vvip-68/LedPanelWiFi/wiki/schemes.md

## Схемы устройств для Wemos d1 mini и NodeMCU

### С сенсорной кнопкой
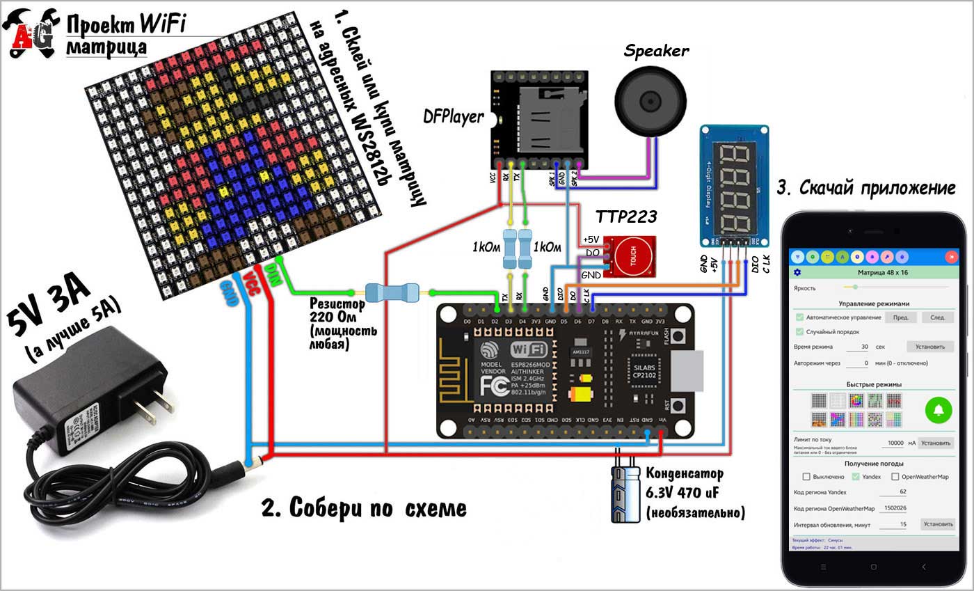
[picture p7: schemes/scheme.jpg]
SCHEME


### С обычной кнопкой
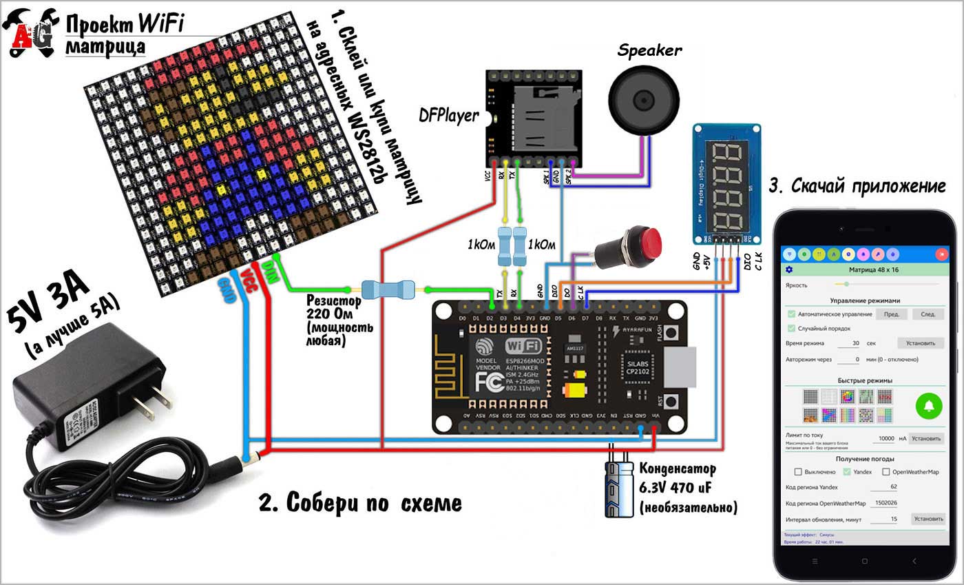
[picture p8: schemes/scheme_b.jpg]
SCHEME


### С SD картой
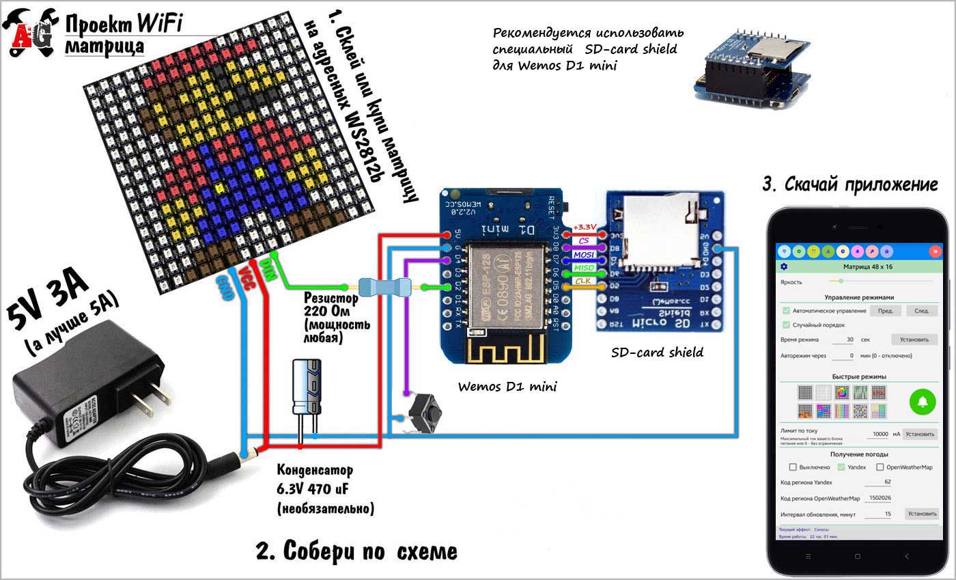
[picture p9: schemes/scheme_c.jpg]
SCHEME


### С корректировкой питания и отключением матрицы
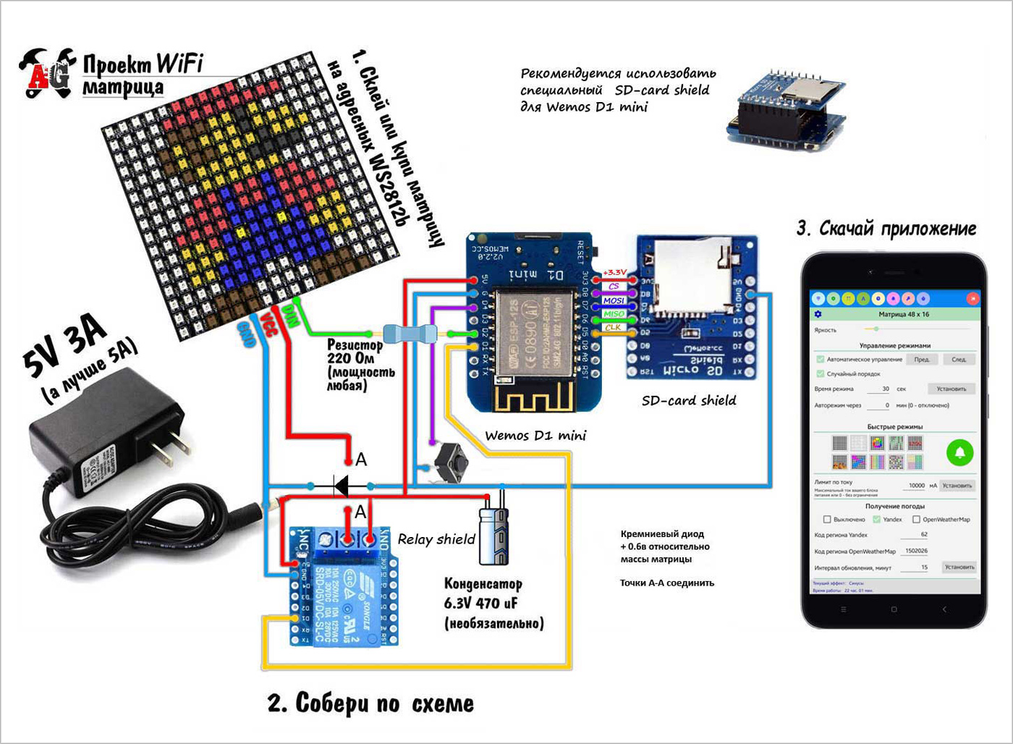
[picture p10: schemes/scheme_e.jpg]
SCHEME


### С корректировкой питания
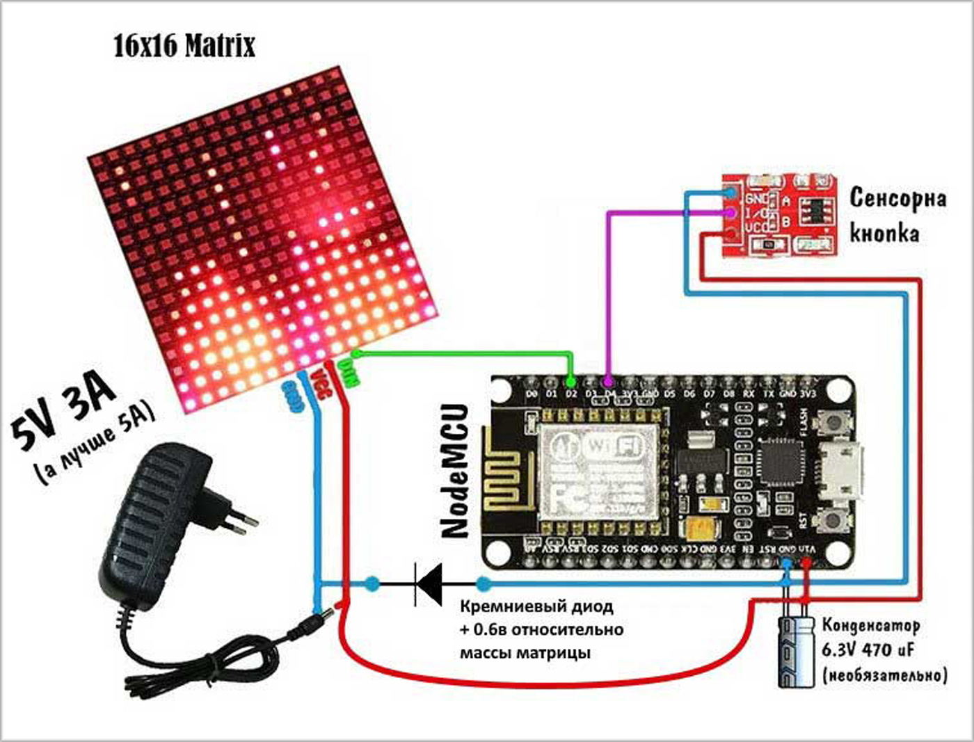
[picture p11: schemes/scheme_d.jpg]
SCHEME


### С полным набором компонент (отключение матрицы - MOSFET)
SCHEME

Для данного варианта схемы ползователь ***RailWar*** (Evgeny) разработал печатную плату.  
PCB Layout смотри в папке **"pcb"** проекта - архив **"lamp8266.zip"**.

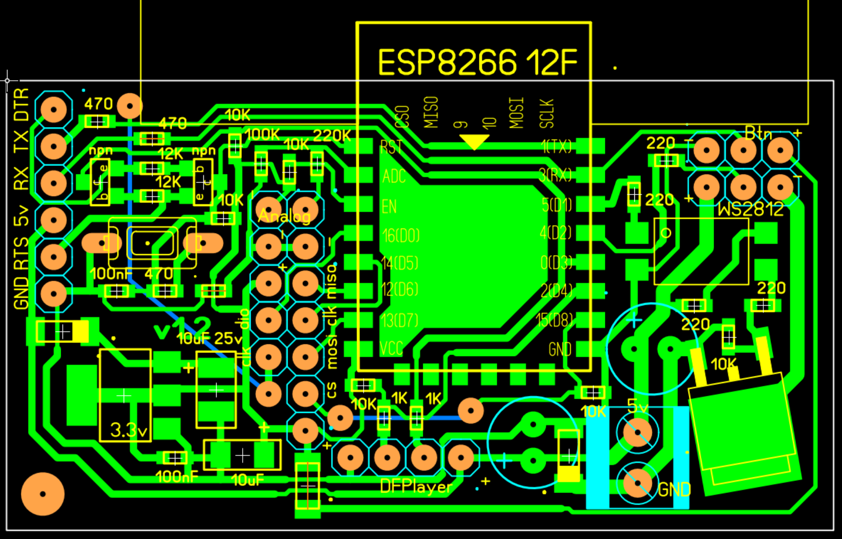
[picture p12: pcb/lamp8266.png]
PCB


### С полным набором компонент (отключение матрицы - реле)
SCHEME

<br><br>

## Схемы устройств для ESP32

### С полным набором компонент
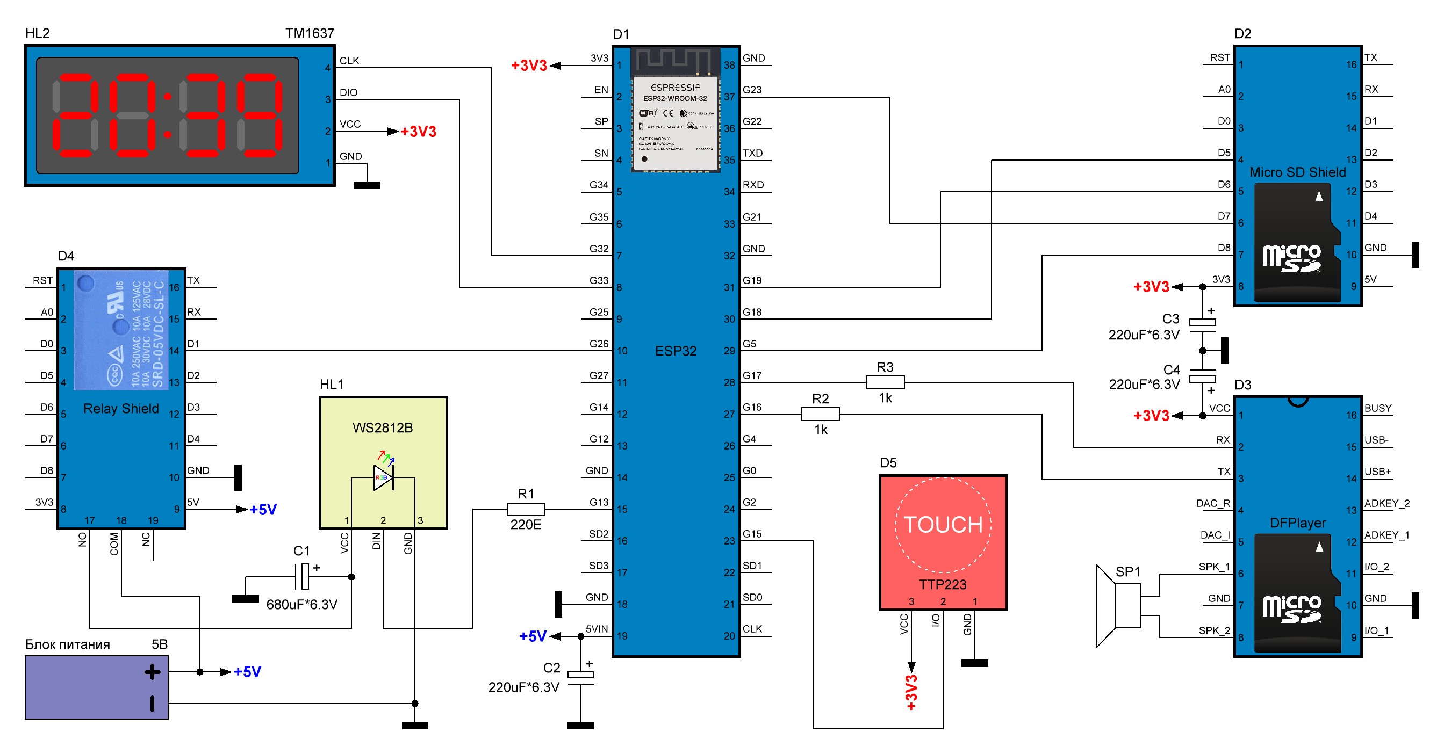
[picture p13: schemes/ESP32_ALL.JPG]
SCHEME


### С сенсорной кнопкой и отключением матрицы
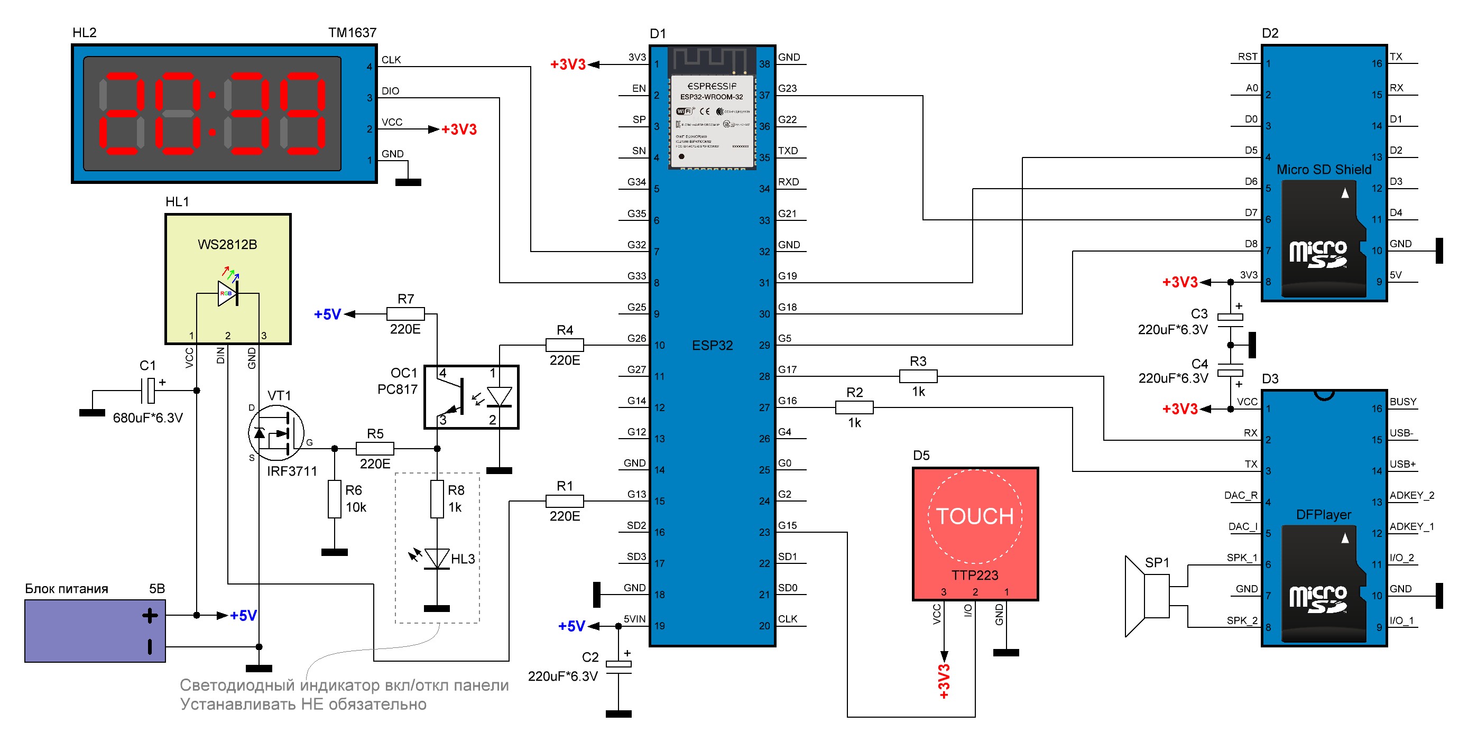
[picture p14: schemes/ESP32_MOSFET.JPG]
SCHEME


### С обычной кнопкой
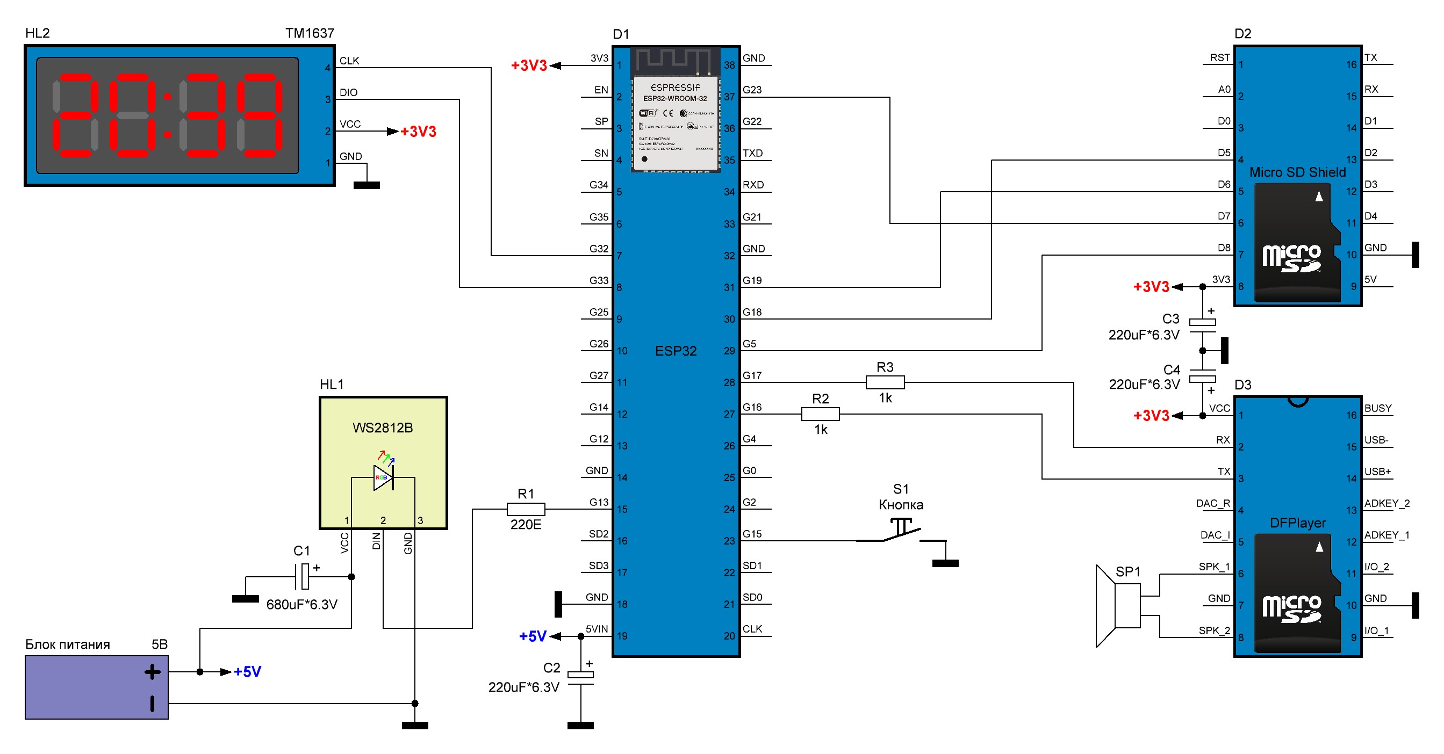
[picture p15: schemes/ESP32_button_noRELAY.jpg]
SCHEME


<br><br>

При повторении устройств следует учитывать особенности подачи питающего напряжения на собранную схему.
От соблюдения правильных параметров питания элементов зависит насколько надежно и бесперебойно будет работать собранное вами устройство.  

```
# Рекомендация по питанию

Наиболее стабильная работа устройства обеспечивается при питании схемы напряжением 4.6-4.9 вольт (не выше!).
При этом корректирующий диод в зазрыв GND питания микроконтроллера ставить не нужно.
Для схем, использующих DFPlayer, питание на него (VCC) в этом случае подавать с общего плюса питания, 
а не с пина 3.3 вольта микроконтроллера, поскольку пин 3.3 вольта не обеспечивает достаточного 
для потребления DFPlayer'ом тока, что приведет к недостаточной громкости воспроизведения, а в худшем 
случае - выходу из строя микросхемы стабилизатора напряжения 3.3 вольта микроконтроллера.

```
Заметки о том, как обеспечивается правильное питание устройства - в [этой](https://github.com/vvip-68/LedPanelWiFi/wiki/Заметки-о-питании) статье.

<br><br>

Благодарность [Дмитрию (7918514)](https://github.com/7918514) за предоставленные варианты схем и проверку их работоспособности.
Его вариант реализации (схемы, фотографии сборки и готового изделия, печатные платы) - все материалы доступны по [ссылке](https://disk.yandex.ru/d/fIo2UEuKpR54hg) в папке "Монстр".
