vvip-68/LedPanelWiFi/wiki/Arduino/wiki.md

# Пошаговая инструкция подготовки среды и сборка проекта

## Шаг 1

Перейдите на сайт разработчиков [Arduino](https://www.arduino.cc/en/Main/Software) и скачайте среду разработки.

Текущая версия среды разработки - Arduino IDE 2.3.3, может содержать некоторые ошибки, поскольку новая и развивается. Допустима к использованию.  
  
Но для Old-school пользователей все же рекомендуется старая проверенная IDE версии 1.8.19.  
Ниже описан как раз процесс установки и настройки для версии Arduino IDE 1.8.19.  

Установка и настройка Arduino IDE 2.3.3 имеет схожие шаги, так что инструкция с некоторыми нюансами сгодится и для нее.  
Для скачивания установщика Arduino IDE 2.3.3 для Windows - выберите **WINDOWS** Win 10 and newer, 64 bit.  
Если у вас другая ОС - выберите установщик для нее.

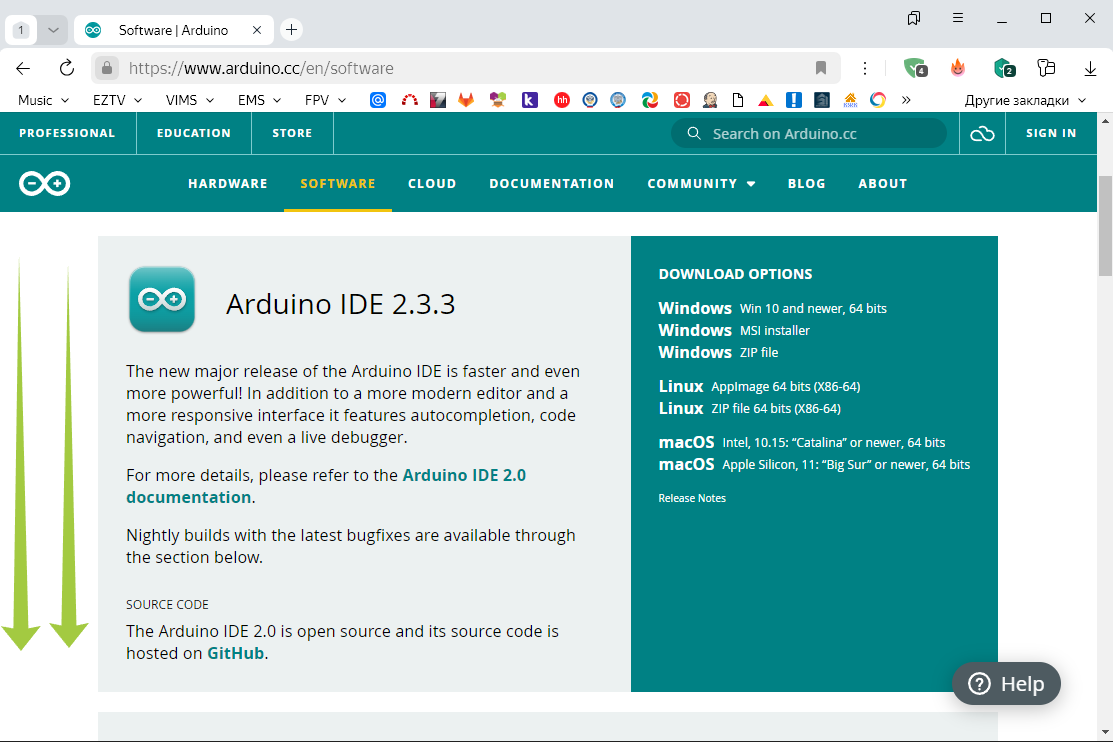
[picture p16: wiki/Arduino/Step_01.png]
Среда разработки Arduino IDE


Прокрутите страницу вниз, до появления плашки Legacy IDE (1.8.X) и выберите для загрузки версию **1.8.19**  
Нажмите на ссылку **Windows Win 7 and newer**. Вы же работаете под Windows?  
Если нет - загружайте версию IDE для вашей ОС.

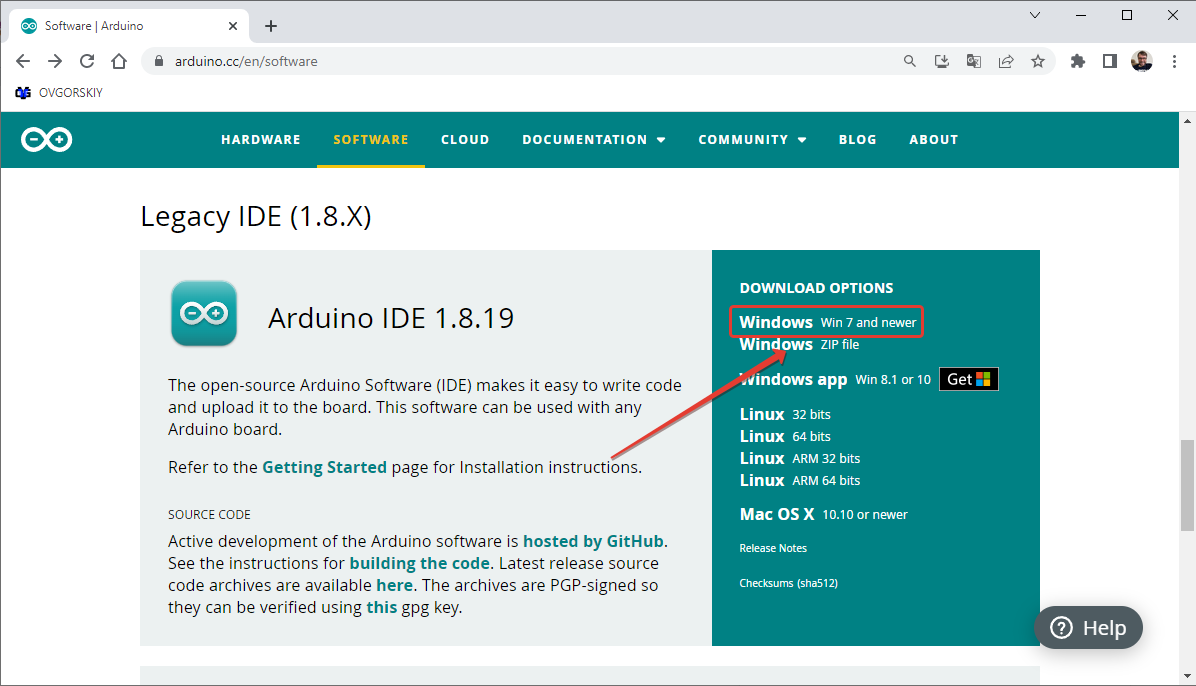
[picture p17: wiki/Arduino/Step_01_0.png]
Среда разработки Arduino IDE


Можете заплатить донат разработчикам Arduino IDE. Но если не хотите - просто нажмите кнопку **JUST DOWNLOAD**
для загрузки установочного файла. После завершения скачивания запустите его.

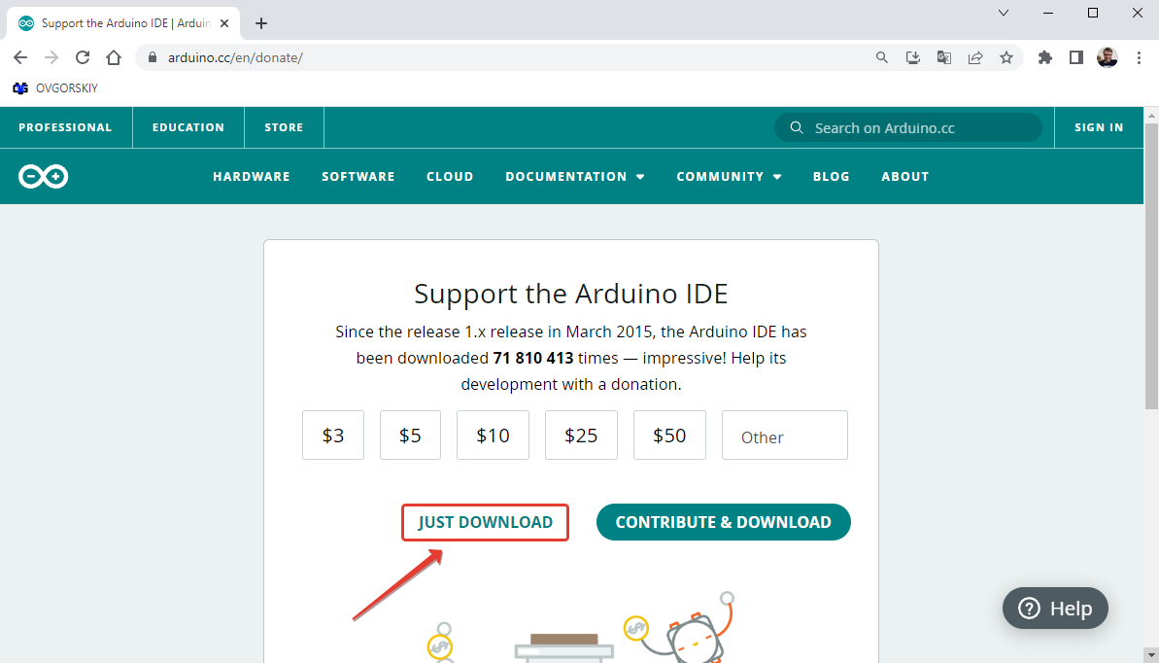
[picture p18: wiki/Arduino/Step_01_1.png]
Среда разработки Arduino IDE


Установите среду разработки на ваш компьютер. После завершения установки, запустите Arduino IDE.

## Шаг 2

В Arduino IDE в меню "Файл" выберите пункт "Настройки".

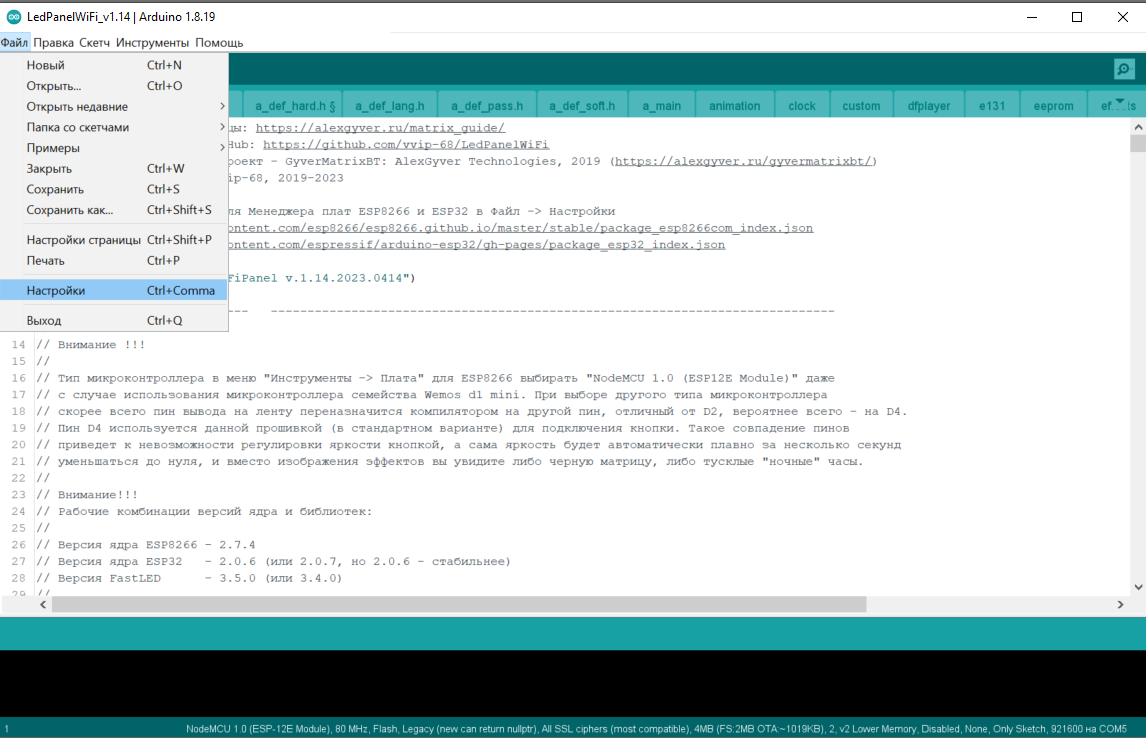
[picture p19: wiki/Arduino/Step_02_1.png]
Настройки среды разработки ArduinoIDE


В открывшемся окне нажмите на кнопку справа от поля "Дополнительные ссылки для менеджера плат"

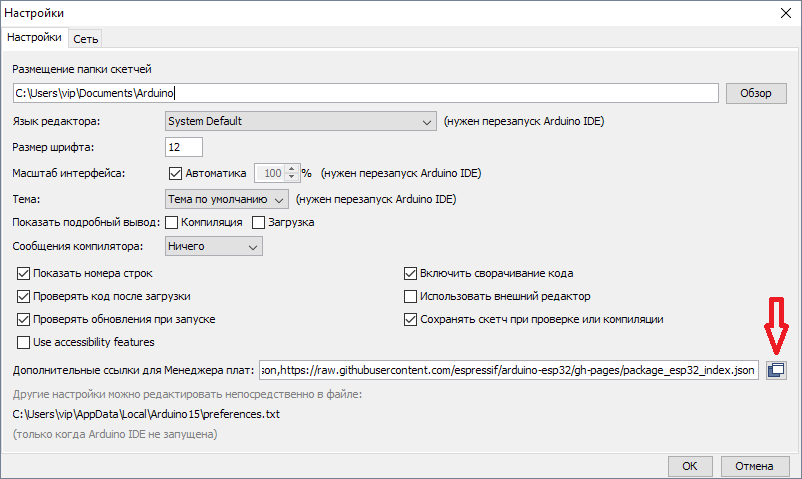
[picture p20: wiki/Arduino/Step_02_2.png]
Дополнительные ссылки для менеджера плат


В открывшемся окне добавьте в поле ввода следующие строки:
`https://raw.githubusercontent.com/esp8266/esp8266.github.io/master/stable/package_esp8266com_index.json` - для поддержки микроконтроллеров ESP8266 (NodeMCU, Wemos d1 mini)
`https://raw.githubusercontent.com/espressif/arduino-esp32/gh-pages/package_esp32_index.json` - для поддержки микроконтроллера ESP32.

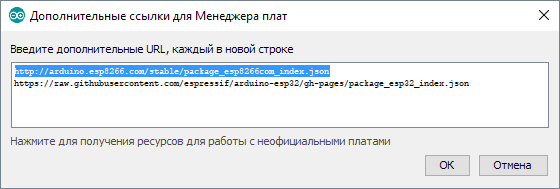
[picture p21: wiki/Arduino/Step_02_3.png]
Ссылка на плату ESP8266


Примените изменения

## Шаг 3

В Arduino IDE в меню "Инструменты" выберите пункт "Менеджер плат".

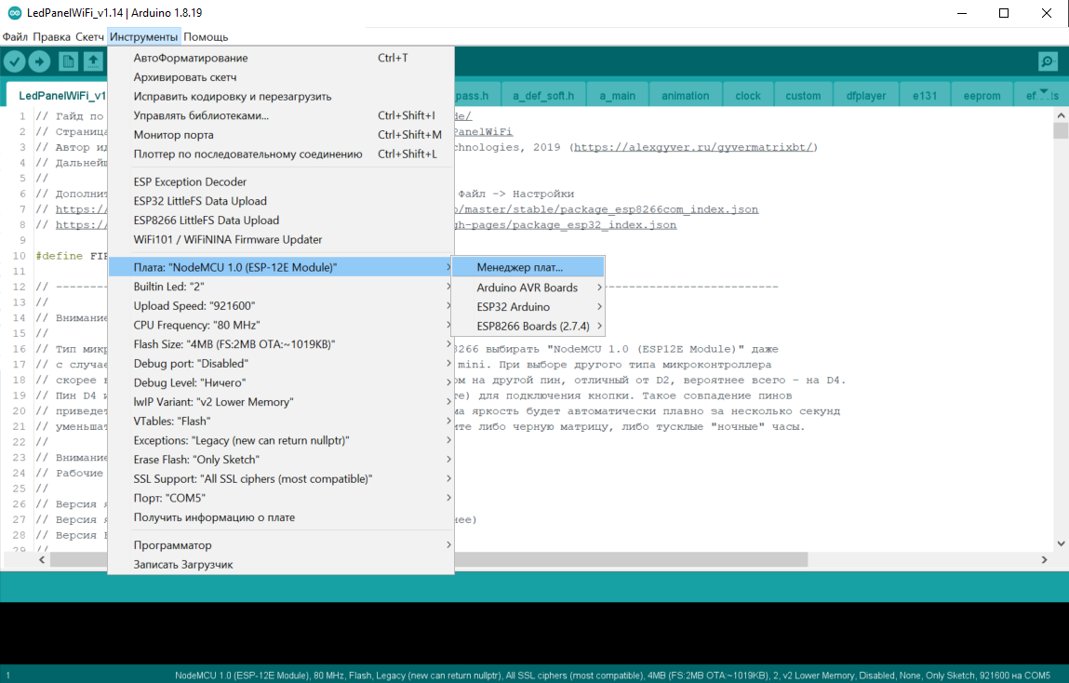
[picture p22: wiki/Arduino/Step_03_1.png]
Менеджер плат


В строке фильтра введите "ESP8266", найдите блок esp8266 by ESP8266 Commumity  
1. Выберите версию ядра **3.1.2** - ***это важно!!!***
2. Нажмите кнопку "Установка", дождитесь завершения установки.
3. Должна появиться надпись, подтверждающая что вы установили правильную версию ядра системы

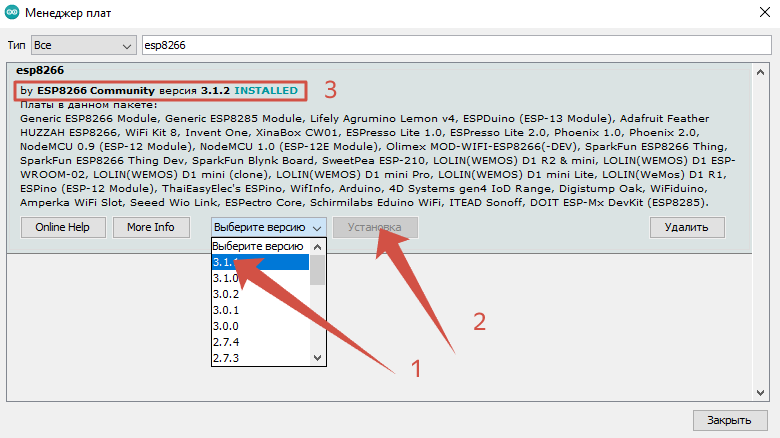
[picture p23: wiki/Arduino/Step_03_2.png]


В строке фильтра введите "ESP32", найдите блок ESP32 by Espressif System
1. Выберите версию ядра **2.0.14** - ***это важно!!!***
2. Нажмите кнопку "Установка", дождитесь завершения установки.
3. Должна появиться надпись, подтверждающая что вы установили правильную версию ядра системы

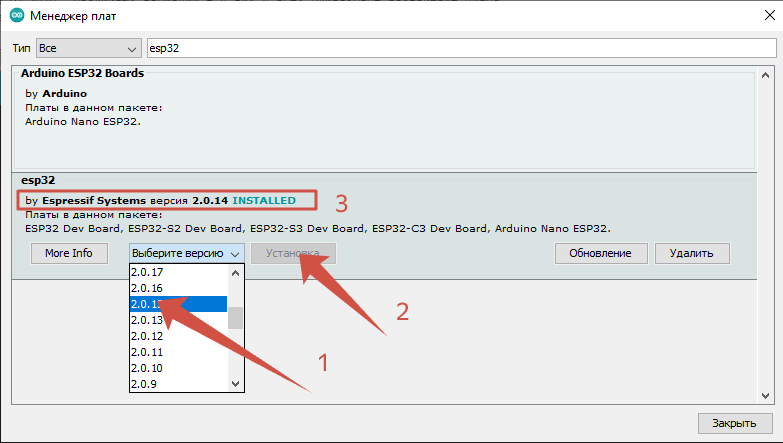
[picture p24: wiki/Arduino/Step_03_3.png]


Закройте Arduino IDE

## Шаг 4

Перейдите в [репозиторий](https://github.com/vvip-68/LedPanelWiFi) проекта
Нажмите зеленую кнопку "Code" выберите "Download ZIP"

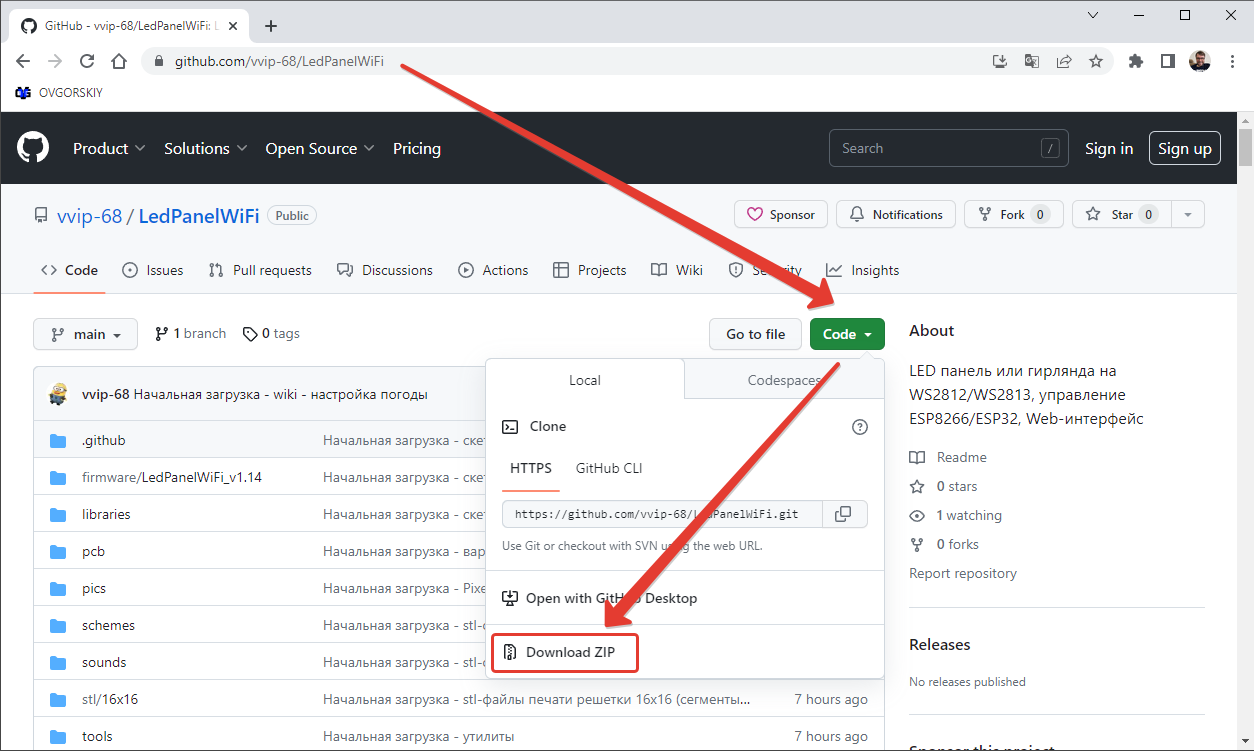
[picture p25: wiki/Arduino/Step_04_1.png]
Загрузка проекта из репозитория


Сохраните архив на диск, распакуйте его в отдельную папку.

Для тех, кто пользуется утилитами работы с хранилищем GitHub (например, [SmartGit](https://www.syntevo.com/smartgit/download/)) - зарегистрируйте в нем ссылку на репозиторий
https://github.com/vvip-68/LedPanelWiFi

## Шаг 5
Скопируйте содержимое папки "libraries" из папки проекта, в папку "libraries" установленной среды разработки Arduino
C:\Program Files (x86)\Arduino\libraries

Также допускается установка библиотек в папку "Мои документы"\Arduino\libraries.  
Обычно физический путь к этой папке - C:\\Users\<user>\Documents\Arduino\libraries

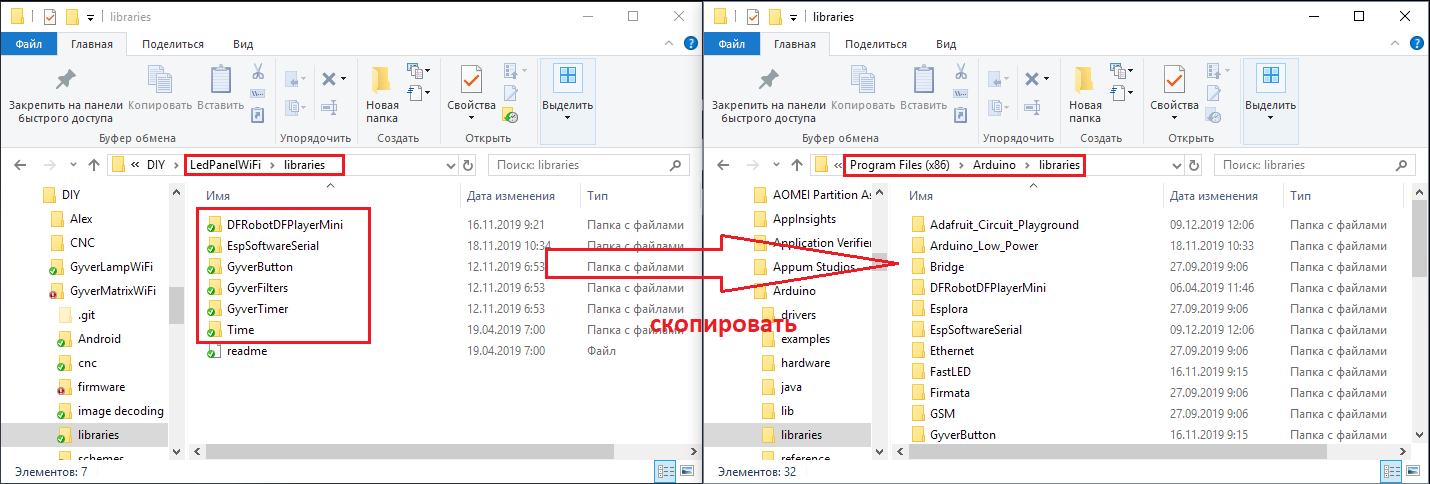
[picture p26: wiki/Arduino/Step_05_1.png]
Копирование библиотек


**Внимание!!!**  
Выполнение этого шага **ОЧЕНЬ** важно, поскольку часть библиотек исправлена и дополнена для соответствия требованиям проекта.
Библиотеки установленные из менеджера библиотек не будут иметь этих изменений или просто будут несовместимой версии,
что приведет к тому, что проект не будет компилироваться или соберется, но может работать неправильно.  

## Шаг 6

Запустите Arduino IDE
В меню "Инструменты" выберите пункт "Управлять библиотеками"

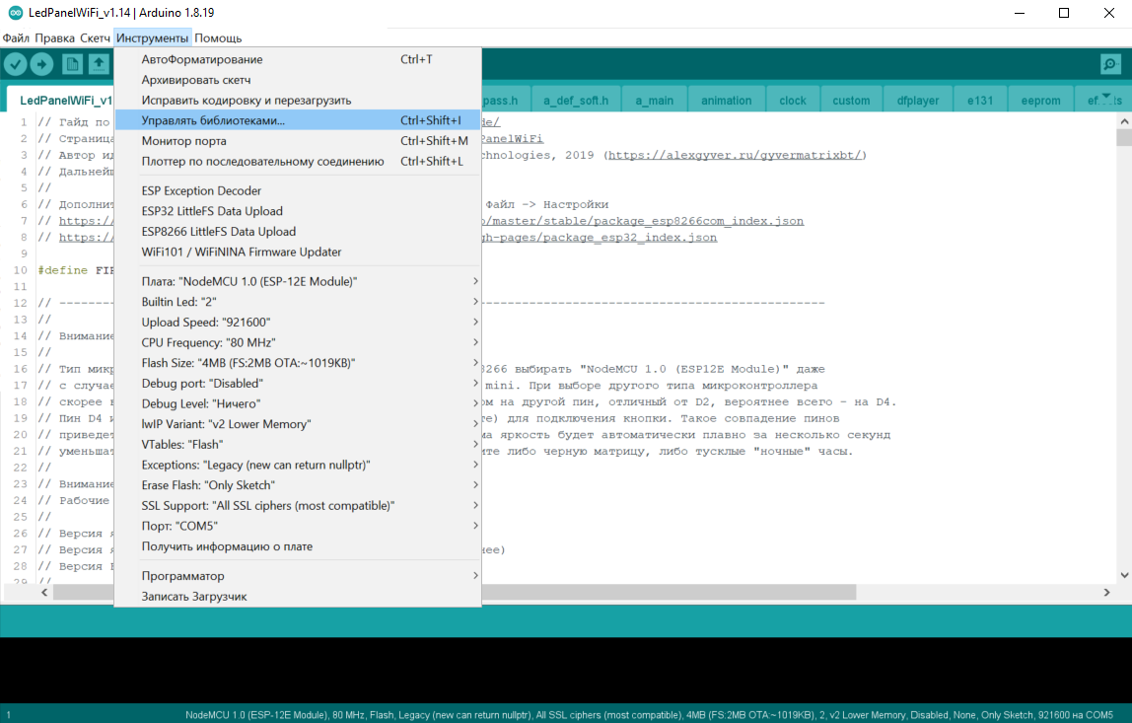
[picture p27: wiki/Arduino/Step_06_1.png]


A строке поиска наберите "FastLED"
Выберите блок "FastLED by Daniel Garcia"
1. Выберите версию библиотеки 3.6.0
2. Нажмите кнопку "Установка", дождитесь завершения установки.
3. Должна появиться надпись, подтверждающая что вы установили правильную (3.6.0!!!) версию библиотеки

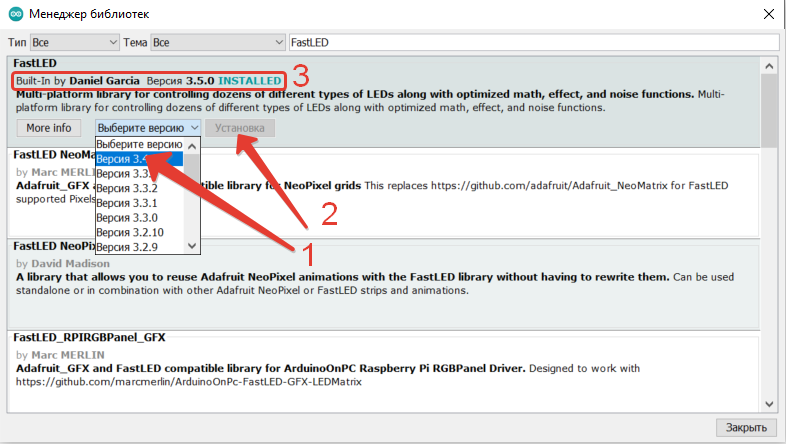
[picture p28: wiki/Arduino/Step_06_2.png]


Дождитесь завершения установки. Закройте Arduino IDE

## Шаг 7

В проводнике откройте папку с проектом, перейдите в папку "firmware" и далее в папку "LedPanelWiFi_v1.14"

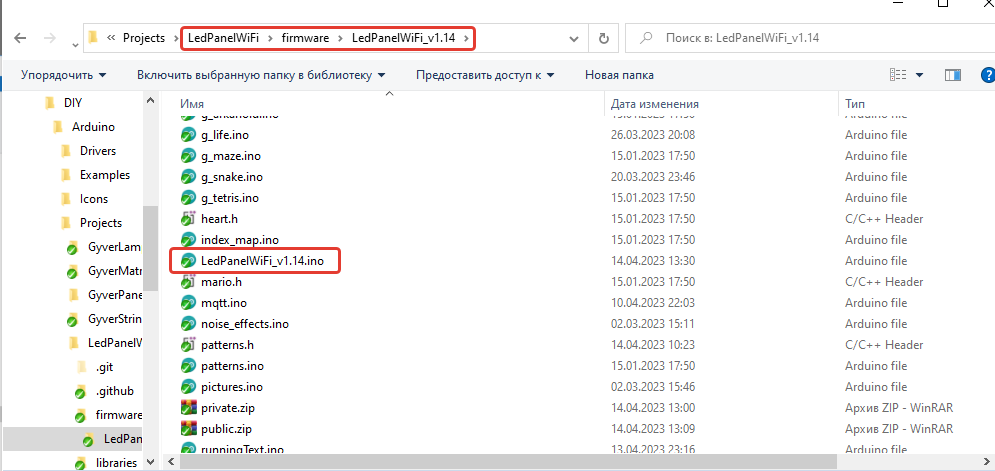
[picture p29: wiki/Arduino/Step_07_1.png]
Проводник - папка проекта


Дважды щелкните на файле "LedPanelWiFi_v1.14.ino"
Откроется Arduino IDE с загруженным проектом. Файлы проекта располагаются в разных вкладках. Их несколько.

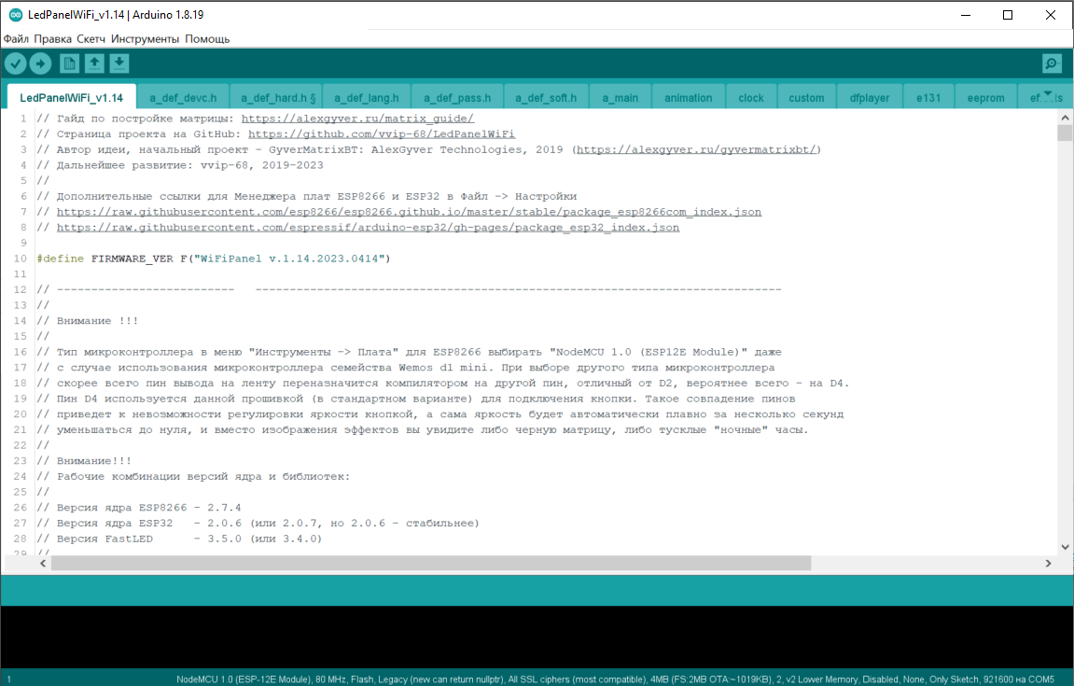
[picture p30: wiki/Arduino/Step_07_2.png]
Редактор кода


В меню "Инструменты" в пункте "Плата" в выпадающем списке выберите плату, соответствующую вашему микроконтроллеру.
В данном проекте используется плата микроконтроллера NodeMCU v1.0 или Wemos D1 pro mini.
В обоих случаях рекомендуется установить настройки как показано на рисунке.

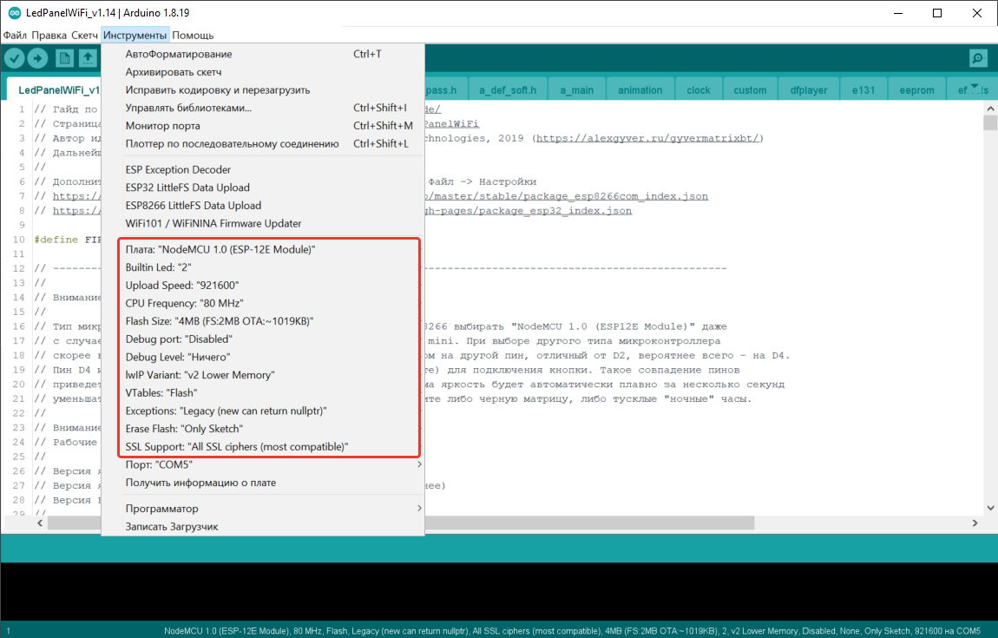
[picture p31: wiki/Arduino/Step_07_3.png]
Параметры сборки


Подключите плату микроконтроллера кабелем micro-USB к компьютеру.
Установите драйверы, соответствующие вашей плате (CH340G или CP2101) если они не установились автоматически при подключении контроллера.

Откройте менеджер устройств, найдите в группе "Диспетчер устройств" ветку дерева "Порты COM и LPT"

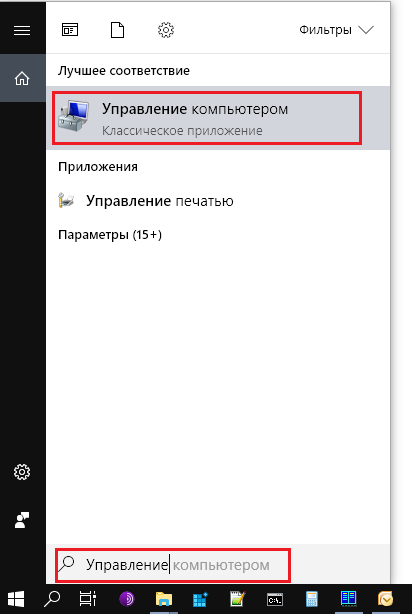
[picture p32: wiki/Arduino/Step_07_4.png]
Управление компьютером


Найдите COM-порт, соответствующей вашей подключенной плате.

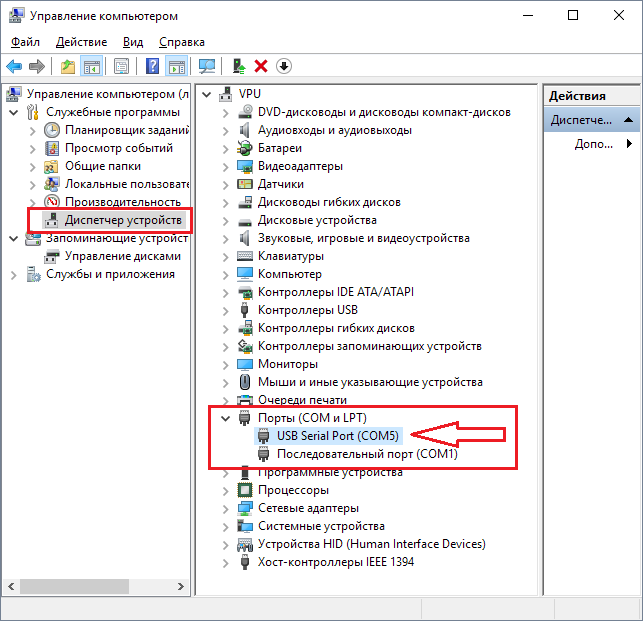
[picture p33: wiki/Arduino/Step_07_5.png]
Менеджер устройств


Укажите данный порт в настройках - в меню "Инструменты", пункт "Порт"

## Шаг 8

Измените в скетче [параметры](https://github.com/vvip-68/LedPanelWiFi/wiki/Настройка-скетча-для-вашего-устройства),
соответствующие вашему проекту - высоту, ширину матрицы, угол подключения, направление ленты и другие, которые требуется изменить для вашего проекта.
Проверьте, что проект компилируется без ошибок. Для этого нажмите на кнопку "Проверить" в панели инструментов Arduino IDE.

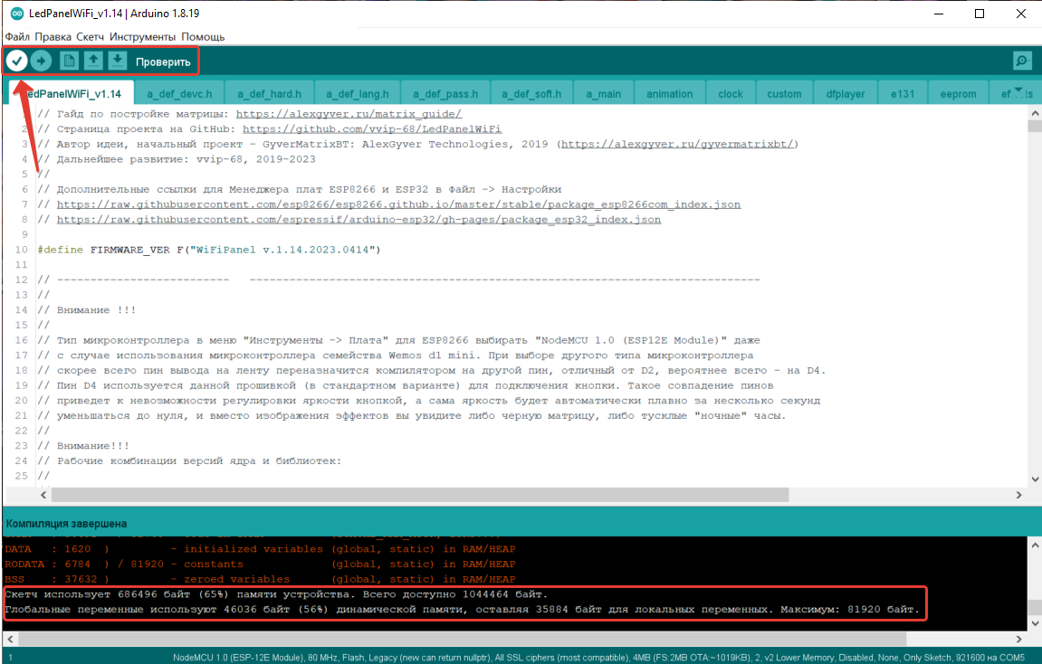
[picture p34: wiki/Arduino/Step_08_1.png]
Проверка скетча


Дождитесь окончания сборки проекта компилятором. Об успешном окончании сборки свидетельствует сообщение внизу окна редактора.
В зависимости от выбранной платы и версии IDE - это могут быть и белые буквы на черном фоне, и оранжевые. 

Если белые буквы появились, обращать внимание на расположенные выше них оранжевые не нужно. Это диагностические сообщения библиотек. 

Если белых букв не появилось, вместо этого напечаталось сообщение об ошибке - читайте его внимательно, включая весь текст выше и устраняйте причину ошибки.

## Шаг 9

Если сборка проекта завершилась без ошибок - можно скетч загружать в микроконтроллер.
Подключите контроллер к USB кабелем micro-USB, выберите порт к которому подключена плата микроконтроллера, откройте монитор порта, нажав на кнопку в правом верхнем углу окна Arduino IDE.

Если к плате микроконтроллера подключена матрица - перед присоединением кабеля USB к контроллеру, подключите дополнительное питание к компонентам вашего собранного проекта. Несоблюдение этого требования приведет к избыточному току через защитный диод, расположенный рядом с разъемом USB на плате, он испустит синий дымок и сгорит. После этого получить доступ к плате через USB по COM-порту у вас не получится. Тогда только или менять диод, или покупать новую плату целиком.  

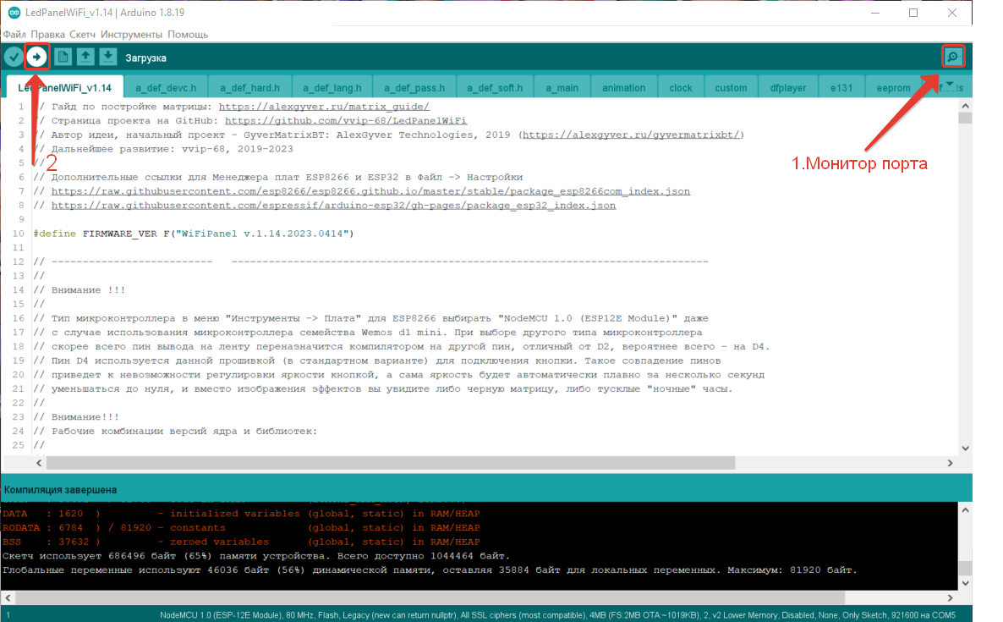
[picture p35: wiki/Arduino/Step_09_1.png]


Нажмите на кнопку "Загрузка" для загрузки скетча в микроконтроллер. Дождитесь завершения операции загрузки. 

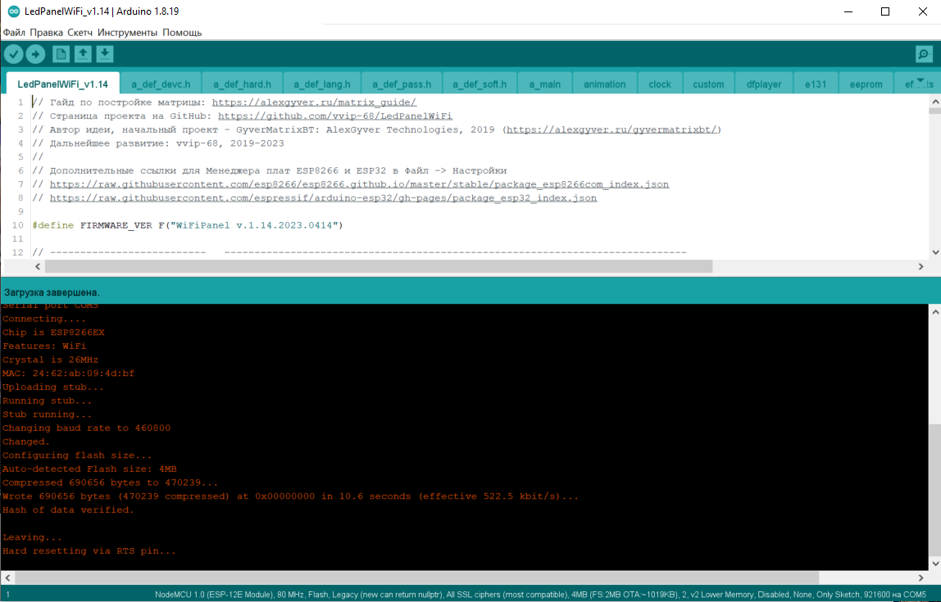
[picture p36: wiki/Arduino/Step_09_2.png]


В черном поле редактора будут отображаться служебные сообщения, а так же прогресс загрузки в процентах.
После завершения операции появится надпись "Leaving... Hard resetting via RTS pin..."

Микроконтроллер автоматически перезагрузится и начнет выполнение скетча.
В мониторе порта отобразится журнал работы приложения, подтверждающий успешное завершение операции и выполнение скетча

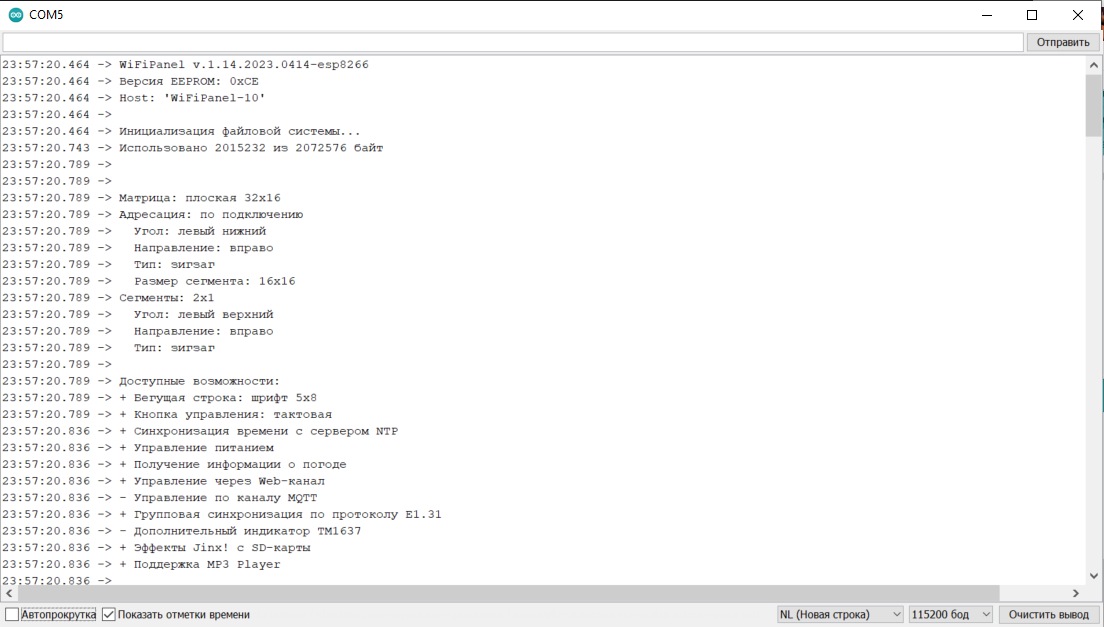
[picture p37: wiki/Arduino/Step_09_3.png]


## Шаг 10

Папка **data** проекта содержит образ файловой системы, которая требуется для корректной работы прошивки. В частности - в папке **data/web** находятся файлы Web-интерфейса, которые нужно загрузить в микроконтроллер, чтобы иметь возможность управлять устройством через Web-интерфейс.
Подробная инструкция как загрузить данные в файловую систему микроконтроллера находится [здесь](https://github.com/vvip-68/LedPanelWiFi/wiki/Загрузка-данных-в-файловую-систему-МК).  

После того, как файловая система будет загружена в микроконтроллер, для завершения процесса сборки устройства подключитесь к созданной устройством точке доступа PanelAP и откройте в браузере страничку настроек по адресу 192.168.4.1 и [выполните настройку](https://github.com/vvip-68/LedPanelWiFi/wiki/Настройка-параметров-в-приложении)
