vvip-68/LedPanelWiFi/wiki/Home/home.md

[**ЧаВо / FAQ**](https://github.com/vvip-68/LedPanelWiFi/wiki/FAQ)  

[Варианты устройств. Схемы.](https://github.com/vvip-68/LedPanelWiFi/wiki/Варианты-устройств.-Схемы.)     
[Типы матриц, способы подключения](https://github.com/vvip-68/LedPanelWiFi/wiki/Сборная-матрица#тип-матрицы)   
[Сборная матрица](https://github.com/vvip-68/LedPanelWiFi/wiki/Сборная-матрица)   
[Сборная матрица, состоящая из матриц разного типа и размера](https://github.com/vvip-68/LedPanelWiFi/wiki/Сборная-матрица,-состоящая-из-матриц-разного-типа-и-размера)   
[Всё собрал, ничего не работает.](https://github.com/vvip-68/LedPanelWiFi/wiki/Всё-собрал,-ничего-не-работает.)  
[Три шага к успеху. Некоторые особенности настроек...](https://github.com/vvip-68/LedPanelWiFi/wiki/Три-шага-к-успеху.-Некоторые-особенности-настроек...)  

[Пошаговая инструкция подготовки среды и сборка проекта](https://github.com/vvip-68/LedPanelWiFi/wiki/Пошаговая-инструкция-подготовки-среды-и-сборка-проекта)  
[Настройка скетча для вашего устройства](https://github.com/vvip-68/LedPanelWiFi/wiki/Настройка-скетча-для-вашего-устройства)  
[Настройка параметров в приложении](https://github.com/vvip-68/LedPanelWiFi/wiki/Настройка-параметров-в-приложении)  
[Настройка языка интерфейса](https://github.com/vvip-68/LedPanelWiFi/wiki/Язык-интерфейса)  
[Настройка получения информации о погоде](https://github.com/vvip-68/LedPanelWiFi/wiki/Настройка-получения-информации-о-погоде)  
[Настройка бегущей строки](https://github.com/vvip-68/LedPanelWiFi/wiki/Настройка-бегущей-строки)  
[Подготовка звуковых файлов](https://github.com/vvip-68/LedPanelWiFi/wiki/Звуки-будильника)  

[Управление приложением](https://github.com/vvip-68/LedPanelWiFi/wiki/Управление-приложением)  
[Игры](https://github.com/vvip-68/LedPanelWiFi/wiki/Игры)  
[Рисование](https://github.com/vvip-68/LedPanelWiFi/wiki/Рисование)  

[JinxFramer - редактор анимации, роликов, картинок пользователя](https://github.com/vvip-68/LedPanelWiFi/wiki/JinxFramer---редактор-анимации,-роликов,-картинок)  
[Загрузка данных в файловую систему МК](https://github.com/vvip-68/LedPanelWiFi/wiki/Загрузка-данных-в-файловую-систему-МК)  
[Экспорт эффектов анимации из ПО «Jinx!»](https://github.com/vvip-68/LedPanelWiFi/wiki/Экспорт-эффектов-анимации-из-ПО-«Jinx!»)  
[Захват видео программой «Jinx!»](https://github.com/vvip-68/LedPanelWiFi/wiki/Захват-видео-программой-«Jinx!»)  
[Как добавить свою анимацию](https://github.com/vvip-68/LedPanelWiFi/wiki/Добавление-своей-анимации--к-эффекту-«Анимация»)  
[Большие буквы в бегущей строке](https://github.com/vvip-68/LedPanelWiFi/wiki/Большие-буквы-в-бегущей-строке)  
[Добавление своих букв](https://github.com/vvip-68/LedPanelWiFi/wiki/Добавление-своих-символов-в-шрифт)  

[API управления устройством](https://github.com/vvip-68/LedPanelWiFi/wiki/API-управления-устройством)  
[OTA - обновление по воздуху](https://github.com/vvip-68/LedPanelWiFi/wiki/OTA---обновление-по-воздуху)

#### [Синхронизация устройств](https://github.com/vvip-68/LedPanelWiFi/wiki/Синхронизация-устройств)  
- [Общие понятия](https://github.com/vvip-68/LedPanelWiFi/wiki/Синхронизация-устройств#Общие-понятия)  
- [Настройка синхронизации](https://github.com/vvip-68/LedPanelWiFi/wiki/Синхронизация-устройств#Настройка-синхронизации)  
- [Технические аспекты](https://github.com/vvip-68/LedPanelWiFi/wiki/Синхронизация-устройств#Технические-аспекты)  
- [Внешние эффекты Jinx!](https://github.com/vvip-68/LedPanelWiFi/wiki/Настройка-ПО-управления-эффектами-Jinx!-как-источника-синхронизации-устройств-в-группе).  
- [Распределенная матрица](https://github.com/vvip-68/LedPanelWiFi/wiki/Распределенная-матрица)   

[Продвинутый уровень. Использование портов МК](https://github.com/vvip-68/LedPanelWiFi/wiki/Продвинутый-уровень.-Использование-портов-микроконтроллера.)
