vvip-68/LedPanelWiFi/tools/Patterns/readme.txt

Excel-утилита для создания массивов-паттернов для эффекта "Узоры"
Созданные с использованием утилиты узоры размещаются в файле скетча patterns.h
