vvip-68/LedPanelWiFi/sounds/03/readme.txt

Звуки нотификации (привлечения внимания) для макроса {A} в бегущей строке
