vvip-68/LedPanelWiFi/wiki/Jinx/video.md

# Захват видео программой «Jinx!»

### По материалам пользователей **247760** и **7918514** в [issue #166](https://github.com/vvip-68/GyverPanelWiFi/issues/166#issuecomment-986279874), a так же **saippuakauppias** и **HuskySmile** [discussion #50](https://github.com/vvip-68/LedPanelWiFi/discussions/50#discussioncomment-7939697)

## [247760](https://github.com/vvip-68/GyverPanelWiFi/issues/166#issuecomment-986279874):

В двух словах, начало такое, а дальше как и с другими вариантами в JINX:  
Предварительная базовая настройка под Вашу гирлянду. И погнали.
1. Выбрать режим **Capture Screen**
2. Сразу ниже: **Edit** 
3. Появится окошко в котором нужно нажать : **Select screen region**
4. Появится новое окошко: **Capture Screen** с кнопкой **Close**
5. Это окошко тянется за углы, это и есть площадь видеозахвата, т.е. как только вы растянете его на размер окна ролика с Ютуба или видеоплеера, жмёте **Close**, окошко пропадёт. 

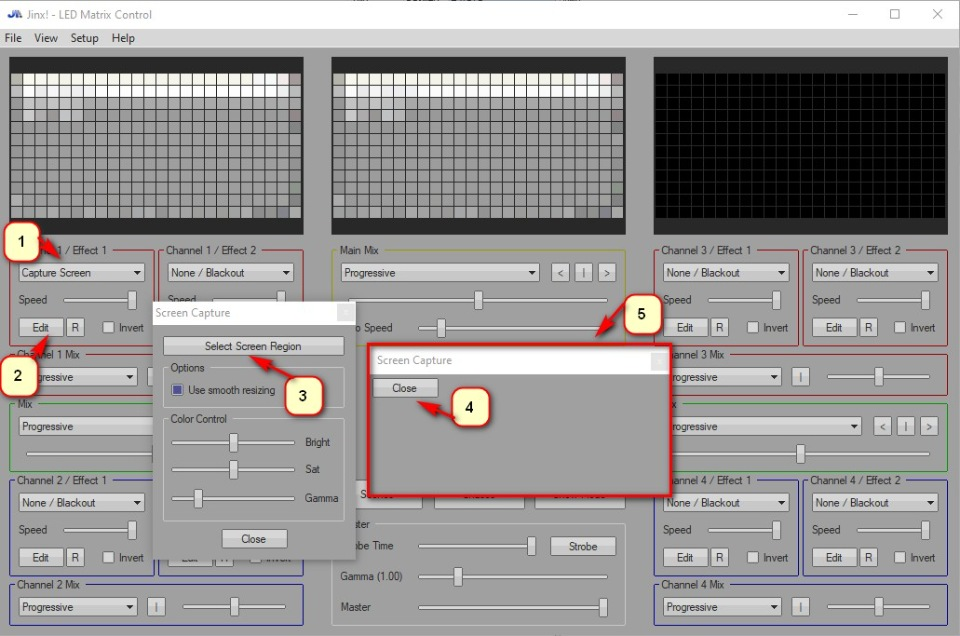
[picture p129: wiki/Jinx/video-01.png]


6. Вы увидите в программе (окно с размерами Вашей гирлянды) то что она захватывает.  
Саму JINX утяните вниз экрана, чтобы она не попадала в видеозахват.

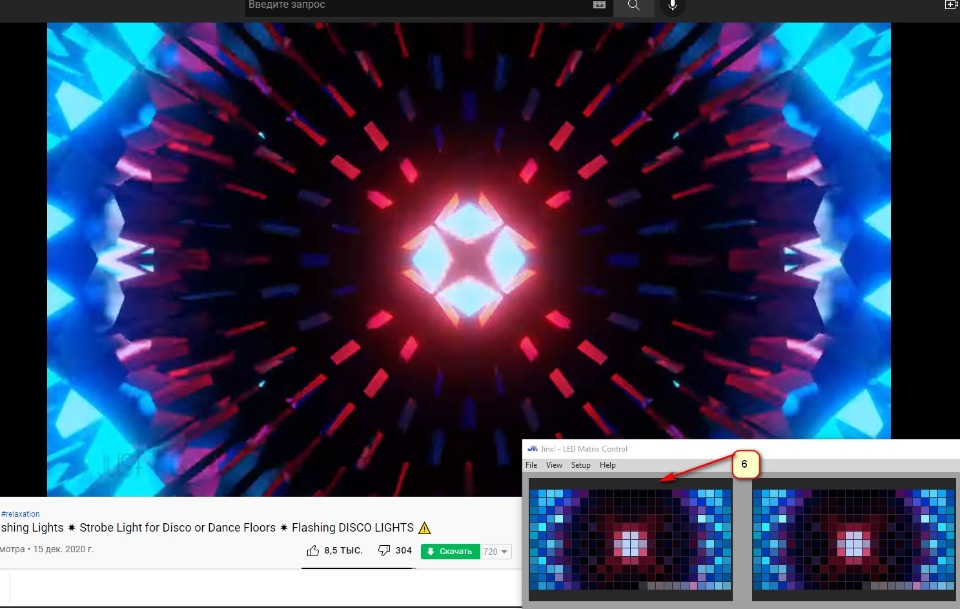
[picture p130: wiki/Jinx/video-02.png]


Вот ещё видео, с отображением видеозахвата на панели в режиме реального времени

Watch the video (https://youtu.be/wy_lokJMGOI)

## [7918514](https://github.com/vvip-68/GyverPanelWiFi/issues/166#issuecomment-986269325):

Я Джинксом граблю видео с ютюба. Нахожу какую-нибудь анимацию компьютерную и в Джинксе включаю захват экрана.  
Некоторые получаются  даже ничего...  

https://youtu.be/zngPoLK_IGE  
https://youtu.be/iatlzfjluHQ  
https://youtu.be/pwcmANSvtu4  
https://youtu.be/dX6sz2QCxWc  
https://youtu.be/bx-0YlFprqc  
https://youtu.be/lbgPHWONVQg  
https://youtu.be/msnYBMdaB08  
https://youtu.be/Opymy0DXPcI  
https://youtu.be/MW2OVIdGT0o  

ну и так далее, справа в подборке ещё много вылазит.

Точно таким же способом можно выполнять захват кадров из мультиков или захват различных анимированных GIF-картинок, коих находится великое множество поисковиками Яндекс или Google

## [saippuakauppias](https://github.com/vvip-68/LedPanelWiFi/discussions/50#discussion-5996177):

Я нашел кучку гифок + наконвертил из видео с ютуба (скачивал через какой-то сайт, конвертил mp4 через https://ezgif.com/video-to-gif , там же кропал и менял FPS/длинну гифки ).

Хочется ещё каких-нибудь эффектов, но уже устал искать (особенно хочется "мемов"). Авось кто-то ещё поделится :) 

Мой пак гифок будет лежать здесь: https://disk.yandex.ru/d/1DYvkYP_kj3RTQ

## [HuskySmile](https://github.com/vvip-68/LedPanelWiFi/discussions/50#discussioncomment-7939697):

Я все эффекты с ютуба писал, делюсь своим плейлистом может кому что и понравится
https://www.youtube.com/playlist?list=PLCMt0wzDgj_io5gko_5_plL1CKM0zFl6m
