vvip-68/LedPanelWiFi/wiki/Games/games.md

# Игры

В настоящее время прошивка поддерживает четыре интерактивные игры - ***Лабиринт***, ***Тетрис***, ***Змейка*** и ***Арканоид***. 

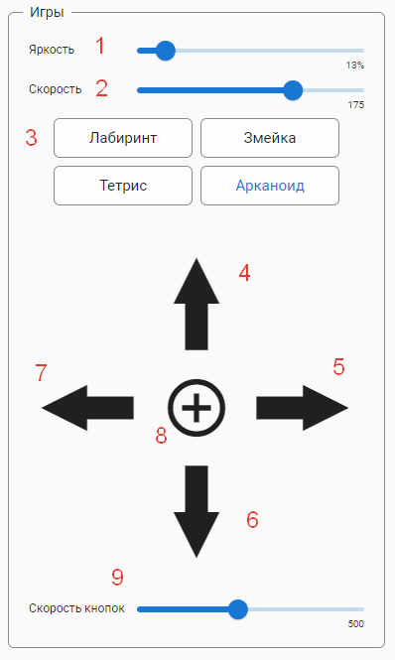
[picture p162: wiki/Games/p01.png]
Matrix
   

## Как играть

Для начала игры выберите одну из игр, нажав на соответствующую "плашку" ***(3)*** c названием игры на страничке управления играми.
Игровое поле отобразится на матрице. Игра находится в состоянии паузы, ожидая готовности игрока начать игру.

Отрегулируйте яркость игрового поля, если это необходимо ползунком **"Яркость"** ***(1)***.  
Установите желаемую скорость игры ползунком **Скорость"** ***(2)***. Изменить скорость можно в любой момент непосредственно в ходе игры.  

Большие кнопки управления игрой - (*игровой джойстик*) позволяют изменять направление движения объекта игры.  
- **Стрелка вверх** ***(4)*** - инициирует движение вверх  
- **Стрелка вправо** ***(5)*** - инициирует движение вправо  
- **Стрелка вниз** ***(6)*** - инициирует движение вниз  
- **Стрелка влево** ***(7)*** - инициирует движение влево  
- **Центральная кнопка** ***(8)*** - начало игры или подтверждение операции, если требуется.  

Если Web-интерфейс открыт в браузере на компьютере, экранные стрелки управления игрой дублируются клавишами стрелок на клавиатуре.  

Центральная кнопка ***(8)*** дублируется клавишей ***Enter***.  

В браузере на телефоне просто нажимайте на стрелки пальцем.  

Продолжительное нажатие на стрелку запускает периодический повтор ее нажатия, что может быть полезным в некоторых играх, например - в ***"Лабиринте"***.  

Скорость повтора регулируется ползунком **"Скорость кнопок"** ***(9)***.

Приятного времяпрепровождения и хороших результатов в играх!
