vvip-68/LedPanelWiFi/esp32-S2-mini.png

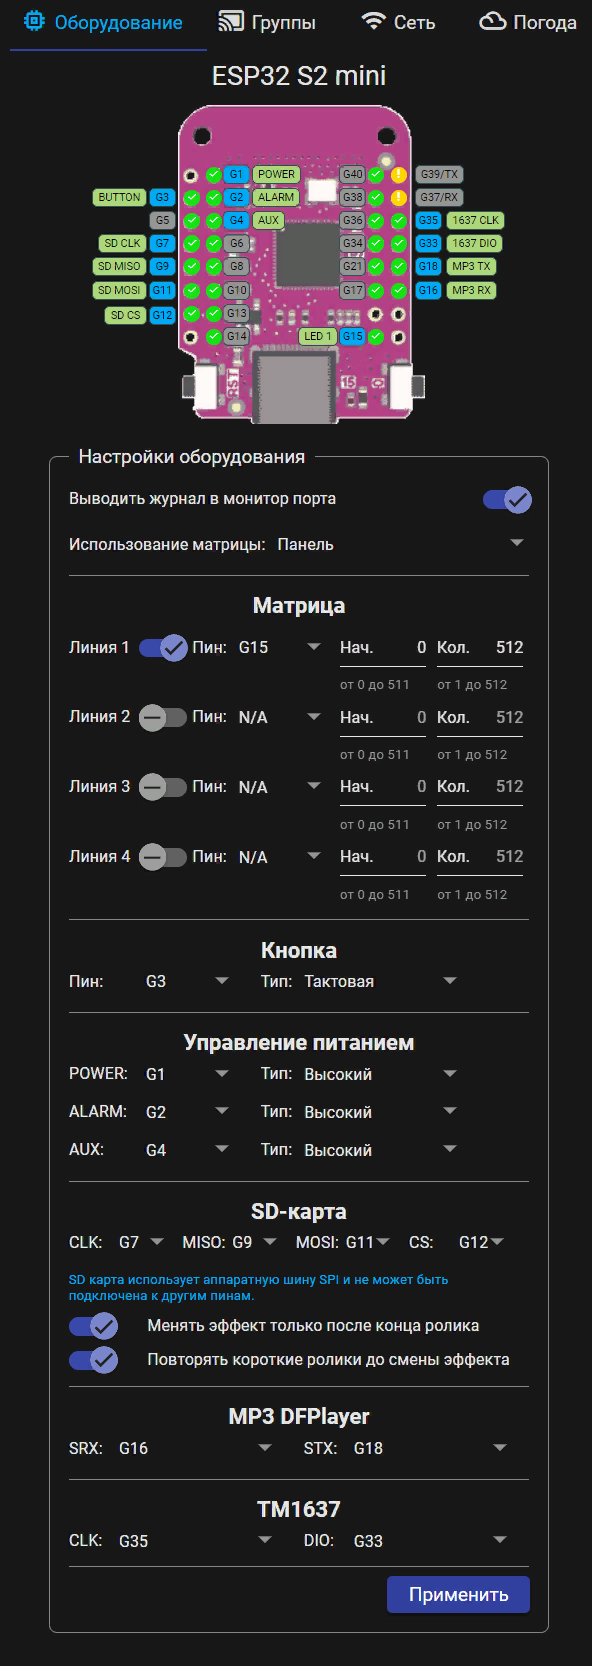
esp32-S2-mini.png
