vvip-68/LedPanelWiFi/esp32-S3.png

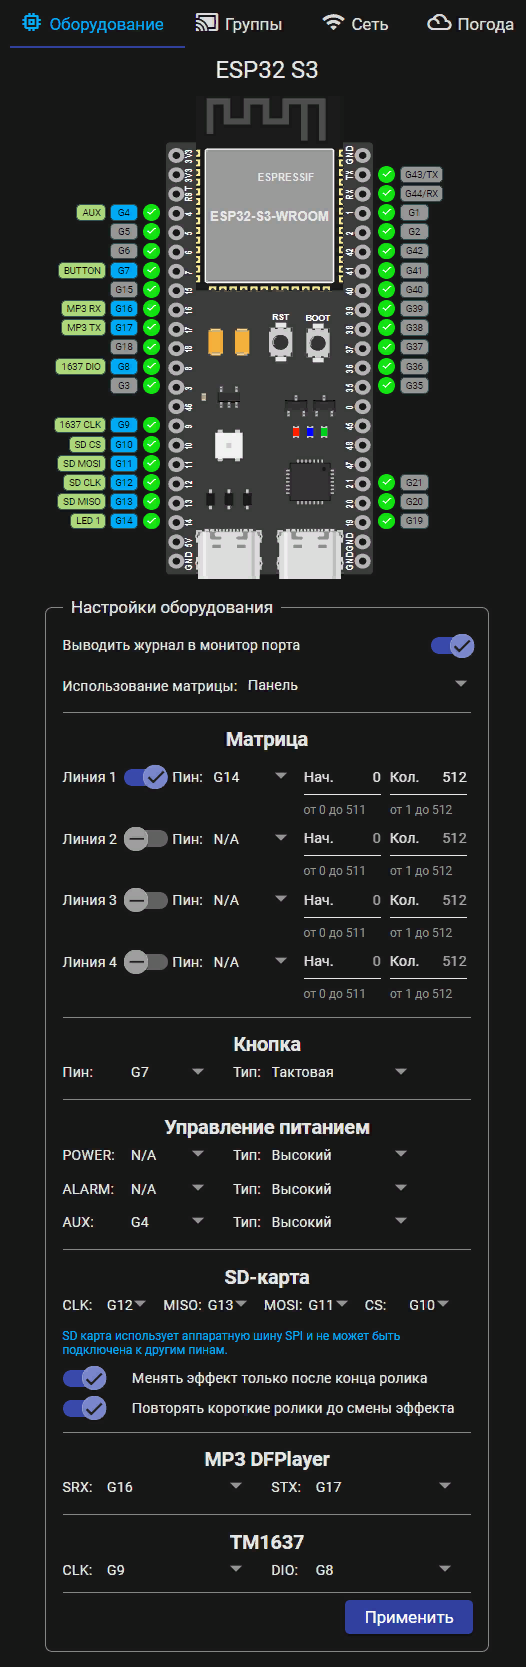
esp32-S3.png
