vvip-68/LedPanelWiFi/esp32-wroom-32-full-sens-btn.png

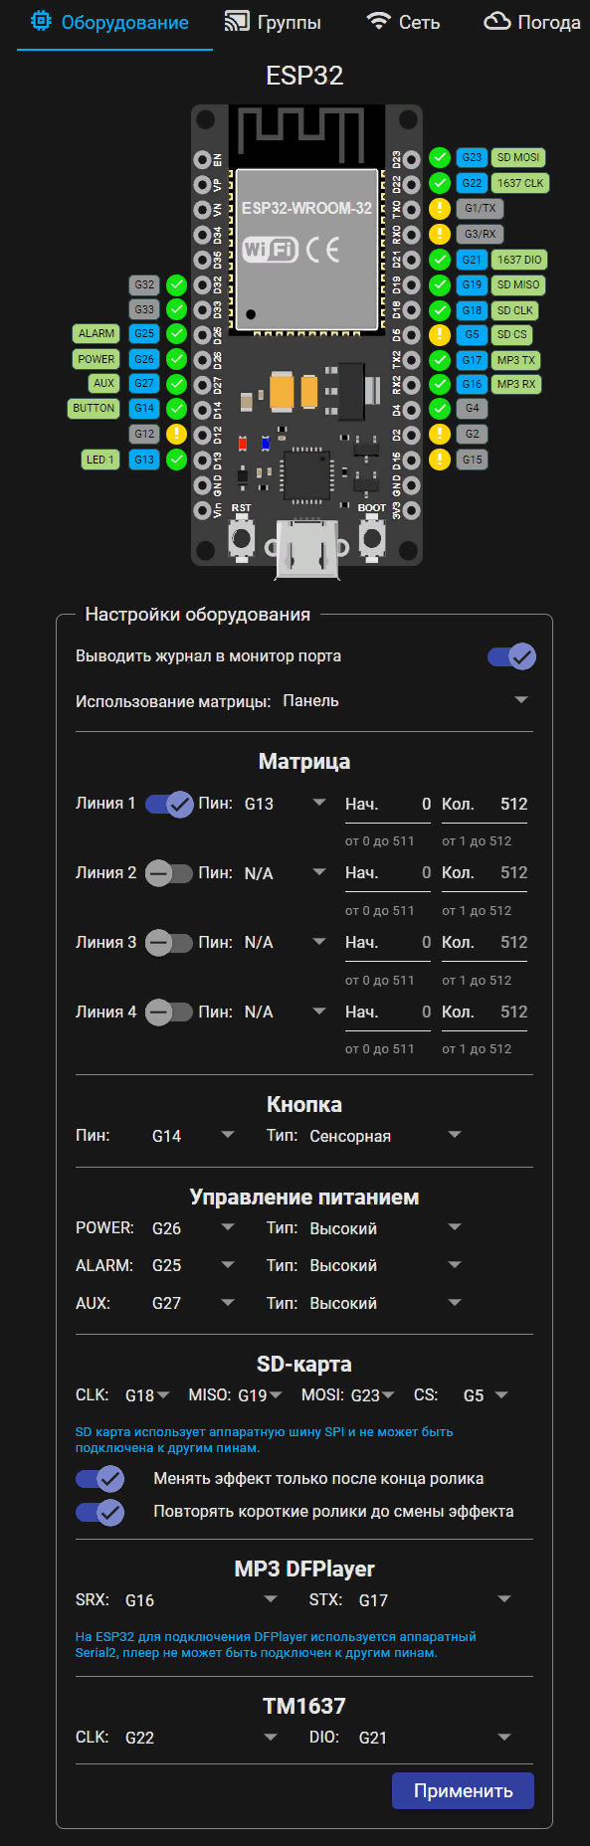
esp32-wroom-32-full-sens-btn.png
