vvip-68/LedPanelWiFi/firmware/LedPanelWiFi_v1.14/data/web/a/i/32s3m.png

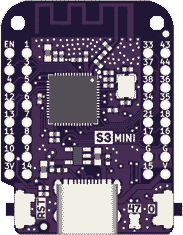
firmware/LedPanelWiFi_v1.14/data/web/a/i/32s3m.png
