vvip-68/LedPanelWiFi/schemes/power-supply.png

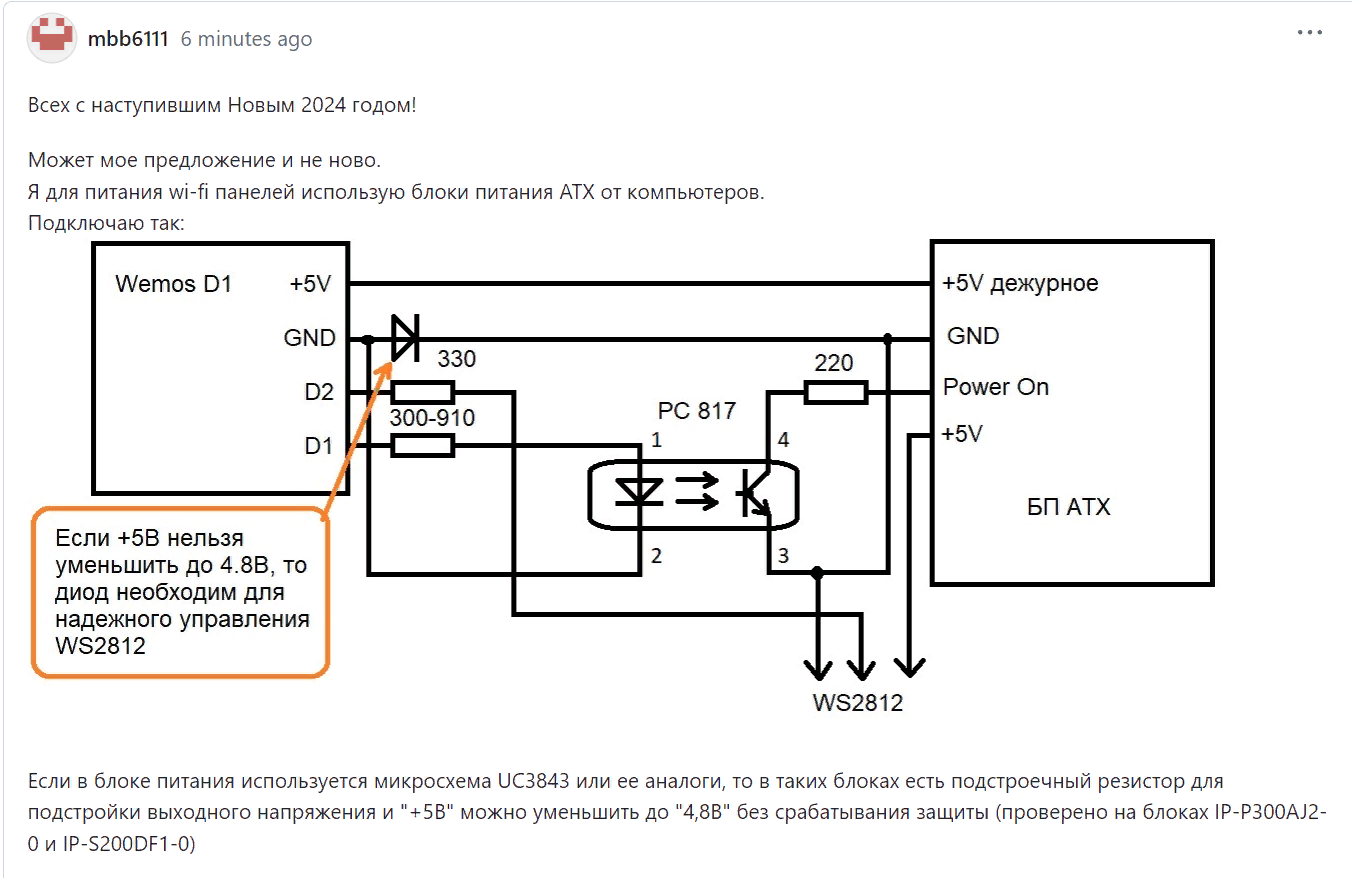
schemes/power-supply.png
