vvip-68/LedPanelWiFi/setitngs-esp32-S3.png

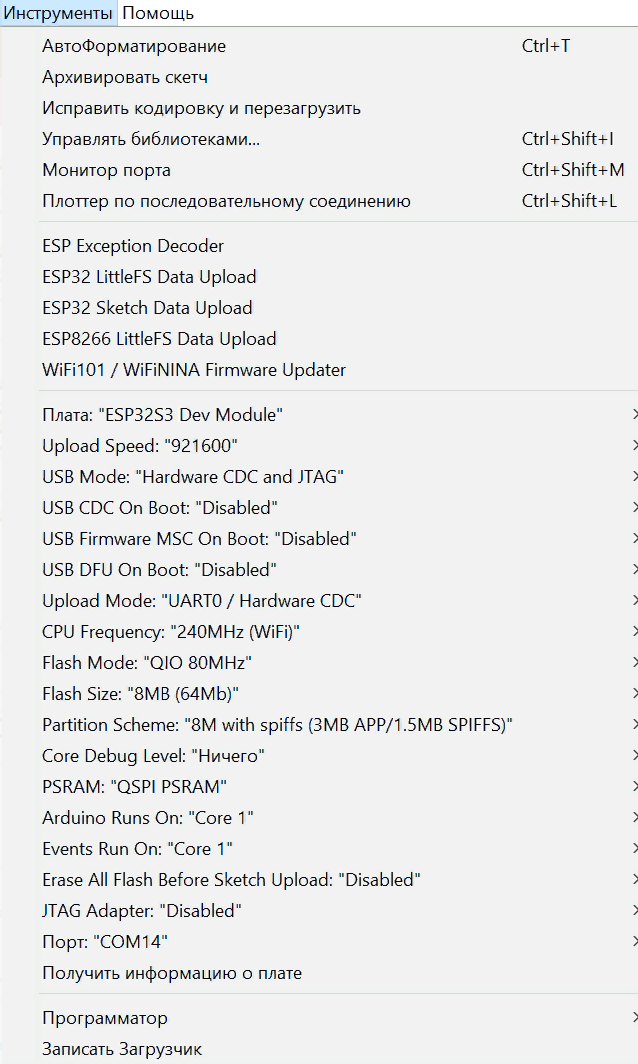
setitngs-esp32-S3.png
