vvip-68/LedPanelWiFi/setitngs-esp32.png

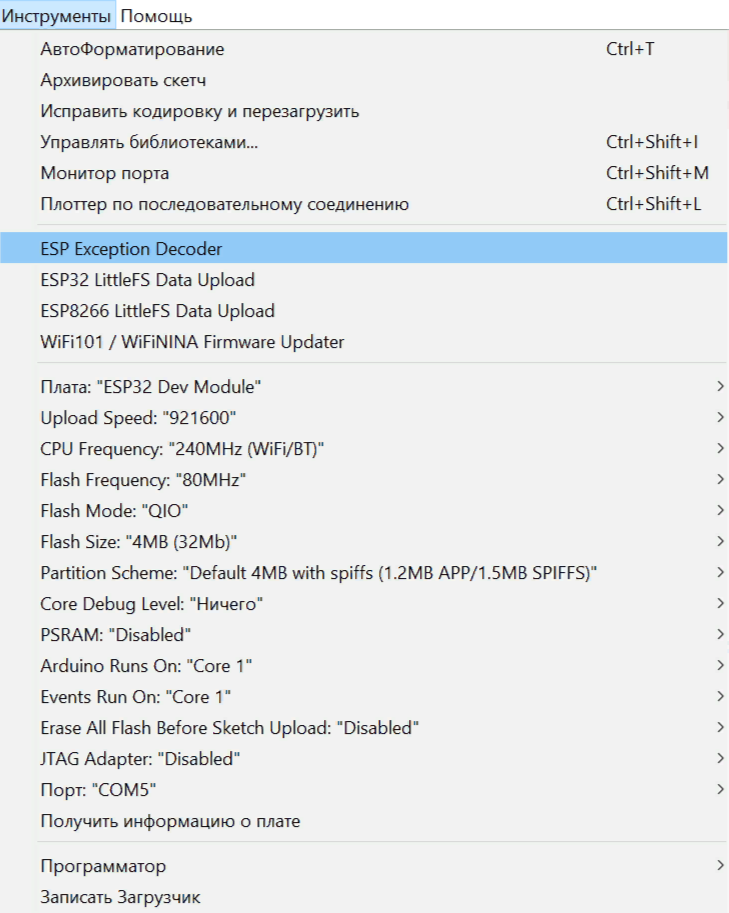
setitngs-esp32.png
