vvip-68/LedPanelWiFi/setitngs-nodemcu.png

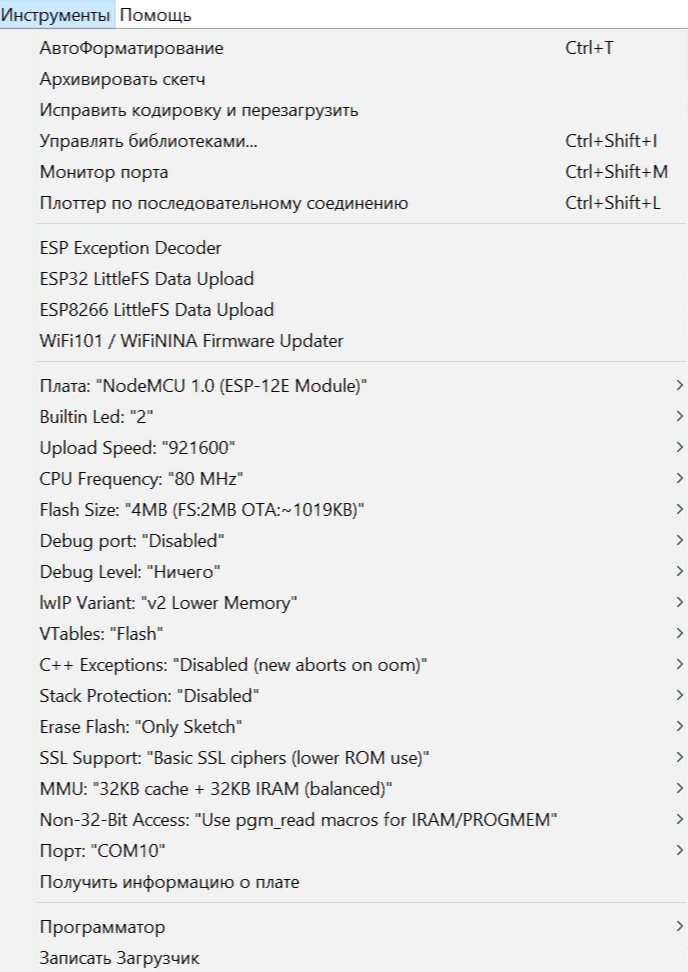
setitngs-nodemcu.png
