vvip-68/LedPanelWiFi/setitngs-wemos.png

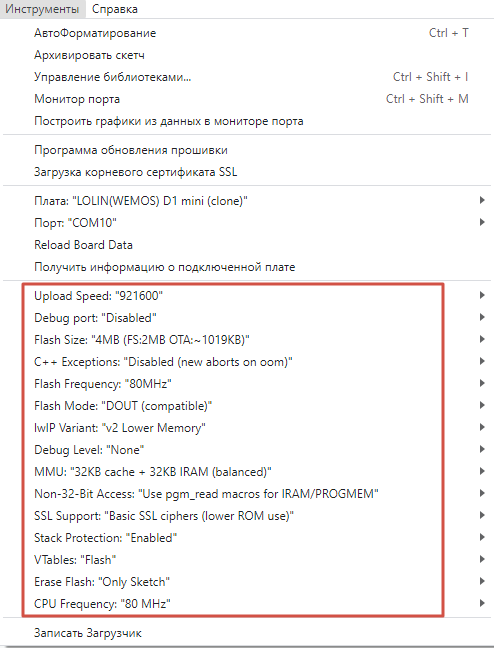
setitngs-wemos.png
