vvip-68/LedPanelWiFi/wiki/About/donate.png

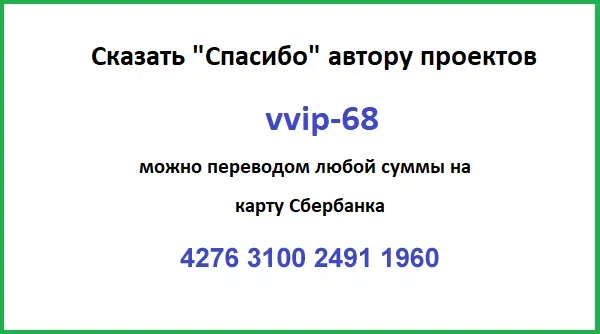
wiki/About/donate.png
