vvip-68/LedPanelWiFi/wiki/Weather/003.png

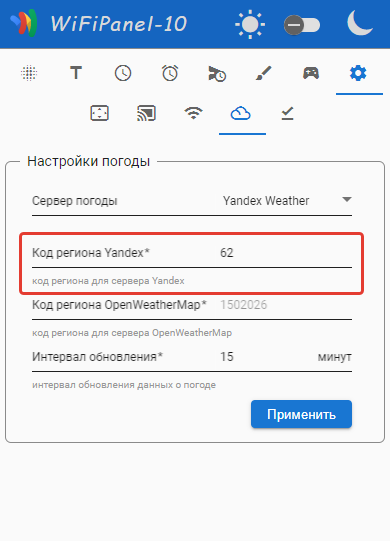
wiki/Weather/003.png
