vvip-68/LedPanelWiFi/stl/16x16/matrix-full.stl

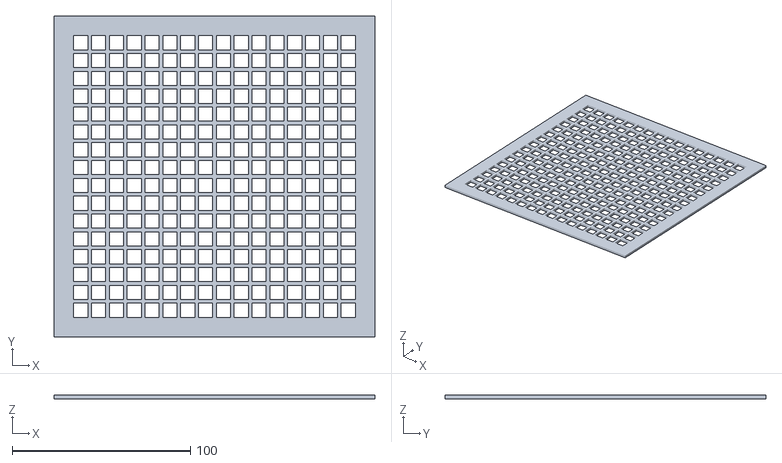
[picture p232: CAD file, 2023-04-14]
stl/16x16/matrix-full.stl
180.0 x 180.0 x 2.00
