vvip-68/LedPanelWiFi/stl/16x16/matrix-2-sides.stl

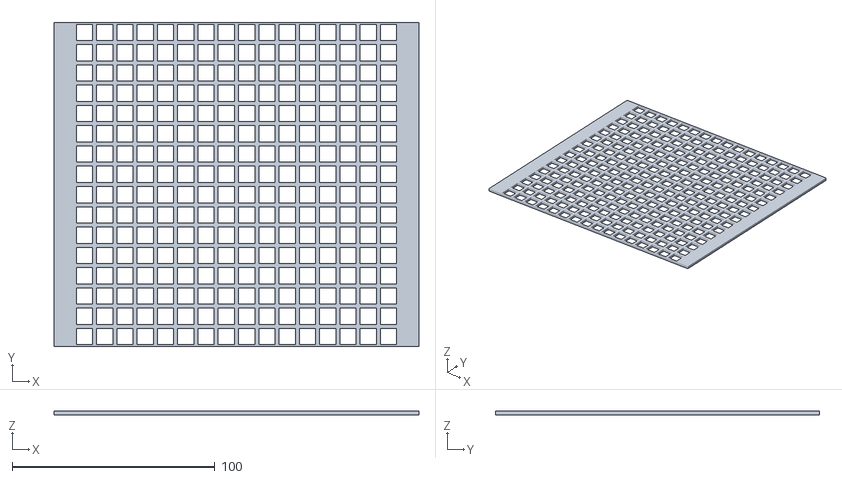
[picture p233: CAD file, 2023-04-14]
stl/16x16/matrix-2-sides.stl
180.0 x 160.0 x 2.00
