vvip-68/LedPanelWiFi/stl/16x16/matrix-1-side.stl

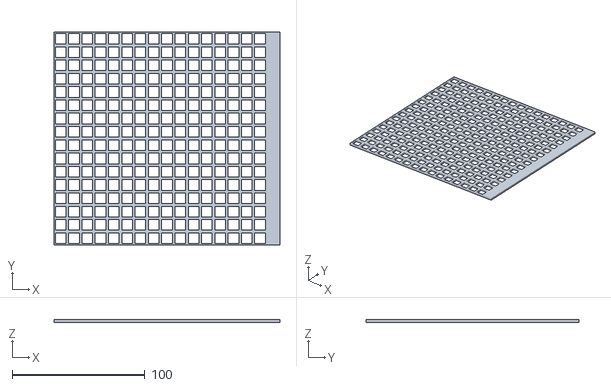
[picture p234: CAD file, 2023-04-14]
stl/16x16/matrix-1-side.stl
170.0 x 160.0 x 2.00
