vvip-68/LedPanelWiFi/stl/16x16/matrix-angle.stl

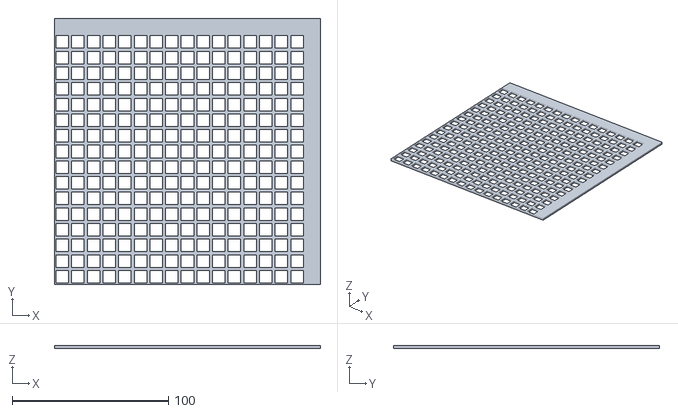
[picture p235: CAD file, 2023-04-14]
stl/16x16/matrix-angle.stl
170.0 x 170.0 x 2.00
