vvip-68/LedPanelWiFi/stl/16x16/matrix-3-sides.stl

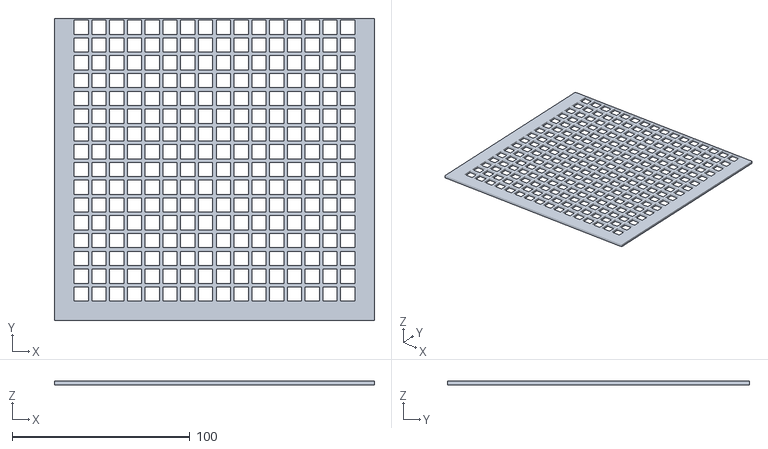
[picture p236: CAD file, 2023-04-14]
stl/16x16/matrix-3-sides.stl
180.0 x 170.0 x 2.00
