vvip-68/LedPanelWiFi/(threads)

Thread 1 (2023-04-22):

[solved] Wemos D1 mini крэшится при подключении к роутеру

oxyii, 2023-04-22:
Спасибо за поддержку и развитие проекта! Переезд на веб-морду, без сомнения, - лучшее, что могло произойти с проектом!

Собственно, сабж. Долго не мог вычислить причину крэшей... помог дополнительный `DEBUG`, который не нёс в себе никакой смысловой нагрузки, но микроскопическую задержку создал.

вот этот `delay` потерял смысл, потому что после проверки кнопки есть еще один:
https://github.com/vvip-68/LedPanelWiFi/blob/531360bccf0535940fdf7867057395b6820fa0a4/firmware/LedPanelWiFi_v1.14/LedPanelWiFi_v1.14.ino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

а вот этот, который "еще один", ставим `delay(1)` и крэши прекращаются:
https://github.com/vvip-68/LedPanelWiFi/blob/531360bccf0535940fdf7867057395b6820fa0a4/firmware/LedPanelWiFi_v1.14/LedPanelWiFi_v1.14.ino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

PR сейчас создать не очень удобно, поэтому оставляю в виде issue. За что отдельно прошу прощения.

vvip-68, 2023-04-22:
Спасибо, мне так удобнее. Внесу исправления...

vvip-68, 2023-04-22:
А в каких случаях крашилось то?
Это процедура подключения к сети WiFi.
Никогда с этим никаких проблем не было...

vvip-68, 2023-04-22:
По документации на ESP8266 модуль, вроде как врот эти пустые delay позволяют ядру выполнять какую-то обработку стека WiFi...

oxyii, 2023-04-22:
По порядку:
При первом запуске контроллер ничего не знает о роутере, создает свою точку доступа, всё прекрасно работает. Через браузер ставлю параметры подключения к роутеру и связь просто теряется. Контроллер уходит в вечный цикл перезагрузок. То есть, он НАЧИНАЕТ попытки подключиться, даже несколько "точек", свидетельствующих об этом, появляется. А потом crash, reboot и по новой. Содержимое порта со стеком ошибки прилагаю.
<details>
  <summary>Порт</summary>

  ```
  WiFiPanel v.1.14.2023.0416-esp8266
  Версия EEPROM: 0xCE
  Host: 'WiFiPanel-0'

  Инициализация файловой системы...
  Использовано 1998848 из 2072576 байт

  Матрица: плоская 16x16
  Адресация: по подключению
    Угол: левый нижний
    Направление: вправо
    Тип: зигзаг

  Доступные возможности:
  + Бегущая строка: шрифт 5x8
  + Кнопка управления: тактовая
  + Синхронизация времени с сервером NTP
  - Управление питанием
  + Получение информации о погоде
  + Управление через Web-канал
  - Управление по каналу MQTT
  - Групповая синхронизация по протоколу E1.31
  - Дополнительный индикатор TM1637
  - Эффекты Jinx! с SD-карты
  - Поддержка MP3 Player

  Выделение памяти для LEDS   : 32440 -> 31664 -- 776
  Выделение памяти для OVERLAY: 31664 -> 30888 -- 776

  Выбранные эффекты и их порядок:
     01. Часы
     02. Лампа
     03. Снегопад
     04. Кубик
     05. Радуга
     06. Пейнтбол
     07. Огонь
     08. The Matrix
     09. Шарики
     10. Звездопад
     11. Конфетти
     12. Цветной шум
     13. Облака
     14. Лава
     15. Плазма
     16. Радужные переливы
     17. Павлин
     18. Зебра
     19. Шумящий лес
     20. Морской прибой
     21. Смена цвета
     22. Светлячки
     23. Водоворот
     24. Циклон
     25. Мерцание
     26. Северное сияние
     27. Тени
     28. Лабиринт
     29. Змейка
     30. Тетрис
     31. Арканоид
     32. Палитра
     33. Спектрум
     34. Синусы
     35. Вышиванка
     36. Дождь
     37. Камин
     38. Стрелки
     39. Анимация
     40. Погода
     41. Жизнь
     42. Узоры
     43. Рубик
     44. Звёзды
     45. Штора
     46. Трафик
     47. Слайды
     48. Рассвет

  Отключенные эффекты:

  Поиск файлов карт индексов...
     16x16.map
     32x16.map
     48x16.map

  Загрузка файла индексов: 16x16.map...
  Загрузка файла карты индексов завершена

  Найденные анимации:
     Сердце	8x8
     Марио	16x16
     Погода	16x16

  Поиск слайдов на FS в папке '16p16'...
  Найдено 48 слайд(oв) размером 16x16:
     airplan.p
     arrow-dn.p
     arrow-lt.p
     arrow-rt.p
     arrow-up.p
     ball.p
     bird.p
     butterfly.p
     clock.p
     comet.p
     cookman1.p
     elka.p
     fish.p
     fox.p
     fox1.p
     frog.p
     frog2.p
     frog3.p
     gift.p
     hand.p
     heart.p
     jinn.p
     kaktus.p
     karate.p
     lebedev.p
     man2.p
     mario.p
     minion.p
     moon.p
     moroz1.p
     mouse.p
     parrot.p
     pigeon.p
     rocket.p
     smile1.p
     smile2.p
     smile3.p
     smile4.p
     smile5.p
     snowman.p
     spiderman.p
     squares.p
     star1.p
     termo.p
     test.p
     weather.p
     winter.p
     zayka.p

  Папка '/web' обнаружена.
  Cпискок файлов web-интерфейса:
     [web]
        MI.122e921fbc0a837a.woff2            59000
        [assets]
           [langs]
              eng.json.gz                     7687
              rus.json.gz                     5823
        favicon.ico.gz                         386
        index.html.gz                         1364
        main.js.gz                          325731
        polyfills.js.gz                      11979
        runtime.js.gz                          638
        styles.css.gz                        12981
        wallet.f3b77cb2a7aa9496.png.gz        1169
  Свободно памяти: 29864

  Подключение к Router -> 192.168.3.105
  ....
  --------------- CUT HERE FOR EXCEPTION DECODER ---------------

  Soft WDT reset

  Exception (4):
  epc1=0x401062e8 epc2=0x00000000 epc3=0x00000000 excvaddr=0x00000000 depc=0x00000000

  >>>stack>>>

  ctx: cont
  sp: 3ffffd20 end: 3fffffd0 offset: 0160
  3ffffe80:  3fff20e0 00001950 00000000 3fff17f4
  3ffffe90:  3fff20e0 00000004 00000000 4020c377
  3ffffea0:  4024ff6c 08080808 4024ff6c 0103a8c0
  3ffffeb0:  4024ff6c 00ffffff 4024ff6c 0103a8c0
  3ffffec0:  4024ff6c 6903a8c0 00000000 40248178
  3ffffed0:  0000181f 00001240 00002710 00000000
  3ffffee0:  4024327c 3ffe9613 3fff2258 3fff0415
  3ffffef0:  3fff0414 3fff17f4 3fff2258 4020c4ad
  3fffff00:  3fff0414 3fff17f4 3fff2258 40230d62
  3fffff10:  00000000 00360036 00000000 00000100
  3fffff20:  00000005 00000020 00000000 0036003f
  3fffff30:  00000000 00000000 00360036 00000000
  3fffff40:  00000000 0036003f 00000000 00000000
  3fffff50:  00363735 00000000 00000000 002d002f
  3fffff60:  00000000 00000000 fe0020b7 00000000
  3fffff70:  00000000 0026002f 00000000 00000000
  3fffff80:  00383438 00000000 00000000 0020002f
  3fffff90:  00000000 feefeffe feefeffe feefeffe
  3fffffa0:  feefeffe feefeffe feefeffe 3fff2428
  3fffffb0:  3fffdad0 00000000 3fff23fc 40246f70
  3fffffc0:  feefeffe feefeffe 3fffdab0 40100fb9
  <<<stack<<<

  --------------- CUT HERE FOR EXCEPTION DECODER ---------------

   ets Jan  8 2013,rst cause:2, boot mode:(3,7)

  load 0x4010f000, len 3424, room 16
  tail 0
  chksum 0x2e
  load 0x3fff20b8, len 40, room 8
  tail 0
  chksum 0x2b
  csum 0x2b
  v0009c1d0
  ~ld
  ⸮⸮ ⸮ ⸮o⸮{⸮⸮g|⸮ l
⸮ $`
c⸮   ⸮| r⸮ $⸮g⸮ ⸮o⸮
d` ⸮⸮s⸮$⸮l ⸮

⸮
  ```
</details>

vvip-68, 2023-04-22:
Понятно. Но странно. Ни на одном из десятков собранных устройств такой картины не наблюдалось ни разу...
Ну ок - помогло -- и замечательно...

oxyii, 2023-04-22:
@vvip-68 я и писал тут больше для "истории". Чтобы в поисковиках кто-то мог найти, если с таким столкнется. Еще раз спасибо за поддержку проекта!

Closed 2023-04-22.

Thread 9 (2023-10-28):

нет доступа к настройкам

bdu1977, 2023-10-28:
переехал на новую версию, на 1,14 и тут начались непонятные проблемы. сборка на nodemcu v3, тм1637, dfplayer. поскольку на контроллер уже была запись старой версии, то я поменял #define EEPROM_OK     0xA6 , в Arduino IDE в меню "Инструменты" -> "Erase Flash" выбрать значение "All Flash Contents", загрузил скетч, потом загрузил файловую систему. логин и пароль к роутеру так же были внесены в скетч. далее в телефоне выбираю сеть точки доступа, ввожу 192,168,4,1 и..... нет ничего, страница с настройками не открывается. пробовал отключать передачу мобильных данных, результата нет. подключения к роутеру нет. в мониторе порта пишет что точка доступа активна, но подключиться не получается. при этом все выводится на матрицу и работает сенсорная кнопка. после очередной прошивки смог подключиться к роутеру, в мониторе порта указан адрес панели, но при введении этого адреса в браузер мне пишется, что сервер не активен. при этом на панель ничего не выводится - только первый светодиод моргает красным-желтым-зеленым, хотя в мониторе порта показывается, что идет смена режимов.
Подскажите что у меня не так.
Напишите правильную последовательность загрузки скетча и файловой системы, с указание что тут  нужно менять в Arduino IDE в меню "Инструменты" -> "Erase Flash" выбрать значение "All Flash Contents и что тут. с учетом того что на контроллере уже прошивка была и работала.

vvip-68, 2023-10-29:
Да, вроде, всё правильно сделано.
Если после очередной перепрошивки (да еще и с опцией Erase All Flash Content) пишет, что сервер не найден - значит после заливки скетча вы не залили файловую систему. Она тоже хранится в Flash Content и загрузка прошивки с этим флагом ее, естественно, тоже уничтожает. Горит только первый светодиод - проверьте к тому ли пину подключена лента. Когда зальете файловую систему и удастся открыть Web-интерфейс - назначение пинов можно менять оттуда.

bdu1977, 2023-10-31:
все получилось с....... не знаю какого раза, не понятно почему (смотрел через монитор порта) не все файлы грузились в файловую систему. в конце концов я смог подключиться к матрице, перевести ее на роутер и уже настраивать через web интерфейс. но тут выявилось еще 2 проблемы.
1. телефон , если хоть раз был подключен к адресу 192.168.4.1 больше не хочет подключаться, там что-то блокируется, буду разбираться.
2. это поведение сенсорной кнопки. управление через web интерфейс идет на ура, но стоит выключить кнопкой и потом включить, то ничего не происходит, мигает только первый светодиод и больше ничего не работает. хотя в мониторе порта все команды переключаются (если управление идет через браузер). если выключить матрицу через браузер, а включить кнопкой, управление через web браузер идет с тормозами, но на панель ничего не выводится. ее можно оживить только выключив питание.
тут в чем дело?
P.S.
по прошивке 1.13 по бегущей строке можно задать тут вопрос или в отдельную ветку выложить?

vvip-68, 2023-11-01:
По подключению к 192.168.4.1 - а в это время контроллер точку доступа поднял (работает как точка доступа)? Если он подключился к сети WiFi - точку доступа он уже не создает.
По кнопке - странно, но ничего сказать не могу. Даже причин такого поведения представить себе не могу.
По вопросу к 1.13 - лучше там. Вдруг у кого такая же проблема есть или была - или ответит, или кто искать ответ будет - увидит решение там.

vvip-68, 2023-11-02:
Про Web-интерфейс. Версия 1.14 больше рассчитана на ESP32 у которой много оперативной памяти. На ESP8266 работает на небольших матрицах - я проверял до 700 диодов примерно. При бОльшем количестве ей элементарно не хватает памяти. Надо смотреть что пишет в мониторе порта. Для Web-соединения там используется сторонняя библиотека, которая,  возможно, написана не оптимально - она дробит память и со временем доступная большим куском память уже не может быть выделена и сервер, крутящийся на микроконтроллере отказывает клиенту.  На фрагментацию обычно нужно какое-то время, поэтому сразу после перезапуска контроллера оно работает, а через несколько дней может уже и не отвечать. Увы. Версия экспериментальная - она и есть экспериментальная, увы.

В общем - нужно смотреть / погонять что в логе пишет, сколько свободной памяти остается. Обычно, когда не может выделить память на запрос  - контроллер просто перегружался... А так - все подключения и всё отправленное фиксируются с сервера клиенту отображается в мониторе порта...

По сенсорной кнопке Версия 1.13 (на которой кнопка работает) от версии 1.14 отличается только прикрученным веб-интерфейсом и убранным MQTT. Все остальные алгоритмы - обработка кнопки, эффекты и всё прочее - не трогалось вообще.  Поэтому вопрос - там работает стабильно / тут не работает - вызывает недоумение и ответить на него я ничего не могу.

bdu1977, 2023-11-02:
у меня матрица 16*16, так что наверное памяти хватает. сейчас включу на ночь, пусть погоняется, потом весь лог посмотрю. что касается кнопки, то тут полный полтергейст, возможно отключать буду.

vvip-68, 2023-11-02:
Сенсорная кнопка - вещь капризная. Провод до нее должен быть лучше экранированным и коротким. Кнопка питаться от 3.3 вольта, не от +5. Если продолжает ловить непонятно что - напаивается конденсатор 10-30пф на специальную площадку

bdu1977, 2023-11-02:
провод у меня примерно сантимов 20, все три провода свиты в косичку. питание подается 3,3в с отдельного стабилизатора.
как посмотреть сколько памяти потребляется матрицей, сколько осталось? в мониторе у меня только смена режимов идет, только про память в самом начале было, вот часть лога

WiFiPanel v.1.14.2023.0602
Контроллер: 'NodeMCU'
Версия ядра: ESP8266 v3.1.2
Версия EEPROM: 0xA6
Host: 'WiFiPanel'

Инициализация файловой системы...
Использовано 1679360 из 2072576 байт

Матрица: плоская 16x16
Адресация: по подключению
  Угол: левый нижний
  Направление:   Тип: зигзаг
Вывод на ленту:
  Линия 1 PIN=D2, START=0, COUNT=256

Доступные возможности:
+ Язык интерфейса: RUS
+ Бегущая строка: шрифт 5x8
+ Кнопка управления: сенсорная PIN=D6
+ Синхронизация времени с сервером NTP
- Управление питанием
+ Получение информации о погоде
+ Управление через Web-канал
- Групповая синхронизация по протоколу E1.31
+ Дополнительный индикатор TM1637 DIO=D5 CLK=D7
- Эффекты Jinx! с SD-карты
+ Поддержка MP3 Player STX=D3 SRX=D4

Выделение памяти для LEDS   : 31232 -> 30456 -- 776
Выделение памяти для OVERLAY: 30456 -> 29680 -- 776

Выбранные эффекты и их порядок:
   01. Часы
   02. Лампа
   03. Снегопад
   04. Кубик
   05. Радуга
   06. Пейнтбол
   07. Огонь
   08. The Matrix
   09. Шарики
   10. Звездопад
   11. Конфетти
   12. Цветной шум
   13. Облака
   14. Лава
   15. Плазма
   16. Радужные переливы
   17. Павлин
   18. Зебра
   19. Шумящий лес
   20. Морской прибой
   21. Смена цвета
   22. Светлячки
   23. Водоворот
   24. Циклон
   25. Мерцание
   26. Северное сияние
   27. Тени
   28. Лабиринт
   29. Змейка
   30. Тетрис
   31. Арканоид
   32. Палитра
   33. Спектрум
   34. Синусы
   35. Вышиванка
   36. Дождь
   37. Камин
   38. Стрелки
   39. Анимация
   40. Погода
   41. Узоры
   42. Рубик
   43. Звёзды
   44. Штора
   45. Трафик
   46. Слайды
   47. Рассвет

Отключенные эффекты:

Поиск файлов карт индексов...
   16x16.map
   32x16.map
   48x16.map
Загрузка файла индексов: 16x16.map...
Загрузка файла карты индексов завершена

Найденные анимации:
   Сердце	8x8
   Марио	16x16
   Погода	16x16

Поиск слайдов на FS в папке '16p16'...
Найдено 48 слайд(oв) размером 16x16:
   airplan.p
   arrow-dn.p
   arrow-lt.p
   arrow-rt.p
   arrow-up.p
   ball.p
   bird.p
   butterfly.p
   clock.p
   comet.p
   cookman1.p
   elka.p
   fish.p
   fox.p
   fox1.p
   frog.p
   frog2.p
   frog3.p
   gift.p
   hand.p
   heart.p
   jinn.p
   kaktus.p
   karate.p
   lebedev.p
   man2.p
   mario.p
   minion.p
   moon.p
   moroz1.p
   mouse.p
   parrot.p
   pigeon.p
   rocket.p
   smile1.p
   smile2.p
   smile3.p
   smile4.p
   smile5.p
   snowman.p
   spiderman.p
   squares.p
   star1.p
   termo.p
   test.p
   weather.p
   winter.p
   zayka.p

Папка '/web' обнаружена.
Cпискок файлов web-интерфейса:
   [web]
      MI.122e921fbc0a837a.woff2            59000
      [assets]
         [images]
            esp32.png                       7978
            nodemcu.png                    10874
            wemos.png                      12207
         [langs]
            eng.json.gz                     8596
            esp.json.gz                     8844
            rus.json.gz                     6712
      favicon.ico.gz                         386
      index.html.gz                         1413
      main.e44c7c6a45b2d807.js.gz         337831
      pf.dcddd532a07c6b2d.js.gz            11979
      runtime.7882e08c7503fb34.js.gz         638
      styles.7e4222ebe23cabfb.css.gz       13020
      wallet.f3b77cb2a7aa9496.png.gz        1169

Инициализация MP3-плеера...
SD-карта, готова
Поиск файлов на карте плеера...

Звуков будильника найдено: 20
Звуков рассвета найдено: 7
Звуков сообщений найдено: 21
DFPlayerError: Таймаут!
SD-карта, готова
Поиск файлов на карте плеера...

Звуков будильника найдено: 20
Звуков рассвета найдено: 7
Звуков сообщений найдено: 21
Поиск файлов на карте плеера...

Звуков будильника найдено: 20
Звуков рассвета найдено: 7
Звуков сообщений найдено: 21
Свободно памяти: 26000

Подключение к zveri -> 192.168.1.55
Двойное нажатие на кнопку для прерывания подключения
и переход в режим точки доступа
..............
WiFi подключен. IP адрес: 192.168.1.55

UDP-сервер на порту 2390
HTTP server started
Свободно памяти: 23864
Переход в авторежим отключен
Режим: The Matrix
NTP-сервер ru.pool.ntp.org -> 162.159.200.1
Отправка NTP пакета на сервер ru.pool.ntp.org

Запрос текущей погоды
Погода получена: Yandex
Город: Удельная
Сейчас: пасмурно, +4ºC
Код иконки: 'ovc'
Цвет неба: '#2c4a81'
Сейчас:
Рассвет: 07:34
Закат: 16:48

UDP пакeт размером 48
UDP << ip='162.159.200.1:123 ntp sync
Разбор пакета NTP
Секунд с 1970: 1698955989
Получено время: 02.11.2023 20:13:09
--------------------
web -> '/web/main.e44c7c6a45b2d807.js.gz' -> send (text/javascript)
FM: 19648 - 18504
web -> '/web/MI.122e921fbc0a837a.woff2' -> send (font/woff2)
FM: 17608 - 15744
web -> '/web/assets/langs/rus.json.gz' -> send (application/json)
FM: 13696 - 12552
web -> '/web/wallet.f3b77cb2a7aa9496.png.gz' -> send (image/png)
FM: 10520 - 9376
WebSocket клиент #1 с адреса 192.168.1.33
WEB пакeт размером 8
<-- $13 2 0;
FM: 19232  Max: 12848  Frag: 32
WEB пакeт размером 62
<-- $6 7|W|H|PS|LG|VR|HN|QZ|FS|SX|CH|CV|WZ|AL|SM|LE|UP|FM|MC|MX|MZ
FM: 18488  Max: 12848  Frag: 30
WEB пакeт размером 31
<-- $6 7|PS|BR|DM|RM|FV|PD|IT|EF|EN
FM: 18272  Max: 12848  Frag: 28
WEB пакeт размером 8
<-- $13 2 1;
FM: 17688  Max: 12848  Frag: 26
WEB пакeт размером 7
<-- $6 7|FV
FM: 17632  Max: 12848  Frag: 27
WEB пакeт размером 8
<-- $13 2 2;
FM: 18008  Max: 12848  Frag: 28
WEB пакeт размером 8
<-- $13 2 3;

vvip-68, 2023-11-02:
>как посмотреть сколько памяти потребляется матрицей, сколько осталось? в мониторе у меня только смена режимов идет, только про память в самом начале было

Ну вот это в логе `FM: 18008` - и есть количество свободной памяти - Free Memory - 18008 байт
Максимальный цельный фрагмент  - Max 12848 байт. Процент фрагментации памяти - Frag: 28%
Все это по результатом того, что  отдает на запрос ядро.

vvip-68, 2023-11-02:
Обычно проблемы начинаются с Web-мордой когда свободной памяти остается 7-8 килобайт, нет одного большого куска такого размера и процент фрагментации - за 80...

bdu1977, 2023-11-03:
т.е. у меня со свободной памятью все нормально?, ну тогда пусть остается так как есть.
спасибо.

vvip-68, 2023-11-03:
Она может дробиться во время работы, так что цельного большого куска может и не оказаться. Но тут я ничего поделать не могу. Наблюдайте...

Closed 2023-11-08.

Thread 10 (2023-11-04):

ttp223 и TM1637

bdu1977, 2023-11-04:
версия прошивки 1.14, nodemcu 3v, кнопка ttp223 и индикатор ТМ1637. загрузка прошла хорошо, кнопка ведет себя неадекватно, при каждом обновлении прошивки, без файловой системы. у кнопки разное поведение, при ее нажатии матрица может повиснуть, может начать моргать, но чаще всего просто регулирует яркость, т.е. одно нажатие это уменьшение яркости от мах до min и наоборот, тройное нажатие включает ночные часы и убирает яркость. установка конденсатора не помогает, замена на другую такую же кнопку то же не помогает. Так же на индикаторе всегда горит значение яркости br99 числа разные в зависимости от яркости. значение часов не выводятся на индикатор. но стоит в рабочей матрице отключить кнопку (у меня она на разъеме) на индикатор выводится значения часов, подключаю кнопку-сразу выводится значение яркости. так же сам индикатор частенько помаргивает, такое ощущение, что на долю секунды на индикатор выводится другая информация.

vvip-68, 2023-11-04:
Ну то есть как факт - проблема в кнопке. Как только ее подключаете - начинаются "чудеса". То что постоянно горит br99 и значения часов не выводятся на индикатор - означает, что прошивка все время видит кнопку "нажатой" - на ее выводе всегда присутствует высокий уровень. Светодиод на кнопке постоянно горит?  В скетче то кнопка обозначена как сенсорная? Может у вас кнопка перемычками AB назначена как триггерная, а не отпустил/нажал. Типа один раз нажал - она включилась. Второй раз нажал - она выключилась...

bdu1977, 2023-11-04:
кнопка в скетче сенсорная установлена, перемычек на кнопке не стоит, светодиод не горит. светодиод горит только тогда когда к ней прикасаешься. работа похожа на триггер, но вот что по факту. на индикаторе br99 я прикасаюсь к кнопке, на кнопке загорается светодиод, отпускаю кнопку, светодиод гаснет, а индикация яркости продолжает идти к нулю, если во время понижения яркости, коснуться кнопки, светодиод загорается, отпускаю кнопку, светодиод гаснет, а яркость нарастает.
если просто тупо тыкать по кнопке, зажимать ее и просто касаться и отпускать, то можно вывести на индикатор часы, но при выключении матрицы и последующем включении, индикатор переключается на показание яркости.
вариант того что кнопка неисправна, немного под сомнением, поскольку именно данная матрица, без каких-либо модификациях на прошивке 1.13 работает идеально. и именно эта кнопка работает просто отлично. я пробовал библиотеки поменять, но компиляция не шла, пробовал код подменить в прошивке, но он не компилировался, немного по другому написан. может есть еще какие соображения?

vvip-68, 2023-11-04:
1.13 от 1.14 отличается выкинутым MQTT и добавленным Web-интерфейсом. Все прочие алгоритмы - обслуживание кнопок, эффекты, часы, TM1637, календари и прочий функционал "ядра" прошивки - без изменений.

bdu1977, 2023-11-04:
ну вот что есть, то есть. я не программист, но буду пробовать разные способы, может что-то получится.

vvip-68, 2023-11-05:
Разбирайтесь. Смотрите настройки - тот ли тип кнопки выбран на странице настроек в WebUI. К тому ли пину подключена кнопка. Только что собрал стенд с сенсорной кнопкой и индикатором - всё работает без каких-либо проблем.

https://drive.google.com/file/d/1Pm9Wf8KpeM3N1vbv5NpARkyZHrKYRZp6/view?usp=sharing

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

Closed 2023-11-06.

Thread 11 (2023-11-04):

stm32

bdu1977, 2023-11-04:
хочу переделать данный проект с заделом на будущее, что бы подключать несколько матриц в наборный экран или использовать матрицу большего размера. можно данный проект исполнить на stm32? есть на данный контроллер какие-то ограничения или другие нюансы по прошивке и обновлению прошивки?

vvip-68, 2023-11-04:
Ну, вроде как stm32 вообще имеет свое SDK и оно не совместимо с SDK Espressif. Для нее вроде даже своя IDE используется - что-то типа STM Cube. Ну то есть скетч переписывать полностью с нуля.

Так а эта прошивка вроде как умеет и матрицы большого размера, и сборные экраны различной конфигурации (даже разных размеров). И даже параллельный вывод на несколько линий - реализовано до 4, но можно дописать, чтобы до 8... Для бОльшего экрана нужна ESP32 у которой больше памяти.

Ну а так - освоить программирование под новый контроллер со своим SDK - хорошее дело, почему бы и нет.

bdu1977, 2023-11-04:
эх, купил одну такую красивую плату, вот валяется бестолку.  Я почему спросил, Алекс Гайвер в самом начале разработки данной гирлянды писал что его прошивку можно на разные платформы прошить. вот я и подумал, а почему бы не использовать данный контроллер, все равно валяется, да и проектов на них почти нет.

vvip-68, 2023-11-04:
И у него при этом в коде была куча ветвлений - вот это - для  вемоса, вот это - для stm
Чего проще - установить ядро STM в ардуино иде, выбрать плату и нажать "скомпилировать". Скомпилится без ошибок - попробовать залить и посмотреть что получится.  Но 99% что не скомпилится и для исправления ошибок потребуется переписать минимум 50% скетча. Есть желание - вперед!

vvip-68, 2023-11-04:
Даже по сути - написание в Arduino IDE и SDK для ESP8266 / ESP32 - по сути костыли (хотя и работают). Потому что родная среда - использование FreeRTOS и родного SDK от Espressif, а все вот это в ардуино иде - по сути костыли / обертка для вызова родного SDK с заведомым урезанием функционала, неоптимальными решениями - лишь бы хоть как-то шевелилось и не падало...

bdu1977, 2023-11-04:
понял. спасибо за пояснение. придется куда-то применить в более простом проекте, что бы не пропадало.

Closed 2023-11-04.

Thread 12 (2023-11-04):

говорящие часы

bdu1977, 2023-11-04:
в папке с проектом есть папка sounds там есть ссылка на скачивание звуков для будильника, и там же говориться о говорящих часах, а где найти данную настройку?

vvip-68, 2023-11-04:
Что-то у меня нет в этом проекте никаких папок и ссылок на говорящие часы...
В прошлых проектах было упоминание - но оно так и осталось нереализованным. Сначала из за нехватки времени, потом из за пришедшего понимания, что это нафиг никому не нужно, и в первую очередь - мне.
Поэтому в этой версии я вроде как все упоминания про говорящие часы удалил... Неужели где-то пропустил?
К тому же уже есть прошивки и с говорящими часами и с огромным количеством всяких эффектов. К чему повторяться?

Closed 2023-11-04.

Thread 13 (2023-11-06):

макроc {P}

bdu1977, 2023-11-06:
придумал как протестировать срабатывание бегущей строки с разными макросами. вот и появился еще вопрос. меня долго интересовал макрос {P} как он срабатывает и как отображается, поскольку я никогда не мог присутствовать в данный момент около матрицы. строка отображается как обычно и то при условии, что она включится в определенный промежуток. в итоге
{B#000000}{C#000002}До Нового года осталось{P01.01.****#Y#60#60}
на матрице отображается просто бегущая строка с отсчетом времени. а можно запрограмировать ее так,  не зависимо от того какой сейчас эффект работает или же на матрице в это время идет другая строка, что бы она принудительно запускалась, пробегала фраза "до нового года осталось" и далее что бы только цифры (не бегали, а стояли на месте как часы,  отсчитывали секунды, ну а далее как обычно, поздравление или что было запрограмировано.
мне кажется, что этот макрос лучше будет в таком виде смотреться.

vvip-68, 2023-11-06:
Ну, насколько я понимаю, данный макрос включится  31.12.**** года в 23:59, далее целую минуту будет непрерывно отображаться строка, содержащая макрос, затем 01.01.**** в 0:00 будет отображаться целую минуту строка Y.
Запускаться должна принудительно на любом эффекте (про замену текущую другую строку - не помню, но в любом случае эта строка должна тогда запуститься сразу после текущей, если она есть, а обычно строка бежит не более 10 секунд (в зависимости от ее длины и скорости прокрутки)).

Мне кажется подобное отображение не совсем корректным - что если не увидел, как пробегала строка фразы, а потом просто какой-то непонятный обратный отсчет...

В любом случае - исходный код проекта открытый - вы можете запрограммировать алгоритм, чтобы отображалось именно так, как вам нужно.

Closed 2023-11-06.

Thread 18 (2023-11-11):

Ссылка на ленту для гирлянд задублирована в About

saippuakauppias, 2023-11-11:
Судя по всему, ссылка на 12см ленту некорректная – там лента с лаковым покрытием проводов.

Случайно наткнулся тут: https://github.com/vvip-68/LedPanelWiFi/blob/main/wiki/About/about.md

```
Ленту с расстоянием между диодами 12 см можно купить [тут](https://aliexpress.ru/item/32707248386.html):

Ленту с расстоянием между диодами 10 см можно купить [тут](https://aliexpress.ru/item/32707248386.html):
```

И ленту с 12см никак не могу найти на алике сейчас, а все что по 10см – на части фото в отзывах с нормальным покрытием, а на других – с лаковым (такое что-то брать совсем уж не хочется, тем более она скорее всего не гибкая будет).

vvip-68, 2023-11-11:
Ну что делать - ссылки на али долго не живут, меняются продавцы, меняется ассортимент товалров. Но направление мысли то понятное. Теперь придется самому искать на Али. Ну, возможно 12-сантиметровые вообще сняли с производства. Не знаю...

7918514, 2023-11-11:
Всем привет. Наткнулся на интересные ленты длиной аж до 200метров и с разным расстоянием между диодами. Сам такие не покупал, про качество не скажу.
https://aliexpress.ru/item/1005004633923201.html
https://aliexpress.ru/item/1005005594095201.html

saippuakauppias, 2023-11-11:
Первые две на WS2811, такие кажется не подойдут :(

А другие WS2812, что вроде бы должно быть ок (но я парой часов раньше купил на основе WS2812B IC у другого продавца, где каждые 10см диоды), вот эти: https://aliexpress.ru/item/1005004846421075.html

Хотя в целом выглядит заманчиво купить бобину 100м, где будет расстояние по 5см, для моей идеи (1.2м х 4 м) будет вообще шикарно смотреться, правда БП туда не ясно какой брать)) В описании товара написано 1 диод = 0.075Вт, получается что:
100м / 5 штук каждый см = 2000 диодов
2000 диодов * 0,075 Вт = 150 Вт
150 Вт / 5 В = 30 А

если ничего не путаю в расчетах и если один диод реально 0.075Вт всего, потому что если он 1 Вт, то уже получится 400 А

7918514, 2023-11-11:
WS2811 это чип, а сами диоды WS2812. У китайцев постоянно путаница с этим.
По поводу мощности: у меня панель на 1050 диодов в пике потребляет 7А. Запитывать конечно нужно с обоих концов и ещё в середине и середине середины... 100 метров тонкого провода не шутки))

saippuakauppias, 2023-11-11:
Если там действительно такое малое потребление, то это очень круто) Я видимо перебдел и заказал на 60А БП, но ничего – если всё пойдет по плану, то у меня забор длинный – ещё лент закажу потом)))

А у вас панель на чипах WS2812 или *b? Потому что судя по гуглу – WS2812b должны быть по многим параметрам лучше, думаю что на большом количестве диодов это должно быть заметно

7918514, 2023-11-12:
У меня панель вот на таких диодах.
https://disk.yandex.ru/d/fIo2UEuKpR54hg
Смотрите в папке **Гирлянда v2**

saippuakauppias, 2023-12-14:
@7918514, заказал одну из этих лент в итоге (2шт, по 50м с расстоянием между диодами в 5см) – вроде как всё работает отлично, напряжения до конца ленты (50м) само собой не хватает и белый свет диодов превращается под конец в тусклый красный)) Но эффекты кажется что работают нормально, цветовая схема такая же и всё кажется ок.
Надеюсь скоро соберу 4м на 1.2м гирлянду из почти 2к диодов))) Лишь бы esp32 пережевал это и не терял сигнал под конец, чтобы эффекты выглядели хорошо (или буду на несколько "линий" разводить, пока не пробовал вместе такую длину)

vvip-68, 2023-12-15:
Я на esp32 просто для тестов гонял 128x128 матрицу - то есть 16384 диодов. Физически, конечно, было подключено меньше, но данный размер позволял проверить хватает ли памяти и - сигнал все равно формирует пакет на все диоды. Ну да, работало медленнее. Распараллеливание даст результат, будет более шустро выводить. Но работало...

Тут кто-то писал, что делал 3 сегмента (кажется тоже на 2000 диодов). Наблюдал, что на трех сегментах были какие-то артефакты, а когда поделил на два сегмента - артефактов не было. Но тут уже вопросы к библиотеке FastLED. Это в ней реализовано распараллеливание вывода. Даже если там есть ошибки - я с этим ничего поделать не смогу.

По питанию матрицы и падению напряжения - производитель лент вообще рекомендует подавать дублирующее питание через каждые 100 диодов. Заводские матрицы 16x16=256 диодов нормально работают при подаче питания с одного конца... Тут наверное вопрос экспериментальный. Какова общая матрица, какова толщина проводов питания линейки / ленты / струны светодиодов...

saippuakauppias, 2023-12-15:
> Я на esp32 просто для тестов гонял 128x128 матрицу - то есть 16384 диодов
Вау) Ну тогда всё точно должно завестись, у меня были сомнения лишь в том, что esp32 вывезет такое количество диодов))

Подключать питание – да, буду смотреть по факту как будет, но планирую каждые 160 диодов пока что, возможно когда соберу каркас – чуть подкорректирую это (чуть реже сделаю), но скорее всего особого смысла реже делать нету и лучше чаще наоборот, все равно придется ленту резать и удлиннять на местах сгибов, чтобы она ровнее легла и не было перекосов.

За совет с 2 линиями за место 3 – спасибо! Интересная штука, как раз тоже думаю придется докручивать это уже по месту.

saippuakauppias, 2023-12-21:
Привет!
Думаю, стоит оставить для истории тут коммент)
Всё собрал в итоге, вышло 80х24 = 1920 диодов, лента длинной 100м. Подключал питание на каждые 2 ряда (через 160 диодов), использовал 60А БП (скорее всего его даже слишком много). Сделал на 1й линии всего (ESP32 если что), все работает отлично! Думал будут задержки на последних рядах, но нет - сигнал доходит быстро и скорее всего даже если они есть – ничего не заметно для глаза. В итоге решил на 2 линии не разделять :)

PS: @vvip-68, можете ссылку на спонсорство в репе добавить помимо paypal ещё, например, тинькоф/сбер или yoomoney? Очень хочу задонатить за то, что поддерживаете и дорабатываете этот прекрасный проект!

vvip-68, 2023-12-21:
paypal - остался рудимент, получить с него все равно ничего невозможно.
Ссылка на сберкарту там есть.
Тинькова или юмани у меня нет.

Closed 2023-11-11.

Thread 21 (2023-11-14):

Compilation error: ESPAsyncWebServer.h: No such file or directory

himvampir, 2023-11-14:
Очень прошу помогите. делаю детям гирлянду первый раз в жизни использую ардуино и тп.
не могу скомпилировать код. Вероятно где-то допустил ошибку но понять не могу.
```
In file included from C:\Users\bot_h\Desktop\LedPanelWiFi-main\LedPanelWiFi-main\firmware\LedPanelWiFi_v1.14\LedPanelWiFi_v1.14.ino:153:
C:\Users\bot_h\Desktop\LedPanelWiFi-main\LedPanelWiFi-main\firmware\LedPanelWiFi_v1.14\a_def_hard.h:461:10: fatal error: ESPAsyncWebServer.h: No such file or directory
  461 | #include <ESPAsyncWebServer.h>   // Библиотека асинхронного Web-сервера
      |          ^~~~~~~~~~~~~~~~~~~~~
compilation terminated.

exit status 1

Compilation error: ESPAsyncWebServer.h: No such file or directory
```

himvampir, 2023-11-15:
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

я прошу прощения я вроде все по инструкции делал, а подскажите есть ли возможность чтоб вы мне помогли удаленно, я Вам оплачу естественно.
Если да то напишите мне в телеграмм пожалуйста @himvampir

himvampir, 2023-11-15:
и еще вопрос  все завелось вроде подключаюсь к точке доступа а вместо вебморды пишет сервер не активен это что нужно сделать?

vvip-68, 2023-11-15:
Прочитать в wiki проекта раздел с FAQ именно с таким названием
--
Отправлено из Mail.ru для Android четверг, 16 ноября 2023г., 02:57 +07:00 от himvampir  ***@***.*** :

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

Closed 2023-11-19.

Thread 36 (2023-12-08):

Led Panel WiFi

romchik1982, 2023-12-08:
Уважаемый автор, спасибо за отличную программу! Много всяких настроек и возможностей, но неужели нет такой простой опции как сделать текст бегущей строки жирным?

vvip-68, 2023-12-08:
Простой опции? Ну-ну...
Буквы в шрифте - битовые карты (картинки по факту) букв. Определены в файле fonts.h
Рисуйте свои шрифты как вам нравится. Плюс немного переписать процедуру вывода буквы, т.к. сейчас размеры (ширина одной буквы) - для "тонких букв". Рисуйте, переписывайте.

Учтите также, что все эти массивы хранятся в памяти постоянной микроконтроллера, которой не слишком много. Так что хранить одновременно шрифты и узких и широких букв у вс скорее всего не хватит памяти...

saippuakauppias, 2023-12-15:
@romchik1982 , если бегущая строка нужна без макросов, то проще всего сделать нужный размер текста через ПО «Jinx!» (есть в репозитории). Там есть Input text или как-то так эффект. В сети на ютубе множество примеров использования этой программы. Даже есть туториалы как гифки конвертить через неё (без необходимости записи экрана).

@vvip-68, а как "выделять нужно цветом"? Я с бегущей строкой пока не разбирался, потому что собирал макет на коленке, но не помню такой настройки в веб-интерфейсе. Оно там или в самом коде где-то задается?

vvip-68, 2023-12-16:
@saippuakauppias  это в макросах бегущей строки. Макрос {C}
https://github.com/vvip-68/LedPanelWiFi/wiki/Настройка-бегущей-строки

romchik1982, 2023-12-17:
Мне как раз таки макросы устраивают, удобно писать всякий текст на окне для рекламы! Но хотелось бы как то, чтобы буквы были не по одному пикселю, а хотя бы в два, ну чтобы текст был более жирным! Я использую версию 1.13
Я смотрел макрос (С) но там только цвет и все, больше я ничего не нашел В описании макросов тоже что то про жирный текст ничего не сказано!
--
Отправлено из Mail.ru для Android пятница, 15 декабря 2023г., 23:29 +03:00 от Denis Veselov  ***@***.*** :

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

Closed 2023-12-10.

Thread 41 (2023-12-14):

[web] Выставлять максимальное число диодов из матрицы после сохранения размеров

saippuakauppias, 2023-12-14:
В случае если меняется размер матрицы в сегментах
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

При записи значения в память – не происходит изменение количества диодов на линии:
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
Хотелось бы, чтобы здесь записывалось автоматом максимальное значение (ширина х высота) диодов.

Я столкнулся с этим, когда тестировал разные размеры диодной ленты: менял ширину и высоту, но количество диодов на линии не увеличивалось само (я и не смотрел туда), поэтому думал что не хватает напряжения. Но только после того как разрезал ленту и воткнул доп питание на другой конец – осознал, что что-то тут не так и нашел этот кейс :)

Сходу, если честно, не очевидно. Тут как минимум бы пояснение комментарием нужно, а в идеале - записывать сразу туда максимальное значение диодов (если выбрана всего 1 линия) после сохранения.

PS: спасибо за поддержку проекта! Он крутой и вышел вообще офигенным с этим web-интерфейсом новым)

vvip-68, 2023-12-15:
Там же на странице установки размеров матрицы явно написано - что это нужно сделать... Что не очевидно?
Шрифт предупреждения нужно сделать покрупнее? Цвет с синего на оранжевый поменять?

Установка автоматом - сомнительна. Ну да, в большинстве случаев - одна линия и так оно и есть. Но есть масса частных случаев - когда линии, например, две.  И размер матицы распределяется между пинами. Когда несколько матриц в синхронизации и мне нужно выводить иметь полный массив в указанные размеры матрицы, но на подсоединенный к ЭТОМУ контроллеру "экран" выводить не всю матрицу, а только частично. И так далее.

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

saippuakauppias, 2023-12-15:
Вот блин, а его я вообще не заметил) Удивительно

saippuakauppias, 2023-12-16:
PS: лучше оранжевый сделать, да)

И по поводу линий: если установлена 1 линия, то кмк можно на всю эту линию максимум и давать. А если уже 2 или 3 - то там пусть остается как есть

vvip-68, 2023-12-16:
В последней версии я сделал оранжевым.
По пинам. Вот текущая ситуация. У меня 4 окна. На каждое окно - по гирлянде. Каждая со своим контроллером. Один мастер + 3 приемника. У каждого по одной линии. Контроллер имеет полную матрицу на изображение. Приемники - принимают "вырезки" с этой общей большой матрицы. И хотя полный размер у меня 45x10 - 450 диодов на контроллер нужно выводить только первые 100 диодов. Зачем я буду туда автоматом прописывать все 450?

saippuakauppias, 2023-12-16:
Хм, понял. Поинт весомый и понятный, согласен)

Closed 2023-12-16.

Thread 45 (2023-12-19):

Не открывается WEB интерфейс

altdaps, 2023-12-19:
Прошиваю ESP32_DEVKit, заливаю через SPIFS файлы, подключаюсь через точку доступа PanelAP, захожу по 192.168.4.1, настраиваю подключение к своей wifi сети, после этого достучаться до web интерфейса по ip адресу, выданному по dhcp не могу. Лог показывает, что подключение есть, показывает ip адрес, происходит синхронизация времени через ntp, web интерфейс роутера тоже показывает клиента esp32. Что я делаю не так?

vvip-68, 2023-12-19:
А что пишет лог браузер на вкладке сеть когда в нем F12 нажимаешь?

altdaps, 2023-12-19:
Не совсем понимаю как это работает, но по адресу 192.168.0.100 открывается интерфейс, хотя адрес выдается 0.107.
В коде есть такая строчка #define DEFAULT_IP {192, 168, 0, 100}, что она дает?

vvip-68, 2023-12-19:
Эта строчка прописывает IP адрес, которое получит устройство после прошивки скетча на ЧИСТУЮ память. Это  значение сохраняется в EEPROM и при последующих загрузках, если не прошивать с очисткой памяти - адрес берется уже оттуда. Его можно изменить через Web-интерфейс.

Можно ставить 0,0,0,0  - тогда адрес будет получаться через DHCP, но я тогда не представляю как вы будете искать устройство в сети, чтобы открыть его WebUI/ Каждый раз лезть в роутер и смотреть куда на этот раз село устройство? Так себе удовольствие...

Closed 2023-12-28.

Thread 46 (2023-12-21):

Нет высокого уровня

AHgPEu1, 2023-12-21:
Недавно решил подключить к данной гирлянде реле на MOSFET и обнаружил одну проблему- на пине D1 отсутствует высокий уровень (HIGH), хотя в скетче включен USE_POWER 1 и POWER_ON  HIGH. В web-настройках тоже пробовал и так и так, ничего не меняется, на пине D1 низкий уровень - GND. Пробовал задействовать пин D0, на нем тоже становится низкий уровень. Сама плата WEMOS исправна. Когда назначаешь пин D0, например, на D1 сразу высокий появляется. Т.е. пин исправный.  И когда в web-настройках задаешь время, допустим включить какой-то режим, на пине не появляется высокий уровень. Ощущение, что где-то в коде закралась ошибка.
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

AHgPEu1, 2023-12-21:
Недавно решил подключить к данной гирлянде реле на MOSFET и обнаружил одну проблему, на пине D1 отсутствует высокий уровень (HIGH), хотя в скетче включен USE_POWER 1 и POWER_ON  HIGH. В web-настройках тоже пробовал и так и так, ничего не меняется, на пине D1 низкий уровень - GND. Пробовал задействовать пин D0, на нем тоже становится низкий уровень. Сама плата WEMOS исправна. Когда назначаешь пин D0, например, на D1 сразу высокий появляется. Т.е. пин исправный.  И когда время в web-настройках задаешь время, допустим включить какой-то режим, на пине не появляется высокий уровень. Ощущение, что где-то в коде ошибка.

vvip-68, 2023-12-21:
В коде нет ошибки. У меня к этому пину светодиод припаян на тестовом стенде. И все загорается при включении и гасне при выключении.

AHgPEu1, 2023-12-21:
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

AHgPEu1, 2023-12-21:
> В коде нет ошибки. У меня к этому пину светодиод припаян на тестовом стенде. И все загорается при включении и гаснет при выключении.
В какую сторону копать? Т.е. высокий уровень на пине должен появляться просто при включении платы? Кстати, в таймере в web интерфейсе нет слова ВКЛЮЧИТЬ, только ВЫКЛЮЧИТЬ. Я так понимаю, что включить - это DEMO режим?

vvip-68, 2023-12-21:
Да, при включении платы (точнее когда в loop() входит) просто должен на пин подаваться высокий уровень
Это в файле a_main.ino примерно здесь:

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

А что за таймер в веб-интерфейсе? И ВКЛЮЧИТЬ или ВЫКЛЮЧИТЬ?
В режимах по времени - то что "Выключить матрицу" - это ВЫКЛЮЧИТЬ, всё остальное - ВКЛЮЧИТЬ

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

vvip-68, 2023-12-21:
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

https://drive.google.com/file/d/1YSsT8gimIm-9QuzqltwGActiW_72-TOg/view?usp=sharing

AHgPEu1, 2023-12-21:
Ничего не помогает, нет и всё высокого..

WiFiPanel v.1.14.2023.0602
Контроллер: 'Wemos d1 mini'
Версия ядра: ESP8266 v3.1.2
Версия EEPROM: 0xA5
Host: 'WiFiPanel'

Инициализация файловой системы...
Использовано 655360 из 2072576 байт

Матрица: плоская 15x12
Адресация: по подключению
  Угол: левый нижний
  Направление:   Тип: зигзаг
Вывод на ленту:
  Линия 1 PIN=D2, START=0, COUNT=180

Доступные возможности:
+ Язык интерфейса: RUS
+ Бегущая строка: шрифт 5x8
- Кнопка управления
+ Синхронизация времени с сервером NTP
+ Управление питанием PIN=D1
+ Получение информации о погоде
+ Управление через Web-канал
- Групповая синхронизация по протоколу E1.31
- Дополнительный индикатор TM1637
+ Эффекты Jinx! с SD-карты CS=D8, CLK=D5, MISO=D6, MOSI=D7
- Поддержка MP3 Player

Выделение памяти для LEDS   : 28696 -> 28152 -- 544
Выделение памяти для OVERLAY: 28152 -> 27608 -- 544
и т.д.

vvip-68, 2023-12-21:
Ну, не знаю тогда. У вас версия еще июньская. Возьмите свежую - может чего поменяется...

AHgPEu1, 2023-12-21:
> Ну, не знаю тогда. У вас версия еще июньская. Возьмите свежую - может чего поменяется...

Ёоо... На новой прошивке всё заработало как часы)))

p.s. Может заодно подскажите, как сделать, чтобы эффекты с SD-карты можно было вызывать в разных местах "выбора эффекта"? Пробовал создать в коде еще одно название "SD-карта"- это не помогло. Вторая оказалась пустышкой. Хотел сделать дубль SD-карты и вторую вызывать в другом месте эффектов)

vvip-68, 2023-12-21:
А в чем смысл?

AHgPEu1, 2023-12-21:
> А в чем смысл?

Допустим, на SD-карте находятся 5 эффектов, а всего в DEMO режиме 40 эффектов. И каждый эффект с SD-карты будет повторяться только через 40 эффектов, если включить на ней последовательный выбор, так ведь? Или программа все эффекты с SD-карты один за одним покажет?

vvip-68, 2023-12-22:
А если поставить рандомный выбор - то эффекты на карте выпадают примерно в 10 раз чаще чем прочие эффекты. Каждый раз со случайным роликом. Но есть режим в настройках - последовательно - когда с SD карты ролики показываются последовательно один за одним, пока не закончатся, после чего переходят к обычным эффектам и далее последовательно, пока не вернется к SD-карте, все ролики с нее и так далее...

AHgPEu1, 2023-12-22:
> А если поставить рандомный выбор - то эффекты на карте выпадают примерно в 10 раз чаще чем прочие эффекты. Каждый раз со случайным роликом. Но есть режим в настройках - последовательно - когда с SD карты ролики показываются последовательно один за одним, пока не закончатся, после чего переходят к обычным эффектам и далее последовательно, пока не вернется к SD-карте, все ролики с нее и так далее...

Спасибо.

Closed 2023-12-22.

Thread 47 (2023-12-22):

Возможно ли добавить в прошивку MQTT?

GeorgyBenelli, 2023-12-22:
Здравствуйте.Правильно ли я понимаю что в 1.14 убрали mqtt?В a_def_soft.h нет этих настроек.Возможно ли вернуть MQTT?Спасибо

vvip-68, 2023-12-22:
Да, убрали. Об этом даже на первой странице проекта написано.
Вернуть можно. Дело за малым - никто не может сформулировать что нужно и как это должно работать.

Нет постановки задачи, нет понимания как это правильно организовать, какие функции должны присутствовать, нет детальной проработки -> нет реализации.

GeorgyBenelli, 2023-12-22:
> Да, убрали. Об этом даже на первой странице проекта написано. Вернуть можно. Дело за малым - никто не может сформулировать что нужно и как это должно работать.
>
> Нет постановки задачи, нет понимания как это правильно организовать, какие функции должны присутствовать, нет детальной проработки -> нет реализации.

Да хотяб как в прошлой версии)В основном задача легкой интеграции в различные системы умного дома.А если по существу то хотелось бы управлять/получать статус по MQTT хотяб:
1.Вкл/выкл
2.Эффект
3.Пресет
4.Яркость
5.В идеале текст слать по Mqtt и чтоб он на панели был(Например с телеграм;)
Ну в общем хотелось бы хотя бы базовые функции видеть в MQTT.

Спасибо за отклик

vvip-68, 2023-12-22:
В прошлой версии задача MQTT выполняла на 90% обслуживание связи андроид-приложения для управления вне локальной сети. И все команды (формат команд) были заточены исключительно под это приложение. То как было реализовано там - это во многом противоречит нормальной, классической реализации связи по MQTT. Что вызывало многочисленные трудности и нарекания от тех, кто пытался построить на этом интеграцию с умным домом.

Приложения больше нет и в этом смысле MQTT перестал быть нужным - я убрал его.

То что вы говорите - это общие слова и пожелания без определения технической реализации. На этом сод не напишешь и связь не построишь. Я понятия не имею как работают умные дома и как технически все это должно быть реализовано. Поэтому и не берусь за это дело.

И похоже что те, кому нужно управление по MQTT и интеграция в умный дом хотят инструкции - вот вам умный дом, напишите такие-то команды и скрипты, нажмите на эти кнопочки. А такого нет.

А тот кто знает как построить связь MQTTЮ как это интегрировать в мный дом - им это (в этом проекте нафиг не нужно).

Поэтому - нет детального описания (технического задания) - нет и реализации. Так пока на этом и остаемся.

GeorgyBenelli, 2023-12-22:
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

Далеко ходить не буду. Например есть комьюнити Sprut по умным домам. Несколько тысяч активных юзеров из которых наверное минимум несколько сотен человек кто в состоянии собрать Ваш проект(паять есп или купить готовую Gledopto WLED и на нее накатить).Там официальные интеграции по апи выходят лишь на массовые продукты, а остальное делают обычные участники комьюнити и именно по мктт. Не знаю сколько из этих людей хотели бы повторить проект, но думаю когда узнают то будут такие же.

Вы правы, это лишь мое пожелание. Я пользователь NodeRED и мне было бы проще автоматизации строить там на MQTT чем на апи, как и многим другим пользователям системы NodeRED

vortigont, 2023-12-23:
> Я пользователь NodeRED и мне было бы проще автоматизации строить там на MQTT чем на апи

нет такого понятия "строить автоматизацию на MQTT". Это всё равно что сказать "строить автоматизацию на HTTP". MQTT описывает лишь формат передачи данных, сырых данных. Т.е. это даже не текст. Что в этих данных будет бегать и как именно их интерпретировать (как текст, как бинарные данные, как джейсон определенной структуры) определяется строго формализованными договоренностями - это и есть API. Построить автоматизацию на MQTT не договорившись об API для устройства которое вы хотите автоматизировать - невозможно.
API в этом проекте есть, сделать так что бы те же текстовые сообщения которые бегают между вебмордой и контроллером начали бегать и в MQTT не сложно. Вопрос в том, готовы ли вы на стороне NodeRed написать всю ту логику, которая нужна для разбора и отправки этих сообщений что бы построить интеграцию?

vvip-68, 2023-12-23:
@GeorgyBenelli - ну вот, вы собираетесь строить автоматизацию на NodeRED. То есть вы знаете / понимаете что и в каком формате, используя какие каналы вы собираетесь отправлять в устройство и получать от него ответы. Ну вот и сформулируйте. Опишите весь протокол. Оформите в виде ТЗ.

Мне вот например всю эту автоматизацию, буде она реализована - даже тестировать не на чем.

GeorgyBenelli, 2023-12-23:
> @GeorgyBenelli - ну вот, вы собираетесь строить автоматизацию на NodeRED. То есть вы знаете / понимаете что и в каком формате, используя какие каналы вы собираетесь отправлять в устройство и получать от него ответы. Ну вот и сформулируйте. Опишите весь протокол. Оформите в виде ТЗ.
>
> Мне вот например всю эту автоматизацию, буде она реализована - даже тестировать не на чем.

MQTT в умнодомых системах не стандартизирован вообще.Каждый делает как хочет.Кто то делает один топик со всем в JSON,а кто то по топикам раскладывает(так удобнее).Обычно это топик состояния(state) и топик управления (command или set).И в системах умного дома нет никаких сложностей это обрабатывать, особых скриптов не нужно тк разработчики обычно заботятся о том чтобы это делалось легко.Достаточно указывать топики и что в них слать или брать с них.Есть конечно и немного стандартизированные проекты с MQTT такие как Home Assistant Discovery или [ESP Home](https://esphome.io/components/mqtt.html).Но в целом особо без разницы как оно будет.Вполне подойдет то что было в прошлой версии в MQTT;)

GeorgyBenelli, 2023-12-23:
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
Вот к примеру мой обычный аналоговый домофон.Все просто сделано и легко добавляется в любые системы.

Closed 2023-12-24.

Thread 49 (2023-12-23):

Мерцания, артефакты, паразитные пиксели

AlekseyMakshakov, 2023-12-23:
Добрый день! Сделал матрицу из ленты, 16*12, wemos d1 mini. На старой версии 1.13 все работает отлично. Поставил 1.14 - начались проблемы с мерцанием диодов, паразитные засветы вокруг зажигаемых диодов, лишние пиксели горят. Ставлю обратно 1.13 - опять все четко. Через веб-интерфейс пытаюсь менять яркость - меняются цвета и количество паразитных пикселей, яркость не меняется. Конденсатор, резистор, диод поставил - результат тот же, да и очевидно не в питании дело, раз на 1.13 все хорошо. Куда еще можно копать, не подскажете?
Попробовал версию ядра 2.7.4 поставить (в 1.13 было написано, что  из-за этого подобное поведение может быть), но оно так даже не компилируется, ругается что какой-то pin неверно задан.
Версию ESP8266 пробовал как в документации написано - 3.1.2, FastLed 3.6.0

vvip-68, 2023-12-23:
Ну если версии ядра и библиотек соответствуют - думаю проблема все же в питании...
Ждите, может кто с таким сталкивался - ответит.
У меня такой эффект только при плохом (шумящем БП) или завышенном напряжении питания замечался.

AlekseyMakshakov, 2023-12-23:
Спасибо за ответ! А разве может на разных прошивках эффект от питания настолько различаться?

GeorgyBenelli, 2023-12-23:
У меня тоже самое.И тоже собрал на пробу матрицу 16*12 на гирлянде.На 1.13 все хорошо.Залил  WLED и тоже все гуд.

vvip-68, 2023-12-24:
@AlekseyMakshakov ну, все-таки ядро микроконтроллера тоже большую роль играет. Да и сама библиотека FastLED. Помнится с пере[одом с 2.7.4 на 3.0.0 лента вообще перестала работать нормально. Всякие случайные вспышки, постоянное горение первого светодиода. Только к версии 3.1.2 более-менее стабилизировали.

Синхронизирующего сигнала на этих лентах нет, все тайминги задаются программно. Возможно и лента немножечко "особенная" попалась и ядро накладывает свое влияние, сама библиотека.

@GeorgyBenelli и версия 1.13 и WLED - обе они используют ядро 2.7.4; Версия 1.14 использует ядро 3.1.2...

AlekseyMakshakov, 2023-12-24:
А 1.14 на 2.7.4 запустить не получится?)

vvip-68, 2023-12-24:
Нет. Там какие-то несовместимости в ядре уже, кажется. Впрочем - попробуйте, но думаю что нет.
Ну у 99% повторивших - проблем нет на ядре 3.1.2 и FastLED 3.6

ramballan, 2023-12-27:
у меня такая же проблема. Питание блока 5,5 в. Никаких конденсаторов и диодов не ставил, только резистор от ESP8266 к ленте. АртефЕсли отключить то вс ок работает

vvip-68, 2023-12-27:
Ну потому и мерцает, что без диода вместо допустимых 4.9В подано 5.5В

ramballan, 2023-12-27:
поставил диод, поведение не поменялось
попробовал другой блок питания (на нём 5.2)
попробовал подключить через понижающий dc dc и пробовал разные питания от 4-5 вольт
итог один и тоже, пока не подлючен wifi всё работает. как только подключил wifi начинаются артефакты

vvip-68, 2023-12-27:
Я не знаю как это у вас исправить. У меня нет идей.
Попробуйте взять прошивку WLED. Она, говорят, уже довольно функциональна и стабильно (как говорят) работает...

7918514, 2023-12-31:
> только резистор от ESP8266 к ленте.

Один раз у меня был случай, что именно из-за этого резистора были глюки. Как только резистор убрал, то сразу всё нормализовалось.

Thread 51 (2023-12-29):

Контроллер зависает/тормозит на морозе?

saippuakauppias, 2023-12-29:
Заметил странное – на улице похолодало (а гирлянда и МК на улице) и эффекты с SD карты теперь зависают и фактически воспроизводятся меняя кадр раз в 20-40 секунд.
После перезагрузки всё ок, но возможно только до следующего перехода на эффект с карты.
Пока что эффекты с SD отключил понаблюдать, но может быть кто-то сталкивался с чем-то похожим?
Дебаг с серийного порта не делал, подключившись к МК, да и вряд ли там будет что-то. Но веб-интерфейс в этот момент точно не грузит.

PS: модуль для карты от амперки (http://wiki.amperka.ru/%D0%BF%D1%80%D0%BE%D0%B4%D1%83%D0%BA%D1%82%D1%8B:troyka-sd), какой был. Карта на 4ГБ памяти, всего где-то 30-40 эффектов по 2-5МБ (в сумме меньше нескольких сотен МБ).

vvip-68, 2023-12-30:
В ветке ntp_lwip выложил последнюю версию скетча, которая работает вполне сносно у меня сейчас. Попробуйте ее, если есть запасной контроллер, чтобы в случае чего просто поменять местами с текущим. Может оно не из за температуры зависает а из за ошибок в прошивке... Может с этой лучше будет работать

saippuakauppias, 2023-12-30:
Спасибо! Постараюсь попробовать просто прошить текущий МК, который стоит, а то запасного нету, да и текущий спаян вместе с SD-слотом и конденсатором, просто так не сменишь :)

К слову, сегодня заметил что такой же эффект с тормозами наблюдается и на бегущей строке (эффекты с SD пока отключил).

PS: Если буду подключать МК к ноутбуку в момент зависания, то что может быть в логах серийного порта? Может быть на что-то особенно стоит обратить внимание?

saippuakauppias, 2023-12-30:
PPS: к слову, больше недели всё работало без единого бага, но вот почему-то без всякого моего вмешательства (за исключением воздействия внешней среды в виде понижения температуры) – теперь он подвисает так(

vvip-68, 2023-12-30:
Похоже это зависит от фаз луны :(. Тоже то работало без замечаний, то фризы какие-то. Но я по большей части смотрю "трансляцию с мастера", а тут много зависит от того насколько забита сеть, смотрит ли кто-то на соседних компах кино с инета, к примеру.

В логах монитора по этому поводу не будет ничего.
Не знаю, что у вас за контроллер, я сейчас на Wemos d1 mini гоняю...

Вот весь день сегодня перебирал версии FastLED и параметры компиляции. Пока лучшие результаты давал FastLED 3.4, c
#define FASTLED_ALLOW_INTERRUPTS 0
ПЕРЕД
#include <FastLED.h> и примерно следующими настройками

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

vvip-68, 2023-12-30:
Flash mode можно QOUT ставить, но некоторые контроллеры с таким значением даже не запускаются. Тогда DOUT

saippuakauppias, 2023-12-30:
> В логах монитора по этому поводу не будет ничего.
Может быть стоит добавить логирование на карту памяти? Я бы погонял и скинул логи для изучения.
Например, каждый эффект/каждые 10 секунд логировать время + объем RAM/занятую CPU/что-то ещё, что косвенно может сказать о наличии проблеме где-то. Только главное дескриптор к файлу не держать открытым, что при перезагрузке МК – все точно flush-нулось в файл :)) Ну и за объемом файла, наверное, тоже следить и ротировать это как-то (как logrotate в *nix, например).

> Не знаю, что у вас за контроллер, я сейчас на Wemos d1 mini гоняю...
У меня ESP32, я сразу купил пожирнее, чтоб вывезло большую ленту (читал в вики это где-то)

По остальному – спасибо, буду пробовать) Уже только скорее всего 1-2 января, чтоб завтра случайно не убить МК перед новогодней ночью)))

vvip-68, 2023-12-31:
Логи. В данном случае ничего не дадут. Я гоняю "на прогоне" со включенным монитором порта и включенным отладочным выводом - вижу и остатки памяти и фрагментацию. Ничего особо не дает для понимания.

Фро открытые файлы и пр. Насколько я помню LittleFS специально разработана таким образом, чтобы записанное сразу сохранялось и не портилось при внезапном пропадании питания / перезагрузке. Надежная файловая система.

Мудрое решение не трогать до НГ. Пусть так, но работает. А с новой версией - непонятно что. Пока выводы какие-то неутешительные...

С FastLED 3.4 заеданий текста практически нет - движется ровно, но...
С выключенными прерываниями - '#define FASTLED_ALLOW_INTERRUPTS 0' все выводится без задержек, но регулярно перезагружается с сообщением 'Exception 4: Level1Interrupt: Level-1 interrupt as indicated by set level-1 bits in the INTERRUPT register' где-то внутри ядра и периодически по WDT.

C '#define FASTLED_ALLOW_INTERRUPTS 1' - не падает, но постоянно горит первый диод.

На версиях 3.5/3.6 - текст дергается, диод первый то горит то не горит, падений меньше но есть, бывают замирания вывода на матрицу когда первый диод мерцает, остальные отображают предыдущую картинку.

Все это на ядре 3.1.2
Под стабильное ядро 2.7.4 - не собирается - говорит что программа не влазит в сегменты выделенной памяти.

Такая вот печальная история на данный момент.
Снова пытаюсь подобрать комбинации версий ядра и FastLED, опций компиляции...
Мне тут давно советовали бросить ESP8266 и уже писать только ориентируясь на ESP32

Там вроде более-менее все стабильно и без внезапных перезагрузок на ядре 2.0.14...

saippuakauppias, 2023-12-31:
> Мне тут давно советовали бросить ESP8266 и уже писать только ориентируясь на ESP32

Учитывая разницу в стоимости между ними в 150-200 рублей – как будто для конечного потребителя ничего не изменится в суммарной цене (лента всё равно сильно дороже МК).
Закинул донат на карту для покупки нескольких ESP32, авось и вправду можно на них отточить всё до идеала :)

vvip-68, 2023-12-31:
Спасибо за поддержку! :)

saippuakauppias, 2023-12-31:
Забыл дописать в предыдущем комментарии :)
Как временное решение – можно ещё добавить отдельную конфигурациионную настройку "через сколько эффектов подряд перезагружать МК", чтобы уменьшить количество сбоев

vvip-68, 2023-12-31:
Тут лучше по времени, скажем, в 4 утра.. Но бесполезно.
Вот вчера написал, что нашел лучший вариант - ядро 3.1.2 и FastLED 3.4 с запретом на прерывания.
Пока писал - вроде нормально все было. Потом перезагрузки начались каждые 10 минут Exception 4: Level1Interrupt: Level-1 interrupt as indicated by set level-1 bits in the INTERRUPT register'

По итогу сейчас снова - FastLED 3.6, запрет на прерывания отсутствует. С утра крутится без падений. Текст бежит ровно. Может что еще в настройках компиляции поменял - не помню. Разве что частоту процессора со 160 вернул на 80.
А вчера на такой же конфигурации за исключением частоты - постоянные фризы эффектов и мерцание первого диода. Еще вчера роуутер дурил. Может от сети что-то зависит...

saippuakauppias, 2023-12-31:
А если от сети зависит, то может тогда выключать wi-fi спустя 5 минут после запуска (если не было подключения через веб-интерфейс)? Ну и само собой включать-выключать его когда идет запрос за погодой/временем (но возможно это делается прямо перед запуском эффекта и тут много доработок потребуется).

Сделать, например, тактовую кнопку, которая будет включать wi-fi на следующие 5 минут, ожидать подключения и потом снова отключать его. У меня тоже были мысли что это из-за сети может быть, но ни подтвердить, ни опровергнуть никак не могу :(

vvip-68, 2023-12-31:
Ну это извращение какое-то. То есть, когда я захочу подключиться к гирлянде что-то изменить, я не смогу этого сделать совсем или мне придется идти на балкон давить на кнопку? Да ну, бред какой-то...

Тут только наблюдением и вычислением совпадений. Чтобы выявить причинно-следственную связь.
И все равно у меня нет рецепта - сделать то-то и то-то. Там в меню "Инструменты" только параметров штук 5, которые могут влиять. А уж сколько комбинаций, да еще для различных версий библиотек. Плюс внешние непредсказуемые условия Тут как повезет вычислить наиболее стабильную комбинацию.

saippuakauppias, 2023-12-31:
Это да, итоговым решением назвать такое сложно, скорее как быстрый хак чтоб ещё сузить предполагаемые проблемы, на постоянку такое не очень, согласен

saippuakauppias, 2024-01-01:
Добрый вечер и с наступившим новым годом!)

Пока что не перепрошивал контроллер, а ограничился наблюдением. Вчера весь вечер погода была до -10 градусов (скорее всего в корпусе чуть теплее), а сегодня уже -20. Вчера ни разу за 9 часов ничего не зависло, а сегодня за уже 6 часов – 2 раза :)

Причем в этот раз зависает как-то интересно: эффекты меняются через какое-то странное время (установленно время смены эффекта 20 секунд), диоды все меняются одновременно и без задержек, а вот проход по кадрам внутри самого эффекта – тормозит. Само собой wi-fi отваливается в этот момент. Всё таки грешу на погодные условия и подумываю о том, чтоб поискать какой-нибудь обогревающиий элемент в корпус, который от 5В запитать можно.

Даже видео в этот раз записал: https://youtu.be/sxOXLpYAws0

vvip-68, 2024-01-02:
Так то по даташиту микроконтроллер должен работать от -40... Вот для ленты - нижняя заявленная граница -25....
У меня две зимы гирлянда на неотапливаемом балконе отвисела и в -30 работало...  Ну что ж - экспериментируйте....

Closed 2024-01-09.

Thread 54 (2024-01-05):

Эффекты с СД карты

Foxtrot80, 2024-01-05:
Заметил, что короткие эффекты с СД карты не повторяет до конца смены эффекта, проигрывает один раз и следующий. Все настройки выставлены в вебе. У всех так?

Closed 2024-01-05.

Thread 55 (2024-01-13):

Установка на esp32-s2

didos06, 2024-01-13:
Наверное самая подходящая плата для этого проекта - esp32-s2 mini. Размер как у D1 mini, при этом цена не на много больше, в отличие от других версий esp32. Прошивка установилась, правда плагин little fs из инструкции не подходит, эта плата не поддерживается. Использовал  [это](https://github.com/lorol/arduino-esp32fs-plugin).
Использовал Arduino ide1.8.14, ядро 2.0.14, поскольку Arduino ide2.x плагины вообще не поддерживает.
 Вроде всё работает. Правда у меня самая простая схема - матрица и обычная кнопка. Все эффекты работают, "дождь" тупит иногда.
Важное дополнение по схеме - большинство проблем с артефактами решает установка резистора 2-10 кОм. между пином ленты и Gnd, даже самые проблемные ленты(светодиоды) отлично работают, тогда как ухищрения с конденсатором, уменьшением питания до 4,8В , диодом и последовательным резистором не помогали.
По web интерфейсу - при выборе эффекта из списка вручную - после перезагрузки он не запоминается пока не подвигаешь переключатель автосмены или случайного выбора. Если выбирать кнопками назад, вперёд то выбранный эффект сохраняется.

vvip-68, 2024-01-13:
ESP32-S2 уж точно не самая лучшая плата. По крайней мере на этапе ввода в эксплуатацию
Во первых она одноядерная в отличии от нормальной ESP32-d1-mini, к примеру.
Во вторых в ней памяти в два раза меньше по сравнению с (по крайней мере то что отображается в логе в мониторе порта).
В прошивку ее нужно вводить только вручную, нажимая кнопки. Из прошивки тоже выводить вручную, опять же нажимая кнопку сброса.
При прошивке она садится на один COM-порт, к примеру COM11, в режиме наблюдения при нормальной работе скетча - на COM12

Зато если в обычную ESP32 на 4M скетч уже не помещается при "все включено", в S2 еще остается немного свободного места. Из за этого на текущий момент в ESP32 приходится отключать поддержку ОТА.
Видимо придется выкидывать какие-то эффекты типа Анимация и Погода для освобождения памяти или брать платки на 8/16 мегабайт...

В ветке main 1.14 в эффектах traffic ошибка, которая на неквадратных матрицах может крашить систему. В нем же и еще в паре - не освобождается память. Эффект Дождь, кстати, довольно прожорлив по памяти...

Все это и исправление про незапоминающийся эффект уже лежит в ветке ntp_lwip, которая все еще в разработке, но по крайней мере эти ошибки там исправлены, проделана некоторая оптимизация, которая, надеюсь, приведет к более стабильной работе. Но, вполне вероятно,  добавлены и какие-то новые ошибки тоже...

didos06, 2024-01-13:
Да я по цене её сравнивал с Wemos D1 mini,   она самую малость дороже. С нормальной esp32(которая уже ощутимо дороже )всё правильно, она уступает количеством ядер, правда у неё оно посвежее.Да и чипы разные могут китайские друзья подсунуть, с меньшей памятью(правильный ESP32-S2FN4R2). Да и по портам прыгает - неудобство конечно, походу из-за встроенного  USB.

vvip-68, 2024-01-14:
Когда я писал про память - имелось в виду оперативная память. 520K против 320K. Память никогда лишней не бывает. Вон на Wemos ее всего 160K и уже как-то ощущается нехватка...

По цене. Примерно 180р у ESP32S2 против 350р у ESP32. Ну для школьника может и существенная разница (в два раза!!!) или при больших партиях закупать. А для среднестатистического DIY-щика - да он на пиво/сигареты больше тратит в разы...

didos06, 2024-01-14:
Поставил последнюю из ntp_lwip. В web интерфейсе несколько нижних эффектов местами перепутаны. Пока тестирую.

vvip-68, 2024-01-14:
Да, я знаю. Потому она и не в релизе. Думаю как более просто поставить их на место, чтобы без глобальных переделок.
Там еще кучка глюков, которые я периодически вылавливаю и исправляю. Сегодня вот поправил - строки в backup не сохранялись / не восстанавливались...

Хужее всего, что нестабильно работает трансляция в режиме группового вещания.  Как-то все с дерганием.
Вне этого режима вроде гладко, а  групповая синхронизация - просто увы. :(

Еще не могу подобрать нормально работающие библиотеки WebServer`a. Пробовал 4 разные, но какие-то просто в процессе работы "зависают" и web-сервер перестаёт отвечать, а иногда и пинговаться даже. Некоторые постоянно рвут связь со страничкой. Некоторые столько места занимают, что прошивка уже в память не влазит.

В общем - пока не очень стабильно. Всё в разработке. Но если есть желание потестить и найдете какие-то баги - welcome, сообщайте. И следите за обновлениями.

Если обновляется WebUI - необходимо сбрасывать кэш браузера или хотя бы обновлять страничку через Ctrl-Shift-R мли Ctrl-5, иначе файлы будут браться из кэша с диска, а не загружаться с устройства. Тогда страничка будет неправильно отображаться или даже вовсе не загрузится...

vvip-68, 2024-01-14:
@didos06 - исправил порядок эффектов. Если интересно - обновите, в том числе и файловую систему.
Перед обновлением если есть SD-карта - лучше сохранить на нее текущие настройки, потом восстановите после обновления. С самими настройками вроде ничего случиться не должно, а вот текст бегущей строки будет стёрт. Он хранится в файловой системе - а она заменяется на новую при обновлении.  Сохраненные в файловой системе настройки тоже будут потеряны.  А вот с SD-картой ничего не делается - на ней сохраненные настройки остаются нетронутыми.

didos06, 2024-01-14:
Обновил. Порядок поправился. Ещё на предыдущей заметил - при выключении ночных часов автосмена включается. И не пойму каким цветом дождь задумывался? Уменьшаешь контраст - он синий, прибавляешь - какой-то разноцветный. Причём это ещё и от общей яркости зависит.

vvip-68, 2024-01-15:
Ночные часы. Дда, включается автосмена. Потому что команда "Включить ночные часы" в API есть - '$14 3' - то есть включить "специальный режим", а вто команды выключить ночные часы - нет. Они выключаются отправкой команды API "включить демо-режим". Как-то так сложилось исторически. Ну, если это реально сильно мешает - подумаю над добавлением новой команды...

Про температуру - е понял. Как это воспроизвести?
Включаю ночные часы (кнопка в интерфейсе). Текущий эффект сменяется на отображение ночных цветов (у меня красный). Еще раз тыкаю на кнопку. Включается какой-то из режимов. Погода из красной в часах становится синей (сейчас минусовые температуры). Опишите последовательность действий, приводящих к тому, что температура оставалось бы красной. оставалась

По Дождю. Эффект не мой, цельнотянутый давно откуда-то, уже не помню.
Насколько я понимаю задумку - в эффекте используются все оттенки голубого - от темных к синему / цвету морской волны, до светлых. Капли - больше к белому, но тоже из серии голубых оттенков.
Изменение контрастности - по сути то же изменение яркости  эффекта по отношению к яркости часов.
Вполне естественно, что уменьшение яркости делает светлые сине/зеленые оттенки более темными - то есть цвета уходят в область синих/зеленых. Неяркие компоненты цвета RGB - в частности К и относительно - G, в силу особенности строения светодиодов - вообще перестают светиться, оставляя на матрице синий рисунок.

Ну, это мое понимание как это работает. Но такое поведение цвета - оно общее для всех эффектов. Это принцип работы светодиода. С уменьшением яркости остаются только более яркие компоненты цвета. Красный вообще светится даже когда чисто-белый цвет с равным значением компонент R,G,B - G и B уже погасли, К продолжает светиться.
Диоды серии WS2812 вообще не лучшие в этом плане. У них ШИМ- регулировка яркости  достаточно низкочастотный.

vvip-68, 2024-01-15:
@didos06 - я добавил отдельную команду выключения ночных часов в API

Нужно обновить не только саму прошивку, но и файлы странички (загрузка файловой системы), т.к. при нажатии на кнопку "Выключить ночные часы" теперь будет отправляться другая команда.

Нужно очистить кэш браузера (или хотя бы обновить страничку Ctrl-Shift-R)? чтобы код странички загрузился из контроллера, а не из кэша браузера с диска компьютера / телефона

didos06, 2024-01-15:
С температурой такая хрень происходит только когда выключен случайный выбор. Сначала не понял, решил для чистоты эксперимента прошить всё тоже самое начисто. Запустил - нормально всё с температурой. И как только отключил случайный выбор всё повторилось.

7918514, 2024-01-15:
> Важное дополнение по схеме - большинство проблем с артефактами решает установка резистора 2-10 кОм. между пином ленты и Gnd, даже самые проблемные ленты(светодиоды) отлично работают, тогда как ухищрения с конденсатором, уменьшением питания до 4,8В , диодом и последовательным резистором не помогали.

То есть управляющий пин ленты подтянуть через резистор к земле? Интересненько. Спасибо за информацию, первый раз слышу о таком!

vvip-68, 2024-01-16:
@didos06
>С температурой такая хрень происходит только когда выключен случайный выбор. Сначала не понял, решил для чистоты эксперимента прошить всё тоже самое начисто. Запустил - нормально всё с температурой. И как только отключил случайный выбор всё повторилось.

Все равно не могу воспроизвести ошибку. Как только отключаешь ночные часы - всё восстанавливается, все цвета в норме.

didos06, 2024-01-16:
Так на последней ошибка ушла. Была на предыдущей, при отключённом случайном выборе. Теперь ночные часы корректно отключаются.

didos06, 2024-01-16:
Ещё вопрос, предложение, хотелка. Матрица 32х16. Эффект часы - вверху часы, внизу температура. А можно чтобы бегущая строка вместо температуры снизу пробегала, а сами часы на месте оставались? Строка пробежала - температура на место вернулась. И на матрицы 16х16 тоже бы подошло.

vvip-68, 2024-01-17:
Можно подумать как это организовать... На 16x16 будет некрасиво смотреться, когда часы прилеплены кверху, температура к низу матрицы, между ними пустота. Иначе бегучка не влезет или часы "прыгать" вверх-вниз будут

Closed 2024-01-24.

Thread 56 (2024-01-13):

пропажа бегущей строки

bdu1977, 2024-01-13:
бегущие строки у меня есть как простые, так и со скриптами. автосмена эффектов стоит через 60 сек, показ бегущей строки через 45 сек. до нового года бегущие строки показывались все и простые и со скриптами. а недавно заметил, что бегущая строка не отображается. при нажатии в приложении кнопки просмотр, строка выводится, но дальнейшего показа нету. как вернуть показ бегущей строчки?

vvip-68, 2024-01-14:
Ну пока такая проблема только у вас наблюдается. Больше никто не заявлял. У меня проблем с бегущей строкой не наблюдается. Значит это конкретно вашу систему смотреть нужно.

Не выключился ли общий флажок на страничке "Тексты" - "Текст поверх эффектов"?
Не выключился ли "Бегущая строка поверх эффекта" в настройках каждого конкретного эффекта?
Какая конкретно версия прошивки стоит?

Если версия из ветки разработчика, а не из "main" в репозитории - там поменялась карта распределения памяти хранения настроек - настройки эффектов (да и параметров в целом) нужно выполнить с нуля.

bdu1977, 2024-01-14:
прошивка 1,13 стоит из папки "main"
"текст поверх эффектов" - галка стоит
 "Бегущая строка поверх эффекта" в настройках каждого конкретного эффекта - оставлено только на тех эффектах где хотел бы видеть "бегущую строку". может есть где-то настройка, что бегущая строка в приоритете - и тогда все равно какой включен эффект, если подошло время показать строку, то она включается, не зависимо от эффекта.
но опять же до НГ все работало, а тут пропало.
попробую еще все настройки перенастроить с нуля, но это будет чуть позже.

vvip-68, 2024-01-14:
Ну, 1.13 уже давно никто не трогал. Не знаю что с ней могло случиться.

Thread 58 (2024-02-01):

Connection lost - WEB

Andriejus, 2024-02-01:
Hi. Sometimes im loosing connection on WEB and i get these messages in serial port. Could someone give me advice what could be wrong?
ESP32 WROOM.
P.S. I undestand Russian language.

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

vvip-68, 2024-10-25:
Как выяснилось в ходе экспериментов в последнее время, лично у меня, постоянные Connection Lost в  Web-интерфейсе случились из за неверной библиотеки ESPAsyncWebServer - она у меня стояла не из папки проекта, а какая-то экспериментально-случайная. Поменял на библиотеку из папки проекта - все проблемы с потерей соединения ушли.
Какая библиотека стоит у вас?

Все сообщения в логе "Too many messages" как правило (если не появляются постоянно) значения не имеют. При первой попытки соединиться с контроллером веб-страница шлет одноразово довольно много запросов и чать из них не успевает обрабатываться и переполняют очередь (с выводом в лог данного сообщения). Но Web-страница довольно умна, чтобы не получив ответ на запрос - отправить его повторно. То есть через короткий промежуток времени все данные, необходимые для работы WebUI все равно будут получены.

26.10.2024 я обновил версию в репозитории - в ней исправлено получение погоды с серверов Yandex.
Попробуйте ее - может быть и эта проблема тоже как-нибудь уйдет...

Closed 2024-10-25.

Thread 59 (2024-02-11):

DFplayer mp3

Andriejus, 2024-02-11:
Hi. In order to get sound from speaker i have to press "Show" two times. Why mp3 player does not react when Im pressing this button only one time? Any ideas?

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

vvip-68, 2024-02-11:
In fact you have an empty string. After processing sound macros and exclude them from text, you get quite empty string - nothing to display. In this sense you shouldn`t hear any sound at all. That fact that you hear something after second click on 'Show' button - definitely the bug. You must not hear anything in your case. Probably you hear sound by the transition process between one empty string stopping and next (second press) empty string that will not be shown.

What happening if you put into text something else except {A} macros?

vvip-68, 2024-02-11:
It is really bug with no plat sound on first click 'Show' / first time show text. :(
I found it. Thank you. Will be fixed in next version published in this project storage.

vvip-68, 2024-02-15:
I fixed this issue in version WiFiPanel v.1.14с.2024.0215. It is uploaded into GitHub storage. Should work now. Need to check.

Andriejus, 2024-02-18:
> I fixed this issue in version WiFiPanel v.1.14с.2024.0215. It is uploaded into GitHub storage. Should work now. Need to check.

Thanks. It works now!

Closed 2024-02-15.

Thread 60 (2024-02-15):

нехватки памяти ?

Andriejus, 2024-02-15:
Hi, is everything OK here with memory? What "FM" means? :)

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

vvip-68, 2024-02-15:
"FM: is "Free Memory' - getting value iia call of ESP.getFreeHeap(); "Max" is size of maximal available continuous block of memory in Heap - ESP.getMaxAllocHeap()

According to log you have enough memory for sketch needs

Closed 2024-02-18.

Thread 62 (2024-06-09):

Часовой пояс

ferakond, 2024-06-09:
Контроллер сбрасывает настройки времени. Примерно раз в час, и при перезагрузке. Настраивал часовой пояс в веб интерфейсе. С прошлой версией такой проблемы не было.

vvip-68, 2024-10-25:
Долгое время не заглядывал в проект... Извините за долгий ответ. Может уже и не нужно, но все же...
Да, видимо с выбором зоны какой-то косяк в прошивке - посмотрю / поправлю.
Пока же - найдите в настройках параметр типа этого:

#define TZONE PSTR("253_<+07>-7")

и укажите там зону для Иркутска - 243_<+08>-8

Зоны для других городов - в папке /data/web/assets/ есть файл tz-rus.json.gz - внутри него json файл со списком городов и временнЫх зон. Найти свой город, соответствующую ему временнУю зону и прописать в скетче.

vvip-68, 2024-10-25:
В версии от 26.10.2024 исправлено

Closed 2024-10-25.

Thread 65 (2024-07-29):

Compilation error: 'LINEARBLEND_NOWRAP' was not declared in this scope

hhrhhr, 2024-07-29:
Делаю всё по инструкции, при компиляции столкнулся с ошибкой, указанной в названии.
Поиск по исходникам выдаёт использование макроса LINEARBLEND_NOWRAP только в файле \firmware\LedPanelWiFi_v1.14\effects2.ino, но нигде нет определения этого макроса.

https://github.com/vvip-68/LedPanelWiFi/blob/3188ed6ae6a00728cfecc67b09c90ecbc58be045/firmware/LedPanelWiFi_v1.14/effects2.ino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

hhrhhr, 2024-07-29:
> не та версия FastLED используется

[Из вики](https://github.com/vvip-68/LedPanelWiFi/wiki/Пошаговая-инструкция-подготовки-среды-и-сборка-проекта):
_A строке поиска наберите "FastLED" Выберите блок "FastLED by Daniel Garcia"
Выберите версию библиотеки **3.5.0**_

Из README.MD
_Данный проект рассчитан на работу с версиями ядра плат ESP8266 версии 3.1.2, ESP32 версии 1.0.6 и библиотеки FastLED версии **3.5.0**;_

Из FAQ:
_**О**: Это стандартная библиотека для FastLED для управления адресными светодиодами. Идите в менеджер библиотек и установите ее. Версию библиотеки выбирайте **3.5** или 3.4;_

vvip-68, 2024-07-29:
Возможно в readme упустили, не актуализировали...
Думаю стоит ориентироваться на это:
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

hhrhhr, 2024-07-29:
Да, с FastLED 3.6 сборка прошла. Однако в версиях ниже 3.6 макроса LINEARBLEND_NOWRAP не существует, то есть комментарии про 3.4-3.5 уже не актуальны (без правки кода effects2.ino).

vvip-68, 2024-07-29:
Да, не актуальны... Надо будет как-нибудь поправить...

Closed 2024-07-29.

Thread 66 (2024-08-07):

Перестала работать погода от Яндекса.

didos06, 2024-08-07:
У Яндекса что-то поменялось что-ли? Погоду перестала панель показывать. Два устройства в виде часов с погодой использую, ни одно погоду не показывает от Яндекса. Open weather работает.

vvip-68, 2024-08-08:
Да, поменялось. Он перестал отдавать погоду по HTTP. Теперь хочет исключительно HTTPS.
Работать с HTTPS я не умею. Если у кого есть пример рабочего кода для получения данных по HTTPS именно от Яндекса (и инструкция как настроить) - пишите, поправим.

Closed 2024-08-08.

Thread 70 (2024-10-06):

Обновление

bulava92, 2024-10-06:
добрый день
попытался установить данную прошивку взамен старой - постоянно ругается на настройки в 49 строке. пересмотрел всё что можно, ничего не нашел, в чем дело может быть? вообще ругается на отсутствие файла

старая прошивка накатывается без проблем, но через несколько дней после использования начинает хаотично перезагружаться каждые 5-60 минут

vvip-68, 2024-10-06:
Вы полагаете, что без текста ошибки вам кто-нибудь ответит что-нибудь вразумительное? Не думаю...
Обычно либо прошивка сразу работает с глюками и так-сяк, либо работает. А тут без дополнительной информации - да кто ж его знает то?

Вообще, эта прошивка все еще в стадии экспериментальной и не рекомендуемой. Ее веб-интерфейс работает нестабильно и на разных платах (и в разных конфигурациях) зачастую по-разному. От более менее-стабильной работы, до постоянных отваливания связи. Так что опять не рекомендую. На свой страх и риск.

Перезагружаться хаотично может если включена погода, потому что по факу оно больше не работает. Яндекс перестал отдавать погоду по протоколу http еще 28 июля,  а OpenWeastherMap - стал отдавать ее один раз из трех. И когда прошивка не может получить погоду - оно периодически перезагружается. Попробуйте отключить погоду вообще.

Closed 2024-10-25.

Thread 76 (2024-10-31):

ошибка при компиляции

Den19081981, 2024-10-31:
вот такая ошибка в строках 433-434 в effekts2.ino,как поправить

if      (firework[i].the_figMode == 0) drawCircleBlend    (firework[i].the_figX, firework[i].the_figY, firework[i].the_figSize, ColorFromPalette( myRainbow_p, firework[i].the_figHue, (firework[i].the_figSize > firework[i].the_figSizeMax / 2) ? effectBrightness - effectBrightnessFaded : effectBrightness, LINEARBLEND_NOWRAP));
      else if (firework[i].the_figMode == 1) drawSnowflakesBlend(firework[i].the_figX, firework[i].the_figY, firework[i].the_figSize, ColorFromPalette( myRainbow_p, firework[i].the_figHue, (firework[i].the_figSize > firework[i].the_figSizeMax / 2) ? effectBrightness - effectBrightnessFaded : effectBrightness, LINEARBLEND_NOWRAP));

vvip-68, 2024-10-31:
Установить вместо случайной рекомендуемую версию FastLED/ Рекомендуемая - 3.6.0

Closed 2024-10-31.

Thread 77 (2024-10-31):

как с этим бороться

Den19081981, 2024-10-31:
In file included from C:\Users\deniscekanov09\AppData\Local\Arduino15\packages\esp8266\hardware\esp8266\3.1.2\libraries\ESP8266WebServer\src/ESP8266WebServer

vvip-68, 2024-10-31:
Это замечательно!

Den19081981, 2024-10-31:
как это победить ошибка выскакивает

vvip-68, 2024-10-31:
В этом сообщении нет никакой ошибки.

Den19081981, 2024-10-31:
215 | void ESP8266WebServerTemplate<ServerType>::requestAuthentication(HTTPAuthMethod mode, const char* realm, const String& authFailMsg) {
      |      ^~~~~~~~~~~~~~~~~~~~~~~~~~~~~~~~~~~~
In file included from C:\Users\deniscekanov09\AppData\Local\Arduino15\packages\esp8266\hardware\esp8266\3.1.2\libraries\ESP8266WebServer\src/ESP8266WebServer.h:349,
                 from C:\Users\deniscekanov09\AppData\Local\Arduino15\packages\esp8266\hardware\esp8266\3.1.2\libraries\ESP8266WebServer\src/ESP8266WebServer-impl.h:27,
                 from D:\Users\deniscekanov09\Desktop\гирлянда на окно\LedPanelWiFi-main\LedPanelWiFi-main\firmware\LedPanelWiFi_v1.14\a_def_hard.h:1,
                 from D:\Users\deniscekanov09\Desktop\гирлянда на окно\LedPanelWiFi-main\LedPanelWiFi-main\firmware\LedPanelWiFi_v1.14\LedPanelWiFi_v1.14.ino:290:
C:\Users\deniscekanov09\AppData\Local\Arduino15\packages\esp8266\hardware\esp8266\3.1.2\libraries\ESP8266WebServer\src/ESP8266WebServer-impl.h:215:6: note: 'void esp8266webserver::ESP8266WebServerTemplate<ServerType>::requestAuthentication(HTTPAuthMethod, const char*, const String&)' previously declared here
  215 | void ESP8266WebServerTemplate<ServerType>::requestAuthentication(HTTPAuthMethod mode, const char* realm, const String& authFailMsg) {
      |      ^~~~~~~~~~~~~~~~~~~~~~~~~~~~~~~~~~~~
In file included from D:\Users\deniscekanov09\Desktop\гирлянда на окно\LedPanelWiFi-main\LedPanelWiFi-main\firmware\LedPanelWiFi_v1.14\a_def_hard.h:1,
                 from D:\Users\deniscekanov09\Desktop\гирлянда на окно\LedPanelWiFi-main\LedPanelWiFi-main\firmware\LedPanelWiFi_v1.14\LedPanelWiFi_v1.14.ino:290:
C:\Users\deniscekanov09\AppData\Local\Arduino15\packages\esp8266\hardware\esp8266\3.1.2\libraries\ESP8266WebServer\src/ESP8266WebServer-impl.h:233:6: error: redefinition of 'void esp8266webserver::ESP8266WebServerTemplate<ServerType>::on(const Uri&, esp8266webserver::ESP8266WebServerTemplate<ServerType>::THandlerFunction)'
  233 | void ESP8266WebServerTemplate<ServerType>::on(const Uri &uri, ESP8266WebServerTemplate<ServerType>::THandlerFunction handler) {
      |      ^~~~~~~~~~~~~~~~~~~~~~~~~~~~~~~~~~~~
In file included from C:\Users\deniscekanov09\AppData\Local\Arduino15\packages\esp8266\hardware\esp8266\3.1.2\libraries\ESP8266WebServer\src/ESP8266WebServer.h:349,
                 from C:\Users\deniscekanov09\AppData\Local\Arduino15\packages\esp8266\hardware\esp8266\3.1.2\libraries\ESP8266WebServer\src/ESP8266WebServer-impl.h:27,
                 from D:\Users\deniscekanov09\Desktop\гирлянда на окно\LedPanelWiFi-main\LedPanelWiFi-main\firmware\LedPanelWiFi_v1.14\a_def_hard.h:1,
                 from D:\Users\deniscekanov09\Desktop\гирлянда на окно\LedPanelWiFi-main\LedPanelWiFi-main\firmware\LedPanelWiFi_v1.14\LedPanelWiFi_v1.14.ino:290:
C:\Users\deniscekanov09\AppData\Local\Arduino15\packages\esp8266\hardware\esp8266\3.1.2\libraries\ESP8266WebServer\src/ESP8266WebServer-impl.h:233:6: note: 'void esp8266webserver::ESP8266WebServerTemplate<ServerType>::on(const Uri&, esp8266webserver::ESP8266WebServerTemplate<ServerType>::THandlerFunction)' previously declared here
  233 | void ESP8266WebServerTemplate<ServerType>::on(const Uri &uri, ESP8266WebServerTemplate<ServerType>::THandlerFunction handler) {
      |      ^~~~~~~~~~~~~~~~~~~~~~~~~~~~~~~~~~~~
In file included from D:\Users\deniscekanov09\Desktop\гирлянда на окно\LedPanelWiFi-main\LedPanelWiFi-main\firmware\LedPanelWiFi_v1.14\a_def_hard.h:1,
                 from D:\Users\deniscekanov09\Desktop\гирлянда на окно\LedPanelWiFi-main\LedPanelWiFi-main\firmware\LedPanelWiFi_v1.14\LedPanelWiFi_v1.14.ino:290:
C:\Users\deniscekanov09\AppData\Local\Arduino15\packages\esp8266\hardware\esp8266\3.1.2\libraries\ESP8266WebServer\src/ESP8266WebServer-impl.h:238:6: error: redefinition of 'void esp8266webserver::ESP8266WebServerTemplate<ServerType>::on(const Uri&, HTTPMethod, esp8266webserver::ESP8266WebServerTemplate<ServerType>::THandlerFunction)'
  238 | void ESP8266WebServerTemplate<ServerType>::on(const Uri &uri, HTTPMethod method, ESP8266WebServerTemplate<ServerType>::THandlerFunction fn) {
      |      ^~~~~~~~~~~~~~~~~~~~~~~~~~~~~~~~~~~~
In file included from C:\Users\deniscekanov09\AppData\Local\Arduino15\packages\esp8266\hardware\esp8266\3.1.2\libraries\ESP8266WebServer\src/ESP8266WebServer.h:349,
                 from C:\Users\deniscekanov09\AppData\Local\Arduino15\packages\esp8266\hardware\esp8266\3.1.2\libraries\ESP8266WebServer\src/ESP8266WebServer-impl.h:27,
                 from D:\Users\deniscekanov09\Desktop\гирлянда на окно\LedPanelWiFi-main\LedPanelWiFi-main\firmware\LedPanelWiFi_v1.14\a_def_hard.h:1,
                 from D:\Users\deniscekanov09\Desktop\гирлянда на окно\LedPanelWiFi-main\LedPanelWiFi-main\firmware\LedPanelWiFi_v1.14\LedPanelWiFi_v1.14.ino:290:
C:\Users\deniscekanov09\AppData\Local\Arduino15\packages\esp8266\hardware\esp8266\3.1.2\libraries\ESP8266WebServer\src/ESP8266WebServer-impl.h:238:6: note: 'void esp8266webserver::ESP8266WebServerTemplate<ServerType>::on(const Uri&, HTTPMethod, esp8266webserver::ESP8266WebServerTemplate<ServerType>::THandlerFunction)' previously declared here
  238 | void ESP8266WebServerTemplate<ServerType>::on(const Uri &uri, HTTPMethod method, ESP8266WebServerTemplate<ServerType>::THandlerFunction fn) {
      |      ^~~~~~~~~~~~~~~~~~~~~~~~~~~~~~~~~~~~
In file included from D:\Users\deniscekanov09\Desktop\гирлянда на окно\LedPanelWiFi-main\LedPanelWiFi-main\firmware\LedPanelWiFi_v1.14\a_def_hard.h:1,
                 from D:\Users\deniscekanov09\Desktop\гирлянда на окно\LedPanelWiFi-main\LedPanelWiFi-main\firmware\LedPanelWiFi_v1.14\LedPanelWiFi_v1.14.ino:290:
C:\Users\deniscekanov09\AppData\Local\Arduino15\packages\esp8266\hardware\esp8266\3.1.2\libraries\ESP8266WebServer\src/ESP8266WebServer-impl.h:243:6: error: redefinition of 'void esp8266webserver::ESP8266WebServerTemplate<ServerType>::on(const Uri&, HTTPMethod, esp8266webserver::ESP8266WebServerTemplate<ServerType>::THandlerFunction, esp8266webserver::ESP8266WebServerTemplate<ServerType>::THandlerFunction)'
  243 | void ESP8266WebServerTemplate<ServerType>::on(const Uri &uri, HTTPMethod method, ESP8266WebServerTemplate<ServerType>::THandlerFunction fn, ESP8266WebServerTemplate<ServerType>::THandlerFunction ufn) {
      |      ^~~~~~~~~~~~~~~~~~~~~~~~~~~~~~~~~~~~
In file included from C:\Users\deniscekanov09\AppData\Local\Arduino15\packages\esp8266\hardware\esp8266\3.1.2\libraries\ESP8266WebServer\src/ESP8266WebServer.h:349,
                 from C:\Users\deniscekanov09\AppData\Local\Arduino15\packages\esp8266\hardware\esp8266\3.1.2\libraries\ESP8266WebServer\src/ESP8266WebServer-impl.h:27,
                 from D:\Users\deniscekanov09\Desktop\гирлянда на окно\LedPanelWiFi-main\LedPanelWiFi-main\firmware\LedPanelWiFi_v1.14\a_def_hard.h:1,
                 from D:\Users\deniscekanov09\Desktop\гирлянда на окно\LedPanelWiFi-main\LedPanelWiFi-main\firmware\LedPanelWiFi_v1.14\LedPanelWiFi_v1.14.ino:290:
C:\Users\deniscekanov09\AppData\Local\Arduino15\packages\esp8266\hardware\esp8266\3.1.2\libraries\ESP8266WebServer\src/ESP8266WebServer-impl.h:243:6: note: 'void esp8266webserver::ESP8266WebServerTemplate<ServerType>::on(const Uri&, HTTPMethod, esp8266webserver::ESP8266WebServerTemplate<ServerType>::THandlerFunction, esp8266webserver::ESP8266WebServerTemplate<ServerType>::THandlerFunction)' previously declared here
  243 | void ESP8266WebServerTemplate<ServerType>::on(const Uri &uri, HTTPMethod method, ESP8266WebServerTemplate<ServerType>::THandlerFunction fn, ESP8266WebServerTemplate<ServerType>::THandlerFunction ufn) {
      |      ^~~~~~~~~~~~~~~~~~~~~~~~~~~~~~~~~~~~
In file included from D:\Users\deniscekanov09\Desktop\гирлянда на окно\LedPanelWiFi-main\LedPanelWiFi-main\firmware\LedPanelWiFi_v1.14\a_def_hard.h:1,
                 from D:\Users\deniscekanov09\Desktop\гирлянда на окно\LedPanelWiFi-main\LedPanelWiFi-main\firmware\LedPanelWiFi_v1.14\LedPanelWiFi_v1.14.ino:290:
C:\Users\deniscekanov09\AppData\Local\Arduino15\packages\esp8266\hardware\esp8266\3.1.2\libraries\ESP8266WebServer\src/ESP8266WebServer-impl.h:248:6: error: redefinition of 'void esp8266webserver::ESP8266WebServerTemplate<ServerType>::addHandler(esp8266webserver::ESP8266WebServerTemplate<ServerType>::RequestHandlerType*)'
  248 | void ESP8266WebServerTemplate<ServerType>::addHandler(RequestHandlerType* handler) {
      |      ^~~~~~~~~~~~~~~~~~~~~~~~~~~~~~~~~~~~
In file included from C:\Users\deniscekanov09\AppData\Local\Arduino15\packages\esp8266\hardware\esp8266\3.1.2\libraries\ESP8266WebServer\src/ESP8266WebServer.h:349,
                 from C:\Users\deniscekanov09\AppData\Local\Arduino15\packages\esp8266\hardware\esp8266\3.1.2\libraries\ESP8266WebServer\src/ESP8266WebServer-impl.h:27,
                 from D:\Users\deniscekanov09\Desktop\гирлянда на окно\LedPanelWiFi-main\LedPanelWiFi-main\firmware\LedPanelWiFi_v1.14\a_def_hard.h:1,
                 from D:\Users\deniscekanov09\Desktop\гирлянда на окно\LedPanelWiFi-main\LedPanelWiFi-main\firmware\LedPanelWiFi_v1.14\LedPanelWiFi_v1.14.ino:290:
C:\Users\deniscekanov09\AppData\Local\Arduino15\packages\esp8266\hardware\esp8266\3.1.2\libraries\ESP8266WebServer\src/ESP8266WebServer-impl.h:248:6: note: 'void esp8266webserver::ESP8266WebServerTemplate<ServerType>::addHandler(esp8266webserver::ESP8266WebServerTemplate<ServerType>::RequestHandlerType*)' previously declared here
  248 | void ESP8266WebServerTemplate<ServerType>::addHandler(RequestHandlerType* handler) {
      |      ^~~~~~~~~~~~~~~~~~~~~~~~~~~~~~~~~~~~
In file included from D:\Users\deniscekanov09\Desktop\гирлянда на окно\LedPanelWiFi-main\LedPanelWiFi-main\firmware\LedPanelWiFi_v1.14\a_def_hard.h:1,
                 from D:\Users\deniscekanov09\Desktop\гирлянда на окно\LedPanelWiFi-main\LedPanelWiFi-main\firmware\LedPanelWiFi_v1.14\LedPanelWiFi_v1.14.ino:290:
C:\Users\deniscekanov09\AppData\Local\Arduino15\packages\esp8266\hardware\esp8266\3.1.2\libraries\ESP8266WebServer\src/ESP8266WebServer-impl.h:253:6: error: redefinition of 'void esp8266webserver::ESP8266WebServerTemplate<ServerType>::_addRequestHandler(esp8266webserver::ESP8266WebServerTemplate<ServerType>::RequestHandlerType*)'
  253 | void ESP8266WebServerTemplate<ServerType>::_addRequestHandler(RequestHandlerType* handler) {
      |      ^~~~~~~~~~~~~~~~~~~~~~~~~~~~~~~~~~~~
In file included from C:\Users\deniscekanov09\AppData\Local\Arduino15\packages\esp8266\hardware\esp8266\3.1.2\libraries\ESP8266WebServer\src/ESP8266WebServer.h:349,
                 from C:\Users\deniscekanov09\AppData\Local\Arduino15\packages\esp8266\hardware\esp8266\3.1.2\libraries\ESP8266WebServer\src/ESP8266WebServer-impl.h:27,
                 from D:\Users\deniscekanov09\Desktop\гирлянда на окно\LedPanelWiFi-main\LedPanelWiFi-main\firmware\LedPanelWiFi_v1.14\a_def_hard.h:1,
                 from D:\Users\deniscekanov09\Desktop\гирлянда на окно\LedPanelWiFi-main\LedPanelWiFi-main\firmware\LedPanelWiFi_v1.14\LedPanelWiFi_v1.14.ino:290:
C:\Users\deniscekanov09\AppData\Local\Arduino15\packages\esp8266\hardware\esp8266\3.1.2\libraries\ESP8266WebServer\src/ESP8266WebServer-impl.h:253:6: note: 'void esp8266webserver::ESP8266WebServerTemplate<ServerType>::_addRequestHandler(esp8266webserver::ESP8266WebServerTemplate<ServerType>::RequestHandlerType*)' previously declared here
  253 | void ESP8266WebServerTemplate<ServerType>::_addRequestHandler(RequestHandlerType* handler) {
      |      ^~~~~~~~~~~~~~~~~~~~~~~~~~~~~~~~~~~~
In file included from D:\Users\deniscekanov09\Desktop\гирлянда на окно\LedPanelWiFi-main\LedPanelWiFi-main\firmware\LedPanelWiFi_v1.14\a_def_hard.h:1,
                 from D:\Users\deniscekanov09\Desktop\гирлянда на окно\LedPanelWiFi-main\LedPanelWiFi-main\firmware\LedPanelWiFi_v1.14\LedPanelWiFi_v1.14.ino:290:
C:\Users\deniscekanov09\AppData\Local\Arduino15\packages\esp8266\hardware\esp8266\3.1.2\libraries\ESP8266WebServer\src/ESP8266WebServer-impl.h:265:6: error: redefinition of 'void esp8266webserver::ESP8266WebServerTemplate<ServerType>::serveStatic(const char*, fs::FS&, const char*, const char*)'
  265 | void ESP8266WebServerTemplate<ServerType>::serveStatic(const char* uri, FS& fs, const char* path, const char* cache_header) {
      |      ^~~~~~~~~~~~~~~~~~~~~~~~~~~~~~~~~~~~
In file included from C:\Users\deniscekanov09\AppData\Local\Arduino15\packages\esp8266\hardware\esp8266\3.1.2\libraries\ESP8266WebServer\src/ESP8266WebServer.h:349,
                 from C:\Users\deniscekanov09\AppData\Local\Arduino15\packages\esp8266\hardware\esp8266\3.1.2\libraries\ESP8266WebServer\src/ESP8266WebServer-impl.h:27,
                 from D:\Users\deniscekanov09\Desktop\гирлянда на окно\LedPanelWiFi-main\LedPanelWiFi-main\firmware\LedPanelWiFi_v1.14\a_def_hard.h:1,
                 from D:\Users\deniscekanov09\Desktop\гирлянда на окно\LedPanelWiFi-main\LedPanelWiFi-main\firmware\LedPanelWiFi_v1.14\LedPanelWiFi_v1.14.ino:290:
C:\Users\deniscekanov09\AppData\Local\Arduino15\packages\esp8266\hardware\esp8266\3.1.2\libraries\ESP8266WebServer\src/ESP8266WebServer-impl.h:265:6: note: 'void esp8266webserver::ESP8266WebServerTemplate<ServerType>::serveStatic(const char*, fs::FS&, const char*, const char*)' previously declared here
  265 | void ESP8266WebServerTemplate<ServerType>::serveStatic(const char* uri, FS& fs, const char* path, const char* cache_header) {
      |      ^~~~~~~~~~~~~~~~~~~~~~~~~~~~~~~~~~~~
In file included from D:\Users\deniscekanov09\Desktop\гирлянда на окно\LedPanelWiFi-main\LedPanelWiFi-main\firmware\LedPanelWiFi_v1.14\a_def_hard.h:1,
                 from D:\Users\deniscekanov09\Desktop\гирлянда на окно\LedPanelWiFi-main\LedPanelWiFi-main\firmware\LedPanelWiFi_v1.14\LedPanelWiFi_v1.14.ino:290:
C:\Users\deniscekanov09\AppData\Local\Arduino15\packages\esp8266\hardware\esp8266\3.1.2\libraries\ESP8266WebServer\src/ESP8266WebServer-impl.h:282:6: error: redefinition of 'void esp8266webserver::ESP8266WebServerTemplate<ServerType>::handleClient()'
  282 | void ESP8266WebServerTemplate<ServerType>::handleClient() {
      |      ^~~~~~~~~~~~~~~~~~~~~~~~~~~~~~~~~~~~
In file included from C:\Users\deniscekanov09\AppData\Local\Arduino15\packages\esp8266\hardware\esp8266\3.1.2\libraries\ESP8266WebServer\src/ESP8266WebServer.h:349,
                 from C:\Users\deniscekanov09\AppData\Local\Arduino15\packages\esp8266\hardware\esp8266\3.1.2\libraries\ESP8266WebServer\src/ESP8266WebServer-impl.h:27,
                 from D:\Users\deniscekanov09\Desktop\гирлянда на окно\LedPanelWiFi-main\LedPanelWiFi-main\firmware\LedPanelWiFi_v1.14\a_def_hard.h:1,
                 from D:\Users\deniscekanov09\Desktop\гирлянда на окно\LedPanelWiFi-main\LedPanelWiFi-main\firmware\LedPanelWiFi_v1.14\LedPanelWiFi_v1.14.ino:290:
C:\Users\deniscekanov09\AppData\Local\Arduino15\packages\esp8266\hardware\esp8266\3.1.2\libraries\ESP8266WebServer\src/ESP8266WebServer-impl.h:282:6: note: 'void esp8266webserver::ESP8266WebServerTemplate<ServerType>::handleClient()' previously declared here
  282 | void ESP8266WebServerTemplate<ServerType>::handleClient() {
      |      ^~~~~~~~~~~~~~~~~~~~~~~~~~~~~~~~~~~~
In file included from D:\Users\deniscekanov09\Desktop\гирлянда на окно\LedPanelWiFi-main\LedPanelWiFi-main\firmware\LedPanelWiFi_v1.14\a_def_hard.h:1,
                 from D:\Users\deniscekanov09\Desktop\гирлянда на окно\LedPanelWiFi-main\LedPanelWiFi-main\firmware\LedPanelWiFi_v1.14\LedPanelWiFi_v1.14.ino:290:
C:\Users\deniscekanov09\AppData\Local\Arduino15\packages\esp8266\hardware\esp8266\3.1.2\libraries\ESP8266WebServer\src/ESP8266WebServer-impl.h:410:6: error: redefinition of 'void esp8266webserver::ESP8266WebServerTemplate<ServerType>::close()'
  410 | void ESP8266WebServerTemplate<ServerType>::close() {
      |      ^~~~~~~~~~~~~~~~~~~~~~~~~~~~~~~~~~~~
In file included from C:\Users\deniscekanov09\AppData\Local\Arduino15\packages\esp8266\hardware\esp8266\3.1.2\libraries\ESP8266WebServer\src/ESP8266WebServer.h:349,
                 from C:\Users\deniscekanov09\AppData\Local\Arduino15\packages\esp8266\hardware\esp8266\3.1.2\libraries\ESP8266WebServer\src/ESP8266WebServer-impl.h:27,
                 from D:\Users\deniscekanov09\Desktop\гирлянда на окно\LedPanelWiFi-main\LedPanelWiFi-main\firmware\LedPanelWiFi_v1.14\a_def_hard.h:1,
                 from D:\Users\deniscekanov09\Desktop\гирлянда на окно\LedPanelWiFi-main\LedPanelWiFi-main\firmware\LedPanelWiFi_v1.14\LedPanelWiFi_v1.14.ino:290:
C:\Users\deniscekanov09\AppData\Local\Arduino15\packages\esp8266\hardware\esp8266\3.1.2\libraries\ESP8266WebServer\src/ESP8266WebServer-impl.h:410:6: note: 'void esp8266webserver::ESP8266WebServerTemplate<ServerType>::close()' previously declared here
  410 | void ESP8266WebServerTemplate<ServerType>::close() {
      |      ^~~~~~~~~~~~~~~~~~~~~~~~~~~~~~~~~~~~
In file included from D:\Users\deniscekanov09\Desktop\гирлянда на окно\LedPanelWiFi-main\LedPanelWiFi-main\firmware\LedPanelWiFi_v1.14\a_def_hard.h:1,
                 from D:\Users\deniscekanov09\Desktop\гирлянда на окно\LedPanelWiFi-main\LedPanelWiFi-main\firmware\LedPanelWiFi_v1.14\LedPanelWiFi_v1.14.ino:290:
C:\Users\deniscekanov09\AppData\Local\Arduino15\packages\esp8266\hardware\esp8266\3.1.2\libraries\ESP8266WebServer\src/ESP8266WebServer-impl.h:418:6: error: redefinition of 'void esp8266webserver::ESP8266WebServerTemplate<ServerType>::stop()'
  418 | void ESP8266WebServerTemplate<ServerType>::stop() {
      |      ^~~~~~~~~~~~~~~~~~~~~~~~~~~~~~~~~~~~
In file included from C:\Users\deniscekanov09\AppData\Local\Arduino15\packages\esp8266\hardware\esp8266\3.1.2\libraries\ESP8266WebServer\src/ESP8266WebServer.h:349,
                 from C:\Users\deniscekanov09\AppData\Local\Arduino15\packages\esp8266\hardware\esp8266\3.1.2\libraries\ESP8266WebServer\src/ESP8266WebServer-impl.h:27,
                 from D:\Users\deniscekanov09\Desktop\гирлянда на окно\LedPanelWiFi-main\LedPanelWiFi-main\firmware\LedPanelWiFi_v1.14\a_def_hard.h:1,
                 from D:\Users\deniscekanov09\Desktop\гирлянда на окно\LedPanelWiFi-main\LedPanelWiFi-main\firmware\LedPanelWiFi_v1.14\LedPanelWiFi_v1.14.ino:290:
C:\Users\deniscekanov09\AppData\Local\Arduino15\packages\esp8266\hardware\esp8266\3.1.2\libraries\ESP8266WebServer\src/ESP8266WebServer-impl.h:418:6: note: 'void esp8266webserver::ESP8266WebServerTemplate<ServerType>::stop()' previously declared here
  418 | void ESP8266WebServerTemplate<ServerType>::stop() {
      |      ^~~~~~~~~~~~~~~~~~~~~~~~~~~~~~~~~~~~
In file included from D:\Users\deniscekanov09\Desktop\гирлянда на окно\LedPanelWiFi-main\LedPanelWiFi-main\firmware\LedPanelWiFi_v1.14\a_def_hard.h:1,
                 from D:\Users\deniscekanov09\Desktop\гирлянда на окно\LedPanelWiFi-main\LedPanelWiFi-main\firmware\LedPanelWiFi_v1.14\LedPanelWiFi_v1.14.ino:290:
C:\Users\deniscekanov09\AppData\Local\Arduino15\packages\esp8266\hardware\esp8266\3.1.2\libraries\ESP8266WebServer\src/ESP8266WebServer-impl.h:423:6: error: redefinition of 'void esp8266webserver::ESP8266WebServerTemplate<ServerType>::sendHeader(const String&, const String&, bool)'
  423 | void ESP8266WebServerTemplate<ServerType>::sendHeader(const String& name, const String& value, bool first) {
      |      ^~~~~~~~~~~~~~~~~~~~~~~~~~~~~~~~~~~~
In file included from C:\Users\deniscekanov09\AppData\Local\Arduino15\packages\esp8266\hardware\esp8266\3.1.2\libraries\ESP8266WebServer\src/ESP8266WebServer.h:349,
                 from C:\Users\deniscekanov09\AppData\Local\Arduino15\packages\esp8266\hardware\esp8266\3.1.2\libraries\ESP8266WebServer\src/ESP8266WebServer-impl.h:27,
                 from D:\Users\deniscekanov09\Desktop\гирлянда на окно\LedPanelWiFi-main\LedPanelWiFi-main\firmware\LedPanelWiFi_v1.14\a_def_hard.h:1,
                 from D:\Users\deniscekanov09\Desktop\гирлянда на окно\LedPanelWiFi-main\LedPanelWiFi-main\firmware\LedPanelWiFi_v1.14\LedPanelWiFi_v1.14.ino:290:
C:\Users\deniscekanov09\AppData\Local\Arduino15\packages\esp8266\hardware\esp8266\3.1.2\libraries\ESP8266WebServer\src/ESP8266WebServer-impl.h:423:6: note: 'void esp8266webserver::ESP8266WebServerTemplate<ServerType>::sendHeader(const String&, const String&, bool)' previously declared here
  423 | void ESP8266WebServerTemplate<ServerType>::sendHeader(const String& name, const String& value, bool first) {
      |      ^~~~~~~~~~~~~~~~~~~~~~~~~~~~~~~~~~~~
In file included from D:\Users\deniscekanov09\Desktop\гирлянда на окно\LedPanelWiFi-main\LedPanelWiFi-main\firmware\LedPanelWiFi_v1.14\a_def_hard.h:1,
                 from D:\Users\deniscekanov09\Desktop\гирлянда на окно\LedPanelWiFi-main\LedPanelWiFi-main\firmware\LedPanelWiFi_v1.14\LedPanelWiFi_v1.14.ino:290:
C:\Users\deniscekanov09\AppData\Local\Arduino15\packages\esp8266\hardware\esp8266\3.1.2\libraries\ESP8266WebServer\src/ESP8266WebServer-impl.h:438:6: error: redefinition of 'void esp8266webserver::ESP8266WebServerTemplate<ServerType>::setContentLength(size_t)'
  438 | void ESP8266WebServerTemplate<ServerType>::setContentLength(const size_t contentLength) {
      |      ^~~~~~~~~~~~~~~~~~~~~~~~~~~~~~~~~~~~
In file included from C:\Users\deniscekanov09\AppData\Local\Arduino15\packages\esp8266\hardware\esp8266\3.1.2\libraries\ESP8266WebServer\src/ESP8266WebServer.h:349,
                 from C:\Users\deniscekanov09\AppData\Local\Arduino15\packages\esp8266\hardware\esp8266\3.1.2\libraries\ESP8266WebServer\src/ESP8266WebServer-impl.h:27,
                 from D:\Users\deniscekanov09\Desktop\гирлянда на окно\LedPanelWiFi-main\LedPanelWiFi-main\firmware\LedPanelWiFi_v1.14\a_def_hard.h:1,
                 from D:\Users\deniscekanov09\Desktop\гирлянда на окно\LedPanelWiFi-main\LedPanelWiFi-main\firmware\LedPanelWiFi_v1.14\LedPanelWiFi_v1.14.ino:290:
C:\Users\deniscekanov09\AppData\Local\Arduino15\packages\esp8266\hardware\esp8266\3.1.2\libraries\ESP8266WebServer\src/ESP8266WebServer-impl.h:438:6: note: 'void esp8266webserver::ESP8266WebServerTemplate<ServerType>::setContentLength(size_t)' previously declared here
  438 | void ESP8266WebServerTemplate<ServerType>::setContentLength(const size_t contentLength) {
      |      ^~~~~~~~~~~~~~~~~~~~~~~~~~~~~~~~~~~~
In file included from D:\Users\deniscekanov09\Desktop\гирлянда на окно\LedPanelWiFi-main\LedPanelWiFi-main\firmware\LedPanelWiFi_v1.14\a_def_hard.h:1,
                 from D:\Users\deniscekanov09\Desktop\гирлянда на окно\LedPanelWiFi-main\LedPanelWiFi-main\firmware\LedPanelWiFi_v1.14\LedPanelWiFi_v1.14.ino:290:
C:\Users\deniscekanov09\AppData\Local\Arduino15\packages\esp8266\hardware\esp8266\3.1.2\libraries\ESP8266WebServer\src/ESP8266WebServer-impl.h:443:6: error: redefinition of 'void esp8266webserver::ESP8266WebServerTemplate<ServerType>::_prepareHeader(String&, int, const char*, size_t)'
  443 | void ESP8266WebServerTemplate<ServerType>::_prepareHeader(String& response, int code, const char* content_type, size_t contentLength) {
      |      ^~~~~~~~~~~~~~~~~~~~~~~~~~~~~~~~~~~~
In file included from C:\Users\deniscekanov09\AppData\Local\Arduino15\packages\esp8266\hardware\esp8266\3.1.2\libraries\ESP8266WebServer\src/ESP8266WebServer.h:349,
                 from C:\Users\deniscekanov09\AppData\Local\Arduino15\packages\esp8266\hardware\esp8266\3.1.2\libraries\ESP8266WebServer\src/ESP8266WebServer-impl.h:27,
                 from D:\Users\deniscekanov09\Desktop\гирлянда на окно\LedPanelWiFi-main\LedPanelWiFi-main\firmware\LedPanelWiFi_v1.14\a_def_hard.h:1,
                 from D:\Users\deniscekanov09\Desktop\гирлянда на окно\LedPanelWiFi-main\LedPanelWiFi-main\firmware\LedPanelWiFi_v1.14\LedPanelWiFi_v1.14.ino:290:
C:\Users\deniscekanov09\AppData\Local\Arduino15\packages\esp8266\hardware\esp8266\3.1.2\libraries\ESP8266WebServer\src/ESP8266WebServer-impl.h:443:6: note: 'void esp8266webserver::ESP8266WebServerTemplate<ServerType>::_prepareHeader(String&, int, const char*, size_t)' previously declared here
  443 | void ESP8266WebServerTemplate<ServerType>::_prepareHeader(String& response, int code, const char* content_type, size_t contentLength) {
      |      ^~~~~~~~~~~~~~~~~~~~~~~~~~~~~~~~~~~~
In file included from D:\Users\deniscekanov09\Desktop\гирлянда на окно\LedPanelWiFi-main\LedPanelWiFi-main\firmware\LedPanelWiFi_v1.14\a_def_hard.h:1,
                 from D:\Users\deniscekanov09\Desktop\гирлянда на окно\LedPanelWiFi-main\LedPanelWiFi-main\firmware\LedPanelWiFi_v1.14\LedPanelWiFi_v1.14.ino:290:
C:\Users\deniscekanov09\AppData\Local\Arduino15\packages\esp8266\hardware\esp8266\3.1.2\libraries\ESP8266WebServer\src/ESP8266WebServer-impl.h:484:6: error: redefinition of 'void esp8266webserver::ESP8266WebServerTemplate<ServerType>::send(int, char*, const String&)'
  484 | void ESP8266WebServerTemplate<ServerType>::send(int code, char* content_type, const String& content) {
      |      ^~~~~~~~~~~~~~~~~~~~~~~~~~~~~~~~~~~~
In file included from C:\Users\deniscekanov09\AppData\Local\Arduino15\packages\esp8266\hardware\esp8266\3.1.2\libraries\ESP8266WebServer\src/ESP8266WebServer.h:349,
                 from C:\Users\deniscekanov09\AppData\Local\Arduino15\packages\esp8266\hardware\esp8266\3.1.2\libraries\ESP8266WebServer\src/ESP8266WebServer-impl.h:27,
                 from D:\Users\deniscekanov09\Desktop\гирлянда на окно\LedPanelWiFi-main\LedPanelWiFi-main\firmware\LedPanelWiFi_v1.14\a_def_hard.h:1,
                 from D:\Users\deniscekanov09\Desktop\гирлянда на окно\LedPanelWiFi-main\LedPanelWiFi-main\firmware\LedPanelWiFi_v1.14\LedPanelWiFi_v1.14.ino:290:
C:\Users\deniscekanov09\AppData\Local\Arduino15\packages\esp8266\hardware\esp8266\3.1.2\libraries\ESP8266WebServer\src/ESP8266WebServer-impl.h:484:6: note: 'void esp8266webserver::ESP8266WebServerTemplate<ServerType>::send(int, char*, const String&)' previously declared here
  484 | void ESP8266WebServerTemplate<ServerType>::send(int code, char* content_type, const String& content) {
      |      ^~~~~~~~~~~~~~~~~~~~~~~~~~~~~~~~~~~~
In file included from D:\Users\deniscekanov09\Desktop\гирлянда на окно\LedPanelWiFi-main\LedPanelWiFi-main\firmware\LedPanelWiFi_v1.14\a_def_hard.h:1,
                 from D:\Users\deniscekanov09\Desktop\гирлянда на окно\LedPanelWiFi-main\LedPanelWiFi-main\firmware\LedPanelWiFi_v1.14\LedPanelWiFi_v1.14.ino:290:
C:\Users\deniscekanov09\AppData\Local\Arduino15\packages\esp8266\hardware\esp8266\3.1.2\libraries\ESP8266WebServer\src/ESP8266WebServer-impl.h:489:6: error: redefinition of 'void esp8266webserver::ESP8266WebServerTemplate<ServerType>::send(int, const char*, const String&)'
  489 | void ESP8266WebServerTemplate<ServerType>::send(int code, const char* content_type, const String& content) {
      |      ^~~~~~~~~~~~~~~~~~~~~~~~~~~~~~~~~~~~
In file included from C:\Users\deniscekanov09\AppData\Local\Arduino15\packages\esp8266\hardware\esp8266\3.1.2\libraries\ESP8266WebServer\src/ESP8266WebServer.h:349,
                 from C:\Users\deniscekanov09\AppData\Local\Arduino15\packages\esp8266\hardware\esp8266\3.1.2\libraries\ESP8266WebServer\src/ESP8266WebServer-impl.h:27,
                 from D:\Users\deniscekanov09\Desktop\гирлянда на окно\LedPanelWiFi-main\LedPanelWiFi-main\firmware\LedPanelWiFi_v1.14\a_def_hard.h:1,
                 from D:\Users\deniscekanov09\Desktop\гирлянда на окно\LedPanelWiFi-main\LedPanelWiFi-main\firmware\LedPanelWiFi_v1.14\LedPanelWiFi_v1.14.ino:290:
C:\Users\deniscekanov09\AppData\Local\Arduino15\packages\esp8266\hardware\esp8266\3.1.2\libraries\ESP8266WebServer\src/ESP8266WebServer-impl.h:489:6: note: 'void esp8266webserver::ESP8266WebServerTemplate<ServerType>::send(int, const char*, const String&)' previously declared here
  489 | void ESP8266WebServerTemplate<ServerType>::send(int code, const char* content_type, const String& content) {
      |      ^~~~~~~~~~~~~~~~~~~~~~~~~~~~~~~~~~~~
In file included from D:\Users\deniscekanov09\Desktop\гирлянда на окно\LedPanelWiFi-main\LedPanelWiFi-main\firmware\LedPanelWiFi_v1.14\a_def_hard.h:1,
                 from D:\Users\deniscekanov09\Desktop\гирлянда на окно\LedPanelWiFi-main\LedPanelWiFi-main\firmware\LedPanelWiFi_v1.14\LedPanelWiFi_v1.14.ino:290:
C:\Users\deniscekanov09\AppData\Local\Arduino15\packages\esp8266\hardware\esp8266\3.1.2\libraries\ESP8266WebServer\src/ESP8266WebServer-impl.h:494:6: error: redefinition of 'void esp8266webserver::ESP8266WebServerTemplate<ServerType>::send(int, const String&, const String&)'
  494 | void ESP8266WebServerTemplate<ServerType>::send(int code, const String& content_type, const String& content) {
      |      ^~~~~~~~~~~~~~~~~~~~~~~~~~~~~~~~~~~~
In file included from C:\Users\deniscekanov09\AppData\Local\Arduino15\packages\esp8266\hardware\esp8266\3.1.2\libraries\ESP8266WebServer\src/ESP8266WebServer.h:349,
                 from C:\Users\deniscekanov09\AppData\Local\Arduino15\packages\esp8266\hardware\esp8266\3.1.2\libraries\ESP8266WebServer\src/ESP8266WebServer-impl.h:27,
                 from D:\Users\deniscekanov09\Desktop\гирлянда на окно\LedPanelWiFi-main\LedPanelWiFi-main\firmware\LedPanelWiFi_v1.14\a_def_hard.h:1,
                 from D:\Users\deniscekanov09\Desktop\гирлянда на окно\LedPanelWiFi-main\LedPanelWiFi-main\firmware\LedPanelWiFi_v1.14\LedPanelWiFi_v1.14.ino:290:
C:\Users\deniscekanov09\AppData\Local\Arduino15\packages\esp8266\hardware\esp8266\3.1.2\libraries\ESP8266WebServer\src/ESP8266WebServer-impl.h:494:6: note: 'void
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

Thread 78 (2024-11-02):

Разные типы лент

R0mjke, 2024-11-02:
В прошлом году купил китайскую адресную ленту, прошил ESP, всё супер, целый сезон гирлянда отработала шикарно. В этом году заказал ещё три ленты по этому же лоту на АлиЭкспресс, чтобы сделать размер побольше. И вот возник небольшой нюанс, визуально все 4 ленты идентичные, но вот светодиоды внутри подключены по разному. На одной ленте порядок светодиодов GRB, а на трёх других RGB, соответственно, когда собираю одну большую ленту из 4 сегментов, на одном сегменте всегда другой цвет. В скетче нашел место, где указывается один общий порядок цветов в ленте. Соответственно вопрос, может быть как-то можно сделать, например в режиме сборной матрицы, чтобы каждому сегменту задавался свой тип ленты и порядок цветов в ней ?

vvip-68, 2024-11-03:
Два варианта решений.
1. Распределить вывод на разные пины, каждому пину определить свой порядок цвета.  В интерфейсе это тут - "Настройки", "Оборудование":
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

2. Вариант второй. В custom.ino найти вот этот вот кусочек кода:
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

До и после вызова FastLED.show() вставить два цикла по диодам ленты с другим порядком цветов (который кусок меньше - для того и цикл, а общий порядок цветов настроить в интерфейсе где на картинке выше

К примеру (абстрактно) два куска по 50 диодов, общее количество - 100
Один (первый) кусок имеет настроенный в интерфейсе порядок цветов GRB, Другой, например - RGB
То есть - нужно поменять две компоненты цвета R и G местами.

До FastLED.show() вставляем цикл типа

```
    for (uint16_t idx = 50; idx < 99; idx++) {
      uint8_t t = leds[idx].r;
      leds[idx].r = leds[idx].g;
      leds[idx].g = t;
    }
```

после - меняем в обратную сторону, возвращая как было
```
    for (uint16_t idx = 50; idx < 99; idx++) {
      uint8_t t = leds[idx].r;
      leds[idx].r = leds[idx].g;
      leds[idx].g = t;
    }
```

Ну или для другого порядка - поиграться с компонентами r,g,b. Возможно не только к и п нужно менять, а по кругу типа
r->g, g->b, и b->к - зависит от конкретного порядка в ленте. После FastLED.show() - все вернуть на место.

Это общий принцип - нюансы смотрите на месте.

R0mjke, 2024-11-03:
Огромное спасибо! С помощью первого варианта удалось всё быстро исправить! Прошу прощения за невнимательность!

R0mjke, 2024-11-03:
Огромное спасибо! С помощью первого варианта удалось всё быстро исправить! Прошу прощения за невнимательность!

Closed 2024-11-03.

Thread 80 (2024-11-12):

Проблема с веб подключением

Del3456, 2024-11-12:
Загрузил в NodeMCU версию проекта 1.14, не могу в браузере открыть http://192.168.4.1, после того как  по WiFi подключаюсь к устройству. Оно не отвечает ни на пинг, не заходит в браузере на него. Браузер yandex. На скриншотах видно, что все вроде
должно работать, куда копать?

Вчера ставил версию 1.13 с приложения все подключалось к плате корректно

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

vvip-68, 2024-11-12:
Попробуйте отключить в телефоне передачу мобильных данных, оставив только WiFi

vvip-68, 2024-11-12:
Ну да. Не залил файловую систему в микроконтроллер. Там все скрипты страницы находятся.
Или не залилось - многие сообщfли, что под 2.3.3 все время все глючит и зальется или нет - лотерея.
Если с 10 раз не получается - поставьте все же нормальную Arduino IDE 1.8.19 и залейте ее-шными плагинами.

vvip-68, 2024-11-12:
Какой плагин для заливки стоит? Что выбрано в разделе Инструменты - Partition Scheme?
Что пишет  в логе при загрузке файловой системы - нет ли там ошибок?

Del3456, 2024-11-12:
Все получилось, лагодарю!

dshrpv, 2024-11-16:
Коллеги. Доброго дня, ночи, полуночи, утра. Тоже не получается поднять интерфейс ((
Я тот еще мамкин "программист", хз куда смотреть копать.
После компиляции скетча (версия 1.14) "белого" сообщения об успехе нет. Есть гора сообщений, но прошивка в итоге собирается и заливается, лампочки светятся, но либо не поднимается DHCP либо при настройке подключения и статического адреса (в скетче) не поднимается вэб-интерфейс (File not found  URL:/).

Подскажите пожалуйста.

In file included from C:\Temp\Panel WS2812B WiFi\LedPanelWiFi-main\LedPanelWiFi_v1.14\a_def_hard.h:630,
                 from C:\Temp\Panel WS2812B WiFi\LedPanelWiFi-main\LedPanelWiFi_v1.14\LedPanelWiFi_v1.14.ino:290:
C:\Temp\Panel WS2812B WiFi\LedPanelWiFi-main\LedPanelWiFi_v1.14\a_def_lang.h:39:6: warning: multi-character character constant [-Wmultichar]
   39 | #if (LANG == 'RUS')
      |      ^~~~
C:\Temp\Panel WS2812B WiFi\LedPanelWiFi-main\LedPanelWiFi_v1.14\a_def_lang.h:39:14: warning: multi-character character constant [-Wmultichar]
   39 | #if (LANG == 'RUS')
      |              ^~~~~
In file included from C:\Temp\Panel WS2812B WiFi\LedPanelWiFi-main\LedPanelWiFi_v1.14\a_def_hard.h:630,
                 from C:\Temp\Panel WS2812B WiFi\LedPanelWiFi-main\LedPanelWiFi_v1.14\LedPanelWiFi_v1.14.ino:290:
C:\Temp\Panel WS2812B WiFi\LedPanelWiFi-main\LedPanelWiFi_v1.14\a_def_lang.h:343:6: warning: multi-character character constant [-Wmultichar]
  343 | #if (LANG == 'ENG')
      |      ^~~~
C:\Temp\Panel WS2812B WiFi\LedPanelWiFi-main\LedPanelWiFi_v1.14\a_def_lang.h:343:14: warning: multi-character character constant [-Wmultichar]
  343 | #if (LANG == 'ENG')
      |              ^~~~~
C:\Temp\Panel WS2812B WiFi\LedPanelWiFi-main\LedPanelWiFi_v1.14\a_def_lang.h:638:6: warning: multi-character character constant [-Wmultichar]
  638 | #if (LANG == 'ESP')
      |      ^~~~
C:\Temp\Panel WS2812B WiFi\LedPanelWiFi-main\LedPanelWiFi_v1.14\a_def_lang.h:638:14: warning: multi-character character constant [-Wmultichar]
  638 | #if (LANG == 'ESP')
      |              ^~~~~
In file included from C:\Temp\Panel WS2812B WiFi\LedPanelWiFi-main\LedPanelWiFi_v1.14\a_def_hard.h:630,
                 from C:\Temp\Panel WS2812B WiFi\LedPanelWiFi-main\LedPanelWiFi_v1.14\timeProcessor.cpp:23:
C:\Temp\Panel WS2812B WiFi\LedPanelWiFi-main\LedPanelWiFi_v1.14\a_def_lang.h:39:6: warning: multi-character character constant [-Wmultichar]
   39 | #if (LANG == 'RUS')
      |      ^~~~
C:\Temp\Panel WS2812B WiFi\LedPanelWiFi-main\LedPanelWiFi_v1.14\a_def_lang.h:39:14: warning: multi-character character constant [-Wmultichar]
   39 | #if (LANG == 'RUS')
      |              ^~~~~
In file included from C:\Temp\Panel WS2812B WiFi\LedPanelWiFi-main\LedPanelWiFi_v1.14\a_def_hard.h:630,
                 from C:\Temp\Panel WS2812B WiFi\LedPanelWiFi-main\LedPanelWiFi_v1.14\timeProcessor.cpp:23:
C:\Temp\Panel WS2812B WiFi\LedPanelWiFi-main\LedPanelWiFi_v1.14\a_def_lang.h:343:6: warning: multi-character character constant [-Wmultichar]
  343 | #if (LANG == 'ENG')
      |      ^~~~
C:\Temp\Panel WS2812B WiFi\LedPanelWiFi-main\LedPanelWiFi_v1.14\a_def_lang.h:343:14: warning: multi-character character constant [-Wmultichar]
  343 | #if (LANG == 'ENG')
      |              ^~~~~
C:\Temp\Panel WS2812B WiFi\LedPanelWiFi-main\LedPanelWiFi_v1.14\a_def_lang.h:638:6: warning: multi-character character constant [-Wmultichar]
  638 | #if (LANG == 'ESP')
      |      ^~~~
C:\Temp\Panel WS2812B WiFi\LedPanelWiFi-main\LedPanelWiFi_v1.14\a_def_lang.h:638:14: warning: multi-character character constant [-Wmultichar]
  638 | #if (LANG == 'ESP')
      |              ^~~~~
In file included from C:\Users\Lenovo\Documents\Arduino\libraries\FastLED\src/FastLED.h:75,
                 from C:\Temp\Panel WS2812B WiFi\LedPanelWiFi-main\LedPanelWiFi_v1.14\a_def_hard.h:656,
                 from C:\Temp\Panel WS2812B WiFi\LedPanelWiFi-main\LedPanelWiFi_v1.14\timeProcessor.cpp:23:
C:\Users\Lenovo\Documents\Arduino\libraries\FastLED\src/fastspi.h:157:23: note: '#pragma message: No hardware SPI pins defined.  All SPI access will default to bitbanged output'
  157 | #      pragma message "No hardware SPI pins defined.  All SPI access will default to bitbanged output"
      |                       ^~~~~~~~~~~~~~~~~~~~~~~~~~~~~~~~~~~~~~~~~~~~~~~~~~~~~~~~~~~~~~~~~~~~~~~~~~~~~~~~
In file included from C:\Users\Lenovo\Documents\Arduino\libraries\FastLED\src/FastLED.h:75,
                 from C:\Temp\Panel WS2812B WiFi\LedPanelWiFi-main\LedPanelWiFi_v1.14\a_def_hard.h:656,
                 from C:\Temp\Panel WS2812B WiFi\LedPanelWiFi-main\LedPanelWiFi_v1.14\LedPanelWiFi_v1.14.ino:290:
C:\Users\Lenovo\Documents\Arduino\libraries\FastLED\src/fastspi.h:157:23: note: '#pragma message: No hardware SPI pins defined.  All SPI access will default to bitbanged output'
  157 | #      pragma message "No hardware SPI pins defined.  All SPI access will default to bitbanged output"
      |                       ^~~~~~~~~~~~~~~~~~~~~~~~~~~~~~~~~~~~~~~~~~~~~~~~~~~~~~~~~~~~~~~~~~~~~~~~~~~~~~~~
. Variables and constants in RAM (global, static), used 42748 / 80192 bytes (53%)
║   SEGMENT  BYTES    DESCRIPTION
╠══ DATA     1808     initialized variables
╠══ RODATA   8532     constants
╚══ BSS      32408    zeroed variables
. Instruction RAM (IRAM_ATTR, ICACHE_RAM_ATTR), used 60967 / 65536 bytes (93%)
║   SEGMENT  BYTES    DESCRIPTION
╠══ ICACHE   32768    reserved space for flash instruction cache
╚══ IRAM     28199    code in IRAM
. Code in flash (default, ICACHE_FLASH_ATTR), used 632088 / 1048576 bytes (60%)
║   SEGMENT  BYTES    DESCRIPTION
╚══ IROM     632088   code in flash

dshrpv, 2024-11-16:
> Все получилось, благодарю!

Отлично!
А что не так было? Как излечилось?

vvip-68, 2024-11-17:
В приведенном выше логе ошибок нет. Более того - приведенная в конце лога таблица разбивки сегментов скомпилированного кода говорит об успешной сборке скетча.

File not found URL: /
говорит о том, что вы не залили файловую систему с файлами веб-странички в микроконтроллер - там все скрипты страницы находятся. Или не залилось - многие сообщали, что под 2.3.3 все время все глючит и зальется или нет - лотерея.
Если с 10 раз не получается - поставьте все же нормальную Arduino IDE 1.8.19 и залейте ее-шными плагинами.

https://github.com/vvip-68/LedPanelWiFi/wiki/Загрузка-данных-в-файловую-систему-МК

dshrpv, 2024-11-17:
Большое спасибо за быстрый ответ!
Да действительно, я (в силу отсутствия знаний и навыков или невнимательности) не закончил этот шаг.

И снова в замешательстве ((
Скопировал содержимое архива arduino-esp8266littlefs-plugin-master.zip по ссылке в инструкции
Перезагрузил программу
Плагин не установился.
В инструкции упомянуто имя архива ESP8266LittleFS-2.6.0.zip
Нагуглил  https://github.com/earlephilhower/arduino-esp8266littlefs-plugin/releases
Скопировал содержимое архива в c:\Program Files (x86)\Arduino\Plugins\, перезагрузил программу.
Плагин установился.

Но дальше продвинуться не получается.
При попытке загрузки, программа выдаёт сообщение

[LittleFS] data    : C:\Temp\Panel WS2812B WiFi\LedPanelWiFi-main\LedPanelWiFi_v1.14\data
[LittleFS] size    : 2024
[LittleFS] page    : 256
[LittleFS] block   : 8192
/arduino-littlefs-upload-1.3.0.vsix
unable to open '/arduino-littlefs-upload-1.3.0.vsix.
error adding file!

LittleFS Create Failed!

В инструкции упомянут arduino-littlefs-upload-1.2.1.vsix, но последняя версия arduino-littlefs-upload-1.3.0.vsix и в логах попытка открыть arduino-littlefs-upload-1.3.0.vsix
Я где это только можно подсунул их поочереди.
Без результата.

[LittleFS] data    : C:\Temp\Panel WS2812B WiFi\LedPanelWiFi-main\LedPanelWiFi_v1.14\data
[LittleFS] size    : 2024
[LittleFS] page    : 256
[LittleFS] block   : 8192
/arduino-littlefs-upload-1.2.1.vsix
unable to open '/arduino-littlefs-upload-1.2.1.vsix.
error adding file!

LittleFS Create Failed!

или

[LittleFS] data    : C:\Temp\Panel WS2812B WiFi\LedPanelWiFi-main\LedPanelWiFi_v1.14\data
[LittleFS] size    : 2024
[LittleFS] page    : 256
[LittleFS] block   : 8192
/arduino-littlefs-upload-1.3.0.vsix
unable to open '/arduino-littlefs-upload-1.3.0.vsix.
error adding file!

LittleFS Create Failed!

dshrpv, 2024-11-17:
попробовал загрузить через 2.3.3.

LittleFS Filesystem Uploader v1.2.1 -- https://github.com/earlephilhower/arduino-littlefs-upload

 Sketch Path: C:\Users\Lenovo\Documents\Arduino\LedPanelWiFi_v1.14
   Data Path: C:\Users\Lenovo\Documents\Arduino\LedPanelWiFi_v1.14\data
      Device: ESP8266 series

Тоже ошибка ((

Building LittleFS filesystem
Command Line: C:\Users\Lenovo\AppData\Local\Arduino15\packages\esp8266\tools\mklittlefs\3.1.0-gcc10.3-e5f9fec\mklittlefs.exe -c C:\Users\Lenovo\Documents\Arduino\LedPanelWiFi_v1.14\data -p 256 -b 8192 -s 2072576 C:\Users\Lenovo\AppData\Local\Temp\tmp-36824-AtYCpoQOnN7k-.littlefs.bin
/arduino-littlefs-upload-1.2.1.vsix
unable to open '/arduino-littlefs-upload-1.2.1.vsix.
error adding file!

ERROR:  Mklittlefs failed, error code: 1

vvip-68, 2024-11-17:
А в какой папке плагин для выгрузки то находится?

vvip-68, 2024-11-17:
Когда писал инструкцию - последний был 1.2.1. Новый действительно 1.3.0
Скачал, установил, проверил - всё прекрасно загружается с этим плагином...

vvip-68, 2024-11-17:
Думал может с ESP8266 что-то не так... Но нет же...
```
LittleFS Filesystem Uploader v1.3.0 -- https://github.com/earlephilhower/arduino-littlefs-upload

 Sketch Path: D:\DIY\Arduino\Projects\LedPanelWiFi\firmware\LedPanelWiFi_v1.14
   Data Path: D:\DIY\Arduino\Projects\LedPanelWiFi\firmware\LedPanelWiFi_v1.14\data
      Device: ESP8266 series

Building LittleFS filesystem
Command Line: C:\Users\AlVa\AppData\Local\Arduino15\packages\esp32\tools\mklittlefs\3.0.0-gnu12-dc7f933\mklittlefs.exe -c D:\DIY\Arduino\Projects\LedPanelWiFi\firmware\LedPanelWiFi_v1.14\data -p 256 -b 8192 -s 2072576 C:\Users\AlVa\AppData\Local\Temp\tmp-7664-D0rg0IQPOYL4-.littlefs.bin
/web/460.165f828294cdeda0.js.gz
/web/480.4a5de38231dac2ee.js.gz
/web/482.07dea5e05efa425a.js.gz
/web/489.b79619e5d87749bb.js.gz
/web/508.e4cb8ea546c73c86.js.gz
/web/51.c616389f35bf44c5.js.gz
/web/512.2694c16f82183863.js.gz
/web/978.fc7e5516e4f4fe76.js.gz
/web/assets/images/esp32.svg.gz
/web/assets/images/esp32c3.svg.gz
/web/assets/images/esp32c3mini.png.gz
/web/assets/images/esp32s2.svg.gz
/web/assets/images/esp32s2mini.png.gz
/web/assets/images/esp32s3.svg.gz
/web/assets/images/esp32s3mini.png.gz
/web/assets/images/nodemcu.svg.gz
/web/assets/images/wemos.svg.gz
/web/assets/langs/eng.json.gz
/web/assets/langs/esp.json.gz
/web/assets/langs/lat.json.gz
/web/assets/langs/rus.json.gz
/web/assets/tz-eng.json.gz
/web/assets/tz-esp.json.gz
/web/assets/tz-lat.json.gz
/web/assets/tz-rus.json.gz
/web/common.f9a5cf812b595b9c.js.gz
/web/favicon.ico.gz
/web/index.html.gz
/web/main.2398e7406950ae66.js.gz
/web/MI.122e921fbc0a837a.woff2
/web/pf.51221d56f96de468.js.gz
/web/runtime.497d25667d44c1d8.js.gz
/web/styles.2b31b41ad3aedf84.css.gz
/web/wallet.72f50a6de45ab9c2.svg.gz

Uploading LittleFS filesystem
Command Line: C:\Users\AlVa\AppData\Local\Arduino15\packages\esp8266\tools\python3\3.7.2-post1\python3.exe C:\Users\AlVa\AppData\Local\Arduino15\packages\esp8266\hardware\esp8266\3.1.2\tools\upload.py --chip esp8266 --port COM12 --baud 921600 write_flash 2097152 C:\Users\AlVa\AppData\Local\Temp\tmp-7664-D0rg0IQPOYL4-.littlefs.bin
esptool.py v3.0
Serial port COM12
Connecting....
Chip is ESP8266EX
Features: WiFi
Crystal is 26MHz
MAC: 30:83:98:b1:37:5d
Uploading stub...
Running stub...
Stub running...
Changing baud rate to 460800
Changed.
Configuring flash size...
Auto-detected Flash size: 4MB
Compressed 2072576 bytes to 624011...
Writing at 0x00200000... (2 %)
Writing at 0x00204000... (5 %)
Writing at 0x00208000... (7 %)
Writing at 0x0020c000... (10 %)
Writing at 0x00210000... (12 %)
Writing at 0x00214000... (15 %)
Writing at 0x00218000... (17 %)
Writing at 0x0021c000... (20 %)
Writing at 0x00220000... (23 %)
Writing at 0x00224000... (25 %)
Writing at 0x00228000... (28 %)
Writing at 0x0022c000... (30 %)
Writing at 0x00230000... (33 %)
Writing at 0x00234000... (35 %)
Writing at 0x00238000... (38 %)
Writing at 0x0023c000... (41 %)
Writing at 0x00240000... (43 %)
Writing at 0x00244000... (46 %)
Writing at 0x00248000... (48 %)
Writing at 0x0024c000... (51 %)
Writing at 0x00250000... (53 %)
Writing at 0x00254000... (56 %)
Writing at 0x00258000... (58 %)
Writing at 0x0025c000... (61 %)
Writing at 0x00260000... (64 %)
Writing at 0x00264000... (66 %)
Writing at 0x00268000... (69 %)
Writing at 0x0026c000... (71 %)
Writing at 0x00270000... (74 %)
Writing at 0x00274000... (76 %)
Writing at 0x00278000... (79 %)
Writing at 0x0027c000... (82 %)
Writing at 0x00280000... (84 %)
Writing at 0x00284000... (87 %)
Writing at 0x00288000... (89 %)
Writing at 0x0028c000... (92 %)
Writing at 0x00290000... (94 %)
Writing at 0x00294000... (97 %)
Writing at 0x00298000... (100 %)
Wrote 2072576 bytes (624011 compressed) at 0x00200000 in 17.6 seconds (effective 940.5 kbit/s)...
Hash of data verified.

Leaving...
Hard resetting via RTS pin...

Completed upload.
```

dshrpv, 2024-11-17:
Cпасибо!

Плагины распихал везде, чтобы только накормить программу
c:\Users\Lenovo\OneDrive\Документы\Arduino\tools\
c:\Users\Lenovo\.arduinoIDE\plugins\
c:\Program Files (x86)\Arduino\Plugins\
c:\Program Files (x86)\Arduino\tools\

в 1.8.19
для загрузки нажимаю
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

в 2.3.3
для загрузки нажимаю (как в инструкции)
[Ctrl] + [Shift] + [P], затем выберите в появившемся меню "Upload LittleFS to Pico/ESP8266/Esp32".

Во всех случаях
unable to open '/arduino-littlefs-upload-1.2.1.vsix.
error adding file!

Попробовал на другом ПК, та же беда ((

vvip-68, 2024-11-17:
А ведь так и не написали, куда плагин arduino-littlefs-upload-1.2.1.vsix положили....
Может в этом то и дело? Хотя, тогда б, наверное, и в меню бы не появилось...
Ну, тогда не знаю. Ждите - может кто-нибудь ответит.

vvip-68, 2024-11-17:
А вы вообще читали КУДА его нужно положить?
Вот, к примеру, в проекте - ва папке tools/LittleFS_Uploader/Arduino IDE 2.3.x файл readme
Туда положили? И из всех прочих мест его лучше удалить. А то может в конфликт вступают...

dshrpv, 2024-11-17:
Да.
и тут лежит
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

vvip-68, 2024-11-17:
Тогда у меня нет ответа...

dshrpv, 2024-11-17:
сейчас удалю его отовсюду кроме этой локации
и попробую

dshrpv, 2024-11-17:
безуспешно ((

[LittleFS] data    : C:\Temp\Panel WS2812B WiFi\LedPanelWiFi-main\LedPanelWiFi_v1.14\data
[LittleFS] size    : 2024
[LittleFS] page    : 256
[LittleFS] block   : 8192
/arduino-littlefs-upload-1.2.1.vsix
unable to open '/arduino-littlefs-upload-1.2.1.vsix.
error adding file!

LittleFS Create Failed!

vvip-68, 2024-11-17:
Ну, у меня кончились идеи. Мне вот непонятно - я выше приводил логи - у меня вообще нигде не фигурировал путь C:\Temp\xxx...  У вас то почему он есть? Вы проект в папке C:\Temp\Panel WS2812B WiFi\ что ли держите?

dshrpv, 2024-11-17:
да, в этой папке с:\temp
а какая папка нормальная?

vvip-68, 2024-11-17:
Любая, которая не является по умолчанию системной папкой для временных файлов.
Впрочем, не знаю, что уже думать...

dshrpv, 2024-11-17:
Рад бы предположить, если бы разбирался в этом.

dshrpv, 2024-11-17:
Переместил каталог со скетчем в корень, тот же результат.
В папку C:\1\ , тот же результат
т.е. дело не в том где скетч ((

dshrpv, 2024-11-17:
А могули попросить создать уже готовый файл для заливки в node MCU с минимальным набором опций (кнопка D4, лента D2)?

vvip-68, 2024-11-17:
Я уже в исходный код плагина залез - там даже строк таких нет, которые бы это выводили в лог...
Вы точно этим плагином для выгрузки пользуетесь? Не нет там такого кода, чтоб так выводил.
Удалите вообще все плагины выгрузки. Идите в папку проекта tools\LittleFS_Uploader\Arduino IDE 2.3.x
возьмите плагин оттуда. В точности сделайте как написано в файле readme...

vvip-68, 2024-11-17:
Готовый файл все равно только прошивку грузит. А файловая система заливается отдельно вот этим вот плагином.

dshrpv, 2024-11-17:
> Я уже в исходный код плагина залез - там даже строк таких нет, которые бы это выводили в лог... Вы точно этим плагином для выгрузки пользуетесь? Не нет там такого кода, чтоб так выводил. Удалите вообще все плагины выгрузки. Идите в папку проекта tools\LittleFS_Uploader\Arduino IDE 2.3.x возьмите плагин оттуда. В точности сделайте как написано в файле readme...

при этом если я плагин кладу 1.2.1 или 1.3.0, программа их различает и пишет что не может открыть именно 1.2.1 или 1.3.0

vvip-68, 2024-11-17:
Без разницы какой. Они оба нормально работают. Но я бы настоял на том, что в комплекте с пректом идет.

dshrpv, 2024-11-17:
Начну всё с 0 (в очередной раз)

dshrpv, 2024-11-17:
Спасибо за поддержку и советы!
Надеюсь вернуться с хорошими новостями )))

vvip-68, 2024-11-18:
Поздравляю!
Ну и в чем была проблема в предыдущих попытках?

dshrpv, 2024-11-18:
Т.к. все переделал с 0 (всё что можно снёс/удалил/переустановил) могу только предположить, что проблема была в arduino-esp8266littlefs-plugin со страницы разработчика.
В этой попытке использовал всё только из архива с проектом.
Возможно стоит убрать из инструкции ссылки на оригиналы плагинов, т.к. это создаёт проблемы/путаницу в версиях и их работоспособности.

Еще раз благодарю!!!!
Как за сам проект и его развитие.
Так и за оперативную поддержку/помощь.

hhrhhr, 2024-11-19:
> Думал может с ESP8266 что-то не так... Но нет же...

Плата LOLIN(WEMOS) D1 mini Pro, конфиг в плагине, соответственно, такой:
```
    ( 'd1_mini_pro', {
        'name': 'LOLIN(WEMOS) D1 mini Pro',
        'opts': {
            '.build.board': 'ESP8266_WEMOS_D1MINIPRO',
            '.build.variant': 'd1_mini',
            },
        'macro': [
            'resetmethod_nodemcu',
            'flashmode_dio',
            'flashfreq_40',
            '16M',
            ],
        'serial': '921',
        'desc': [ 'Product page: https://www.wemos.cc/' ],
    }),
```
То есть флешка 16М. При попытке заливки файлов веб-интерфейса всё почти как у вас, кроме пары ключей с размерами. У вас в логе `-s 2072576`, у меня `-s 14655488`. Подготовка файла проходит, создаётся временный файлик размером 14655488 байте, но при его загрузке облом (*** - вырезано для краткости):
```
Uploading LittleFS filesystem
Command Line: ***\python3.exe ***\upload.py --chip esp8266 --port COM5 --baud 921600 write_flash 2097152 ***.littlefs.bin
esptool.py v3.0
Serial port COM5
Connecting....
Chip is ESP8266EX
Features: WiFi
***
Configuring flash size...
Auto-detected Flash size: 4MB

A fatal esptool.py error occurred: File ***.littlefs.bin (length 14655488) at offset 2097152 will not fit in 4194304 bytes of flash. Use --flash-size argument, or change flashing address.
```

Как вручную указать размер флеш-памяти, чтобы образ создавался с учётом параметров платы, а не "_Auto-detected Flash size: 4MB_"?

hhrhhr, 2024-11-19:
> нужно выбрать разбивку партишнов выбрать 16MB(FS14MB/OTA~1019КВ)

Так и есть:
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

[Плата такая](https://sl.aliexpress.ru/p?key=jOY8roz).

Если ручками запустить обе команды (для подготовки образа и его заливки) с указанием размера не 14655488, а 2097152, то всё вроде бы замечательно:
```
***
Configuring flash size...
Auto-detected Flash size: 4MB
Compressed 1048576 bytes to 621988...
Wrote 1048576 bytes (621988 compressed) at 0x00200000 in 14.9 seconds (effective 564.0 kbit/s)...
Hash of data verified.

Leaving...
Hard resetting via RTS pin...
```
Но после перезапуска в логе видно, что каталог `/web` не найден, свободного места все оставшиеся 14 Мб.
Качаю "старую" IDE, может с ней что-то более осмысленное будет.

vvip-68, 2024-11-19:
А с чего вы решили, что она Pro, кроме того, что китаец так написал? По виду ничем не отличается от обычной 4MB карточки... Может не зря AutoDetect обнаруживаете в ней 4MB памяти то? На страничке продукта про 16МB тоже ничего не написано...

hhrhhr, 2024-11-19:
С того, например, что файл прошивки размером **больше 4 Мб** успешно загружается, плата стартует (при ручном указании IP адреса), какие-то эффекты по RGB-ленте бегают. Веб-сервер запускается и сообщает про "Сервер не активен".
Как ещё я могу проверить объём флешки?

vvip-68, 2024-11-19:
А что за прошивка у вас больше 4МБ?

hhrhhr, 2024-11-19:
Точно, прошивка около 700 Кб. Совсем глаз замылился после кучи экспериментов.
В общем, уже поставил старую IDE, плату выбрал **D1 mini clone**, собрал, прошил, загрузил веб-интерфейс - вуаля, все работает. Памяти действительно 4 Мб получается.
Влеплю китайцу минус за мои мучения.

Closed 2024-11-12.

Thread 81 (2024-11-19):

Нет получения адреса по DHCP

hhrhhr, 2024-11-19:
Выставил корректные имя и пароль точки доступа, нули в адресе:
```
#define NETWORK_SSID PSTR("***")
#define NETWORK_PASS PSTR("***")
#define DEFAULT_IP { 0, 0, 0, 0 }
#define GTW 1
```

В логе serial-монитора вижу такое:
```
Подключение к *** -> DCHP
Нажмите на кнопку для прерывания подключения
и переход в режим точки доступа
......
WiFi подключен. IP адрес: (IP unset)
MDNS - запущен

HTTP server started
Свободно памяти: FM: 29832  Max: 29832  Frag: 0
Режим: Поток
Режим: Спектрум
```

Эффекты меняются, но IP-адрес не получен. В логе маршрутизатора есть только сообщение "`STA(ec:64:c9:**:**:**) set key done in WPA2/WPA2PSK.`" (это MAC-адрес платы), которое повторяется каждые 3-4 минуты.

Есть какие-то подводные камны с получением адреса через DHCP? Жёсткая привязка к локальному диапазону 192.168.0.0/24, например?

vvip-68, 2024-11-19:
Вот понятия не имею. Никогда мне этого не нужно было. Я и не проверял и не углублялся.
В документации на ESP-ire написано - для получения адреса по DHCP укажите адрес 0.0.0.0, что прошивка честно и делает.
А уж почему не получает - мне это даже как-то не интересно было, я и не проверял.
Если вам нужно - попробуйте, поизучайте вопрос, поэкспериментируйте.

Потом и нам расскажете что было не так и почему. И заодно как при получении адреса по DHCP в каждый раз будете соединяться с ней из веб-интерфейса? Перебирать адреса искать на какой адрес посадил роутер панельку? Каждый раз подключаться к монитору порта смотреть на какой адрес на этот раз селе? Каждый раз открывать админку роутера смотреть какой на этот раз адрес получился?

А если прописывать в роутере жесткую привязку, чтобы он каждый раз выдавал устройству один и тот же адрес - чем это проще один раз задать статический адрес самому устройству в скетче или через веб-страничку? Веб-интерфейс даже, кстати, не поддерживает чтобы можно было ввести адрес 0.0.0.0.

В общем - я смысла в DHCP не вижу никакого и наверное ковыряться с этим даже не буду. Будем считать, что прошивка не поддерживает назначение адресов по DHCP.

vvip-68, 2024-11-19:
Можно конечно, по имени обращаться  - типа http://device.local - но то -- такое себе...

hhrhhr, 2024-11-19:
У меня в домашней сети одной подсети уже не хватает для всех устройств. Запоминать и на бумажке записывать какой IP у какого MAC-адреса — вот это и есть "такое себе".
Абсолютно все домашние устройства имеют привязку по имени, практически любой маршрутизатор это умеет. Вообще голова не болит, кто какой адрес получил, доступ по girlyanda-4.home или printer-panasonic.home, nas.home или camera-parkovka.home.
Для особо трудных случаев есть выделенный диапазон адресов, которые имеют привязку IP к MAC-адресу, но при этом всё равно получают нормальное человеческое имя в домашнем домене. Это действительно проще, настраивать всё в одном месте на маршрутизаторе.

Но это лирика, факт же в том, что получение динамического адреса не работает. "смысла не вижу", конечно же, аргумент мощный, но ведь работало оно раньше.

vvip-68, 2024-11-19:
Ну так этому коду, который за соединение с сетью отвечает - уже лет 5 и никто его не трогал.
Может от версии ядра зависит. Не знаю. Если разберетесь - сообщите что нужно сделать, чтобы у всех работало. Мне это точно не нужно и времени копаться в этом сейчас нет абсолютно. Когда будет свободное время - может поразбираюсь. Для меня это точно не приоритет номер 1. по описанным причинам.

У вас дома больше 250 устройств, что вся подсетка забита?

hhrhhr, 2024-11-20:
> У вас дома больше 250 устройств, что вся подсетка забита?

Одновременно нет, конечно же, но только всяких беспроводных поделок и виртуальных машин для их отладки около 150. К тому же есть 3 отдельных сегмента со своей адресацией, кому-то можно в инет, кому-то нельзя, некоторые устройства исклюительно друг с другом должны общаться. Всякие Tuya-девайсы умеют по blutooth работать, но обязательно требуют wifi для запуска.

> Если разберетесь

Точно не буду, логику программы я ещё могу поправить, но лезть в сетевые дебри - ну его, вас подожду ;)

hhrhhr, 2024-11-21:
```
@@ -1095,7 +1095,7 @@
       DEBUG('.');
       DEBUG(IP_STA[3]);
     } else {
-      WiFi.config(INADDR_NONE, INADDR_NONE, INADDR_NONE, INADDR_NONE);
+      //WiFi.config(INADDR_NONE, INADDR_NONE, INADDR_NONE, INADDR_NONE);
       DEBUG(F(" -> DCHP "));
     }

@@ -1136,8 +1136,13 @@
         if (wifi_connected) {
           // Подключение установлено
           DEBUGLN();
-          DEBUG(F("WiFi подключен. IP адрес: "));
-          DEBUGLN(WiFi.localIP());
+          DEBUG(F("WiFi подключен. IP: "));
+          DEBUG(WiFi.localIP());
+          DEBUG(F(", MAC: "));
+          DEBUG(WiFi.macAddress());
+          DEBUG(F(", hostname: "));
+          DEBUGLN(WiFi.getHostname());
+
           if (mdns.begin(host_name)) {
             DEBUGLN(F("MDNS - запущен"));
           } else {

```
Вот такое придумалось. В случае динамического адреса вызывать _WiFi.config(INADDR_NONE..._ не нужно. Вторая часть патча просто для вывода MAC-а и заданного имени хоста, а то я уже в трех платах запутался где какая ;)

На клоне D1 mini все заработало:
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

На ESP32 проверить не на чем, но как минимум для получения MAC-адреса там совершенно другая процедура.

vvip-68, 2024-11-21:
Ну, ок, с выводом MAC - посмотрю что на ESP32...
А что - вот закомментаривание той строчки позволяет нормально подключаться по DHCP?
То есть проблема решена?

Интересно почему во всех форумах пишут именно эту строчку длф конфигурирования подключения по DCHP?
У гих то как-то работает. Второй вопрос - насколько я помню, конфигурирование параметров сети вот  этим вот
WiFi.config() сохраняет сконфигурированное подключение сети где-то во флэш-памяти микроконтроллера.
И, к примеру, если оно раньше было сконфигурировано на статический адрес, почему считается, что бех вызова этого
WiFi.config() с пустыми параметрами он будет использовать подключение по DHCP? а не ранее сконфигурированные и сохраненные параметры?

hhrhhr, 2024-11-21:
Я всё что нашёл - это то, что использование _WiFi.mode(WIFI_STA);_ сбрасывает запомненные настройки, а _WiFi.config(...)_ используют исключительно для конфигурации статического адреса. Ну ещё требование использовать setHostname перед mode и scanNetworks (при использовании такой фичи), ибо сканирование сбрасывает и имя и сетевые настройки.

С таким патчем после запуска платы через веб-интерфейс изменил динамический адрес на статику, перезагрузился, зашёл по новому адресу и вернул обратно 0.0.0.0 — работает, новый адрес получает.

Если честно, то я даже просто API для модуля ESP8266WiFi не нашёл, только куцые примеры, из которых совершенно непонятно, почему нужно делать так, а не иначе.

Closed 2024-11-22.

Thread 82 (2024-11-19):

Использование SD-карты, как?

hhrhhr, 2024-11-19:
Собрал проект с поддержкой SD-шилда:
```
#define DEVICE_VARIANT == 0
#define USE_SD 1
#define FS_AS_SD 0
```
Спаял бутерброд из основной платы и считывателя, прошил, карточку на 2 Гб отформатировал в FAT32, скопировал на неё каталог \web из ***\LedPanelWiFi-main\firmware\LedPanelWiFi_v1.14\data\web — веб-интерфейс не завёлся. Скопировал его через LittleFS, всё нормально, за исключением отсутствия видимости SD-карты в логе загрузки.

Как именно нужно/можно использовать карточку? Как форматировать, какая структура каталогов? В вики дельных советов не обнаружил. Сделал штору 30х20 из шести 10 метровых RGB-гирлянд по 100 светодиодов, встроенные эффекты проигрываются замечательно, бегущие строки и прочие часы отображаются без проблем. Но вот как именно использовать SD-карту — пока непонятно.
Нужно ли её вытаскивать и копировать веб-интерфейс плюс всякие ролики на компьюетере/телефоне или можно загружать всякое на карту прямо через веб-интерфейс самой гирлянды? Сохранение настроек на карту проходит без проблем, но на самой карте ничего не находится.

vvip-68, 2024-11-20:
Web-интерфейс никакого отношения к SD-карте не имеет. Все его файлы хранятся внутри микроконтроллера, в его файловой системе. Данные в файловую систему микроконтроллера могут помещаться только специальным плагином-загрузчиком.

SD карта используется только для резервного копирования настроек прошивки (или в файловую систему или на SD-карту), сохранения рисунков пользователя, которые он натыкал на экране в режиме "Рисование" (или в файловую систему или на SD-карту по выбору) - рисунки сохраняются в папку формата WpH - где W- ширина матрицы, H - высота. В вашем случае - '30p20'. Далее сохраненные рисунки )или подготовленные в редакторе JinxFramer будут использованы для эффекта "Слайды".

Также на карточке хранятся ролики, подготовленные из Jinx для эффекта "SD-карта". Ролики должны размешаться в папке формата WxH, где W -ширина матрицы, H - высота матрицы, в вашем случае - '30x20'. Как подготовить ролики и скопировать их на SD-карточку подробно описано в материале Wiki проекта

https://github.com/vvip-68/LedPanelWiFi/wiki/Экспорт-эффектов-анимации-из-ПО-«Jinx!»

То, что вы можете сохранять на карту резервную копию настроек на SD-карту, говорит о том, что карта нормально подключена и распознается микроконтроллером. Осталось только наделать роликов в Jinx (как - описано по ссылке выше) и наблюдать их в эффекте "SD-карта"

vvip-68, 2024-11-20:
Сразу после нажатия на кнопку reset на карточке контроллера в локе должно быть следующее:
В блоке "Доступные возможности"
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

'+' в выделенной строке говорит о том, что в прошивке работа с SD-картой включена
Далее, ниже

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

говорит о том, что микроконтроллер нашел подключенную карточку
Далее проверяется наличие в корне файловой системы карты папки со слайдами (в моем случае - 35p10)
и выводится список найденных слайдов или сообщение о том, что слайдов нет.

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

Еще ниже - поиск и обнаружение роликов для эффекта "SD-карта" в папке с роликами (в моем случае - 35х10)

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

hhrhhr, 2024-11-20:
Разобрался, спасибо.
Карточку просто в телефоне отформатировал как съёмный накопитель, получилась FAT32. До этого Win10 вроде бы тоже в FAT32 форматировала, но, может быть, размер сектора какой-то другой выставила, из-за чего карта упорно была "не подключена".

Closed 2024-11-20.

Thread 86 (2024-12-02):

Долой EEPROM если есть SD-карта.

hhrhhr, 2024-12-02:
Вычитал пугательные вещи про эмуляцию EEPROM во флеше. Пугает меня низкий ресурс самой флешки и довольно частый, судя по журналу, сброс значений EEPROM в память, то есть перезапись.

Как насчёт подумать про отказ от эмуляции в случае наличия SD-карточки? И веб-интерфейс туда и настройки, благо что сохранение вручную нарисованных картинок на SD-карточку уже реализовано.

vvip-68, 2024-12-03:
Нахожу это довольно бессмысленным и имеющим массу минусов, особенно в части переноса Web-интерфейса.
Сдохла карточка  или вынули и всё - устройство недоступно, а при некоторых моментах и вообще не запускается.
По моему личному опыту SD карточки дохнут гораздо чаще. Просто воткнутая в телефон карточка сдыхает уже через полгода-9 месяцев. Хотя типа просто стоит в телефоне.

"... довольно частый, судя по журналу, сброс значений EEPROM в память..."
Насколько частый? И пишутся в память настройки - только после их изменения, в большинстве случаем через 30 сек после изменения последней. Ну или сразу после изменения для критических значений. Причем в память, а не в эмуляцию файловой системы. Настройки можно сохранять на карточку в бэкап-файл. Сдохнет контроллер -перепрошьете новый и восстановите настройки из резервной копии.

Заявленный производителем ресурс перезаписи eeprom - 10 тыс записей. Что и как часто вы пишете в файловую систему контроллера? Насколько при такой частоте записи хватит ресурса памяти? Считали? У меня гирлянды уже лет 5 работают без нареканий. И думаю еще лет на 20 хватит. Стоимость микроконтроллера - копейки. Сдохнет - поменяю. Ничего ценного там не хранится.

Обычно записывается состояние вкл/выкл. Ну, пару раз в день. 5000 дней - это 12-13 лет. при круглогодичной эксплуатации. А если считать, что гирлянда работает пару  месяцев в году - то ресурса хватит на 120 лет... Да даже если на 60 - этого за глаза...

Контроллеры, которые под разработку - постоянно перезаписываются при обновлении прошивки. Тысячами раз. И живы.
Так что - всё это довольно бессмысленно.

Впрочем - код открытый. Каждый волен делать изменения, которые ему нужны.

hhrhhr, 2024-12-03:
> Сдохла карточка или вынули и всё - устройство недоступно

Пример очень надуманный, типа а если молотком долбануть, то и вовсе устройство можно выкинуть.

>  SD карточки дохнут гораздо чаще.

У меня в телефоне стоит самсунг, который пережил предыдущие 5 телефонов, лет 8 как использовалась сначала как замещение памяти, потом просто для "съёмный накопитель". В регистраторе уже пятый год трудится не самая дорогая Smartbuy, тоже пережила пару регистраторов и 20 часов в неделю непрерывной работы. Так-то да, если покупать карточки с ценой контроллера, то их не напасёшься. С другой стороны, карты меньше 1 Гб нынче меньше 100 руб, что в разы дешевле всяких D1 mini clone.

> Что и как часто вы пишете в файловую систему контроллера?

Вообще-то это вам виднее, что и как часто пишется. Я же вижу, что при сбросе питания гирлядна почти всегда запускается на прерванном эффекте, то есть каждая смена по таймеру или вручную - запись.

Ресурс в 10000 перезаписей для флешек указан для фирменных модулей, а в то, чем торгуют на Али, пихают безымянные чипы с неизвестным ресурсом. Далее, в любой SD-карте есть свой контроллер с функцией выравнивания износа, при стандартном использовании он сам выбирает ячейки для текущей записи. Прошивка же в текущем состоянии перезаписывает "EEPROM" в одно и то же место во флеш-памяти, причём сразу целым блоком.
Нет желания возиться с переделкой под SD — уже есть же LittleFS, с выравниваем износа и устойчивостью к сбоям по питанию. Будет писать равномерно по всему доступному объёму флеша, а не долбить одни и теже 4 Кб.

> код открытый. Каждый волен делать изменения, которые ему нужны.

Ну да, даёшь кучу форков с минорными фичами, ибо автору лениво и бессмысленно ;)

Closed 2024-12-03.

Thread 88 (2024-12-04):

результаты cppcheck

hhrhhr, 2024-12-04:
Понимаю, что к статическим анализаторам стоит относиться очень предвзято, но некоторые предупреждения вызвали у меня вопросы.

_CWE-570:Logical conjunction always evaluates to false_
https://github.com/vvip-68/LedPanelWiFi/blob/7bdd30fce080eb90364f669dcbf5f79d22f6df8f/firmware/LedPanelWiFi_v1.14/eeprom.ino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
То же самое в строках 676, 724, 736. Здесь перепутаны AND и OR или это такой хитрый хак?

_CWE-398:Comparison of a boolean expression with an integer other than 0 or 1._
https://github.com/vvip-68/LedPanelWiFi/blob/7bdd30fce080eb90364f669dcbf5f79d22f6df8f/firmware/LedPanelWiFi_v1.14/setters.ino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
Приведение к булеву типу числового значения и его сравнивание - условие практически никогда не будет ложным.

CWE-398:Identical inner 'if' condition is always true.
https://github.com/vvip-68/LedPanelWiFi/blob/7bdd30fce080eb90364f669dcbf5f79d22f6df8f/firmware/LedPanelWiFi_v1.14/utility.ino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
Лишняя дублирующая проверка, вроде как.

CWE-570:Condition 'err' is always false
https://github.com/vvip-68/LedPanelWiFi/blob/7bdd30fce080eb90364f669dcbf5f79d22f6df8f/firmware/LedPanelWiFi_v1.14/effects.ino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
Как оно вообще работает, если условие всегда ложно?

vvip-68, 2024-12-04:
1 - да, там "или" должно быть
2 - там не bool, там uint8_t должно быть
3 - да, там внутренний if - лишний
4 - err там вообще лишний.

Так err -по или, и ни на что не влияет. А вот часть noise3d == NULL - вполне себе нормально должно срабатывать
Спасибо за бдительность!

Closed 2024-12-06.

Thread 89 (2024-12-05):

осталось до Нового года

NLObP, 2024-12-05:
Не правильно считает оставшиеся дни. Сегодня (5 декабря), проверьте: до 13 декабря осталось 7 дней, а до 14 декабря осталось 9 дней.

vvip-68, 2024-12-06:
Сегодня 6 декабря проверил остаток до 14 и 15 декабря (сдвинул на день, чтобы соответствовать условиям)
Пишет что до 14 декабря осталось 7 дней 14 часов (ну или если округлять по правилам гугля - 8 дней), а до 15 декабря, опять же по правилам гугля - 9 дней. Что не так?

NLObP, 2024-12-06:
Нет, тут именно 13 и 14 декабря.

NLObP, 2024-12-06:
Начал искать причину из-за того что на одном окне (где старая прошивка), показывает до Нового года правильно, а на  другом окне с новой прошивкой на один день больше.

vvip-68, 2024-12-06:
Потому что в старой прошивке вычисление проводилось математически - сколько дней осталось, столько именно и показывает (отбрасывая часы). На что мне пользователи многократно тыкали носом, что Гугль показывает по другому - там даже если осталось 7 дней 2 часа - все равно показывает 8. То есть округляет в большую сторону. То есть у меня ошибка вычисления. Ну ок, сделал так, как гугль считает.

Теперь другая половина говорит, что у меня ошибка...

NLObP, 2024-12-06:
И как мне быть? Я на старой не хотел обновлять прошивку.

vvip-68, 2024-12-06:
Ну, видимо, так и оставаться на старой прошивке

NLObP, 2024-12-06:
А в новой сложно поменять? Если вы мне скажете что поменять?

vvip-68, 2024-12-06:
Ну, ч думаю это где-то в runningText.ino примерно тут:

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

NLObP, 2024-12-06:
Спасибо

Thread 90 (2024-12-10):

При входе на web падает подключение

barkas803, 2024-12-10:
Добрый день уважаемый разработчик :)
Подскажи пожалуйста, в чем может быть дело, использую свежую версию LedPanelWiFi_v1.14, прошиваю wemos d1 mini, возникает проблема при входе на web-морду wifi-панели, web-морда загружается но в хаотичном порядке выкидывает "Соединение утеряно" подключаюсь через web-морду потому, что нет техники на android.
Происходит как в режиме Точка доступа так и при подключении к wifi - успешно работает но как только зашел на web-морду начинаются приколы, так же спустя пару минут нахождения в web-морде wemos рестартится.

Приложил лог и скрин, прошу помощи, при компиляции ошибки только про локализацию языка, все библиотеки ставил согласно скетчу, пробовал Arduino 1.8.19 и Arduino 2.3.4

Если в web-морду не лезть то всё работает судя по монитору порта.
Гирлянду еще не подключал, но пробовал подключать 5V от внешнего блока питания - результата нет, всё так же.

Помоги пожалуйста добрый человек :)

`15:51:25.464 -> FM: 18656  Max: 15408  Frag: 17
15:51:25.702 -> WebSocket клиент #10 отключен
15:51:26.144 -> WebSocket клиент #11 с адреса 192.168.4.2
15:51:27.163 -> WEB пакeт размером 20
15:51:27.163 -> <-- $6 7|NW|NX|IP|IPC|DH
15:51:27.163 -> FM: 19800  Max: 14104  Frag: 27
15:51:27.163 -> WEB пакeт размером 10
15:51:27.163 -> <-- $6 7|WZ|E0
15:51:27.163 -> FM: 19024  Max: 14104  Frag: 24
15:51:27.163 -> WEB пакeт размером 67
15:51:27.163 -> <-- $6 7|W|H|HN|CRLE|PS|LG|VR|FS|SX|CH|CV|WZ|AL|SM|UP|FM|PN|MC|MX|MZ|TM
15:51:27.163 -> FM: 18736  Max: 14104  Frag: 23
15:51:27.265 -> WEB пакeт размером 152
15:51:27.265 -> <-- $6 7|FM|UP|W|H|HN|CRLE|PS|LG|VR|FS|SX|CH|CV|WZ|AL|SM|PN|MC|MX|MZ|TM|LE|E0|M10|M11|M0|M1|M2|M3|M4|M5|M6|M7|M8|M9|SZ|PZ0|PZ1|2309|PW|EE|BF|IPC|DH|AN|AB|AU
15:51:27.302 -> FM: 18320  Max: 14104  Frag: 21
15:51:27.639 -> WEB пакeт размером 7
15:51:27.639 -> <-- $6 7|LE
15:51:27.639 -> FM: 19896  Max: 14104  Frag: 27
15:51:27.676 -> WebSocket клиент #11 отключен`

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

vvip-68, 2024-12-10:
А сколько диодов то в гирлянде. Судя по остаткам памяти - ее остается довольно мало. Хотя, вроде, и не критически мало. Вероятно библиотеке вебсервера для работы не хватает памяти и прошивка падает...

vvip-68, 2024-12-10:
Ну тогда не знаю. У меня на конфигурации из двух матриц 16х16 - то есть всего 512 диодов - работает без проблем. Так что даже не подскажу...

barkas803, 2024-12-10:
> Ну тогда не знаю. У меня на конфигурации из двух матриц 16х16 - то есть всего 512 диодов - работает без проблем. Так что даже не подскажу...

А может прошить не как wemos ?

barkas803, 2024-12-10:
> Ну тогда не знаю. У меня на конфигурации из двух матриц 16х16 - то есть всего 512 диодов - работает без проблем. Так что даже не подскажу...

может wemos с обманом :) брал на валберис :/

vvip-68, 2024-12-10:
Сколько их закупал - ни разу не встречался с которыми что-то не так...
Я не знаю от чего зависит. Вот на свежую прошил последнюю версию - тоже какие-то отвалы...
Раньше работало.

Разница - в последней версии библа ESPAsyncWenServer была обновлена с версии 1.2.3 на 1.2.4 - потому что 1.2.3 не компилилась под FastLED 3.9.4

Может быть стоит забить на совместимость и вернуться к предыдущей версии... Ткм более 3.9.4 с 8266 все равно не работает...

barkas803, 2024-12-10:
Спасибо за быструю отзывчивость :)

vvip-68, 2024-12-10:
Попробуйте скачать вот эту версию -
https://github.com/vvip-68/LedPanelWiFi/tree/4c2beb03675643aaad91a10c9c51dcaf292a1990

Она до всех изменений адаптации к FastLED 3.9.4 нормально работала
Библиотеки из нее возьмите

barkas803, 2024-12-10:
> Попробуйте скачать вот эту версию - https://github.com/vvip-68/LedPanelWiFi/tree/4c2beb03675643aaad91a10c9c51dcaf292a1990
>
> Она до всех изменений адаптации к FastLED 3.9.4 нормально работала Библиотеки из нее возьмите

другую версию залили?
Я сегодня часов 5 назад качал, вроде такая же версия :/ могу ошибаться

vvip-68, 2024-12-10:
По ссылке - версия в GIT до изменений под версию FastLED 3.9.4
И библиотеки в ней другие, несовместимые.
Вот поставил ее с FastLED 3.7.0 - никаких падений и дисконнектов....

Но в семой библе FastLED все же исправить время нужно. Иначе будет мерцающий диод...

barkas803, 2024-12-10:
> По ссылке - версия в GIT до изменений под версию FastLED 3.9.4 И библиотеки в ней другие, несовместимые. Вот поставил ее с FastLED 3.7.0 - никаких падений и дисконнектов....
>
> Но в сaмой библе FastLED все же исправить время нужно. Иначе может быть мерцающий диод...

Залил, всё так же, исправил только в скетче подкл к wifi и матрицу за место 32 поставил 16 =(
Единственное что теперь ещё и с com порта скинул, то есть логи уже не посмотреть в режиме онлайн.

vvip-68, 2024-12-10:
Хм... А я как раз залил эту версию с этими библиотеками - работает без проблем и отвалов....
Ну тогда - не знаю... Попробуйте какую-нибудь другую гирлянду - их много. WLED вон последних версий сильно хвалят...

barkas803, 2024-12-11:
Поставил wled через web сайт, web-морда работает без проблем, наверное там кода меньше, работает контроллер от usb-компа, web-морда не падает и через приложение iOS тоже не падает контроллер.
Конечно попробую потом с другим контролером например esp32, я за отечественных кодеров :)
Спасибо :)

vvip-68, 2024-12-11:
Ну и отлично. wled, похоже, пишет команда, которая только им и занимается.  Отсюда и быстрое развитие.
Для меня же этот проект - хобби в свободное от работы время, в одного человека, по большей части когда меня что-то в моей гирлянде или настольных часах перестает устраивать и я переписываю / дописываю под себя. Отсюда и все различия...

Closed 2024-12-13.

Thread 94 (2024-12-15):

не удается скомпелировать

Dilkins85, 2024-12-15:
не идет компиляция, уже все библиотеки перепробовал
вот что выдает

In file included from /Users/vitalijbalcezak/Desktop/LedPanelWiFi_v1.14/a_def_hard.h:631,
                 from /Users/vitalijbalcezak/Desktop/LedPanelWiFi_v1.14/LedPanelWiFi_v1.14.ino:355:
/Users/vitalijbalcezak/Desktop/LedPanelWiFi_v1.14/a_def_lang.h:39:6: warning: multi-character character constant [-Wmultichar]
   39 | #if (LANG == 'RUS')
      |      ^~~~
/Users/vitalijbalcezak/Desktop/LedPanelWiFi_v1.14/a_def_lang.h:39:14: warning: multi-character character constant [-Wmultichar]
   39 | #if (LANG == 'RUS')
      |              ^~~~~
In file included from /Users/vitalijbalcezak/Desktop/LedPanelWiFi_v1.14/a_def_hard.h:631,
                 from /Users/vitalijbalcezak/Desktop/LedPanelWiFi_v1.14/LedPanelWiFi_v1.14.ino:355:
/Users/vitalijbalcezak/Desktop/LedPanelWiFi_v1.14/a_def_lang.h:343:6: warning: multi-character character constant [-Wmultichar]
  343 | #if (LANG == 'ENG')
      |      ^~~~
/Users/vitalijbalcezak/Desktop/LedPanelWiFi_v1.14/a_def_lang.h:343:14: warning: multi-character character constant [-Wmultichar]
  343 | #if (LANG == 'ENG')
      |              ^~~~~
/Users/vitalijbalcezak/Desktop/LedPanelWiFi_v1.14/a_def_lang.h:638:6: warning: multi-character character constant [-Wmultichar]
  638 | #if (LANG == 'ESP')
      |      ^~~~
/Users/vitalijbalcezak/Desktop/LedPanelWiFi_v1.14/a_def_lang.h:638:14: warning: multi-character character constant [-Wmultichar]
  638 | #if (LANG == 'ESP')
      |              ^~~~~
/Users/vitalijbalcezak/Desktop/LedPanelWiFi_v1.14/a_def_lang.h:933:6: warning: multi-character character constant [-Wmultichar]
  933 | #if (LANG == 'LAT')
      |      ^~~~
/Users/vitalijbalcezak/Desktop/LedPanelWiFi_v1.14/a_def_lang.h:933:14: warning: multi-character character constant [-Wmultichar]
  933 | #if (LANG == 'LAT')
      |              ^~~~~
In file included from /Users/vitalijbalcezak/Documents/Arduino/libraries/FastLED/src/FastLED.h:75,
                 from /Users/vitalijbalcezak/Desktop/LedPanelWiFi_v1.14/a_def_hard.h:652,
                 from /Users/vitalijbalcezak/Desktop/LedPanelWiFi_v1.14/LedPanelWiFi_v1.14.ino:355:
/Users/vitalijbalcezak/Documents/Arduino/libraries/FastLED/src/fastspi.h:157:23: note: '#pragma message: No hardware SPI pins defined.  All SPI access will default to bitbanged output'
  157 | #      pragma message "No hardware SPI pins defined.  All SPI access will default to bitbanged output"
      |                       ^~~~~~~~~~~~~~~~~~~~~~~~~~~~~~~~~~~~~~~~~~~~~~~~~~~~~~~~~~~~~~~~~~~~~~~~~~~~~~~~
. Variables and constants in RAM (global, static), used 44176 / 80192 bytes (55%)
║   SEGMENT  BYTES    DESCRIPTION
╠══ DATA     1856     initialized variables
╠══ RODATA   9448     constants
╚══ BSS      32872    zeroed variables
. Instruction RAM (IRAM_ATTR, ICACHE_RAM_ATTR), used 61647 / 65536 bytes (94%)
║   SEGMENT  BYTES    DESCRIPTION
╠══ ICACHE   32768    reserved space for flash instruction cache
╚══ IRAM     28879    code in IRAM
. Code in flash (default, ICACHE_FLASH_ATTR), used 684408 / 1048576 bytes (65%)
║   SEGMENT  BYTES    DESCRIPTION
╚══ IROM     684408   code in flash

vvip-68, 2024-12-15:
А что в вашем понимании должно выводится, когда компиляция "идёт"?
Появиться надпись - "Уважаемый Dilkins85, все прошло успешно"?

Closed 2024-12-15.

Thread 95 (2024-12-15):

настройка цвета светодиода

Dilkins85, 2024-12-15:
возникла проблема что две гирлянды имеют разные светодиоды с разным расположением цветов, как можно выровнить цвет общего полотна, я так понял можно создать карту сегментов но как к сегментам назначить расположение цветов?

vvip-68, 2024-12-15:
https://github.com/vvip-68/LedPanelWiFi/wiki/FAQ#в-порядок-цветов---две-разных-ленты-с-разным-порядком-цветов

Closed 2024-12-15.

Thread 97 (2024-12-17):

Проблема с эффектами

barsik1986, 2024-12-17:
При переключении эффекта остается старый и мигает первый светодиод, попытки поменять библиотеку как описано в описании результата не дало. Помогите!!!

vvip-68, 2024-12-18:
Все способы решения описаны в основном файле в начале в комментарии и в wiki проекта (FAQ). Других рецептов нет. Вроде бы в версии 1.14.2024.1210 и выше данная проблема максимально устранена. По крайней мере у меня проблема перестала встречаться.

barsik1986, 2024-12-18:
Спасибо, буду пробовать дальше.

Closed 2024-12-18.

Thread 99 (2024-12-18):

косяки при USE_WEATHER 0

hhrhhr, 2024-12-18:
ESP8266, core 3.1.2, IDE 1.8.19, всё остальное как полагается:
```
...\LedPanelWiFi-main\firmware\LedPanelWiFi_v1.14\a_main.ino: In function 'void parsing()':
a_main:1957:12: error: 'set_ShowTempTextProps' was not declared in this scope; did you mean 'getShowTempTextProps'?
 1957 |            set_ShowTempTextProps(intData[2]);
      |            ^~~~~~~~~~~~~~~~~~~~~
      |            getShowTempTextProps

```
Полагаю, это после добавления значков градусов и прочих фаренгейтов в  458c3cf58e492dbd0f6a3000b014244fa0455d5f.

Сходу "исправил" обернув этот блок
https://github.com/vvip-68/LedPanelWiFi/blob/6347fe3fade61a260eb7b40cd8d629353b506eb1/firmware/LedPanelWiFi_v1.14/a_main.ino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
в `#if (USE_WEATHER == 1) ... #endif` (так как определения этих функции уже обёрнуты), но если из веб-интерфейса придёт такая команда, то не проверял.

vvip-68, 2024-12-19:
Спасибо. Действительно. Поправлю.
Если USE_WEATHER == 1 и придет из интерфейса - все ОК.
Если USE_WEATHER == 0 - оно даже не скомпилится, т.к. функция неизвестна.

Closed 2024-12-19.

Thread 100 (2024-12-19):

Загрузка строк из внешнего файла настроек (предложение).

Des-75, 2024-12-19:
Здравствуйте.
Хочу предложить сделать загрузку примеров строк для "Бегущей строки" при первом запуске прошивки по аналогии с другими настройками - из внешнего файла.
IMHO, было бы удобно и идеологически правильно.

vvip-68, 2024-12-19:
Хорошо, делайте. Внедрим.

Des-75, 2024-12-19:
Я вас понял :)

vvip-68, 2024-12-19:
А, вы хотели, чтобы я это делал?
Подумаем... Но не скоро.

Des-75, 2024-12-19:
Я предложил. Потому что сам это вряд ли смогу. Я посмотрел код (сильно звучит, в моём случае), чтобы понять как вы реализовали чтение настроек из внешнего файла. И ничего по коду не понял.
Моя логика такая (по примеру A_DEF_DEVC):
если A_DEF_DEVC определён в "1", то все настройки в самом скетче должны игнориться. А как это происходит, я не понимаю. Ну, т.е. я представляю конструкцию if .. end_if, но не вижу её. И вообще никакой, кроме как подключения файла A_DEF_DEVC.h не вижу. Но, раз всё работает, значит... я ничего не понимаю.
Вот такого уровня я "погромизд". :)

vvip-68, 2024-12-19:
Никакого там чтения настроек из внешнего файла нет.
Это директивы условной компиляции. Если условие верно - компилятор подгружает указанный файл, который переопределяет настройки, заданные в основном файле a_dev_hard.h. Просто этот файл - с настройками для всех (зачем другим нужны настройки под конкретно мой набор устройств), а в том "внешнем" файле описаны мои устройства.

Тексты точно так же - заданы в файле a_def_lang.h и подцепляются при компиляции из него. Если включен параметр (а по умолчанию он включен) - #define INITIALIZE_TEXTS 1

Des-75, 2024-12-19:
Спасибо, за объяснение. Мне кажется, я понял всю абсурдность своего "предложения": хочешь, бери и правь собственно "внешний" (в моих не верных определениях) файл a_def_lang.h.

Closed 2024-12-19.

Thread 102 (2024-12-19):

Не грузятся файлы из папки data

VAleSh-Soft, 2024-12-19:
При попытке загрузить файлы из папки data в контроллер получаю ошибку
```
*** buffer overflow detected ***: terminated
```
Чтобы ошибка ушла, приходится последовательно удалять файлы
```
data/web/assets/images/esp32C3.svg.gz
data/web/assets/images/esp32c3mini.png
data/web/assets/images/esp32S2.svg.gz
data/web/assets/images/esp32s2mini.png
data/web/assets/images/esp32S3.svg.gz
data/web/assets/images/esp32s3mini.png
data/web/assets/images/nodemcu.svg.gz
data/web/media/wallet-OL2QU3PE.svg.gz
```
После чего загрузка проходит, и даже Web-интерфейс загружается и работает, но ожидаемо не отображаются картинки модулей.

Arduino IDE 2.3.4, версия плагина arduino-littlefs-upload-1.5.0.vsix - соответственно 1.5.0
ОС - Линукс Минт 22

vvip-68, 2024-12-19:
Ну под линукс я ничего не скажу. У кого-то встречались такие ошибки - что при формировании образа LittleFS плагин формирует его по стандартами SPIFFS, который не допускает полное имя файла, включая папки - более 32 символов и вылетает с ошибкой что не может создать образ файловой системы. Причина такого поведения мне неизвестна. Возможно глюк в плагине или плагин использует что-то специфическое из Linux, что не позволяет работать с именами более 32 символов.

Под Windows (по крайней мере у меня и у известных мне пользователей) не случается.
Варианты:
- если при компиляции платы выбирается разбивка файловой системы как SPIFFS - там вроде есть такое же, нео с FAT - попробовать выбрать этот вариант.
- можно попробовать взять плагины более ранних версий - 1.2 или 1.3 У меня на них проблем не было.
- поставить Arduino IDE версии 1.8.19 (она же под линукс вроде тоже есть) и взять плагин для загрузки файловой системы LittleFS для нее.
- использовать какие-нибудь специфичные tools для загрузки файловой системы в микроконтроллер. Вроде в espTools что-то было, но не уверен и подробностей сказать не могу - я этим не пользовался.

Closed 2024-12-20.

Thread 103 (2024-12-20):

Бегущая строка

barsik1986, 2024-12-20:
Приветствую, как настроить бегущую строку чтоб она была не поверх эффектов, а просто пробегала например после последнего эффекта в списке или через заданный промежуток времени, но при этом не было никаких эффектов на матрице? в описании не нашёл, либо плохо читал. Подскажи пожалуйста.

barsik1986, 2024-12-20:
Спасибо, но  решил немного по другому и работает) На всех эффектах убрал показ строки поверх эффектов, в настройках часов оставил, по итогу после последнего эффекта бегущая строка и потом часы ну и так далее.

Closed 2024-12-20.

Thread 106 (2024-12-22):

Не видит файлы

udiFi, 2024-12-22:

vvip-68, 2024-12-22:
Загрузите туда файлы. Сейчас эти папки пустые.

udiFi, 2024-12-22:
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

vvip-68, 2024-12-22:
Вероятно у вас либо новая ArduinoIDE 2.x.x - ее плагины временами глючат и не могут создать пакет для загрузки. Вроде не линукс - на линуксе подобные проблемы были.  Если с 10 попыток загрузить не получится - поставьте Arduino IDE 1.8.19 и ее плагины для загрузки в файловую систему. Они вроде не глючили ни разу.
Ну или используйте отдельные утилиты типа espTools - но я их не пользовал - ничего подсказать не могу.

Вот тут человек как-то решил проблему - свяжитесь с ним.
https://github.com/vvip-68/LedPanelWiFi/issues/102

udiFi, 2024-12-22:
1.8.19, загружал и с платформио и онлайн. Зато на счет красной ошибки узнал https://github.com/me-no-dev/arduino-esp32fs-plugin/issues/3#issuecomment-337079574

vvip-68, 2024-12-22:
Так это понятно, что SPIFFS - ограничение 32
Только там не SPIFFS используется - а LittleFS.
И почему плагин готовит файлы как будто под SPIFFS а не под LittleFS - загадка.
И почему другие плагины (или ээти время от времени) - нормально упаковывают данные файлы...
Вот у меня такая ошибка ни разу не встречалась.
У других - довольно часто - не вы первый...
Они заливали из под 1.8.19 - заливалось. Под 2.3.3 - не всегда.

udiFi, 2024-12-22:
"И почему плагин готовит файлы как будто под SPIFFS а не под LittleFS - загадка." - сам не знаю, может глянуть на скрины что в проекте

https://github.com/vvip-68/LedPanelWiFi/blob/main/setitngs-esp32.png

vvip-68, 2024-12-22:
Эти скрины отражают то, что работает у меня, что проверено.
Можете выбрать - там вариант есть с FAT. Может взлетит. Только все равно файловая система - LittleFS.

Closed 2024-12-22.

Thread 107 (2024-12-24):

перестал зашиваться контроллер

BlooDLifEQ, 2024-12-24:
После перепрошивки н-го количества раз выбивает ошибку "esptool.py v3.0
Serial port COM4
Connecting........_____....._____....._____....._____....._____....._____....._____
A fatal esptool.py error occurred: Failed to connect to ESP8266: Invalid head of packet (0xB2)"
и некоторые эффекты не хотят работать, а большинство работают с торможением

vvip-68, 2025-01-02:
Обсуждение причин (не)работоспособности контроллера (сгорел/не сгорел) не входит в область вопросов/проблем, обсуждаемых в теме, связанной с этой прошивкой.

Вариантов почему контроллер вышел из строя или не отвечает или не работает - миллион.  От банального замыкания, приводящему к выходу из строя самого микроконтроллера, микросхемы USB-COM адаптера или защитного диода, до отварившихся проводков при плохой пайке или монтаже.

Closed 2025-01-02.

Thread 108 (2024-12-25):

Неправильная адресация

lugadin, 2024-12-25:
Два куска ленты по 126 диодов. Подключены к двум пинам. Наклеено 2 окна по ширина 14, высота 9 - змейкой (снизу влево).
При рисовании, если закрашивать крайний левый/правый ряд, диоды горят:

0 0 0 0 0 0 0 0 0 0 0 0 1 1
0 0 0 0 0 0 0 0 0 0 0 0 0 0
0 0 0 0 0 0 0 0 0 0 0 0 1 1
0 0 0 0 0 0 0 0 0 0 0 0 0 0
0 0 0 0 0 0 0 0 0 0 0 0 1 1
0 0 0 0 0 0 0 0 0 0 0 0 0 0
0 0 0 0 0 0 0 0 0 0 0 0 1 1
0 0 0 0 0 0 0 0 0 0 0 0 0 0
0 0 0 0 0 0 0 0 0 0 0 0 0 1

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

Фото из комнаты
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

vvip-68, 2024-12-26:
Неправильная настройка матрицы. Разбирайтесь как реально у вас что подключено. Или "странная" лента с китайской адресацией. По фото видно, что если ленту "протянуть на один диод вправо - крайний у рамы диод уйдет вниз, соседний подтянется к раме и в результате получится заполненный полностью один правый столбец. Что соответствует рисунку в приложении.

Closed 2024-12-30.

Thread 109 (2024-12-30):

Не получается установить библиотеку

Mihger, 2024-12-30:
При распаковке архива с библиотекой ESPAsyncWebServer.zip (из папки "для esp8266 core 3.1.2 FastLed 3.6.0")возникает ошибка распаковки, пишет файл библиотеки поврежден. Если устанавливать библиотеку через Arduino IDE так же возникает ошибка.

vvip-68, 2024-12-30:
Обновите свой архиватор. Видимо он у вас какой-то древней версии.
С библиотекой ESPAsyncWebServer взятой не из папки проекта с вероятностью 80% ничего работать не будет.

Closed 2024-12-30.

Thread 112 (2025-01-02):

Проблема с настройкой скетча.

Mystery2010, 2025-01-02:
Здравствуйте! Имеется готовая китайская штора на адресных светодиодах, тип подключения - параллельная, размер 20х20.
Угол подключения получается - левый верхний. Ставлю в скетче:
#define WIDTH 20        
#define HEIGHT 20       
#define MATRIX_TYPE 1   
#define MATRIX_INDEX 1  
#define CONNECTION_ANGLE 1
#define STRIP_DIRECTION 2

#define META_MATRIX_WIDTH 1                                                             
#define META_MATRIX_HEIGHT 1
#define META_MATRIX_TYPE 1
#define META_MATRIX_ANGLE 1
#define META_MATRIX_DIRECTION 2

STRIP_DIRECTION 2  пробовала менять на 3 (вниз)
в итоге у меня горят только 2-3 первых линии, пробовала разные контроллеры (esp8266 3 шт)

Прошивка LedPanelWifi 1.14
версия среды 1.8.19
Версия FastLED      - 3.6.0
Версия ядра ESP8266 - 3.1.2
Версия ядра ESP32   - 2.0.17
все библиотеки из папки проекта и по инструкции.
Ставлю родной юсб-контроллер от этой шторки, горят все, но там слишком примитивные, неинтересные режимы, чтобы пользоваться родным.
Подскажите пожалуйста, в чем проблема?
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

vvip-68, 2025-01-02:
Надо бы уже в FAQ внести, что ли...
Мильон раз уже и на форумах и где только не обсуждалось - готовые китайские шторы с эффектами и своими контроллерами несовместимы с кастомными прошивками. Не будут они работать.
Никто не знает что там китайцы в них намутили. И скетч тут совсем не причем, как его ни настраивай.

Берете из примеров FastLED простенький Blink.ino.
Исправляете в нем, что не один дод мигает а от 0 до NUM_LEDS-1 (сколько у вас там диодов) и поочередно зажигаете /гасите по одному в цикле на полсекунды. Пробежался огонек по всем диодам в правильном порядке - будут работать кастомные прошивки. Загорелся только в случайных местах или одна-две линии - не будут кастомные прошивки работать.

Мне еще не встречалась ни одна китайская готовая штора с контроллерами, которая паботала бы с кастомными прошивками.   WLED вон попробуйте - вдруг они разгадали как эти гирлянды управляются...

Closed 2025-01-02.

Thread 114 (2025-01-07):

Бегущая строка на WIFI Panel

Wod73, 2025-01-07:
Здравствуйте. Собрал панель по вашей схеме на esp32 wroom32. Эффекты работают. Бегущая строка пытается работать, но выводит зеркально. Погода и часы не понятно что выводится. Библиотеки проверил, версии той которые в инструкции указаны. Подскажите в чём может проблема? Если пробовать менять точку подключения (подключено к правому нижнему углу, направление вверх) на верхний правый, текст начинает правильно отображаться.

vvip-68, 2025-01-07:
В скетче нет никаких других регулировок. Все определяет точка подключения и направление из угла. 99.9999% пользователей подключают и настраивают подключение в скетче (или из веб интерфейса) именно так как подключено физически. Ваш случай - первый и единственный. У меня нет ответа на ваш вопрос и я даже представить себе не могу, зная скетч, по какой причине может быть такой эффект как у вас.

Wod73, 2025-01-07:
нет, зигзаг используется. Использую ленту, собирал последовательно по стрелкам на ленте.

vvip-68, 2025-01-07:
И в настройках тоже зигзаг используется? Дайте скриншот страницы Еастройка / Матрица

Wod73, 2025-01-07:
Доэспереминтировался...сейчас в дефолте залью

Wod73, 2025-01-07:
Вот так по дефолту работает.
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

vvip-68, 2025-01-07:
Что-то внешне это выглядит как будто у вас лента - WS2811? в которой одна "точка" - это три подряд идущих диодов.
ТО есть в ней адресация не отдельными диодами, а тройками - три последовательно идущих диода это одна точка, следующие три - вторая точка и так далее. Такая лента для гирлянды не подойдет.

Проверьте - залейте простой скрипт который в цикле перебирает от 0 до NUM_LEDS-1 диоды, зажигая на 0.5 сек  первый, потом следующий и так жадее. Если будет бежать по одному диоду - ок. Но в вашем случае скорее всего будет бежать группами по три диода. Сначала загорится первые три, потом вторые три и так далее.

vvip-68, 2025-01-07:
Укажите высоту матрицы для эксперимента не 30, а 10.

vvip-68, 2025-01-07:
Укажите высоту 10 - будет у вас матрица 44х10 - нормально работать

Wod73, 2025-01-07:
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

Wod73, 2025-01-07:
Да, так заработало. Наскоком не получилось сделать. Спасибо.

Closed 2025-01-08.

Thread 115 (2025-01-07):

Бегущая строка как отдельный эффект

Sh-Renat, 2025-01-07:
Добрый день! У вас самая крутая прошивка, все в ней хорошо, настроек море, веб работает отлично. Очень не хватает бегущей строки как отдельный эффект на своем фоне, а можно и без фона. Это было у Гайвера во вкладке кастом, я после каждого третьего эффекта пускал бегущую строку С новым годом!!!, у вас это только поверх других эффектов. Так как у меня количество светодиодов 12х12 это выглядит кашей в купе с другими эффектами, но как отдельный эффект выглядит нормально и читабельно. Как вариант было бы хорошо пускать отдельный текст после например 5 минут, а можно и после каждого третьего эффекта. Спасибо. Успехов. С новым годом.

vvip-68, 2025-01-07:
Ставите интервал показа бегущей строки 300 секунд - будет вам строка бежать через каждые 5 минут.

Sh-Renat, 2025-01-07:
Я ставил Текст поверх эффектов ВЫКЛ и время через каждые 30 секунд. Нету текста. А когда Текст поверх эффектов ВКЛ то текст бежит поверх эффектов через 30 секунд. Как самостоятельный эффект не работает.

Sh-Renat, 2025-01-07:
Вот палитру фона В я не использовал, если оно будет с ней работать это норм. Проверю.

vvip-68, 2025-01-07:
Ну естественно, если выключаете - то не будет показываться.
Добавьте в текст строки макрос {B#000000} чтобы задать фон текста

Sh-Renat, 2025-01-07:
Только что проверил, работает. Спасибо.

Closed 2025-01-08.

Thread 117 (2025-01-27):

Использование ленты с чипом SK9822

Mosrom, 2025-01-27:
Уважаемый разработчик, ещё раз благодарю за такой замечательный проект.

При использовании чипа ленты SK9822 с четырьмя выводами (VCC, GND, DI, CI) какие конкретные изменения нужно произвести в скетче?
Понятно, что во вкладке "a_def_hard.h" в строке "#define LED_CHIP" нужно указать новый тип чипа ленты.
Возможно нужно еще изменить функцию "allocateLeds()" в utility.ino (или utility2.ino), но что конкретно в ней менять просьба подсказать.
Так как появился дополнительный вывод ленты, вероятно нужно добавить строку во вкладку "a_def_hard.h" с указанием значения номера пина на модуле ESP32, куда будет подключен данный вывод ленты.
Если не затруднит, поясните пожалуйста пошагово.

vvip-68, 2025-01-27:
У меня нет опыта с данными лентами.
Но чисто теоретически - вы все правильно сказали.
Изменить тип в LED_CHIP, завести рядом с LED_PIN (data pin) определение для CLOCK_PIN,
и согласно примерам из FastLED для этой ленты в строки инициализации указывается этот CLOCK_PIN

Согласно опять же примерам, для SK9822 формат инициализации следующий:

FastLED.addLeds<SK9822, DATA_PIN, CLOCK_PIN, RGB>(leds, NUM_LEDS);

Это и нужно исправить в allocateLeds()
Можно просто весь этот огромный case выкинуть и заменить конкретно вашим набором, т.к
скетч и веб-интерфейс все равно не рассчитаны на данный тип ленты - там можно из Web-интерфейса менять тольrо назначение DATA_PIN, а для CLOCK_PIN не предусмотрено

Mosrom, 2025-01-27:
Большое спасибо за быстрый ответ, буду пробовать...

Mosrom, 2025-01-30:
Добрый вечер!

Поменял тип ленты и добавил определение для DATA_PIN и CLOCK_PIN. У меня тип модуля ESP32S3 Dev Module.

<pre>
<font color="#5e6d03">#if</font> <font color="#000000">defined</font><font color="#000000">(</font><font color="#000000">ESP32</font><font color="#000000">)</font>

<font color="#5e6d03">#define</font> <font color="#000000">WIDTH</font> <font color="#000000">45</font> &nbsp;&nbsp;&nbsp;&nbsp;&nbsp;&nbsp;&nbsp;&nbsp;&nbsp;&nbsp;&nbsp;&nbsp;&nbsp;&nbsp;&nbsp;<font color="#95a5a6">&#47;* ширина одного сегмента матрицы для MATRIX_TYPE == 0 или MATRIX_TYPE == 1 &nbsp;&nbsp;&nbsp;&nbsp;&nbsp;&nbsp;&nbsp;&nbsp;&nbsp;&nbsp;&nbsp;&nbsp;&nbsp;&nbsp;&nbsp;&nbsp;&nbsp;&nbsp;&nbsp;&nbsp;&nbsp;&nbsp;&nbsp;&nbsp;&nbsp;&nbsp;&nbsp;&nbsp;&nbsp;&nbsp;&nbsp;&nbsp;&nbsp;&nbsp;&nbsp;&nbsp;&nbsp;&nbsp;| для MATRIX_TYPE == 2 ПОЛНАЯ ШИРИНА матрицы &nbsp;&nbsp;*&#47;</font>
<font color="#5e6d03">#define</font> <font color="#000000">HEIGHT</font> <font color="#000000">30</font> &nbsp;&nbsp;&nbsp;&nbsp;&nbsp;&nbsp;&nbsp;&nbsp;&nbsp;&nbsp;&nbsp;&nbsp;&nbsp;&nbsp;<font color="#95a5a6">&#47;* высота одного сегмента матрицы для MATRIX_TYPE == 0 или MATRIX_TYPE == 1 &nbsp;&nbsp;&nbsp;&nbsp;&nbsp;&nbsp;&nbsp;&nbsp;&nbsp;&nbsp;&nbsp;&nbsp;&nbsp;&nbsp;&nbsp;&nbsp;&nbsp;&nbsp;&nbsp;&nbsp;&nbsp;&nbsp;&nbsp;&nbsp;&nbsp;&nbsp;&nbsp;&nbsp;&nbsp;&nbsp;&nbsp;&nbsp;&nbsp;&nbsp;&nbsp;&nbsp;&nbsp;&nbsp;| для MATRIX_TYPE == 2 ПОЛНАЯ ВЫСОТА матрицы &nbsp;&nbsp;*&#47;</font>
<font color="#5e6d03">#define</font> <font color="#000000">MATRIX_TYPE</font> <font color="#000000">0</font> &nbsp;&nbsp;&nbsp;&nbsp;&nbsp;&nbsp;&nbsp;&nbsp;&nbsp;&nbsp;<font color="#95a5a6">&#47;* тип соединения диодов в сегменте матрицы: 0 - зигзаг, 1 - параллельная, 2 - использовать карту индексов &nbsp;&nbsp;&nbsp;&nbsp;&nbsp;&nbsp;&nbsp;&nbsp;&nbsp;&nbsp;&nbsp;&nbsp;&nbsp;&nbsp;&nbsp;&nbsp;&nbsp;&nbsp;&nbsp;&nbsp;&nbsp;&nbsp;&nbsp;&nbsp;&nbsp;&nbsp;&nbsp;&nbsp;&nbsp;&nbsp;&nbsp;&nbsp;&nbsp;&nbsp;&nbsp;&nbsp;&nbsp;&nbsp;&nbsp;&nbsp;&nbsp;&nbsp;&nbsp;&nbsp;&nbsp;&nbsp;&nbsp;&nbsp;&nbsp;&nbsp;&nbsp;&nbsp;&nbsp;&nbsp;*&#47;</font>
<font color="#5e6d03">#define</font> <font color="#000000">MATRIX_INDEX</font> <font color="#000000">1</font> &nbsp;&nbsp;&nbsp;&nbsp;&nbsp;&nbsp;&nbsp;&nbsp;&nbsp;<font color="#95a5a6">&#47;* только для MATRIX_TYPE == 2 место расположения массива индексов 0 - в сектче, 1 - в файле &nbsp;&nbsp;&nbsp;&nbsp;&nbsp;&nbsp;&nbsp;&nbsp;&nbsp;&nbsp;&nbsp;&nbsp;&nbsp;&nbsp;&nbsp;&nbsp;&nbsp;&nbsp;&nbsp;&nbsp;&nbsp;| для MATRIX_TYPE == 0 или 1 - поставьте тут 1 *&#47;</font>
<font color="#5e6d03">#define</font> <font color="#000000">CONNECTION_ANGLE</font> <font color="#000000">3</font> &nbsp;&nbsp;&nbsp;&nbsp;&nbsp;<font color="#95a5a6">&#47;* угол подключения диодов в сегменте: 0 - левый нижний, 1 - левый верхний, 2 - правый верхний, 3 - правый нижний | для MATRIX_TYPE == 2 - не используется &nbsp;&nbsp;&nbsp;&nbsp;&nbsp;&nbsp;*&#47;</font>
<font color="#5e6d03">#define</font> <font color="#000000">STRIP_DIRECTION</font> <font color="#000000">1</font> &nbsp;&nbsp;&nbsp;&nbsp;&nbsp;&nbsp;<font color="#95a5a6">&#47;* направление ленты из угла сегмента: 0 - вправо, 1 - вверх, 2 - влево, 3 - вниз &nbsp;&nbsp;&nbsp;&nbsp;&nbsp;&nbsp;&nbsp;&nbsp;&nbsp;&nbsp;&nbsp;&nbsp;&nbsp;&nbsp;&nbsp;&nbsp;&nbsp;&nbsp;&nbsp;&nbsp;&nbsp;&nbsp;&nbsp;&nbsp;&nbsp;&nbsp;&nbsp;&nbsp;&nbsp;&nbsp;&nbsp;&nbsp;| для MATRIX_TYPE == 2 - не используется &nbsp;&nbsp;&nbsp;&nbsp;&nbsp;&nbsp;*&#47;</font>

<font color="#5e6d03">#define</font> <font color="#000000">META_MATRIX_WIDTH</font> <font color="#000000">45</font> &nbsp;&nbsp;&nbsp;&nbsp;<font color="#95a5a6">&#47;* количество сегментов в ширину сборной матрицы &nbsp;&nbsp;&nbsp;&nbsp;&nbsp;&nbsp;&nbsp;&nbsp;&nbsp;&nbsp;&nbsp;&nbsp;&nbsp;&nbsp;&nbsp;&nbsp;&nbsp;&nbsp;&nbsp;&nbsp;&nbsp;&nbsp;&nbsp;&nbsp;&nbsp;&nbsp;&nbsp;&nbsp;&nbsp;&nbsp;&nbsp;&nbsp;&nbsp;&nbsp;&nbsp;&nbsp;&nbsp;&nbsp;&nbsp;&nbsp;&nbsp;&nbsp;&nbsp;&nbsp;&nbsp;&nbsp;&nbsp;&nbsp;&nbsp;&nbsp;&nbsp;&nbsp;&nbsp;&nbsp;&nbsp;&nbsp;&nbsp;&nbsp;&nbsp;&nbsp;&nbsp;&nbsp;&nbsp;&nbsp;&nbsp;| для MATRIX_TYPE == 2 - не используется &nbsp;&nbsp;&nbsp;&nbsp;&nbsp;&nbsp;*&#47;</font>
<font color="#5e6d03">#define</font> <font color="#000000">META_MATRIX_HEIGHT</font> <font color="#000000">30</font> &nbsp;&nbsp;&nbsp;<font color="#95a5a6">&#47;* количество сегментов в высоту сборной матрицы &nbsp;&nbsp;&nbsp;&nbsp;&nbsp;&nbsp;&nbsp;&nbsp;&nbsp;&nbsp;&nbsp;&nbsp;&nbsp;&nbsp;&nbsp;&nbsp;&nbsp;&nbsp;&nbsp;&nbsp;&nbsp;&nbsp;&nbsp;&nbsp;&nbsp;&nbsp;&nbsp;&nbsp;&nbsp;&nbsp;&nbsp;&nbsp;&nbsp;&nbsp;&nbsp;&nbsp;&nbsp;&nbsp;&nbsp;&nbsp;&nbsp;&nbsp;&nbsp;&nbsp;&nbsp;&nbsp;&nbsp;&nbsp;&nbsp;&nbsp;&nbsp;&nbsp;&nbsp;&nbsp;&nbsp;&nbsp;&nbsp;&nbsp;&nbsp;&nbsp;&nbsp;&nbsp;&nbsp;&nbsp;&nbsp;| для MATRIX_TYPE == 2 - не используется &nbsp;&nbsp;&nbsp;&nbsp;&nbsp;&nbsp;*&#47;</font>
<font color="#5e6d03">#define</font> <font color="#000000">META_MATRIX_TYPE</font> <font color="#000000">0</font> &nbsp;&nbsp;&nbsp;&nbsp;&nbsp;<font color="#95a5a6">&#47;* тип сборной матрицы: 0 - зигзаг, 1 - параллельная &nbsp;&nbsp;&nbsp;&nbsp;&nbsp;&nbsp;&nbsp;&nbsp;&nbsp;&nbsp;&nbsp;&nbsp;&nbsp;&nbsp;&nbsp;&nbsp;&nbsp;&nbsp;&nbsp;&nbsp;&nbsp;&nbsp;&nbsp;&nbsp;&nbsp;&nbsp;&nbsp;&nbsp;&nbsp;&nbsp;&nbsp;&nbsp;&nbsp;&nbsp;&nbsp;&nbsp;&nbsp;&nbsp;&nbsp;&nbsp;&nbsp;&nbsp;&nbsp;&nbsp;&nbsp;&nbsp;&nbsp;&nbsp;&nbsp;&nbsp;&nbsp;&nbsp;&nbsp;&nbsp;&nbsp;&nbsp;&nbsp;&nbsp;&nbsp;&nbsp;&nbsp;| для MATRIX_TYPE == 2 - не используется &nbsp;&nbsp;&nbsp;&nbsp;&nbsp;&nbsp;*&#47;</font>
<font color="#5e6d03">#define</font> <font color="#000000">META_MATRIX_ANGLE</font> <font color="#000000">3</font> &nbsp;&nbsp;&nbsp;&nbsp;<font color="#95a5a6">&#47;* угол 1-го сегмента сборной матрицы: 0 - левый нижний, 1 - левый верхний, 2 - правый верхний, 3 - правый нижний | для MATRIX_TYPE == 2 - не используется &nbsp;&nbsp;&nbsp;&nbsp;&nbsp;&nbsp;*&#47;</font>
<font color="#5e6d03">#define</font> <font color="#000000">META_MATRIX_DIRECTION</font> <font color="#000000">1</font> <font color="#95a5a6">&#47;* направление следующих сегментов сборной матрицы из угла: 0 - вправо, 1 - вверх, 2 - влево, 3 - вниз &nbsp;&nbsp;&nbsp;&nbsp;&nbsp;&nbsp;&nbsp;&nbsp;&nbsp;&nbsp;&nbsp;| для MATRIX_TYPE == 2 - не используется &nbsp;&nbsp;&nbsp;&nbsp;&nbsp;&nbsp;*&#47;</font>

<font color="#5e6d03">#define</font> <font color="#000000">COLOR_ORDER</font> &nbsp;&nbsp;&nbsp;&nbsp;&nbsp;&nbsp;&nbsp;<font color="#00979c">RGB</font> &nbsp;<font color="#95a5a6">&#47;* Порядок цветов на ленте - RGB,RBG,GRB,GBR,BRG,BGR; Если цвет отображается некорректно - меняйте. Начать можно с RGB *&#47;</font>
<font color="#5e6d03">#define</font> <font color="#000000">LED_CHIP</font> &nbsp;&nbsp;&nbsp;&nbsp;&nbsp;&nbsp;<font color="#00979c">SK9822</font> &nbsp;<font color="#95a5a6">&#47;* CHIP ленты для библиотеки FASTLED - это 3-х проводные чипы с программныь SPI. &nbsp;&nbsp;&#47;&#47; Для чипов с аппаратным CLK потребуется изменить функцию allocateLeds() в utility.ino; *&#47;</font>
 &nbsp;&nbsp;&nbsp;&nbsp;&nbsp;&nbsp;&nbsp;&nbsp;&nbsp;&nbsp;&nbsp;&nbsp;&nbsp;&nbsp;&nbsp;&nbsp;&nbsp;&nbsp;&nbsp;&nbsp;&nbsp;&nbsp;&nbsp;&nbsp;&nbsp;&nbsp;&nbsp;&nbsp;&nbsp;&nbsp;&nbsp;<font color="#434f54">&#47;&#47; &nbsp;&nbsp;WS2811, WS2812, WS2812B, WS2813, WS2852, APA104, APA106, SK6812, SK6822, &nbsp;&nbsp;&nbsp;&nbsp;&nbsp;&#47;&#47; Поддерживается до 4-х сегментов вывода на свои аппаратные пины, вывод на которые</font>
 &nbsp;&nbsp;&nbsp;&nbsp;&nbsp;&nbsp;&nbsp;&nbsp;&nbsp;&nbsp;&nbsp;&nbsp;&nbsp;&nbsp;&nbsp;&nbsp;&nbsp;&nbsp;&nbsp;&nbsp;&nbsp;&nbsp;&nbsp;&nbsp;&nbsp;&nbsp;&nbsp;&nbsp;&nbsp;&nbsp;&nbsp;<font color="#434f54">&#47;&#47; &nbsp;&nbsp;TM1803, TM1804, TM1809, TM1812, TM1829, UCS1903, UCS1903B, UCS1904, UCS2903, &nbsp;&#47;&#47; назначены одинаковым LED_CHIP и COLOR_ORDER, Если ленты или порядок цвета в сегментах разные - требуется изменить функцию allocateLeds() в utility.ino;</font>
 &nbsp;&nbsp;&nbsp;&nbsp;&nbsp;&nbsp;&nbsp;&nbsp;&nbsp;&nbsp;&nbsp;&nbsp;&nbsp;&nbsp;&nbsp;&nbsp;&nbsp;&nbsp;&nbsp;&nbsp;&nbsp;&nbsp;&nbsp;&nbsp;&nbsp;&nbsp;&nbsp;&nbsp;&nbsp;&nbsp;&nbsp;<font color="#434f54">&#47;&#47; &nbsp;&nbsp;PL9823, GE8822, GS1903, GW6205, LPD1886, SM16703</font>

</pre>

<pre>
<font color="#5e6d03">#elif</font> <font color="#000000">(</font><font color="#000000">CONFIG_IDF_TARGET_ESP32S3</font><font color="#000000">)</font>
 &nbsp;<font color="#434f54">&#47;&#47; ESP32-S3 &nbsp;&nbsp;&nbsp;&nbsp;&nbsp;&nbsp;&nbsp;&nbsp;&nbsp;&nbsp;&nbsp;&nbsp;&nbsp;&nbsp;-&gt; &nbsp;&#39;ESP32S3 Dev Module&#39;</font>
 &nbsp;<font color="#5e6d03">#define</font> <font color="#000000">DATA_PIN</font> <font color="#000000">(</font><font color="#000000">14U</font><font color="#000000">)</font> &nbsp;&nbsp;&nbsp;&nbsp;&nbsp;&nbsp;&nbsp;&nbsp;<font color="#434f54">&#47;&#47; пин ленты</font>
 &nbsp;<font color="#5e6d03">#define</font> <font color="#000000">CLOCK_PIN</font> <font color="#000000">(</font><font color="#000000">22U</font><font color="#000000">)</font>
 &nbsp;<font color="#5e6d03">#define</font> <font color="#000000">PIN_BTN</font> <font color="#000000">(</font><font color="#000000">7U</font><font color="#000000">)</font> &nbsp;&nbsp;&nbsp;&nbsp;&nbsp;&nbsp;&nbsp;&nbsp;&nbsp;<font color="#434f54">&#47;&#47; кнопка подключена сюда (PIN --- КНОПКА --- GND)</font>
 &nbsp;<font color="#5e6d03">#define</font> <font color="#000000">SRX</font> <font color="#000000">(</font><font color="#000000">16U</font><font color="#000000">)</font> &nbsp;&nbsp;&nbsp;&nbsp;&nbsp;&nbsp;&nbsp;&nbsp;&nbsp;&nbsp;&nbsp;&nbsp;<font color="#434f54">&#47;&#47; пин ESP32, который подключен в TX пин (3) модуля DFPlayer</font>
 &nbsp;<font color="#5e6d03">#define</font> <font color="#000000">STX</font> <font color="#000000">(</font><font color="#000000">17U</font><font color="#000000">)</font> &nbsp;&nbsp;&nbsp;&nbsp;&nbsp;&nbsp;&nbsp;&nbsp;&nbsp;&nbsp;&nbsp;&nbsp;<font color="#434f54">&#47;&#47; пин ESP32, который подключен в RX пин (2) модуля DFPlayer</font>
 &nbsp;<font color="#5e6d03">#define</font> <font color="#000000">POWER_PIN</font> <font color="#000000">(</font><font color="#000000">6U</font><font color="#000000">)</font> &nbsp;&nbsp;&nbsp;&nbsp;&nbsp;&nbsp;&nbsp;<font color="#434f54">&#47;&#47; G6 управляющий пин вкл&#47;выкл матрицы через MOSFET или реле</font>
 &nbsp;<font color="#5e6d03">#define</font> <font color="#000000">ALARM_PIN</font> <font color="#000000">(</font><font color="#000000">5U</font><font color="#000000">)</font> &nbsp;&nbsp;&nbsp;&nbsp;&nbsp;&nbsp;&nbsp;<font color="#434f54">&#47;&#47; G5 управляющий пин вкл&#47;выкл доп.оборудование при срабатывании будильника через MOSFET &#47; реле; ALARM_ON - HIGH, ALARM_OFF - LOW</font>
 &nbsp;<font color="#5e6d03">#define</font> <font color="#000000">AUX_PIN</font> <font color="#000000">(</font><font color="#000000">4U</font><font color="#000000">)</font> &nbsp;&nbsp;&nbsp;&nbsp;&nbsp;&nbsp;&nbsp;&nbsp;&nbsp;<font color="#434f54">&#47;&#47; G4 управляющий пин вкл&#47;выкл доп.оборудование режимы по времени через MOSFET &#47; реле; AUX_ON - HIGH, AUX_OFF - LOW</font>

</pre>

Далее исправил в allocateLeds() для инициализации SK9822, добавив следующую строку:

FastLED.addLeds<SK9822, DATA_PIN, CLOCK_PIN, RGB>(leds, NUM_LEDS);

При этом убрал весь блок с case.

<pre>
<font color="#00979c">void</font> <font color="#000000">allocateLeds</font><font color="#000000">(</font><font color="#000000">)</font> <font color="#000000">{</font>
 &nbsp;<font color="#5e6d03">if</font> <font color="#000000">(</font><font color="#000000">leds</font> <font color="#434f54">!=</font> <font color="#000000">nullptr</font><font color="#000000">)</font> <font color="#000000">{</font>
 &nbsp;&nbsp;&nbsp;<font color="#000000">freeLeds</font><font color="#000000">(</font><font color="#000000">)</font><font color="#000000">;</font>
 &nbsp;<font color="#000000">}</font>

 &nbsp;<font color="#00979c">int32_t</font> <font color="#000000">freeMemory1</font> <font color="#434f54">=</font> <font color="#000000">ESP</font><font color="#434f54">.</font><font color="#000000">getFreeHeap</font><font color="#000000">(</font><font color="#000000">)</font><font color="#000000">;</font>
 &nbsp;<font color="#00979c">int32_t</font> <font color="#000000">requireMemory</font> <font color="#434f54">=</font> <font color="#000000">NUM_LEDS</font> <font color="#434f54">*</font> <font color="#00979c">sizeof</font><font color="#000000">(</font><b><font color="#d35400">CRGB</font></b><font color="#000000">)</font><font color="#000000">;</font>
 &nbsp;<font color="#5e6d03">if</font> <font color="#000000">(</font><font color="#000000">leds</font> <font color="#434f54">==</font> <font color="#000000">nullptr</font> <font color="#434f54">&amp;&amp;</font> <font color="#000000">freeMemory1</font> <font color="#434f54">&lt;=</font> <font color="#000000">requireMemory</font><font color="#000000">)</font> <font color="#000000">{</font>
 &nbsp;&nbsp;&nbsp;&nbsp;<font color="#000000">DEBUG</font><font color="#000000">(</font><font color="#000000">F</font><font color="#000000">(</font><font color="#005c5f">&#34;Недостаточно памяти для LEDS: нужно &#34;</font><font color="#000000">)</font><font color="#000000">)</font><font color="#000000">;</font>
 &nbsp;&nbsp;&nbsp;&nbsp;<font color="#000000">DEBUG</font><font color="#000000">(</font><font color="#000000">requireMemory</font><font color="#000000">)</font><font color="#000000">;</font>
 &nbsp;&nbsp;&nbsp;&nbsp;<font color="#000000">DEBUG</font><font color="#000000">(</font><font color="#000000">F</font><font color="#000000">(</font><font color="#005c5f">&#34; байт, есть &#34;</font><font color="#000000">)</font><font color="#000000">)</font><font color="#000000">;</font>
 &nbsp;&nbsp;&nbsp;&nbsp;<font color="#000000">DEBUG</font><font color="#000000">(</font><font color="#000000">freeMemory1</font><font color="#000000">)</font><font color="#000000">;</font>
 &nbsp;&nbsp;&nbsp;&nbsp;<font color="#000000">DEBUGLN</font><font color="#000000">(</font><font color="#000000">F</font><font color="#000000">(</font><font color="#005c5f">&#34; байт&#34;</font><font color="#000000">)</font><font color="#000000">)</font><font color="#000000">;</font>
 &nbsp;&nbsp;&nbsp;&nbsp;<font color="#5e6d03">return</font><font color="#000000">;</font>
 &nbsp;<font color="#000000">}</font>

 &nbsp;<font color="#000000">leds</font> <font color="#434f54">=</font> <font color="#00979c">new</font> <b><font color="#d35400">CRGB</font></b><font color="#000000">[</font><font color="#000000">NUM_LEDS</font><font color="#000000">]</font><font color="#000000">;</font>

 &nbsp;&nbsp;&nbsp;<b><font color="#d35400">FastLED</font></b><font color="#434f54">.</font><font color="#d35400">addLeds</font><font color="#434f54">&lt;</font><font color="#00979c">SK9822</font><font color="#434f54">,</font> <font color="#000000">DATA_PIN</font><font color="#434f54">,</font> <font color="#000000">CLOCK_PIN</font><font color="#434f54">,</font> <font color="#00979c">RGB</font><font color="#434f54">&gt;</font><font color="#000000">(</font><font color="#000000">leds</font><font color="#434f54">,</font> <font color="#000000">NUM_LEDS</font><font color="#000000">)</font><font color="#000000">;</font>
 &nbsp;<font color="#000000">}</font>
 &nbsp;&nbsp;&nbsp;<font color="#434f54">&#47;&#47; Максимальная частота вывода на ленту - 40 Гц</font>
 &nbsp;&nbsp;&nbsp;<b><font color="#d35400">FastLED</font></b><font color="#434f54">.</font><font color="#d35400">setMaxRefreshRate</font><font color="#000000">(</font><font color="#000000">40</font><font color="#434f54">,</font> <font color="#00979c">true</font><font color="#000000">)</font><font color="#000000">;</font>
 &nbsp;<font color="#000000">}</font>
 &nbsp;
 &nbsp;<font color="#00979c">int32_t</font> <font color="#000000">freeMemory2</font> <font color="#434f54">=</font> <font color="#000000">ESP</font><font color="#434f54">.</font><font color="#000000">getFreeHeap</font><font color="#000000">(</font><font color="#000000">)</font><font color="#000000">;</font> &nbsp;
 &nbsp;<font color="#000000">printMemoryDiff</font><font color="#000000">(</font><font color="#000000">freeMemory1</font><font color="#434f54">,</font> <font color="#000000">freeMemory2</font><font color="#434f54">,</font> <font color="#000000">F</font><font color="#000000">(</font><font color="#005c5f">&#34;Выделение памяти для LEDS &nbsp;&nbsp;: &#34;</font><font color="#000000">)</font><font color="#000000">)</font><font color="#000000">;</font>
<font color="#000000">}</font>

</pre>

Однако, чего-то не хватает, возникает ошибка, ругается на новые переменные (файл с ошибками во вложении).

Буду очень благодарен, если поможете доработать скетч под данный тип чипа ленты.

И в принципе, в будущем, пожелание - чтобы была возможность выбирать необходимый тип сразу в скетче, включая чипы подобные этому.

[1234.txt](https://github.com/user-attachments/files/18608757/1234.txt)

vvip-68, 2025-01-31:
По доработке в будущем. Это невозможно.
Вот это вот объявление типа ленты - addLeds() с параметрами - в FastLED на языке cи - это шаблон (<TEMPLATE>) который переменные не принимает, только константы - компилятор ругается если попытаться передать сюда переменную. Я не знаю как (и возможно ли) это обойти. Именно поэтому здесь вот этот огромный switch-case который вы удалили, чтобы хоть как-то из приложения настраивать пин подключения ленты и порядок цвета. Если в подобный switch-case оборачивать еще и все возможные комбинации типов лент - скетч будет десятки тысяч строк и скорее всего не влезет в память микроконтроллера. Если вы знаете как в си сделать templates принимающие переменные - welcome - расскажите, исправим.

По ошибкам.
Первое что бросается в глаза - у вас в пути к скетче библиотекам кириллица. 90% что это принесет дополнительные проблемы. Люди уже сталкивались.

В строке 582 | #define DATA_PIN (14U) // пин ленты<br>
Что это за <br> - именно на него ругается компилятор. И далее во всех местах где встречается употребление DATA_PIN соответственно компилятор выдает ошибку. Уберите вообще комментарий в этой строке - // и все что за ним до конца строки. Возможно поможет.

Далее - у вас по всему тексту встречается вот этот вот <br> который ломает весь скетч.
Такое впечатление, что скетч редактировался в каком-то онлайн web-редакторе, который все нормальные переводы строки заменил на HTML-ный  перевод строки<br>. Отсюда и всё сломано.

В общем - ваш скетч безнадежно испорчен. Скачайте заново архив с проектом и используйте нормальный редактор для внесения изменений.

vvip-68, 2025-01-31:
Еще вариант, что вы мне предоставили лог, снятый с какой-то веб-страницы и на ней вот эти ```<br>``` мешают пониманию того, что происходит - дайте нормальный лог компилятора из IDE. К тому же складывается впечатление, что лог не полный и вначале чего-то не хватает.

Начните с того, что просто уберите кириллицу из пути к файлам - возможно этого будет достаточно.
Или соберите скетч в ArduinoIDE 1.8.19 - она в отличие от 2.3.x к кириллице в путях относится более толерантно...

Mosrom, 2025-01-31:
Скетч был собран в  ArduinoIDE 1.8.19.
Путь теперь без кириллицы, папку переместил.
DATA_PIN проверил, вроде всё корректно, просто до CLOCK_PIN компиляция не дошла, остановилась на DATA_PIN.
Лог ошибок во вложении.

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

[SK9822.txt](https://github.com/user-attachments/files/18613882/SK9822.txt)

Mosrom, 2025-01-31:
> По доработке в будущем. Это невозможно. Вот это вот объявление типа ленты - addLeds() с параметрами - в FastLED на языке cи - это шаблон (`<TEMPLATE>`) который переменные не принимает, только константы - компилятор ругается если попытаться передать сюда переменную. Я не знаю как (и возможно ли) это обойти. Именно поэтому здесь вот этот огромный switch-case который вы удалили, чтобы хоть как-то из приложения настраивать пин подключения ленты и порядок цвета. Если в подобный switch-case оборачивать еще и все возможные комбинации типов лент - скетч будет десятки тысяч строк и скорее всего не влезет в память микроконтроллера. Если вы знаете как в си сделать templates принимающие переменные - welcome - расскажите, исправим.
>
> По ошибкам. Первое что бросается в глаза - у вас в пути к скетче библиотекам кириллица. 90% что это принесет дополнительные проблемы. Люди уже сталкивались.

Не в эту тему, но касательно объема занимаемой памяти скетча в связи с возросшим объемом скетча и оптимизации его работы, может подумать на тем, чтобы исключить из скетча поддержку устаревших плат на базе микроконтроллера ESP8266?

vvip-68, 2025-01-31:
По поводу лога. У меня идей нет на что ругается.
Задал вопрос в форуме - может кто что подскажет.

По поводу исключения ESP8266 - а смысл?
Код генерируемый для esp8266 и для esp32 вообще не пересекается нигде.
В зависимости от того, какой контроллер выбран - компилятор берет либо одни библиотеки / компоненты, либо другие. И вместе они никак и никогда не пересекаются.

vvip-68, 2025-01-31:
Вот умные люди сказали, что вы зря переименовали LED_PIN в DATA_PIN, потому что такое имя уже есть внутри самой библиотеки - возникает конфликт имен. Возможно CLOCK_PIN уже тоже есть определение внутри библиотеки и тоже будет ругаться. Надо назвать по-другому.

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

Пусть это будет по-прежнему
```
#define LED_PIN (14U)
#define CLK_PIN (22U)
```
И тогда в месте на картинке выше -
```
FastLED.addLeds<SK9822, LED_PIN, CLK_PIN, RGB>(leds, NUM_LEDS);
```

Mosrom, 2025-01-31:
Спасибо за подсказку, наименования пинов везде поменял.
Этот шаг пройден.

Далее ругается на пины подключения ленты:

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

[SK9822_1.txt](https://github.com/user-attachments/files/18616080/SK9822_1.txt)

vvip-68, 2025-01-31:
Могу только сказать, что не находит части функций.
Куда они делись? Не знаю.
Либо (случайно) удалили, либо структура скетча нарушена так, что оно не находит нужного.
Например лишняя скобка или отсутствие таковой когда ожидается.
Нет точки с запятой, дам где ее хочет компилятор
Несоответствие открывающих директив типа #if и нет конечной #endif
Конкретного ничего сказать не могу.

Вероятно вы удалили какую-то лишнюю часть при удалении того большого switch-case

Mosrom, 2025-01-31:
Я поэтому Вас и прошу посмотреть изменения во вкладке utility2.ino и скетч в целом на предмет ошибок, т.к. вы обладаете более глубокими познаниями в языке программирования.

Я испробовал разные варианты, похоже ошибка не в скобках, вылезает ошибка «Invalid pin specified» - т.е. почему-то не найдены определения пинов.

Посмотрите пожалуйста как будет время. Я думаю для Вас изменить в двух вкладках настройки не составит большого труда.
Очень обидно, матрица на данной ленте собрана, а запустить её не получается, я думал, что будет гораздо проще это сделать.
Готов отправить рабочую версию последней редакции Вашего скетча с библиотеками, настроенную по мой модуль ESP (без последних правок). Либо просто подскажите какие позиции во вкладке utility2.ino нужно убрать, а какие оставить под тип ленты SK9822.

Разумеется донат с меня.

vvip-68, 2025-02-01:
Как я посмотрю ваш скетч - у меня же нет его.
Ошибки в компиляторе - в первую очередь не находит функций.
Значит где-то потеряна закрывающая скобка - нарушена целостность скетча - он его даже скомпилировать не может - не находит обозначенных функций.

Тут можно запомнить строку с инициализацией addLED которая, восстановить этот исправленный файл, содержащий функцию allocateLEDS из проекта и заново править его.

Можно вернуться к ArduiunoIDE 2.3.4 - там есть функционал сворачивания блоков кода. Свернуть ненужный кусок кода - он соблюдает при сворачивании парность открывающих и закрывающих скобок и удалить целиком. Вернуть на место этот запомненный addLeds().

Про Invalid pin - ну значит указанный вами микроконтроллер не допускает использование пина 22 в качестве CLOCK_PIN - выберите другой.

Mosrom, 2025-02-12:
Спасибо за наводку по версии ArduiunoIDE 2.3.4.
Да, была ошибка в части удаленного блока, как Вы и предположили.
В IDE действительно очень наглядно видна связь структуры блоков кода.
Всё же пошел по пути удаления огромного case, скетч скомпилировался корректно!
Осталось доделать блок управления и испытать матрицу в деле.
По результату отпишусь.

Mosrom, 2025-02-20:
> Спасибо за наводку по версии ArduiunoIDE 2.3.4. Да, была ошибка в части удаленного блока, как Вы и предположили. В IDE 2.3.x действительно очень наглядно видна связь структуры блоков кода. Всё же пошел по пути удаления огромного case, скетч скомпилировался корректно! Осталось доделать блок управления и испытать матрицу в деле. По результату отпишусь.

Супер, матрица работает. Автору ещё раз огромный респект.
Одно пожелание, если добавить ещё один размер шрифта часов
для больших матриц, было бы очень здорово, например 10x14.
У меня матрица на 2640 диодов, конечно на ней часы смотрятся очень куцыми.

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

Closed 2025-02-11.

Thread 118 (2025-01-31):

Готовый образ прошивки

dmsergeevich63, 2025-01-31:
Привет, планируется сделать готовые образы(.bin) прошивок? Да, любой разбирающийся человек сам скомпилирует по инструкции на нескольких страницах. Но почему бы не популязировать прошивку готовыми образами? На сколько понимаю все настройки есть в вебе.
Если в прошивке есть параметры, которые необходимо определить перед компиляций, то можно возложить эту ношу сообщество, главное дать ему страницу, закреплению в редми .

vvip-68, 2025-01-31:
Не планируется. Слишком много вариантов / комбинаций. по подключенному оборудованию и включаемым опциям. Разные виды микроконтроллеров (целый зоопарк ESP32). У кого-то просто лента и все, ну может быть кнопка. Кто-то SD-карточку прикручивает... Кто-то плеер. Понимаю, что можно собрать простую (только лента) и /или плюс карта. Но это все рано нужно поддерживать. Это отнимает время. Не интересно.

И я не стремлюсь популяризировать прошивку. Она вообще по недоразумению стала публичной, но  мне не жалко. Изначально (да в принципе и сейчас) - это мои настольные часы с погодой и моя гирлянда на окно на новый год. То что ее люди повторяют - да ради Бога. Но к популяризации и широкому распространению я не стремлюсь.

А хотите вот как раз заняться этим - собирать готовые образы прошивки и выкладывать куда-нибудь для людей? Я на первой странице проекта в описании крупными буквами дам ссылку откуда можно будет скачивать готовые скомпилированные бинарники.

Closed 2025-02-11.

Thread 121 (2025-02-05):

Скетч слишком большой

dmsergeevich63, 2025-02-05:
При компиляции скетча для esp32 не хватает памяти для прошивки, дополнительные модули отключены
`Скетч слишком большой; прочитайте https://support.arduino.cc/hc/en-us/articles/360013825179
Скетч использует 1451817 байт (110%) памяти устройства. Всего доступно 1310720 байт.
Глобальные переменные используют 68708 байт (20%) динамической памяти, оставляя 258972 байт для локальных переменных. Максимум: 327680 байт.`
Используемые настройки платы:
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

При указании другого размера памяти устройство успешно прошивается, но нет ота, веб-интерфес постоянно теряет связь, а матрица краснеет, будто с красным фильтром, становится тусклой после смены эффекта. Последнее возможно из-за питания([решение описано, пока не применялось, на 1.13 такое было при высокой яркости](https://github.com/vvip-68/LedPanelWiFi/wiki/%D0%A2%D1%80%D0%B8-%D1%88%D0%B0%D0%B3%D0%B0-%D0%BA-%D1%83%D1%81%D0%BF%D0%B5%D1%85%D1%83.-%D0%9D%D0%B5%D0%BA%D0%BE%D1%82%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...)) Пробовал прошивки v.1.14.2025.0107 и main(0160718) от 05.02.2025.
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

dmsergeevich63, 2025-02-05:
Содержимое a_def_hard.h:
`// ****************** ПРОФИЛИ УСТРОЙСТВ *******************
//
// ВНИМАНИЕ!!!
// Рекомендации по выбору ядра для ESP32 и ESP8266 и платы для сборки в настройках Arduino IDE смотри в комментариях в начале основного файла скетча.
//
// --------------------------------------------------------

#define HOST_NAME  F("WiFiPanel")

#define LANG  'RUS'           // Определение языка параметров, передаваемых в приложение управления или Web-интерфейс 'RUS','ENG' или другой, определенный в файле a_def_lang.h
                              // Доступные языки смотри в файле a_def_lang.h; Можете при необходимости там же добавить свой язык

#define A_DEF_DEVC 0          /* 1 - Настройки профилей ваших устройств вынесены в отдельный файл "a_def_devc.h" */
                              // 0 - Настройки профиля вашего устройства размещены ниже в этом файле
                              // Файл "a_def_devc.h" в комплект не входит, нужно создать, скопировать туда настройки профилей ваших устройств
                              // Пример содержимого файла можно взять из архива public.zip и использовать его в качестве шаблона, изменив настройки в нем
                     
#define A_DEF_PASS 0          /* 1 - Настройки API KEY OpenWeatherMap в отдельном файле a_def_pass.h */
                              // 0 - Настройки API KEY OpenWeatherMap определен ниже
                              // Файл a_def_pass.h в комплект не входит, нужно создать, скопировать туда указанные строки
                              // Пример содержимого файла можно взять из архива public.zip и использовать его в качестве шаблона, изменив настройки в нем

#define INITIALIZE_TEXTS 1    /* Заполнить память текстов бегущей строки текстом из примеров при первичной загрузке прошивки или при смене значения EEPROM_OK, когда */
                              // все настройки сбрасываются в значения по-умолчанию
#define TEXT_SHIFT 1          /* На сколько колонок сдвигать бегущую строку за один раз. По умолчанию - на одну колонку */
                              // Скорость сдвига строки зависит от скорости вывода картинки на матьрицу. На больших матрицах требуется больше времени на вывод одного кадра
                              // Если вам кажется что на максимальной скорости строка все равно движется медленно - укажите параметр TEXT_SHIFT равным 2 мли 3.
                              // Тогда каждый сдвиг текста будет выполняться сразу на 2 или три колонки. Текст будет двигаться быстрее, но визуально менее плавно

#define USE_TEXT_CACHE 1      // Держать тексты бегущей строки в оперативной памяти (по возможности).
                              // Кэширование строк в памяти позволит свести к нулю время получения очередной строки для отображения
                              // Загрузка строки из файла требует некоторого времени, что вызывает торможение отображение эффекта перед показом бегущей строки
                              // Однако кэш в памяти уменьшает объем свободной оперативной памяти, что на устройствах с ESP8266 может приводить к частым
                              // перезагрузкам микроконтроллера при нехватки памяти. Тогда установите значение этого параметра в 0 - не использовать
#if defined(ESP8266)
#define TEXT_CACHE_LINE_SIZE 200   // Макс длина текста бегущей строки, которая будет кэшироваться. Более длинные строки будут по-прежнему загружаться перед использованием из файла
#else
#define TEXT_CACHE_LINE_SIZE 512   // Макс длина текста бегущей строки, которая будет кэшироваться. Более длинные строки будут по-прежнему загружаться перед использованием из файла
#endif

// Варианты профилей для устройства, выполненного на микроконтроллере ESP8266 (NodeMCU, Wemos d1 mini, ...)

#if defined(ESP8266)
#define DEVICE_VARIANT 0      /* Поставьте 0 - если ваше устройство использует только часть из доступных компонентов в схемах с ESP8266 - не полная схема */
                              // Поставьте 1 - если ваше устройство ИСПОЛЬЗУЕТ ВСЕ ВОЗМОЖНЫЕ К ПОДКЛЮЧЕНИЮ компоненты (кнопка, DFPlayer, SD-card, TM1637, управление питанием) - полная схема
                              // Для варианта DEVICE_VARIANT == 1 обязательно должен быть отключен отладочный вывод в Serial, поскольку пины контроллера, связанные с
                              // отладочным выводом (D9 и D10 / RX и TX) заняты под подключение компонент кнопки и индикатора TM1637
                     
                              // Обратите внимание - пины подключения для DEVICE_VARIANT == 0 и DEVICE_VARIANT == 1 - отличаются
                              // Выполняйте сборку устройства в соответственно с выбранной схемой
                              //
                              // При необходимости измените настройки подключении в соответсвии с вариантом вашего устройства:
                              //   для DEVICE_VARIANT == 0 --> строки 135-284
                              //   для DEVICE_VARIANT == 1 --> строки 286-414
#endif

// ===================================================================
// Если вы собираете матрицу из ленты светодиодов или ОДНОЙ готовой заводской матрицы 8x8, 16x16 или 8x32 -,
// укажите ниже в параметрах WIDTH, HEIGHT, MATRIX_TYPE, CONNECTION_ANGLE и STRIP_DIRECTION значения,
// описывающие размеры вашей матрицы, её тип (змейка / параллельная) и угол подключения.
//
// В параметры META_MATRIX_WIDTH и META_MATRIX_HEIGHT поставьте 1 (матрица состоит из одного сегмента),
// параметры META_MATRIX_TYPE, META_MATRIX_ANGLE, META_MATRIX_DIRECTION не имеют значения

// Если у вас в наличии несколько заводских матриц 8x8, 16x16 или 8x32 и вы из них собираете одну большую сборную матрицу:
//
// MATRIX_TYPE == 0 или MATRIX_TYPE == 1
//
//   Для сборной матрицы из сегментов одинакового размера и возможности их одинаковой ориентации (угол подключения и направление из угла)
//   укажите ниже в параметрах WIDTH, HEIGHT, MATRIX_TYPE, CONNECTION_ANGLE и STRIP_DIRECTION значения,
//   описывающие размеры, тип и угол подключения ОДНОГО СЕГМЕНТА вашей заводской матрицы.
//
//   WIDTH                   - ширина одной заводской матрицы - одного сегмента
//   HEIGHT                  - высота одной заводской матрицы - одного сегмента
//   MATRIX_TYPE             - тип соединения диодов в сегменте матрицы: 0 - зигзаг, 1 - параллельная
//   CONNECTION_ANGLE        - угол подключения диодов в сегменте: 0 - левый нижний, 1 - левый верхний, 2 - правый верхний, 3 - правый нижний
//   STRIP_DIRECTION         - направление ленты из угла сегмента: 0 - вправо, 1 - вверх, 2 - влево, 3 - вниз
//   MATRIX_INDEX            - не используется
//
//   META_MATRIX_WIDTH       - количество сегментов (заводских матриц) в ширину сборной матрицы
//   META_MATRIX_HEIGHT      - количество сегментов (заводских матриц) в высоту сборной матрицы
//   META_MATRIX_TYPE        - тип сборной матрицы: 0 - зигзаг, 1 - параллельная
//   META_MATRIX_ANGLE       - угол 1-го сегмента сборной матрицы: 0 - левый нижний, 1 - левый верхний, 2 - правый верхний, 3 - правый нижний
//   META_MATRIX_DIRECTION   - направление следующих сегментов сборной матрицы из угла: 0 - вправо, 1 - вверх, 2 - влево, 3 - вниз
//
//   Все сегменты (заводские матрицы) из которых собрана ваша сборная матрица должны быть одного размера и ориентированы
//   одинаково по углу подключения и направлению диодов из угла,как описано в параметрах MATRIX_TYPE, CONNECTION_ANGLE и STRIP_DIRECTION.
//   Сами сегменты (заводские матрицы) подключены по типу параллельного подключения или змейкой, последовательность соединения сегментов -
//   в соответствии с указанными параметрами META_MATRIX_TYPE, META_MATRIX_ANGLE, META_MATRIX_DIRECTION, которые имеют значения, по смыслу такие же,
//   как для подключения диодов в одной заводской матрице (MATRIX_TYPE, CONNECTION_ANGLE и STRIP_DIRECTION).
//
// MATRIX_TYPE == 2
//
//   Если ваша сборная матрица состоит из матриц различного размера (смесь разных матриц) или нет возможности сориентировать все
//   элементарные матрицы одинаково ао углу подключения и направлению из угла (ввиду длинных проводов для их соединения иежду собой) вы можете указать
//   значение MATRIX_TYPE == 2 - использовать для адресации светодиодов на ленте (перевод из координат x,y в индекс светодиода) специальный массив индексов,
//   загружаемый из файла или определенный в скетче как массив PROGMEM.
//
//   Настройки параметров матрицы для этого типа подключения (MATRIX_TYPE == 2):
//
//   WIDTH                   - полная ширина сборной матрицы, включая все сегменты
//   HEIGHT                  - полная высота  сборной матрицы, включая все сегменты
//   MATRIX_TYPE             - значение должно быть 2 - используется карта индексов
//   CONNECTION_ANGLE        - не используется
//   STRIP_DIRECTION         - не используется
//   MATRIX_INDEX            - место расположения массива индексов
//                             0 - в сектче в файле index_map.ino
//                             1 - в файле карты индексов в файловой системе микроконтроллера
//   META_MATRIX_WIDTH       - значение должно быть обязательно 1
//   META_MATRIX_HEIGHT      - значение должно быть обязательно 1
//   META_MATRIX_TYPE        - не используется
//   META_MATRIX_ANGLE       - не используется
//   META_MATRIX_DIRECTION   - не используется
//
//   Для создания индексного файла (карта индексов) используется утилита LedMapper, которая находится в папке tools проекта.
//   Имя файла индексов имеет формат "WxH.map" где W - ширина матрицы, H - высота матрицы (для матрицы 35x20 имя файла "35x20.map")
//
//   Для загрузки файла в файловую систему микроконтроллера поместите файл в папку data, находящуюся в папке скетча.
//   В меню "Инструменты" Arduino IDE в настройке распределения памяти устройства выберите вариант:
//     Для микроконтроллеров ESP8266 с 4МБ флэш-памяти рекомендуется вариант "Flash Size: 4MB(FS:2MB OTA:~1019KB)"
//     Для микроконтроллеров ESP32   с 4МБ флэш-памяти рекомендуется вариант "Partition scheme: Default 4MB with spiff(1.2MB APP/1.5MB SPIFFS)";
//
//   Загрузка выполняется утилитой "ESP8266 LittleFS Data Upload: для контроллеров на базе ESP8266
//   или утилитой "ESP32 LittleFS Data Upload: для контроллеров на базе ESP32
//   Эти утилиты находятся в папке проекта "tools/LittleFS_Uploader" - нужно установить их в IDE согласно инструкции в файлк readme
//
//   Если при старте микроконтроллер не нейдет файл в файловой системе - для адресации диодов на матрице будут использованы
//   параметры типа матрицы MATRIX_TYPE == 0 - зигзаг
//
//   При указании параметра MATRIX_INDEX == 0 - PROGMEM массив карты индексов imap размещен в скетче в файле index_map.ino
//   Замените содержимое массива imap> приведенное для примера на массив, сформированный для вашей матрице в утилите LedMapper
//

// =================== ESP8266 (NodeMCU, Wemos d1) ===================

/*
 * Wemos d1 mini (clone), NodeMCU v1.0 (ESP-12E)
 */

#if defined(ESP8266)

#if (DEVICE_VARIANT == 0)

// ===========================================================================
// ВНИМАНИЕ !!!
//
// ВСЕ НАСТРОЙКИ, ВКЛЮЧАЯ НАЗНАЧЕНИЕ ПИНОВ, ПРИМЕНЯЮТСЯ ПРИ ПЕРВОЙ ЗАГРУЗКЕ ПРОШИВКИ В ЧИСТЫЙ МИКРОКОНТРОЛЛЕР, ЗАТЕМ СОХРАНЯЮТСЯ В EEPROM
// И ПРИ СЛЕДУЮЩИХ ЗАПУСКАХ ИСПОЛЬЗУЮТСЯ ЗНАЧЕНИЯ, СОХРАНЕННЫЕ В ПАМЯТИ, А НЕ ПРОПИСАННЫЕ В СКЕТЧЕ.
//
// ЕСЛИ ВЫ ИЗМЕНИЛИ НАСТРОЙКИ ЗДЕСЬ, ДЛЯ ТОГО, ЧТОБЫ ОНИ БЫЛИ ПРИМЕНЕНЫ В ПРОШИВКЕ, ВЫПОЛНИТЕ ОДНО ИЗ СЛЕДУЮЩИХ ДЕЙСТВИЙ:
//   А) ПОСЛЕ ПРОШИВКИ ЗАЙДИТЕ В WEB-ПРИЛОЖЕНИЕ НА СТРАНИЧКУ НАСТРОЙКИ И ИЗМЕНИТЕ ПАРАМЕТРЫ И НАЗНАЧЕНИЕ ПИНОВ ТАМ
//   Б) ПЕРЕД ЗАГРУЗКОЙ ПРОШИВКИ В МИКРОКОНТРОЛЛЕР ИЗМЕНИТЕ ЗНАЧЕНИЕ КОНСТАНТЫ EEPROM_OK В ФАЙЛЕ a_def_soft.h НА любое ДРУГОЕ шестнадцатеричное значение (один байт)
//   В) ЗАГРУЖАЙТЕ ПРОШИВКУ В МИКРОКОНТРОЛЛЕР С ОПЦИЕЙ В МЕНЮ "ИНСТРУМЕНТЫ" - "Erase Flash" - "All Flash Contents" для ESP8266 или
//      "Erase all flash before sketch upload" - "Enabled" для ESP32
//
// ===========================================================================

// Для адресации строки/столбца матрицы используется тип int8_t (-128..127), т.к. нужны отрицательные значения для прокрутки часов и текста бегущей строки,
// поэтому ширина/высота матрицы не может быть больше 128

#define WIDTH 16                /* ширина одного сегмента матрицы для MATRIX_TYPE == 0 или MATRIX_TYPE == 1                                       | для MATRIX_TYPE == 2 ПОЛНАЯ ШИРИНА матрицы   */
#define HEIGHT 16               /* высота одного сегмента матрицы для MATRIX_TYPE == 0 или MATRIX_TYPE == 1                                       | для MATRIX_TYPE == 2 ПОЛНАЯ ВЫСОТА матрицы   */
#define MATRIX_TYPE 0           /* тип соединения диодов в сегменте матрицы: 0 - зигзаг, 1 - параллельная, 2 - использовать карту индексов                                                       */
#define MATRIX_INDEX 1          /* только для MATRIX_TYPE == 2 - место расположения массива индексов 0 - в сектче, 1 - в файле                    | для MATRIX_TYPE == 0 или 1 - поставьте тут 1 */
#define CONNECTION_ANGLE 1      /* угол подключения диодов в сегменте: 0 - левый нижний, 1 - левый верхний, 2 - правый верхний, 3 - правый нижний | для MATRIX_TYPE == 2 - не используется       */
#define STRIP_DIRECTION 3       /* направление ленты из угла сегмента: 0 - вправо, 1 - вверх, 2 - влево, 3 - вниз                                 | для MATRIX_TYPE == 2 - не используется       */

#define META_MATRIX_WIDTH 1     /* количество сегментов в ширину сборной матрицы                                                                  | для MATRIX_TYPE == 2 - не используется       */
#define META_MATRIX_HEIGHT 1    /* количество сегментов в высоту сборной матрицы                                                                  | для MATRIX_TYPE == 2 - не используется       */
#define META_MATRIX_TYPE 0      /* тип сборной матрицы: 0 - зигзаг, 1 - параллельная                                                              | для MATRIX_TYPE == 2 - не используется       */
#define META_MATRIX_ANGLE 0     /* угол 1-го сегмента сборной матрицы: 0 - левый нижний, 1 - левый верхний, 2 - правый верхний, 3 - правый нижний | для MATRIX_TYPE == 2 - не используется       */
#define META_MATRIX_DIRECTION 0 /* направление следующих сегментов сборной матрицы из угла: 0 - вправо, 1 - вверх, 2 - влево, 3 - вниз            | для MATRIX_TYPE == 2 - не используется       */

#define COLOR_ORDER       GRB   /* Порядок цветов на ленте - RGB,RBG,GRB,GBR,BRG,BGR; Если цвет отображается некорректно - меняйте. Начать можно с RGB */
#define LED_CHIP      WS2812B   /* CHIP ленты для библиотеки FASTLED - это 3-х проводные чипы с программным SPI.   // Для чипов с аппаратным CLK потребуется изменить функцию allocateLeds() в utility.ino; */
                                //   WS2811, WS2812, WS2812B, WS2813, WS2852, APA104, APA106, SK6812, SK6822,      // Поддерживается до 4-х сегментов вывода на свои аппаратные пины, вывод на которые
                                //   TM1803, TM1804, TM1809, TM1812, TM1829, UCS1903, UCS1903B, UCS1904, UCS2903,  // назначены одинаковым LED_CHIP и COLOR_ORDER, Если ленты или порядок цвета в сегментах разные - требуется изменить функцию allocateLeds() в utility.ino;
                                //   PL9823, GE8822, GS1903, GW6205, LPD1886, SM16703

#define DEVICE_TYPE 1           /* Использование матрицы: 0 - свернута в трубу для лампы; 1 - плоская матрица в рамке                                  */
#define BUTTON_TYPE 1           /* Тип кнопки: 0 - сенсорная (touch button); 1 - обычная кнопка на замыкание при нажатии (или если кнопки нет вообще)  */
#define USE_BUTTON 1            /* 1 - использовать кнопку управления; 0 - не использовать                                                             */
#define USE_OTA 1               /* 1 - использовать обновление "по воздуху", 0 - не использовать                                                       */
#define USE_ANIMATION 1         /* 1 - использовать эффекты "Анимация" и "Погода", 0 - не использовать                                                 */

// --- !!! Внимание - TM1637 не совместим с SD-картой,т.к. используют одни и те же линии При включенном USE_TM1637==1 SD-карта работать не будет !!! ---
// --- !!! Для совместной работы TM1637 и SD-карты исаользуйте кнофигурацию DEVICE_VARIANT == 1 -- там линии разнесены

// -------- Пины дополнительного управления - следите, чтобы при включенных USE_POWER, USE_ALARM, USE_AUX пины управления не пересекались, иначе при совпадении пинов одна фича будет включать пин, другая в то же время - выключать

#define USE_POWER 1             /* 1 - использовать отключение питания матрицы через MOSFET / реле; 0 - не использовать          */
#define POWER_ON  HIGH          /* Для включения  питания матрицы (через MOSFET/реле) подавать на пин POWER_PIN высокий уровень  */
#define POWER_OFF LOW           /* Для вЫключения питания матрицы (через MOSFET/реле) подавать на пин POWER_PIN низкий уровень   */

#define USE_ALARM 0             /* 1 - использовать включение сигнала на ALARM_PIN во время срабатывания будильника              */
#define ALARM_ON  HIGH          /* Для включения  питания матрицы (через MOSFET/реле) подавать на пин ALARM_PIN высокий уровень  */
#define ALARM_OFF LOW           /* Для вЫключения питания матрицы (через MOSFET/реле) подавать на пин ALARM_PIN низкий уровень   */

#define USE_AUX 0               /* 1 - использовать включение сигнала на AUX_PIN во время срабатывания будильника                */
#define AUX_ON  HIGH            /* Для включения  питания матрицы (через MOSFET/реле) подавать на пин AUX_PIN высокий уровень    */
#define AUX_OFF LOW             /* Для вЫключения питания матрицы (через MOSFET/реле) подавать на пин AUX_PIN низкий уровень     */

// --------

#define USE_TM1637 0            /* поставьте 1, если используется дополнительный индикатор TM1637, 0 если индикатора нет */
#define USE_WEATHER 1           /* 1 - использовать получение информации о текущей погоде; 0 - не использовать */

#define USE_E131 0              /* 1 - использовать протокол E1.31 для синхронизации устройств или приема внешнего потока на матрицу с Jinx! или другого аналогичного ПО */
#define E131_FRAME_DELAY 20     /* Минимальное время между отправкой экранов слушателем в миллисекундах */
                                /* Экран матрицы может формироваться чаще чем указанный промежуток. Если со времени предыдущей отправки кадра прошло менее E131_FRAME_DELAY миллисекунд */
                                /* кадр не отправлять. Тогда возможно подергивание на приемниках. */
                                /* Чтобы подергивания не было - нужно уменьшать это значение. Однако слишком частая отправка экранов клиентам */
                                /* может забивать сеть до полного зависания роутера и отваливания сети на всех компьютерах - зависит от производительности роутера */

#define BIG_FONT 0              /* 0 - шрифт 5x8, 1 - шрифт  10x16; 2 - шрифт 8x13 */

// --- !!! Внимание - SD-карта несовместима с TM1637 ,т.к. используют одни и те же линии. При включенном USE_TM1637==1 SD-карта работать не будет !!! ---
// --- !!! Для совместной работы TM1637 и SD-карты исаользуйте кнофигурацию DEVICE_VARIANT == 1 -- там линии разнесены

#define USE_SD 0                /* поставьте 0, если у вас нет SD-card модуля */
#define FS_AS_SD 0              /* при USE_SD == 1; FS_AS_SD == 0 - эффекты на SD-карте, 1 - эффекты в файловой ситеме МК, самого SD-card модуля нет (режим эмуляции SD-карты для эффектов 'SD-карта') */
                                // Для USE_SD == 1 - поведение при проигрывании файла эффекта с SD-карты
#define WAIT_PLAY_FINISHED 1    /* 1 - переключаться на следующий эффект только когда весь файл полностью показан; */
                                // 0 - прерывать показ файла с SD-карты по истечении времени эффекта
#define REPEAT_PLAY 0           /* 1 - повторное проигрывание текущего эффекта, если время не вышло; 0 - следующий эффект */
// -------

// DFPlayer выпускается разными производителями на разных чипах.
// Оригинальный плеер построен на микросхеме с обозначением на корпусе AS20HH5883-74
// Существует множество клонов DFPlayer от других производителей, построенных на других чипах, например MH2024K-24SS, MH2024K-16SS и др.
// Эти чипы отличаются от оригинальных несколько измененной системой команд. Библиотеке нужно знать команды в каком формате отправлять плееру.
// Укажите ниже какой чип использован в в вашем DFPlayer
// -------
#define USE_MP3 0               /* поставьте 0, если у вас нет звуковой карты MP3 плеера */
#define DFPLAYER_TYPE 0         /* 0 - AS20HH5883-74 (оригинальный); 1 - MH2024K-24SS, MH2024K-16SS (клон) */
#define GUARD_DELAY 0           /* Задержка между отправкой последовательных команд в модуль DFPlayer 0..15 мс */
                                // Рекомендуется подбирать опытным путем. Слишком большая задержка может давать суммарно до 0.5 сек замирания эффектов при начале/окончании воспроизведения звука.
                                // Слишком маленькая задержка может приводить к необнаружению плеера прошивкой или даже циклическую перезагрузку контроллера
                                // Если плеер обнаруживается прошивкой, но не удается получить список файлов с SD-карты и в приложении отсутствует выбор звуков
                                // будильника - увеличивайте значение задержки
                                //
                                // Чудеса в решете:
                                //
                                // В некоторых сборках при попытках сохранить настройки будильника или проиграть выбранный в программе в настройках звука файл                        
                                // Вызывает крах системы с перезагрузкой микроконтроллера. Крах происходит в файле библиотеки плеера DFMiniMp3.h в строке примерно 533 (в версии библиотеки 1.1.1)
                                // в функции sendPacket()
                                // в этой строке --> _serial.write(reinterpret_cast<uint8_t*>(&packet), sizeof(packet));
                                //
                                // Ошибку удалось победить добавив в начало файла DFMiniMp3.h строку 28 следующий дефайн:
                                // #define DfMiniMp3Debug Serial
                                // После компиляции сборки с этой строкой вызов функций плеера начинает "гадить" в монитор потта, но преер крашиться перестает
                                // Впрочем, если просто закомментировать эту строку и снова пересобрать программу, плеер все равно продолжает работать без "падений".
                                // Необъяснимо, но факт.
// -------

#if (USE_SD == 1 && USE_TM1637 == 1)
  // Одновременное использование SD-карты и индикатора TM1637 не поддерживается - они оба используют пины D5 и D7 - конфликт
  #error Unable to use SD-card and TM1637 display due the usage of the same conflicting pins D5 and D7 by the both devices
#endif

#define LED_PIN D2              // D2 пин ленты
#define PIN_BTN D1              // физическая кнопка подключена сюда (D1--- КНОПКА --- GND);

#define STX D3                  // подключен в RX пин (2) модуля DFPlayer
#define SRX D4                  // подключен в TX пин (3) модуля DFPlayer
#define DIO D5                  // D5 TM1637 display DIO pin - требуется для компиляции скетча (USE_TM1637 == 1) - D5 только если не подключена SD-карта, которая использунт эти пины
#define CLK D7                  // D7 TM1637 display CLK pin - требуется для компиляции скетча (USE_TM1637 == 1) - D7 только если не подключена SD-карта, которая использунт эти пины

// SD-карта подключается к аппаратным пинам SPI, которые различны для разных тип плат ESP32 - WROOM-32, S2, S3, C2, C3, C6 и определены в ядре как SS, MOSI, MISO, SCK

#define SD_CS_PIN D8            // пин выбора SD карты - D8 (CS); Также SD карта использует D5 (CLK), D6 (MISO), D7 (MOSI) (пины определены в ядре микрооконтроллера)

// Сдедите, чтобы пины дополнительного управления при включенной фиче не пересекались, иначе одна фича будет устанавливать сигнал на пине, другая снимать и ничего работать не будет
// Настраивайте эти пины из WEBUI, там есть контроль назначения пинов, исключающий их пересечение

#define POWER_PIN D0            // D0 управляющий пин вкл/выкл матрицы через MOSFET / реле; POWER_ON - HIGH, POWER_OFF - LOW
#define ALARM_PIN D0            // D0 управляющий пин вкл/выкл доп.оборудование при срабатывании будильника через MOSFET / реле; ALARM_ON - HIGH, ALARM_OFF - LOW
#define AUX_PIN D1              // D0 управляющий пин вкл/выкл доп.оборудование режимы по времени через MOSFET / реле; AUX_ON - HIGH, AUX_OFF - LOW

#define DEBUG_SERIAL 1          // включить/выключить отладочный вывод в Serial: 0 - выключено 1 - включено
#endif

#if (DEVICE_VARIANT == 1)

// ===========================================================================
// ВНИМАНИЕ !!!
//
// ВСЕ НАСТРОЙКИ, ВКЛЮЧАЯ НАЗНАЧЕНИЕ ПИНОВ, ПРИМЕНЯЮТСЯ ПРИ ПЕРВОЙ ЗАГРУЗКЕ ПРОШИВКИ В ЧИСТЫЙ МИКРОКОНТРОЛЛЕР, ЗАТЕМ СОХРАНЯЮТСЯ В EEPROM
// И ПРИ СЛЕДУЮЩИХ ЗАПУСКАХ ИСПОЛЬЗУЮТСЯ ЗНАЧЕНИЯ, СОХРАНЕННЫЕ В ПАМЯТИ, А НЕ ПРОПИСАННЫЕ В СКЕТЧЕ.
//
// ЕСЛИ ВЫ ИЗМЕНИЛИ НАСТРОЙКИ ЗДЕСЬ, ДЛЯ ТОГО, ЧТОБЫ ОНИ БЫЛИ ПРИМЕНЕНЫ В ПРОШИВКЕ, ВЫПОЛНИТЕ ОДНО ИЗ СЛЕДУЮЩИХ ДЕЙСТВИЙ:
//   А) ПОСЛЕ ПРОШИВКИ ЗАЙДИТЕ В web-ПРИЛОЖЕНИЕ НА СТРАНИЧКУ НАСТРОЙКИ И ИЗМЕНИТЕ ПАРАМЕТРЫ И НАЗНАЧЕНИЕ ПИНОВ ТАМ
//   Б) ПЕРЕД ЗАГРУЗКОЙ ПРОШИВКИ В МИКРОКОНТРОЛЛЕР ИЗМЕНИТЕ ЗНАЧЕНИЕ КОНСТАНТЫ EEPROM_OK В ФАЙЛЕ a_def_soft.h НА ДРУГОЕ
//   В) ЗАГРУЖАЙТЕ ПРОШИВКУ В МИКРОКОНТРОЛЛЕР С ОПЦИЕЙ В МЕНЮ "ИНСТРУМЕНТЫ" - "Erase Flash" - "All Flash Contents" для ESP8266 или
//      "Erase all flash before sketch upload" - "Enabled" для esp32
//
// ===========================================================================

// Для адресации строки/столбца матрицы используется тип int8_t (-128..127), т.к. нужны отрицательные значения для прокрутки часов и текста бегущей строки,
// поэтому ширина/высота матрицы не может быть больше 128

// Схему соединений смотри в папке "schemes" проекта
// ESP8266+ALL.JPG             - подключены все возможные компоненты, сенсорная кнопка (BUTTON_TYPE == 0)
#define WIDTH 16                /* ширина одного сегмента матрицы для MATRIX_TYPE == 0 или MATRIX_TYPE == 1                                       | для MATRIX_TYPE == 2 ПОЛНАЯ ШИРИНА матрицы   */
#define HEIGHT 16               /* высота одного сегмента матрицы для MATRIX_TYPE == 0 или MATRIX_TYPE == 1                                       | для MATRIX_TYPE == 2 ПОЛНАЯ ВЫСОТА матрицы   */
#define MATRIX_TYPE 0           /* тип соединения диодов в сегменте матрицы: 0 - зигзаг, 1 - параллельная, 2 - использовать карту индексов                                                       */
#define MATRIX_INDEX 1          /* только для MATRIX_TYPE == 2 место расположения массива индексов 0 - в сектче, 1 - в файле                      | для MATRIX_TYPE == 0 или 1 - поставьте тут 1 */
#define CONNECTION_ANGLE 0      /* угол подключения диодов в сегменте: 0 - левый нижний, 1 - левый верхний, 2 - правый верхний, 3 - правый нижний | для MATRIX_TYPE == 2 - не используется       */
#define STRIP_DIRECTION 0       /* направление ленты из угла сегмента: 0 - вправо, 1 - вверх, 2 - влево, 3 - вниз                                 | для MATRIX_TYPE == 2 - не используется       */

#define META_MATRIX_WIDTH 1     /* количество сегментов в ширину сборной матрицы                                                                  | для MATRIX_TYPE == 2 - не используется       */
#define META_MATRIX_HEIGHT 1    /* количество сегментов в высоту сборной матрицы                                                                  | для MATRIX_TYPE == 2 - не используется       */
#define META_MATRIX_TYPE 0      /* тип сборной матрицы: 0 - зигзаг, 1 - параллельная                                                              | для MATRIX_TYPE == 2 - не используется       */
#define META_MATRIX_ANGLE 0     /* угол 1-го сегмента сборной матрицы: 0 - левый нижний, 1 - левый верхний, 2 - правый верхний, 3 - правый нижний | для MATRIX_TYPE == 2 - не используется       */
#define META_MATRIX_DIRECTION 0 /* направление следующих сегментов сборной матрицы из угла: 0 - вправо, 1 - вверх, 2 - влево, 3 - вниз            | для MATRIX_TYPE == 2 - не используется       */

#define COLOR_ORDER        GRB  /* Порядок цветов на ленте - RGB,RBG,GRB,GBR,BRG,BGR; Если цвет отображается некорректно - меняйте. Начать можно с RGB */
#define LED_CHIP       WS2812B  /* CHIP
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

Thread 123 (2025-02-18):

Изменилась анимация сердца

dmsergeevich63, 2025-02-18:
Привет!
Заметил, что анимация сердца изменилась по сравнению с прошивкой GyverPanelWiFi. Она стало реже менять своё положение и двигаться с большим шагом. Странно, но файл Heart.h у прошивок одинаковый. В чем может быть причина? Как вернуть прошлую версию анимации?
Как было раньше: https://disk.yandex.ru/i/GBTNFwLx8Oy0Lw
[Добавление эффектов](https://github.com/vvip-68/LedPanelWiFi/wiki/%D0%94%D0%BE%D0%B1%D0%B0%D0%B2%D0%BB%D0%B5%D0%BD%D0%B8%D0%B5-%D1%81%D0%B2%D0%BE%D0%B5%D0%B9-%D0%B0%D0%BD%D0%B8%D0%BC%D0%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)

dmsergeevich63, 2025-02-20:
Да, файл heart.h не менялся, а вот в animation.ino были изменения в 469 строке. Строка относится именно к формированию анимации, изменил её на версию GyverPanelWiFi_v1.13 и сердце стало двигаться как на видео выше, на одну ячейку.
Текущая версия:
https://github.com/vvip-68/LedPanelWiFi/blob/07bac3769df16546af03240b6f6a4dbae53471a0/firmware/LedPanelWiFi_v1.14/animation.ino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

Версия GyverPanelWiFi_v1.13:
https://github.com/vvip-68/GyverPanelWiFi/blob/705a81ce8afd3878088429ce6622b317514f6c68/firmware/GyverPanelWiFi_v1.13/animation.ino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

Сравнение файлов из версий LedPanelWiFi_v1.14 и GyverPanelWiFi_v1.13:
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

vvip-68, 2025-02-20:
Да, похоже в версии 1.13 была ошибка, которую и исправили в версии 1.14.
Ошибка - несоблюдение заданных в описателе анимации временнЫх параметров.

Closed 2025-02-27.

Thread 124 (2025-03-02):

ESP32 DEV MODULE error

qulet, 2025-03-02:
Эскиз использует 1 634 733 байта (124%) памяти программы. Максимум 1310720 байт

[a_def_hard.zip](https://github.com/user-attachments/files/19044311/a_def_hard.zip)
что я могу изменить?

vvip-68, 2025-03-03:
В разметке файловой системы в меню "Инструменты" - Partition Scheme выбрать вариант с NoOTA
Либо купить плату контроллера с 8МБ памяти на борту вместо 4 МБ которую все покупают по умолчанию

Closed 2025-03-07.

Thread 125 (2025-03-07):

Невозможно открыть веб-страницу 192.168.0.100

qulet, 2025-03-07:
информация из последовательного монитора - файлы из каталога данных были загружены......

⸮ ⸮⸮⸮{R
 ⸮; >oD#⸮@	⸮⸮⸮DFPlayerError: Таймаут!
MP3 плеер недоступен.

Загрузка текстов бегущей строки:
Нет текстов бегущей строки

Папка '/web' обнаружена.
Cписок файлов web-интерфейса:
   [web]
      [a]
         [i]
            32.svg.gz                       9841
            32c3.svg.gz                     6154
            32c3m.png                      12152
            32s2.svg.gz                     9060
            32s2m.png                       5504
            32s3.svg.gz                     6411
            32s3m.png                       8480
            node.svg.gz                     6325
            w.svg.gz                         979
            wemos.svg.gz                    5018
         [l]
            eng.json.gz                    10852
            esp.json.gz                    11613
            lat.json.gz                    11414
            rus.json.gz                     8881
         tz-eng.json.gz                     5588
         tz-esp.json.gz                     5588
         tz-lat.json.gz                     5588
         tz-rus.json.gz                     6327
      chunk-3IM54G3T.js.gz                  5328
      chunk-3MQREIDX.js.gz                 10070
      chunk-46AJKIN2.js.gz                  4274
      chunk-4HEXTZCI.js.gz                  8514
      chunk-4J3ESD4K.js.gz                  8266
      chunk-5EU4XMF4.js.gz                 13644
      chunk-5QI2BH75.js.gz                  6317
      chunk-5SSDKWJM.js.gz                  9480
      chunk-64ZNTZPC.js.gz                  5579
      chunk-7KR3THG5.js.gz                   323
      chunk-7XSEAOSB.js.gz                  7099
      chunk-AYYGXFO5.js.gz                 16161
      chunk-BVJUBOFL.js.gz                   918
      chunk-CJQS6RUM.js.gz                  3835
      chunk-FJL3U3PQ.js.gz                  5558
      chunk-GTMMLIZQ.js.gz                  7459
      chunk-H2GZLP63.js.gz                  3851
      chunk-HNDY2MV5.js.gz                  2902
      chunk-IZGRH33U.js.gz                  7518
      chunk-JI7WS5WA.js.gz                  5224
      chunk-JOI7FNNI.js.gz                  1769
      chunk-JUPGJJQD.js.gz                 18603
      chunk-JVDRGJXS.js.gz                 31182
      chunk-M6HBMXOX.js.gz                  4320
      chunk-MDLLLR26.js.gz                  8613
      chunk-OMYIPD4K.js.gz                 13825
      chunk-PWLZXKIN.js.gz                  4624
      chunk-PWNYKSMO.js.gz                101185
      chunk-QAFUC2OW.js.gz                  6942
      chunk-QLME2ZFM.js.gz                 21217
      chunk-RFY37QB5.js.gz                 14600
      chunk-SQHOVU6R.js.gz                  4992
      chunk-VAHO6XIR.js.gz                  9884
      chunk-VLFI67PD.js.gz                 50715
      chunk-WGX3LEEA.js.gz                  4641
      chunk-ZFTF2I7M.js.gz                  4148
      favicon.ico.gz                         386
      index.html.gz                         3658
      main-BAOEYW26.js.gz                  22892
      [media]
         m-CIXJEH54.woff2                  59000
         w-OL2QU3PE.svg.gz                   979
      polyfills-EONH2QZO.js.gz             12434
      styles-4OBCSMOR.css.gz               10635

-------------------------------------------
Файловая система:
Использовано 1056768 из 2072576 байт
-------------------------------------------
Свободно памяти: FM: 30160  Max: 27664  Frag: 8
-------------------------------------------

Подключение к Orange_Swiatlowod_D290 -> 192.168.0.100
Нажмите на кнопку для прерывания подключения
и переход в режим точки доступа
......
WiFi подключен. IP адрес: 192.168.0.100, MAC: C4:D8:D5:2B:9F:35, hostname: WiFiPanel
MDNS - запущен

HTTP server started
Свободно памяти: FM: 28144  Max: 27664  Frag: 2
Переход в авторежим отключен
Режим: Облака
Режим: Зебра
Режим: Вышиванка
Режим: Анимация
Режим: Полосы
Режим: Слайды
Режим: Светлячки
Режим: Камин
Режим: Трафик
Режим: Конфетти

qulet, 2025-03-07:
Мой роутер видит:
IP-адрес 192.168.0.100
МАК: C4:D8:D5:2B:9F:35

vvip-68, 2025-03-08:
1.Если в сети уже есть устройство стем же IP-адресом -да,может не открываться из за конфликта адресов.
2. А роутер тоже находится в сети 192.168.0.xxx?
3. Web-сервер на микроконтроллере довольно слабенький, файлы отдает медленно, иногда загрузка прерывается.
Браузер не откроет страницу, пока не загрузит (и не сохранит в кэш) все файлы. Пробуйте несколько раз,может поможет...

Что в самом браузере в консоли разработчика по F12 на вкладке "Сеть",когда загружаются файлы страницы? Есть ли там ошибки типа "загрузка файла прервана"?

vvip-68, 2025-03-08:
Про браузер выше- вот тут есть ли незагруженные  файлы (с ошибкой загрузки)

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

qulet, 2025-03-08:
Спасибо за ваш ответ.
Я снова загрузил программу и данные, не вводя имя сети и пароль. Страница в режиме «точки доступа» работает нормально

vvip-68, 2025-03-09:
Потеряете синхронизацию времени с интернета (и время будет только если его с телефона установить как текущее) и получение текущей температуры, если она вам нужна.

А что, если из режима точки доступа в Web-приложении на вкладке Настройки / Сеть / установить имя сети и пароль подключения к ней?

vvip-68, 2025-03-09:
Вы же с Польши? Вам польский язык в интерфейсе не нужен?

vvip-68, 2025-03-09:
А,вот еще вспомнил предположение - проверьте в настройках своего роутера не стоит ли галочка "Изоляция клиентов" (Client isolation) - если она включена- каждое устройство в сети пожет отсылать данные в /из интернета, но между собой общаться не могут - изолированы. Снимите эту галочку.

qulet, 2025-03-09:
Да, я из Польши, хотелось бы, чтобы в интерфейсе и при отправке текста были польские буквы. У меня Funbox Orange 6 и я не вижу такой функции, как изоляция клиента. У меня FluidNC загружен на ESP32. Там подключение сайта работает без проблем.
У меня есть еще один вопрос. У LedPanelWiFi-main есть WEB-каталог, для чего он нужен?

qulet, 2025-03-09:
Я ввел имя сети и пароль из веб-интерфейса точки доступа, выбрал там DHCP и сохранил. соединение с ПД было потеряно. и я не могу подключиться к сайту 192.168.0.100.
PRTSCR F12 /сеть

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

qulet, 2025-03-09:
Чтобы подключиться к ESP, мне придется заново загрузить программу, удалив все данные.

qulet, 2025-03-09:
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

vvip-68, 2025-03-09:
> Да, я из Польши, хотелось бы, чтобы в интерфейсе и при отправке текста были польские буквы. У меня Funbox Orange 6 и я не вижу такой функции, как изоляция клиента. У меня FluidNC загружен на ESP32. Там подключение сайта работает без проблем. У меня есть еще один вопрос. У LedPanelWiFi-main есть WEB-каталог, для чего он нужен?

Ну это собственно и есть папка с файлами Web-интерфейса. Ее нужно загрузить в микроконтроллер. Но если вы подключаетесь к веб-интерфейсу через точку доступа - значит файлы вы залили на микроконтроллер.

vvip-68, 2025-03-09:
> Я ввел имя сети и пароль из веб-интерфейса точки доступа, выбрал там DHCP и сохранил. соединение с ПД было потеряно. и я не могу подключиться к сайту 192.168.0.100. PRTSCR F12 /сеть

Ну если вы включили DCHP- совсем не факт, что у устройства останется адрес 192.168.0.0 - скорее всего роутер выдал ему новый адрес. Какой - можно посмотреть в мониторе порта при старте микроконтроллера. Еще один способ- при работающем устройстве быстро 4 раза нажать на кнопку- тогда контроллер выведет текущий IP полученный от роутера на экран.

vvip-68, 2025-03-09:
> Чтобы подключиться к ESP, мне придется заново загрузить программу, удалив все данные. Serial Monitor: Подключение к Orange_Swiatlowod_D290 -> 192.168.0.100 Нажмите на кнопку для прерывания подключения и переход в режим точки доступа ...... WiFi подключен. IP адрес: 192.168.0.100, MAC: C4:D8:D5:2B:9F:35, hostname: WiFiPanel MDNS - запущен
>
> HTTP server started Свободно памяти: FM: 28144 Max: 27664 Frag: 2

Ну вот - пишет, что адрес 192.168.0.100- если файлы веб-интерфейса загружены в микроконтроллер - к нему должно быть возможным подключиться через браузер по этому адресу.

А что - с компьютера ping на этот адрес проходит - есть ответ от контроллера?

vvip-68, 2025-03-09:
> Да, я из Польши, хотелось бы, чтобы в интерфейсе и при отправке текста были польские буквы.

У меня есть квам коммерческое предложение.
Я добавляю в прошивку поддержку польских букв и для веб-интерфейса даю инструкции как перевести веб-интерфейс на польский. Для этого вам, как носителю языка придется перевести строки в указанных файлах с русского или английского на польский и файлы отправить мне - я включу их в следующий релиз. Выпотом обновите прошивку и зальете новую файловую систему и будет интерфейс на польском. Думаю, что если я буду переводить гугл-переводчиком это скорее всего будет не совсем корректно. Или могу перевести так,а вы потом исправите...

Что я прошу взамен. В связи с известными событиями платежи из России в интернет магазины (речь идет об Esty) заблокированы. Я не могу купить там нужное мне. Мне бы хотелось, чтобы вы купили это по возможности и переслали файлы мне. Речь идет о 5-10 долларов США. По тем же причинам - возместить данную сумму вам я не смогу,если только у вас нет карточки на которую принимаются денежные переводы из России :)

Речь идет вот об этой позиции - https://www.etsy.com/listing/1729501592/podaronaa-korobka-s-lazernoj-rezkoj-i
Текущая отображаемая цена - $3.94

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

Есть еще одна позиция, но наверное с моей стороны это будет запредельной наглостью - поэтому можно и нет...
https://www.etsy.com/listing/1509885968/dekorativnaa-derevannaa-podaronaa - эта сейчас $5.04

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

Был бы премного благодарен...

vvip-68, 2025-03-09:
В интернете очень мало информации по "Funbox Orange 6"
А он точно находится в сети 192.168.0.xxx? Какой у него самого адрес- как вы из браузера к нему подключаетесь?
Он точно поддерживает сеть WiFi 2.4ГГц в которой работает контроллер.Если только 5ГГц- контроллер не сможет подключиться.

Судя по скриншоту F12 - браузер не может ничего вообще получить с этого адреса. Ping с компа на микроконтроллер проходит? Ответ есть?

vvip-68, 2025-03-09:
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

Вот на этом фото роутера написано - что его сеть по умолчанию - 192.168.**1**.xxx
Чтобы микроконтроллер мог быть доступен в сети через роутер - он тоже должен находиться в сети 192.168.**1**.xxx - а не 192.168.**0**.xxx как задано по умолчанию.  Нужно или в настройках скетча изменить адрес микроконтроллера по умолчанию или все же использовать DHCP

qulet, 2025-03-09:
Я готов купить вышеуказанный товар и отправить его по указанному адресу.
Фанбокс:
IPv4-адрес 83.11.135.173
Тип доступа FTTH
 Мой FluidNC ESP32 работает по адресу 192.168.1.22
С DHCP адрес просто 0.0.0.0?

vvip-68, 2025-03-09:
Если ставите галочку DHCP - оставьте поле IP адреса вообще пустым.
Какой адрес будет получен - видно в мониторе порта при старте скетча или по 4-хкратному нажатию кнопки, подключенной к контроллеру.

За покупку - огромное спасибо.
Поддержку польского - добавлю на неделе.
Файлы которые нужно перевести - напишу где что и как.

qulet, 2025-03-09:
При покупке я могу предоставить вам адрес, по которому вы сможете забрать товар.
Пожалуйста, отправьте его мне, и я оформлю покупку сегодня за 5 долларов.
Я отправил электронное письмо с адреса:
quletqwert@gmail.com

Closed 2025-03-11.

Thread 126 (2025-03-09):

Бегущая строка на двух разных лентах

SSergeyS-34, 2025-03-09:
При изготовлении гирлянды 18х12 оказалось, что два куска не GRB а RGB. Подключил их в конце, посадил на пин2 и исправил это в WEB интерфейсе, всё работает правильно. Но когда идёт бегущая строка то в этом месте где две линии RGB "месиво" световое и когда строка уже пости прошла там всё равно хаотично светятся диоды. Такое впечатление, что бегущая строка идет отдельно и по пину D1 и по пину D2. Настройки матрицы 18х12, начало внизу с лева и вверх. Настройка "оборудования" GRB D1- 0-192 и RGB D2 - 0-24. Как можно это исправить?

vvip-68, 2025-03-09:
Так у вас в настройках диапазоны перекрываются. Нужно на D1 указать номера первого отрезка, на D2 - второго.
Типа для D1 - с 0 192 штуки, для D2 - с 193 и 24 штуки

SSergeyS-34, 2025-03-09:
Огромное спасибо! Всё получилось.

Closed 2025-03-09.

Thread 127 (2025-03-11):

Не создается точка доступа PanelAp.

Immanior, 2025-03-11:
Доброго времени суток.  Пишу от безысходности уже.
Решил увеличить размер матрицы с 12ч10 на 16x13 и заодно сделать прозрачные соединительные провода. Гирлянду распаял заново. Но столкнулся с большой (для меня проблемой).
При подключении платы к гирлянде моргает из 208 светодиодов только 120. Причем именно с 1 по 120. Если взять с 121 по 208 и поставить эти столбики в начало гирлянды – они там работают.
При попытке перепрошить микроконтроллер на обновленный размер – данные не сохраняются в него.
После перезагрузки сеть PanelAP почему-то не создается. Создаётся сеть Гусь. Почему именно она – я не знаю. Оставлял управление ребенку на новый год. После нового года забрал плату в командировку и готовлюсь к новому году заранее.
 Помогите! Что делаю не так?
Что значит "ПЕРЕД ЗАГРУЗКОЙ ПРОШИВКИ В МИКРОКОНТРОЛЛЕР ИЗМЕНИТЕ ЗНАЧЕНИЕ КОНСТАНТЫ EEPROM_OK В ФАЙЛЕ a_def_soft.h НА ДРУГОЕ" Какое другое?

### WiFiPanel v.1.14.2023.0602
Контроллер: 'NodeMCU'
Версия ядра: ESP8266 v3.1.2
Версия EEPROM: 0xA5
Host: 'WiFiPanel'

Инициализация файловой системы...
Использовано 1671168 из 2072576 байт

Нет конфигурации сети: SSID не задан
Нет конфигурации сети: пароль не задан

Матрица: плоская 12x10
Адресация: по подключению
  Угол:   Направление:   Тип: зигзаг
Вывод на ленту:
  Линия 1 PIN=D2, START=0, COUNT=120

Доступные возможности:
+ Язык интерфейса: RUS
+ Бегущая строка: шрифт 5x8
+ Кнопка управления: тактовая PIN=D4
+ Синхронизация времени с сервером NTP
- Управление питанием
- Получение информации о погоде
+ Управление через Web-канал
- Групповая синхронизация по протоколу E1.31
- Дополнительный индикатор TM1637
+ Эффекты Jinx! с SD-карты CS=D8, CLK=D5, MISO=D6, MOSI=D7
- Поддержка MP3 Player

Выделение памяти для LEDS   : 29504 -> 29136 -- 368
Выделение памяти для OVERLAY: 29136 -> 28768 -- 368

Выбранные эффекты и их порядок:
   01. Радуга
   02. Спектрум
   03. Звёзды
   04. Трафик
   05. Дождь
   06. Снегопад
   07. Синусы
   08. The Matrix
   09. Плазма
   10. Цветной шум
   11. Водоворот
   12. Огонь
   13. Шарики
   14. Звездопад
   15. Мерцание
   16. Светлячки
   17. Змейка
   18. Лабиринт

Отключенные эффекты:
   Часы
   Лампа
   Кубик
   Пейнтбол
   Конфетти
   Облака
   Лава
   Радужные переливы
   Павлин
   Зебра
   Шумящий лес
   Морской прибой
   Смена цвета
   Циклон
   Северное сияние
   Тени
   Тетрис
   Арканоид
   Палитра
   Вышиванка
   Камин
   Стрелки
   Анимация
   Погода
   Узоры
   Рубик
   Штора
   Слайды
   Рассвет
   SD-Карта

Поиск файлов карт индексов...
Нет файлов карт индексов

Инициализация SD-карты...
SD-карта подключена.
Поиск файлов эффектов Jinx!..
Папка с эффектами /12x10 не обнаружена.
Эффекты Jinx! на SD-карте не обнаружены

Найденные анимации:
   Сердце	8x8

Поиск слайдов на FS в папке '12p10'...
Поиск слайдов на FS в папке '16p16'...
Слайды не найдены. Будут использованы картинки эффекта 'Погода'

Папка '/web' обнаружена.
Cпискок файлов web-интерфейса:
   [web]
      MI.122e921fbc0a837a.woff2            59000
      [assets]
         [images]
            esp32.png                       7978
            nodemcu.png                    10874
            wemos.png                      12207
         [langs]
            eng.json.gz                     8596
            esp.json.gz                     8844
            rus.json.gz                     6712
      favicon.ico.gz                         386
      index.html.gz                         1413
      main.e44c7c6a45b2d807.js.gz         337831
      pf.dcddd532a07c6b2d.js.gz            11979
      runtime.7882e08c7503fb34.js.gz         638
      styles.7e4222ebe23cabfb.css.gz       13020
      wallet.f3b77cb2a7aa9496.png.gz        1169
Свободно памяти: 28616
Создание точки доступа Гусь
..........
Не удалось создать WiFi точку доступа.
Создание точки доступа Гусь
..........
Не удалось создать WiFi точку доступа.
HTTP server started
Свободно памяти: 25568
Переход в авторежим отключен
Режим: Выключено

vvip-68, 2025-03-11:
Ну так то размер матрицы настраивается в Web-интерфейсе.
Если хотите именно в скетче- нужно заливать прошивку с полнойочисткой памяти.

Как по мне -так в Web указать размер проще

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

Immanior, 2025-03-11:
Огромное вам спасибо за ответ!
_Ну или в настройках компиляции в меню "Инструменты" выбрать опцию "Erase all content"для стирания всей памяти перед очередной загрузкой скетча_
Это у меня выставлено значение. Несколько раз проверил - не стирает почему-то.

_Ну тут два варианта - или ваш ребенок переименовал имя точки доступа с PanelAP на этого самого Гуся,
либо микроконтроллер подключается к локальной сети и в случае успешного подключения точку доступа он не создает (если не указано принудительное создание даже в случае успешного подключения к сети), а Гусь - это вообще что-то постороннее_
Ребенок действительно переименовал сеть в веб интерфейсе. Сознался. Зачем? Руки чесались у программиста. Локальной сети с таким именем у меня не было.
 Вот что пишет в нижнем окне при перепрошивке МК.
```
[LittleFS] data    : E:\LedPanelWiFi-main\LedPanelWiFi-main\firmware\LedPanelWiFi_v1.14\data
[LittleFS] size    : 2024
[LittleFS] page    : 256
[LittleFS] block   : 8192
/16p13/airplan.p
/16p13/arrow-dn.p
/16p13/arrow-lt.p
/16p13/arrow-rt.p
/16p13/arrow-up.p
/16p13/ball.p
/16p13/bird.p
/16p13/butterfly.p
/16p13/cat.p
/16p13/clock.p
/16p13/comet.p
/16p13/cookman1.p
/16p13/elka.p
/16p13/fish.p
/16p13/fox.p
/16p13/fox1.p
/16p13/frog.p
/16p13/frog2.p
/16p13/frog3.p
/16p13/gift.p
/16p13/hand.p
/16p13/heart.p
/16p13/jinn.p
/16p13/kaktus.p
/16p13/karate.p
/16p13/lebedev.p
/16p13/man2.p
/16p13/mario.p
/16p13/minion.p
/16p13/moon.p
/16p13/moroz1.p
/16p13/mouse.p
/16p13/night_town.p
/16p13/parrot.p
/16p13/pigeon.p
/16p13/rocket.p
/16p13/smile1.p
/16p13/smile2.p
/16p13/smile3.p
/16p13/smile4.p
/16p13/smile5.p
/16p13/snowman.p
/16p13/spiderman.p
/16p13/squares.p
/16p13/star1.p
/16p13/termo.p
/16p13/test.p
/16p13/weather.p
/16p13/winter.p
/16p13/zayka.p
/16x13/Fireworks.out
/16x13/Mill.out
/16x13/Psycho.out
/16x13/Stars.out
/web/assets/images/esp32.png
/web/assets/images/nodemcu.png
/web/assets/images/wemos.png
/web/assets/langs/eng.json.gz
/web/assets/langs/esp.json.gz
/web/assets/langs/rus.json.gz
/web/favicon.ico.gz
/web/index.html.gz
/web/main.e44c7c6a45b2d807.js.gz
/web/MI.122e921fbc0a837a.woff2
/web/pf.dcddd532a07c6b2d.js.gz
/web/runtime.7882e08c7503fb34.js.gz
/web/styles.7e4222ebe23cabfb.css.gz
/web/wallet.f3b77cb2a7aa9496.png.gz
[LittleFS] upload  : C:\Temp\arduino_build_549059/LedPanelWiFi_v1.14.mklittlefs.bin
[LittleFS] address : 0x200000
[LittleFS] reset   : --before default_reset --after hard_reset
[LittleFS] port    : COM11
[LittleFS] speed   : 921600
[LittleFS] python   : C:\Users\Admin\AppData\Local\Arduino15\packages\esp8266\tools\python3\3.7.2-post1\python3.exe
[LittleFS] uploader : C:\Users\Admin\AppData\Local\Arduino15\packages\esp8266\hardware\esp8266\3.1.2\tools\upload.py

esptool.py v3.0
Serial port COM11
Connecting......
Chip is ESP8266EX
Features: WiFi
Crystal is 26MHz
MAC: 8c:aa:b5:0c:d4:bd
Uploading stub...
Running stub...
Stub running...
Changing baud rate to 460800
Changed.
Configuring flash size...
Auto-detected Flash size: 4MB
Compressed 2072576 bytes to 628829...
Writing at 0x00200000... (2 %)
Writing at 0x00204000... (5 %)
Writing at 0x00208000... (7 %)
Writing at 0x0020c000... (10 %)
Writing at 0x00210000... (12 %)
Writing at 0x00214000... (15 %)
Writing at 0x00218000... (17 %)
Writing at 0x0021c000... (20 %)
Writing at 0x00220000... (23 %)
Writing at 0x00224000... (25 %)
Writing at 0x00228000... (28 %)
Writing at 0x0022c000... (30 %)
Writing at 0x00230000... (33 %)
Writing at 0x00234000... (35 %)
Writing at 0x00238000... (38 %)
Writing at 0x0023c000... (41 %)
Writing at 0x00240000... (43 %)
Writing at 0x00244000... (46 %)
Writing at 0x00248000... (48 %)
Writing at 0x0024c000... (51 %)
Writing at 0x00250000... (53 %)
Writing at 0x00254000... (56 %)
Writing at 0x00258000... (58 %)
Writing at 0x0025c000... (61 %)
Writing at 0x00260000... (64 %)
Writing at 0x00264000... (66 %)
Writing at 0x00268000... (69 %)
Writing at 0x0026c000... (71 %)
Writing at 0x00270000... (74 %)
Writing at 0x00274000... (76 %)
Writing at 0x00278000... (79 %)
Writing at 0x0027c000... (82 %)
Writing at 0x00280000... (84 %)
Writing at 0x00284000... (87 %)
Writing at 0x00288000... (89 %)
Writing at 0x0028c000... (92 %)
Writing at 0x00290000... (94 %)
Writing at 0x00294000... (97 %)
Writing at 0x00298000... (100 %)
Wrote 2072576 bytes (628829 compressed) at 0x00200000 in 17.1 seconds (effective 971.1 kbit/s)...
Hash of data verified.

Leaving...
Hard resetting via RTS pin...

```
Далее мне нужно нажать клавишу Reset на моей платке D1miniMicro USB?
Увы первый раз зашивал года 3 назад. И не вспомню. Может проще новую плату купить?

vvip-68, 2025-03-12:
1. Никогда не сталкивался с таким,чтобы не стирало. Тут ничего тогда не подскажу.
2. То что выше-это не перепрошивка МК. Это загрузка файловой системы в микроконтроллер. А это совсем другое.
3. Обычно после завершения прошивки или загрузки файловой системы микроконтроллер сам перезапускается.У меня только один ESP32S3 требует нажатия на кнопку Reset/ Впрочем - нажатие на нее после прошивки / загрузки - ничего плохого не сделает.
4. Плату новую стоит купить в плане,чтобы была запасная / подменная. А так и эта вполне себе нормально работает.

Immanior, 2025-03-12:
1. Посыпаю голову пеплом.
2.  Понял.
3. У меня почему-то МК не перезапускается. Раньше точно перезапускался. Может в этом и есть проблема.
4. Размеры матрицы настроить не смог. Так как не могу зайти в веб интерфейс. Создается этот гусь - его нигде не видно.
PanelAP тоже нет.

vvip-68, 2025-03-12:
Тут какое-то противоречие - "создается этот гусь" - и "его нигде не видно".
А как вы про него тогда узнали?
Понятно что если создается гусь - то PanelAP не будет фигурировать. Точнее гусь это и есть PanelAP.
Вам шашечки или ехать? Вы можете подключиться к этому гусю?

Immanior, 2025-03-12:
Да. подключиться к этой непонятной сети тоже не могу. Ее не видят ни мой комп, ни мой телефон

vvip-68, 2025-03-12:
Ну, видимо,имя точки доступа должно быть латиницей, иначе микроконтроллер не может создать ее.
Об чём прямо и пишет.
Тогда единственный способ-перепрошить микроконтроллер с полной очисткой памяти.

Immanior, 2025-03-12:
Чтобы перепрошить с полной очисткой памяти я:
0. Подключаю абсолютно голую плату к компу (отпаяв все кнопки и флэшки)
1. В 7 строчке кода
#define EEPROM_OK 0x67 // Флаг, показывающий, что EEPROM инициализирована корректными данными
выставил другое число. ( было 0xA5)
2. Вкладка инструменты в строчке Erase flash выставил all flash contents.
3. Нажимаю ESP8266 LittleFS Data Upload.
жду
4. Запускаю монитор порта и вижу.
Не удалось создать WiFi точку доступа.
HTTP server started
Свободно памяти: 25344
Переход в авторежим отключен
Режим: Выключено

Выкидывать плату?

vvip-68, 2025-03-12:
Я только не понимаю,почему вы вместо того,чтобы скомпилировать и загрузить прошивку все время просто загружаете в нее файловую систему? Так - ничего не поменяется. А микроконтроллер думаю рабочий - не нужно его выкидывать.

vvip-68, 2025-03-12:
https://github.com/vvip-68/LedPanelWiFi/wiki/Пошаговая-инструкция-подготовки-среды-и-сборка-проекта#шаг-9

Immanior, 2025-03-13:
Благодарю. Был без интернета - не мог проверить. Сейчас пройдусь с самого начала по вашему совету.

vvip-68, 2025-03-17:
Если бы вы еще в комментариях в главном файле прочитали какие версии ядра и какие версии библиотек нужны для проекта - вообще б замечательно было.
Спойлер - с первыми попавшимися версиями , найденными где-нибудь в интернете - проект работать не будет.
Именно это у вас и происходит. Вместо того, чтобы взять ТРЕБУЕМУЮ проектам версию в данном случае FastLED, вы скачали  и установили первую попавшуюся...

Immanior, 2025-03-17:
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

Я сделал что-то не так??

Closed 2025-03-17.

Thread 128 (2025-03-17):

плохо отображается web интерфейс

pashkatara, 2025-03-17:
помогите в какую сторону мне смотреть, а так проект огонь, давно что подобное хотел повторить для дома

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

vvip-68, 2025-03-17:
Ну у вас шрифт не загрузился,который иконки отображает.
Шрифт находится в папке с файлами веб-страницы , файл называется m-CIXJEH54.woff2
Находится в папке sata/web/media
Это странно. Потому что в версиях этого года у этого файла высший приоритет и пока он не загрузится страница вообще не должна бы отображаться.

Проверьте, что этот файл есть в файловой системе в папке web - она распечатывается в мониторе порта при старте микроконтроллера
Попробуйте несколько раз подряд обновить страницу в браузере через Ctrl-F5 и/или Ctrl-Shift-R
Файл должен загрузится в кэш браузера
Откройте панель разработчика в браузере по кнопке F12 и перейдите во вкладку Сеть
Обновите страницу - убедитесь что в консоли браузера нет файлов с ошибками вообще и что файл шрифта тоже загрузился.

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

pashkatara, 2025-03-17:
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
в папке media есть

pashkatara, 2025-03-17:
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

pashkatara, 2025-03-17:
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

pashkatara, 2025-03-17:
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

pashkatara, 2025-03-17:
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

pashkatara, 2025-03-17:
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

pashkatara, 2025-03-17:
вроде загружал по инструкции

pashkatara, 2025-03-17:
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

pashkatara, 2025-03-17:
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

pashkatara, 2025-03-17:
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

pashkatara, 2025-03-17:
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

vvip-68, 2025-03-17:
Скачайте лучше проект с репозитория.
На представленных скриншотах у вас вообще лишние папки которых быть не должно - папка src например. И еще ряд файлов, которых в папке data быть не должно.  Понятия не имею откуда вы  это взяли - но структура файловой системы (а может и не только ее) - испорчена.
Я не знаю- может быть там не только лишние файлы, но и каких-то не хватает.

pashkatara, 2025-03-17:
ооо вроде появилось

pashkatara, 2025-03-17:
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

pashkatara, 2025-03-17:
Спасибо большое, что помогли!!!

Closed 2025-03-17.

Thread 131 (2025-06-17):

Есть ли возможность выводить стационарный текст?

OlegusMDH, 2025-06-17:
У меня 10 ws1228b матриц 8*8.
Хотел вывести по одной букве отдельно на каждую панель.
В WLED (https://kno.wled.ge/) такое получается, но там нет русских шрифтов.
В LedPanelWiFi отлично работает Бегущая строка, но можно выставить минимальную скорость только 1.
Есть возможность выводить текст/символы стационарно? По 1шт на матрицу?
Если есть, то прошу подсказать как сделать.
Если нет, такой возможности, то какой модуль лучше было бы дописать - новый эффект? Или как-то расширять функционал Бегущей строки?

Closed 2025-06-17.
