vvip-68/LedPanelWiFi/firmware/LedPanelWiFi_v1.14/runningText.ino

void InitializeTexts() {

  textIndecies = F("##");
  textAllowWeekDays.reserve(7);
  textWithEvents.reserve(36);
  textsNotEmpty.reserve(36);
  TEXTS_MAX_COUNT = 0;                    // Пока не проверена файловая система - считать что строк недоступно - 0
    
  if (!LittleFS.exists(FPSTR(FS_TEXT_STORAGE))) {
    int8_t num = CountTokens(FPSTR(FS_TEXT_STORAGE), '/');
    String path; path.reserve(strlen_P(FS_TEXT_STORAGE));
    
    for (int8_t i = 1; i <= num; i++) {
      #if defined(ESP8266)
      ESP.wdtFeed();
      #else
      delay(1);
      #endif
      path += GetToken(FPSTR(FS_TEXT_STORAGE), i, '/');
      if (path.length() != 0) {
        if (!LittleFS.exists(path)) {
          if (!LittleFS.mkdir(path)) {
            DEBUG(FPSTR(MSG_FOLDER_CREATE_ERROR)); DEBUG(F(" '")); DEBUG(path); DEBUGLN('\'');
            return;
          }
        }
      }
      path += '/';
    }    
  }

  TEXTS_MAX_COUNT = 36;  // Длина - 36 - столько строк поддeрживается - '0'..'9','A'..'Z'

  DEBUGLN();
  DEBUGLN(F("Загрузка текстов бегущей строки:"));  

  // получить строку статусов массива строк текстов бегущей строки
  //  0 - серый - пустая
  //  1 - черный - отключена
  //  2 - зеленый - активна - просто текст, без макросов
  //  3 - фиолетовый - активна, содержит макросы кроме даты
  //  4 - синий - активная, содержит макрос даты
  //  5 - красный - для строки 0 - это управляющая строка
  
  char buf[TEXTS_MAX_COUNT + 1];
  memset(buf, '\0', TEXTS_MAX_COUNT + 1);

  // Как показала практика, если у пользователя выбрано INITIALIZE_TEXTS == 0 (не инициализировать текст бегущих строк) - файлы всё равно нужно создать, но с пустым содержимым.
  // В противном случае - если файла нет, а режим вывода строк включен - скетч начинает перебирать (запрашивать) файлы, которых нет, это занимает
  // значительное время, когда останавливается все и система упорно пытается загрузить содержимое несуществующих файлов - система "зависает".
  
  for (uint8_t i=0; i < TEXTS_MAX_COUNT; i++) {
    #if defined(ESP8266)
    ESP.wdtFeed();
    #else
    delay(1);
    #endif
    char charIndex = getAZIndex(i);
    String fileName(FS_TEXT_STORAGE); fileName += '/'; fileName += charIndex;
    if (!LittleFS.exists(fileName)) {
      switch (i) {
        #if (INITIALIZE_TEXTS == 0)       
          case 0:  saveTextLine('0', ""); break;
          case 1:  saveTextLine('1', ""); break;
          case 2:  saveTextLine('2', ""); break;
          case 3:  saveTextLine('3', ""); break;
          case 4:  saveTextLine('4', ""); break;
          case 5:  saveTextLine('5', ""); break;
          case 6:  saveTextLine('6', ""); break;
          case 7:  saveTextLine('7', ""); break;
          case 8:  saveTextLine('8', ""); break;
          case 9:  saveTextLine('9', ""); break;
          case 10: saveTextLine('A', ""); break;
          case 11: saveTextLine('B', ""); break;
          case 12: saveTextLine('C', ""); break;
          case 13: saveTextLine('D', ""); break;
          case 14: saveTextLine('E', ""); break;
          case 15: saveTextLine('F', ""); break;
          case 16: saveTextLine('G', ""); break;
          case 17: saveTextLine('H', ""); break;
          case 18: saveTextLine('I', ""); break;
          case 19: saveTextLine('J', ""); break;
          case 20: saveTextLine('K', ""); break;
          case 21: saveTextLine('L', ""); break;
          case 22: saveTextLine('M', ""); break;
          case 23: saveTextLine('N', ""); break;
          case 24: saveTextLine('O', ""); break;
          case 25: saveTextLine('P', ""); break;
          case 26: saveTextLine('Q', ""); break;
          case 27: saveTextLine('R', ""); break;
          case 28: saveTextLine('S', ""); break;
          case 29: saveTextLine('T', ""); break;
          case 30: saveTextLine('U', ""); break;
          case 31: saveTextLine('V', ""); break;
          case 32: saveTextLine('W', ""); break;
          case 33: saveTextLine('X', ""); break;
          case 34: saveTextLine('Y', ""); break;
          case 35: saveTextLine('Z', ""); break; 
        #else
          case 0:  saveTextLine('0', textLine_0); break;
          case 1:  saveTextLine('1', textLine_1); break;
          case 2:  saveTextLine('2', textLine_2); break;
          case 3:  saveTextLine('3', textLine_3); break;
          case 4:  saveTextLine('4', textLine_4); break;
          case 5:  saveTextLine('5', textLine_5); break;
          case 6:  saveTextLine('6', textLine_6); break;
          case 7:  saveTextLine('7', textLine_7); break;
          case 8:  saveTextLine('8', textLine_8); break;
          case 9:  saveTextLine('9', textLine_9); break;
          case 10: saveTextLine('A', textLine_A); break;
          case 11: saveTextLine('B', textLine_B); break;
          case 12: saveTextLine('C', textLine_C); break;
          case 13: saveTextLine('D', textLine_D); break;
          case 14: saveTextLine('E', textLine_E); break;
          case 15: saveTextLine('F', textLine_F); break;
          case 16: saveTextLine('G', textLine_G); break;
          case 17: saveTextLine('H', textLine_H); break;
          case 18: saveTextLine('I', textLine_I); break;
          case 19: saveTextLine('J', textLine_J); break;
          case 20: saveTextLine('K', textLine_K); break;
          case 21: saveTextLine('L', textLine_L); break;
          case 22: saveTextLine('M', textLine_M); break;
          case 23: saveTextLine('N', textLine_N); break;
          case 24: saveTextLine('O', textLine_O); break;
          case 25: saveTextLine('P', textLine_P); break;
          case 26: saveTextLine('Q', textLine_Q); break;
          case 27: saveTextLine('R', textLine_R); break;
          case 28: saveTextLine('S', textLine_S); break;
          case 29: saveTextLine('T', textLine_T); break;
          case 30: saveTextLine('U', textLine_U); break;
          case 31: saveTextLine('V', textLine_V); break;
          case 32: saveTextLine('W', textLine_W); break;
          case 33: saveTextLine('X', textLine_X); break;
          case 34: saveTextLine('Y', textLine_Y); break;
          case 35: saveTextLine('Z', textLine_Z); break; 
        #endif
      }
      yield();
    }

    String text(loadTextByIndex(i));
    
    #if (USE_TEXT_CACHE == 1)
      // Если разрешено кэширование текстов бегущей строки и длина строки менее предельного размера - 
      // сохранить в кэш саму строку. Если размер строки - более предельного размера - поместить в строку "флажок" '{^}' указывающий на то, что данную строку нужно брать из файла
      textLines[i] = text.length() <= TEXT_CACHE_LINE_SIZE ? text : "{^}";
    #endif

    if (text.length() > 0) {
      DEBUG("  "); DEBUG(getAZIndex(i)); DEBUG(": "); DEBUGLN(text);
    }

    // Проверить строку на наличие макроса события {P}/ Если есть добавить в строку индексов строк с отслеживаемыми событиями
    if (text.indexOf("{P") >= 0) {
      textWithEvents += charIndex;
    }
    
    // Для строки с индексом 0 проверить - является ли она управляющей
    if (i == 0) {     
      textIndecies = getTextIndeciesLine(text);
      if (!isFirstLineControl()) textIndecies = "";
    }    
    buf[i] = getTextStateChar(i, text);

    // Если строка не пустая - добавить ее в строку индексов непустых строк
    // В дальнейшем для определения какую строку показывать это позволит избежать 
    // открытие файлов и чтение их содержимого чтобы понять пустая строка или нужно искать другую.
    if (text.length() > 0) {
      textsNotEmpty += charIndex;
    }
  }  

  if (textsNotEmpty.length() == 0) {
    DEBUGLN(F("Нет текстов бегущей строки"));  
  }
  DEBUGLN();
  
  textStates =  String(buf);
  ResetRunningTextFlags();
  
  sequenceIdx = isFirstLineControl() ? 1 : -1;
}

String getTextIndeciesLine(const String& str) {
  int brk_pos = str.indexOf('\n');
  if (brk_pos < 0) return isNightClock ? "" : str;
  
  String s_out = isNightClock ? str.substring(brk_pos) : str.substring(0, brk_pos); 
  s_out.replace('\r', ' ');
  s_out.replace('\n', ' ');
  s_out.trim();

  return s_out.charAt(0) == '#' ? s_out : "";
}

char getTextStateChar(uint8_t i, const String& text) {
  char c = '0';    // статус - пустая
  if (text.length() > 0) {
    if (i == 0 && text[0] == '#')
      c = '5';     // статус - строка 0 - управляющая последовательность
    else if (text[0] == '-' || text.indexOf("{-}") >=0)
      c = '1';     // статус - отключена
    else if (text.indexOf("{") < 0)
      c = '2';     // статус - текст без макросов
    else if (text.indexOf("{") >= 0 && text.indexOf("{D") < 0 && text.indexOf("{R") < 0 && text.indexOf("{P") < 0 && text.indexOf("{S") < 0)
      c = '3';     // статус - текст с макросами, но без дато-зависимых макросов
    else if (text.indexOf("{D") >= 0 || text.indexOf("{R") >= 0 || text.indexOf("{P") >= 0 || text.indexOf("{S") >= 0)
      c = '4';     // статус - текст с дато-зависимыми макросами
  }
  return c;  
}

void runningText() {
  String text;
  if (thisMode == MC_TEXT) {
    FastLED.clear();    
    // Включен режим (не оверлей!) бегущей строки
    if (wifi_print_version) 
      text = FIRMWARE_VER;
    else if (wifi_print_ip_text) 
      text = wifi_current_ip;
    else if (init_time)
      text = clockCurrentText();
    else
      text = FIRMWARE_VER;
  } else {
    
    // Обычно отображаемые буквы - UTF-8 состоят из двух байт. Исключение из поддерживаемых символов - символ евро '€', который состоит из 4 байт - [226, 98, 0, 140] - занимает 4 позиции в строке.
    // Два лишних байта отображаются как пробел - пустое место. Если их не отображать (пропускать) - отображение бегущей строки обрывается (заканчивается) до того как последний символ скроется с экрана
    // Временное решение - заменить символ евро на двухбайтовый UTF-8, но который отсутствует в шрифте и отображать вместо него знак евро.
    if (currentText.indexOf("€") >= 0) {
      currentText.replace("€", "¶");
    }

    // Если выводимая строка содержит макросы - обработать их
    if (currentText.indexOf('{') != -1) {
      currentText = processMacrosInText(currentText); 
    }
    
    // Вывод текста оверлея бегущей строки
    textHasDateTime = init_time && (currentText.indexOf("{D") >= 0 || currentText.indexOf("{R") >= 0 || currentText.indexOf("{P") >= 0 || currentText.indexOf("{S") >= 0);  
    if (textHasDateTime) {
      text = processDateMacrosInText(currentText);          // Обработать строку, превратив макросы даты в отображаемые значения
      if (text.length() == 0) {                             // Если дата еще не инициализирована - вернет другую строку, не требующую даты
         fullTextFlag = true;                               // Если нет строк, не зависящих от даты - вернется пустая строка - отображать нечего
         return;
      }      
    } else {
      text = currentText;                                   // Строка не содержит изменяемых во времени компонентов - отобразить ее как есть
    }

    // Когда показывается строка-заместитель после наступления события у нее может остаться в начале строки знак '-' или макрос {-}, отключающие строку
    // от штатного показа при переборе строк - удалить их из строки
    if (text.charAt(0) == '-') text.setCharAt(0, ' ');
    if (text.indexOf("{-}") != -1) text.replace("{-}", "");

    // Если в строке еще остались необработанные макросы цвета, если строка содержала дату, 
    // которую подставили чуть выше - обработать макросы цвета
    int16_t idx = text.indexOf("{C");
    if (idx != -1) {
      textHasMultiColor = checkIsTextMultiColor(text);     
      text = processColorMacros(text);      
      if (!textHasMultiColor) {
        useSpecialTextColor = true;
        specialTextColor = idx == 0 ? textColor[0] : textColor[1];
      }
    }
  }

  fillString(text);
}

void fillString(const String& text) {
  
  if (loadingTextFlag) {
    offset = pWIDTH;   // перемотка в правый край
    // modeCode = MC_TEXT;
    loadingTextFlag = false;  
    
  }
    
  uint32_t color;

  // Для многоцветной строки начальный цвет хранится в textColor[0]
  // Задан ли специальный цвет отображения строки?
  // Если режим цвета - монохром (0) или задан неверно (>2) - использовать глобальный или специальный цвет
  
  uint16_t i = 0, j = 0, pos = 0, modif = 0, restSec = -1, restTextOffset = 0, restTextWidth = 0;
  bool showRestSeconds = false;
  String restSecStr;

  if (momentIdx >= 0 && momentTextIdx >= 0 && pTextCount > 0 && isPTextCentered) {
    // Отображаемый текст - с макросом {P} и один раз он уже отобразился полностью, 
    // текст содержит флаг отображения остатка секнд по центру матрицы и остаток времени до события - менее минуты
    // Теперь просто отображаем остчет оставшегося времени по центру матрицы

    // Сколько секунд осталось до события?
    restSec = moments[momentIdx].moment - *now();
    showRestSeconds = restSec > 0 && restSec < 60;
    
    // Остаток секунд в виде строки
    restSecStr = padNum(restSec,2);

    // Получить ширину строки в точках, чтобы высчитать центр отображения на матрице
    restTextWidth = 2 * LET_WIDTH + SPACE;    

    // Начальная позиция вывода остатка секунд по центру экрана
    restTextOffset = ((pWIDTH - restTextWidth) / 2);
  }
  
  while (true) {

    // Для режима ночной бегущей строки - все цвета игнорировать, рисовать цветом ночных часов
    if (isNightClock) {
      color = getNightClockColorByIndex(nightClockColor); 
    } else {
      // Если строка - многоцветная (содержит несколько макросов определения цвета) - определить каким цветом выводится текущая буква строки
      if (textHasMultiColor) {
        if (pos < (MAX_COLORS - 1) && i >= textColorPos[pos + 1]) {      
          pos++;
        }      
        color = pos < MAX_COLORS ? textColor[pos] : globalTextColor;
      } else {
        // 0 - монохром: 1 - радуга; 2 -  каждая буква свой цвет
        color = COLOR_TEXT_MODE;
        if (color == 0 || color > 2) {
          color = useSpecialTextColor ? specialTextColor : globalTextColor;  
        }
      }
    }

    if (showRestSeconds) {

      // Определились с цветом - выводим очередную цифру  
      drawLetter(j, restSecStr[i], 0, restTextOffset + j * (LET_WIDTH + SPACE), color);
      j++;
      
      if (restSecStr[i] == '\0') break;
      i++; 
      
    } else {

      // Определились с цветом - выводим очередную букву  
      if ((uint16_t)text[i] > 191) {    // работаем с русскими буквами!
        modif = (uint16_t)text[i];
      } else {
        drawLetter(j, text[i], modif, offset + j * (LET_WIDTH + SPACE), color);
        j++;
        modif = 0;
      }
      if (text[i] == '\0') break;
      i++;
      
    }

  }
  fullTextFlag = false;

  // Строка убежала?
  if (offset < -j * (LET_WIDTH + SPACE)) {
    offset = pWIDTH + 3;
    fullTextFlag = true;
    if (momentIdx >= 0 && momentTextIdx >= 0) pTextCount++;
  }      
  
}

// Вычислить прямоугольник в котором будет выводиться бегущая строка
void calcTextRectangle() {
  
  // Левый нижний угол прямоугольника, высоту и ширину области вывода бегущей строки - ширина на всю матрицу,
  // высота - размер шрифта, с учетом диакритических символов под и над символом шрифта
  // с учетом позиции вывода текста по Y со смещением textOffcetY, 
  
  text_overlay_low  = getTextY(); 
  text_overlay_high = text_overlay_low + LET_HEIGHT - 1;
  
  #if   (BIG_FONT == 0)           // 3x5    + диакритика - 2 строки над и 1 под символом
  text_overlay_low -= 1;
  text_overlay_high += 2;
  #elif (BIG_FONT == 1)           // 10x16  + диакритика - 3 строки над и 2 под символом
  text_overlay_low -= 1;
  text_overlay_high += 3;
  #else                           // 8x13   + диакритика - 3 строки над и 2 под символом
  text_overlay_low -= 1;
  text_overlay_high += 3;
  #endif

  // Скорректировать если вышли за размеры матрицы по высоте
  while (text_overlay_low < 0) text_overlay_low++;
  while (text_overlay_high > pHEIGHT - 1) text_overlay_high--;  
}

uint8_t getTextY() {
  int8_t LH = LET_HEIGHT;
  if (LH > pHEIGHT) LH = pHEIGHT;
  int8_t offset_y = (pHEIGHT - LH) / 2;     // по центру матрицы по высоте
  #if (BIG_FONT == 2)
    offset_y--;                             // на 1 строку ниже для большого шрифта, иначе шрифт 8x13 не влазит по вертикали диакритич. символы на матрице 16x16
  #endif
  return offset_y + textOffsetY; 
}

// -----------------------------------------------------------------------
// Отрисовка букв алфавита на матрице
// -----------------------------------------------------------------------

bool drawLetter(uint8_t index, uint8_t letter, uint8_t modif, int16_t offset, uint32_t color) {
  
  int8_t LH = LET_HEIGHT;
  if (LH > pHEIGHT) LH = pHEIGHT;

  int8_t start_pos = 0, finish_pos = LET_WIDTH;
  int8_t offset_y = getTextY();
  
  CRGB letterColor;
  if (color == 1) letterColor = CHSV(uint8_t(offset * 10), 255, 255);
  else if (color == 2) letterColor = CHSV(uint8_t(index * 30), 255, 255);
  else letterColor = color;

  if (offset < -LET_WIDTH || offset > pWIDTH) return false;
  if (offset < 0) start_pos = -offset;
  if (offset > (pWIDTH - LET_WIDTH)) finish_pos = pWIDTH - offset;

  for (uint8_t i = start_pos; i < finish_pos; i++) {
    int32_t  thisByte; // байт колонки i отображаемого символа шрифта или -1 если такого символа нет в шрифте
    uint16_t diasByte; // байт колонки i отображаемого диакритического символа
    int8_t   diasOffs; // смещение по Y отображения диакритического символа: diasOffs > 0 - позиция над основной буквой; diasOffs < 0 - позиция ниже основной буквы
    int32_t pn;        // номер пикселя в массиве leds[]
    
    if (MIRR_V) {
      thisByte = getFont(letter, modif, LET_WIDTH - 1 - i);
      diasByte = getDiasByte(letter, modif, LET_WIDTH - 1 - i);
    } else {
      thisByte = getFont(letter, modif, i);
      diasByte = getDiasByte(letter, modif, i);
    }

    // Если такого символа нет в шрифте - ничего не рисовать
    if (thisByte < 0) return false;
    
    diasOffs = getDiasOffset(letter, modif);

    for (uint8_t j = 0; j < LH; j++) {
      bool thisBit;

      if (MIRR_H) thisBit = thisByte & (1 << j);
      else        thisBit = thisByte & (1 << (LH - 1 - j));

      // рисуем столбец буквы шрифта (i - горизонтальная позиция, j - вертикальная)      
      if (thisBit) { 
        int8_t y = offset_y + j;
        if (y >= 0 && y < pHEIGHT) {
          pn = getPixelNumber(offset + i, offset_y + j);
          if (pn < NUM_LEDS) {
            leds[pn] = letterColor;
          }
        }
      }

      if (MIRR_H) thisBit = diasByte & (1 << j);
      else        thisBit = diasByte & (1 << (LH - 1 - j));

      // рисуем столбец диакритического символа (i - горизонтальная позиция, j - вертикальная)      
      if (thisBit) { 
        int8_t y = offset_y + j + diasOffs;
        if (y >= 0 && y < pHEIGHT) {
          pn = getPixelNumber(offset + i, y);
          if (pn >= 0 && pn < NUM_LEDS) {
            leds[pn] = letterColor;
          }
        }
      }
    }
  }
  return true;
}

#if (BIG_FONT == 0)
 // Шрифт меньше/равно 8 точек - достаточно байта
 #define read_char pgm_read_byte
#else
 // Шрифт меньше/равно 16 точек - достаточно двух байт (word)
 #define read_char pgm_read_word
#endif


// интерпретатор кода символа в массиве fontHEX (для Arduino IDE 1.8.* и выше)
int32_t getFont(uint8_t font, uint8_t modif, uint8_t row) {
  font = font - '0' + 16;   // перевод код символа из таблицы ASCII в номер согласно нумерации массива    
 
  //DEBUGLN("modif=" + String(modif) + "; font=" + String(font));

  if (font <= 94) {
    return read_char(&(fontHEX[font][row]));       // для английских букв и символов
  } else if (modif == 209 && font == 116) {        // є
    return read_char(&(fontHEX[161][row])); 
  } else if (modif == 209 && font == 118) {        // і
      return read_char(&(fontHEX[73][row])); 
  } else if (modif == 209 && font == 119) {        // ї
      return read_char(&(fontHEX[162][row])); 
  } else if (modif == 209 && font == 113) {        // ё
      return read_char(&(fontHEX[132][row])); 
  } else if (modif == 208 && font == 100) {        // Є
      return read_char(&(fontHEX[160][row])); 
  } else if (modif == 208 && font == 102) {        // І
    return read_char(&(fontHEX[41][row])); 
  } else if (modif == 208 && font == 103) {        // Ї
    return read_char(&(fontHEX[41][row])); 
  } else if (modif == 208 && font == 97) {         // Ё
    return read_char(&(fontHEX[100][row]));     
  } else if ((modif == 208 || modif == 209) && font >= 112 && font <= 159) {         // и пизд*ц для русских
    return read_char(&(fontHEX[font - 17][row]));
  } else if ((modif == 208 || modif == 209) && font >= 96 && font <= 111) {
    return read_char(&(fontHEX[font + 47][row]));
  } else if (modif == 194) {                                          
    switch (font) {
      case 129: return read_char(&(fontHEX[166][row]));                              // Знак ¡
      case 144: return read_char(&(fontHEX[159][row]));                              // Знак градуса '°'
      case 150: return read_char(&(fontHEX[165][row]));                              // Знак евро '€' - реально '¶' - замена в runningText(), т.к. работает с оно-двух-байтовыми символами UTF-8, а евро - 4 байта, что ломает алгоритм
      case 159: return read_char(&(fontHEX[167][row]));                              // Знак ¿
    }    
  } else if (modif == 195) {
    switch (font) {
      case 127: return read_char(&(fontHEX[163][row])); // ß - 195 127 - 163         // Индекс строки в массиве fontHex - 163
      case 100: return read_char(&(fontHEX[33][row]));  // Ä - 195 100 - 33
      case 118: return read_char(&(fontHEX[47][row]));  // Ö - 195 118 - 47
      case 124: return read_char(&(fontHEX[53][row]));  // Ü - 195 124 - 53
      case 132: return read_char(&(fontHEX[65][row]));  // ä - 195 132 - 65
      case 150: return read_char(&(fontHEX[79][row]));  // ö - 195 150 - 79
      case 156: return read_char(&(fontHEX[85][row]));  // ü - 195 156 - 85    
      case 97:  return read_char(&(fontHEX[33][row]));  // Á - 195 97  - 33          
      case 105: return read_char(&(fontHEX[37][row]));  // É - 195 105 - 37          
      case 109: return read_char(&(fontHEX[41][row]));  // Í - 195 109 - 41          
      case 115: return read_char(&(fontHEX[47][row]));  // Ó - 195 115 - 47          
      case 122: return read_char(&(fontHEX[53][row]));  // Ú - 195 122 - 53          
      case 113: return read_char(&(fontHEX[46][row]));  // Ñ - 195 114 - 46          
      case 129: return read_char(&(fontHEX[65][row]));  // á - 195 129 - 65
      case 137: return read_char(&(fontHEX[69][row]));  // é - 195 137 - 69
      case 141: return read_char(&(fontHEX[164][row])); // í - 195 141 - 164
      case 147: return read_char(&(fontHEX[79][row]));  // ó - 195 147 - 79
      case 154: return read_char(&(fontHEX[85][row]));  // ú - 195 154 - 85    
      case 145: return read_char(&(fontHEX[78][row]));  // ñ - 195 145 - 78      
    }
  } else if (modif == 196 || modif == 197) {                                         // Буквы литовского алфавита  Ą Č Ę Ė Į Š Ų Ū Ž ą č ę ė į š ų ū ž
    if (modif == 196) {
      switch (font) {
        case  96: return read_char(&(fontHEX[33][row])); //Ā 196    96  -     33
        case  97: return read_char(&(fontHEX[65][row])); //ā 196    97  -     65
        case 100: return read_char(&(fontHEX[33][row])); //Ą 196   100  -     33 
        case 102: return read_char(&(fontHEX[35][row])); //Ć 196   102  -     35 
        case 103: return read_char(&(fontHEX[67][row])); //ć 196   103  -     67 
        case 114: return read_char(&(fontHEX[37][row])); //Ē 196   114  -     37
        case 115: return read_char(&(fontHEX[69][row])); //ē 196   115  -     69
        case 138: return read_char(&(fontHEX[41][row])); //Ī 196   138  -     41
        case 139: return read_char(&(fontHEX[73][row])); //ī 196   139  -     73
        case 101: return read_char(&(fontHEX[65][row])); //ą 196   101  -     65
        case 130: return read_char(&(fontHEX[39][row])); //Ģ 196   130  -     39
        case 131: return read_char(&(fontHEX[71][row])); //ģ 196   131  -     71
        case 150: return read_char(&(fontHEX[43][row])); //Ķ 196   150  -     43
        case 151: return read_char(&(fontHEX[75][row])); //ķ 196   151  -     75
        case 155: return read_char(&(fontHEX[44][row])); //Ļ 196   155  -     44
        case 156: return read_char(&(fontHEX[76][row])); //ļ 196   156  -     76
      }
    }  
    if (modif == 197) {
      switch (font) {
        case 138: return read_char(&(fontHEX[53][row])); //Ū 197   138  -     53
        case 139: return read_char(&(fontHEX[85][row])); //ū 197   139  -     85
        case  97: return read_char(&(fontHEX[168][row]));//Ł 197   99   -    168
        case  98: return read_char(&(fontHEX[76][row])); //ł 197   99   -     76
        case  99: return read_char(&(fontHEX[46][row])); //Ń 197   99   -     46
        case 100: return read_char(&(fontHEX[78][row])); //ń 197   100  -     78
        case 101: return read_char(&(fontHEX[46][row])); //Ņ 197   101  -     46
        case 102: return read_char(&(fontHEX[78][row])); //ņ 197   102  -     78
        case 122: return read_char(&(fontHEX[51][row])); //Ś 197   122  -     51
        case 123: return read_char(&(fontHEX[83][row])); //ś 197   123  -     83
        case 153: return read_char(&(fontHEX[58][row])); //Ź 197   153  -     58 
        case 154: return read_char(&(fontHEX[90][row])); //ź 197   154  -     90
        case 155: return read_char(&(fontHEX[58][row])); //Ż 197   155  -     58 
        case 156: return read_char(&(fontHEX[90][row])); //ż 197   156  -     90
      }
    }
    switch (font) {
      case 108: return read_char(&(fontHEX[35][row])); //Č 196   108  -     35
      case 109: return read_char(&(fontHEX[67][row])); //č 196   109  -     67  
      case 118: return read_char(&(fontHEX[37][row])); //Ė 196   118  -     37
      case 119: return read_char(&(fontHEX[69][row])); //ė 196   119  -     69
      case 120: return read_char(&(fontHEX[37][row])); //Ę 196   120  -     37
      case 121: return read_char(&(fontHEX[69][row])); //ę 196   121  -     69
      case 128: return read_char(&(fontHEX[51][row])); //Š 197   128  -     51
      case 129: return read_char(&(fontHEX[83][row])); //š 197   129  -     83
      case 142: return read_char(&(fontHEX[41][row])); //Į 196   142  -     41
      case 143: return read_char(&(fontHEX[73][row])); //į 196   143  -     73
      case 146: return read_char(&(fontHEX[53][row])); //Ų 197   146  -     53
      case 147: return read_char(&(fontHEX[85][row])); //ų 197   147  -     85
      case 157: return read_char(&(fontHEX[58][row])); //Ž 197   157  -     58
      case 158: return read_char(&(fontHEX[90][row])); //ž 197   158  -     90
    }
  }
  return -1;
}

uint16_t getDiasByte(uint8_t font, uint8_t modif, uint8_t row) {
  font = font - '0' + 16;   // перевод код символа из таблицы ASCII в номер согласно нумерации массива
    // 0 - Ё - две точки над буквой Ё Ä Ö Ü ё ä,ö,ü
    // 1 - Č - перевернутая крышечка над заглавной буквой Č Ž č ž
    // 2 - Ė - точка над заглавной буквой Ė ė
    // 3 - Ū - надстрочная черта над заглавной буквой Ū ū
    // 4 - Ą - хвостик снизу букв Ą ą Ę ę ų - смещение к правому краю буквы
    // 5 - Į - хвостик снизу букв Į į Ų     - по центру буквы    
    // 6 - Á - ударение над буквами Á, É, Í, Ó, Ú, á, é, í, ó, ú - по центру буквы    
    // 7 - Ñ - тильда над буквой Ñ  - по центру буквы    
    // 8 - Ģ - запятая под буквами Ģ, Ķ, Ļ, Ņ - по центру буквы    
    // 9 - Ł - польское перечеркивание в буквах Ł, ł
  if ((modif == 208 && font == 97) || (modif == 195 && (font == 100 || font == 118 || font == 124))) {         // Ё, немец. Ä,Ö,Ü
    return read_char(&(diasHEX[0][row])); 
  } else if ((modif == 209 && font == 113) || (modif == 195 && (font == 132 || font == 150 || font == 156))) { // ё, немец. ä,ö,ü
    return read_char(&(diasHEX[0][row])); 
  } else if ((modif == 208) && font == 103) {      // Ї
    return read_char(&(diasHEX[0][row])); 
  } else if (modif == 195) {                                                          // Буквы испанского алфавита  Á, É, Í, Ó, Ú, Ü, Ñ, á, é, í, ó, ú, ü, ñ
    switch (font) {
      case 97:  return read_char(&(diasHEX[6][row])); //Á 195    97  -     33          
      case 105: return read_char(&(diasHEX[6][row])); //É 195    105 -     37          
      case 109: return read_char(&(diasHEX[6][row])); //Í 195    109 -     41          
      case 115: return read_char(&(diasHEX[6][row])); //Ó 195    115 -     47          
      case 122: return read_char(&(diasHEX[6][row])); //Ú 195    122 -     53          
      case 113: return read_char(&(diasHEX[7][row])); //Ñ 195    114 -     46          
      case 129: return read_char(&(diasHEX[6][row])); //á 195    129 -     65
      case 137: return read_char(&(diasHEX[6][row])); //é 195    137 -     69
      case 147: return read_char(&(diasHEX[6][row])); //ó 195    147 -     79
      case 154: return read_char(&(diasHEX[6][row])); //ú 195    154 -     85    
      case 145: return read_char(&(diasHEX[7][row])); //ñ 195    145 -     78      
    }
  } else if (modif == 196 || modif == 197) {                                           // Буквы литовского алфавита  Ą Č Ę Ė Į Š Ų Ū Ž ą č ę ė į š ų ū ž
    if (modif == 196) {
      switch (font) {
        case  96: return read_char(&(diasHEX[3][row])); //Ā 196    96  -     37
        case  97: return read_char(&(diasHEX[3][row])); //ā 196    97  -     37
        case 100: return read_char(&(diasHEX[4][row])); //Ą 196   100  -     65
        case 101: return read_char(&(diasHEX[4][row])); //ą 196   101  -     65
        case 102: return read_char(&(diasHEX[6][row])); //Ć 196   102  -     35
        case 103: return read_char(&(diasHEX[6][row])); //ć 196   103  -     67
        case 114: return read_char(&(diasHEX[3][row])); //Ē 196   114  -     37
        case 115: return read_char(&(diasHEX[3][row])); //ē 196   115  -     69
        case 121: return read_char(&(diasHEX[5][row])); //ę 196   121  -     69
        case 130: return read_char(&(diasHEX[8][row])); //Ģ 196   130  -     39
        case 131: return read_char(&(diasHEX[6][row])); //ģ 196   131  -     71
        case 138: return read_char(&(diasHEX[3][row])); //Ī 196   138  -     41
        case 139: return read_char(&(diasHEX[3][row])); //ī 196   139  -     73      
        case 150: return read_char(&(diasHEX[8][row])); //Ķ 196   150  -     43
        case 151: return read_char(&(diasHEX[8][row])); //ķ 196   151  -     75
        case 155: return read_char(&(diasHEX[8][row])); //Ļ 196   155  -     44
        case 156: return read_char(&(diasHEX[8][row])); //ļ 196   156  -     76
      }
    }  
    if (modif == 197) {
      switch (font) {
        case  97: return read_char(&(diasHEX[10][row]));//Ł 197    97  -     44
        case  98: return read_char(&(diasHEX[9][row])); //ł 197    98  -     76
        case  99: return read_char(&(diasHEX[6][row])); //Ń 197    99  -     46
        case 100: return read_char(&(diasHEX[6][row])); //ń 197   100  -     78 
        case 101: return read_char(&(diasHEX[8][row])); //Ņ 197   101  -     46
        case 102: return read_char(&(diasHEX[8][row])); //ņ 197   102  -     78
        case 121: return read_char(&(diasHEX[4][row])); //ę 196   121  -     69
        case 122: return read_char(&(diasHEX[6][row])); //Ś 197   122  -     51
        case 123: return read_char(&(diasHEX[6][row])); //ś 197   123  -     83
        case 138: return read_char(&(diasHEX[3][row])); //Ū 197   138  -     53
        case 139: return read_char(&(diasHEX[3][row])); //ū 197   139  -     85      
        case 153: return read_char(&(diasHEX[6][row])); //Ź 197   153  -     58
        case 154: return read_char(&(diasHEX[6][row])); //ź 197   154  -     90
        case 155: return read_char(&(diasHEX[2][row])); //Ż 197   155  -     58
        case 156: return read_char(&(diasHEX[2][row])); //ż 197   156  -     90
      }
    }
    switch (font) {
      case 108: return read_char(&(diasHEX[1][row])); //Č 196   108  -     35
      case 120: return read_char(&(diasHEX[4][row])); //Ę 196   120  -     37
      case 118: return read_char(&(diasHEX[2][row])); //Ė 196   118  -     37
      case 142: return read_char(&(diasHEX[5][row])); //Į 196   142  -     41
      case 128: return read_char(&(diasHEX[1][row])); //Š 197   128  -     51
      case 146: return read_char(&(diasHEX[5][row])); //Ų 197   146  -     53
      case 157: return read_char(&(diasHEX[1][row])); //Ž 197   157  -     58
      case 109: return read_char(&(diasHEX[1][row])); //č 196   109  -     67  
      case 119: return read_char(&(diasHEX[2][row])); //ė 196   119  -     69
      case 143: return read_char(&(diasHEX[5][row])); //į 196   143  -     73
      case 129: return read_char(&(diasHEX[1][row])); //š 197   129  -     83
      case 147: return read_char(&(diasHEX[4][row])); //ų 197   147  -     85
      case 158: return read_char(&(diasHEX[1][row])); //ž 197   158  -     90      
    }
  }
  return 0;
}

int8_t getDiasOffset(uint8_t font, uint8_t modif) {
  font = font - '0' + 16;   // перевод код символа из таблицы ASCII в номер согласно нумерации массива
  if ((modif == 208 && font == 97) || (modif == 195 && (font == 100 || font == 118 || font == 124))) {         // Ё, немец. Ä,Ö,Ü
    return 3; 
  } else if ((modif == 209 && font == 113) || (modif == 195 && (font == 132 || font == 150 || font == 156))) { // ё, немец. ä,ö,ü
    #if (BIG_FONT == 0)
      return 1; 
    #else
      return 0; 
    #endif  
  } else if ((modif == 208) && font == 103) {      // Ї
    return 3; 
  } else if (modif == 195) {                       // Буквы испанского алфавита  Á, É, Í, Ó, Ú, Ü, Ñ, á, é, í, ó, ú, ü, ñ
    #if (BIG_FONT == 0)
      switch (font) {
        case 97:  return 2; //Á 195    97  -     33          
        case 105: return 2; //É 195    105 -     37          
        case 109: return 2; //Í 195    109 -     41          
        case 115: return 2; //Ó 195    115 -     47          
        case 122: return 2; //Ú 195    122 -     53          
        case 113: return 3; //Ñ 195    114 -     46          
        case 129: return 1; //á 195    129 -     65
        case 137: return 1; //é 195    137 -     69
        case 147: return 1; //ó 195    147 -     79
        case 154: return 0; //ú 195    154 -     85    
        case 145: return 1; //ñ 195    145 -     78      
      }
    #else
      switch (font) {
        case 97:  return 3; //Á 195    97  -     33          
        case 105: return 3; //É 195    105 -     37          
        case 109: return 3; //Í 195    109 -     41          
        case 115: return 3; //Ó 195    115 -     47          
        case 122: return 3; //Ú 195    122 -     53          
        case 113: return 3; //Ñ 195    114 -     46          
        case 129: return 0; //á 195    129 -     65
        case 137: return 0; //é 195    137 -     69
        case 147: return 0; //ó 195    147 -     79
        case 154: return 0; //ú 195    154 -     85    
        case 145: return 0; //ñ 195    145 -     78      
      }
    #endif
  } else if (modif == 196 || modif == 197) {       // Буквы литовского алфавита  Ą Č Ę Ė Į Š Ų Ū Ž ą č ę ė į š ų ū ž                          
    // Смещение надстрочных заглавных - 3          // Буквы латышского алфавита  Ā ā Č č Ē ē Ģ ģ Ī ī Ķ ķ Ļ ļ Ņ ņ Š š Ū ū Ž ž
    // Смещение надстрочных маленьких букв - 0 или 1
    // Смещение подстрочного символа -1
    #if (BIG_FONT == 0)
      if (modif == 196) {
        switch (font) {
          case  96: return  3; //Ā 196    96
          case  97: return  1; //ā 196    97
          case 100: return -1; //Ą 196   100
          case 102: return  2; //Ć 196   102
          case 103: return  1; //ć 196   103
          case 114: return  3; //Ē 196   114
          case 115: return  1; //ē 196   115
          case 101: return -1; //ą 196   101
          case 130: return -1; //Ģ 196   130
          case 131: return  1; //ģ 196   131
          case 150: return -1; //Ķ 196   150
          case 151: return -1; //ķ 196   151
          case 155: return -1; //Ļ 196   155
          case 156: return -1; //ļ 196   156
        }
      }
      if (modif == 197) {
        switch (font) {
          case  97: return  0; //Ł 197    97
          case  98: return  0; //ł 197    98
          case  99: return  2; //Ń 197    99
          case 100: return  1; //ń 197   100
          case 101: return -1; //Ņ 197   101
          case 102: return -1; //ņ 197   102
          case 122: return  2; //Ś 197   122
          case 123: return  1; //ś 197   123
          case 153: return  2; //Ź 197   153
          case 154: return  1; //ź 197   154
          case 155: return  3; //Ż 197   155
          case 156: return  1; //ż 197   156
        }
      }
      switch (font) {
        case 108: return  2; //Č 196   108
        case 120: return -1; //Ę 196   120
        case 118: return  3; //Ė 196   118
        case 142: return -1; //Į 196   142
        case 128: return  2; //Š 197   128
        case 146: return -1; //Ų 197   146
        case 138: return  3; //Ū 197   138
        case 157: return  2; //Ž 197   157
        case 109: return  0; //č 196   109
        case 121: return -1; //ę 196   121
        case 119: return  1; //ė 196   119
        case 143: return -1; //į 196   143
        case 129: return  0; //š 197   129
        case 147: return -1; //ų 197   147
        case 139: return  1; //ū 197   139
        case 158: return  0; //ž 197   158
      }
    #else
      if (modif == 196) {
        switch (font) {
          case  96: return  3; //Ā 196    96
          case  97: return  1; //ā 196    97
          case 100: return -1; //Ą 196   100
          case 102: return  3; //Ć 196   102
          case 103: return  0; //ć 196   103
          case 114: return  3; //Ē 196   114
          case 115: return  0; //ē 196   115
          case 101: return -1; //ą 196   101
          case 130: return -1; //Ģ 196   130
          case 131: return  1; //ģ 196   131
          case 150: return -1; //Ķ 196   150
          case 151: return -1; //ķ 196   151
          case 155: return -1; //Ļ 196   155
          case 156: return -1; //ļ 196   156
        }
      }
      if (modif == 197) {
        switch (font) {
          case  97: return  0; //Ł 197    97
          case  98: return  0; //ł 197    98
          case  99: return  3; //Ń 197    99
          case 100: return  0; //ń 197   100
          case 101: return -1; //Ņ 197   101
          case 102: return -1; //ņ 197   102
          case 122: return  3; //Ś 197   122
          case 123: return  0; //ś 197   123
          case 153: return  3; //Ź 197   153
          case 154: return  0; //ź 197   154
          case 155: return  3; //Ż 197   155
          case 156: return  0; //ż 197   156
        }
      }
      switch (font) {
        case 108: return  3; //Č 196   108
        case 120: return -1; //Ę 196   120
        case 118: return  3; //Ė 196   118
        case 142: return -1; //Į 196   142
        case 128: return  3; //Š 197   128
        case 146: return -1; //Ų 197   146
        case 138: return  3; //Ū 197   138
        case 157: return  3; //Ž 197   157
        case 109: return  0; //č 196   109
        case 121: return -1; //ę 196   121
        case 119: return  0; //ė 196   119
        case 143: return -1; //į 196   143
        case 129: return  0; //š 197   129
        case 147: return -1; //ų 197   147
        case 139: return  0; //ū 197   139
        case 158: return  0; //ž 197   158
      }
    #endif
  }
  return 0;
}



// ------------- СЛУЖЕБНЫЕ ФУНКЦИИ --------------



// Сдвинуть позицию отображения строки
void shiftTextPosition() {
  offset -= TEXT_SHIFT;
}

void ResetRunningTextFlags() {
  textShowTime = -1;                  // Если больше нуля - сколько времени отображать бегущую строку в секундах; Если 0 - используется textShowCount; В самой строке спец-макросом может быть указано кол-во секунд
  textShowCount = 1;                  // Сколько раз прокручивать текст бегущей строки поверх эффектов; По умолчанию - 1; В самой строке спец-макросом может быть указано число 
  useSpecialTextColor = false;        // В текущей бегущей строке был задан цвет, которым она должна отображаться
  textHasDateTime = false;            // Строка имеет макрос отображения текущего времени - ее нужно пересчитывать каждый раз при отрисовке; Если макроса времени нет - рассчитать текст строки один раз на этапе инициализации
  textHasMultiColor = false;          // Строк имеет множественное определение цвета - многоцветная строка

  globalTextColor = getGlobalTextColor();
  specialTextColor = globalTextColor; // Цвет отображения бегущей строки, может быть указан макросом в строке. Если не указан - используются глобальные настройки цвета бегущей строки
  specialTextEffect = -1;             // Эффект, который нужно включить при начале отображения строки текста, может быть указан макросом в строке.  
  specialTextEffectParam = -1;        // Параметр для эффекта (см. выше). Например эффект MC_SDCARD имеет более 40 подэффектов. Номер подэффекта хранится в этой переменной, извлекается из макроса {E}

  macrosTextLineIdx = -1;

  // Обнулить массивы позиций цвета и самого цвета
  for (uint8_t i = 0; i < MAX_COLORS; i++) {
    textColorPos[i] = 0;
    textColor[i] = 0xFFFFFF;
  }

  #if (USE_MP3 == 1) 
  runTextSound = -1;                  // Нет звука, сопровождающего строку
  playingTextSound = -1;
  runTextSoundRepeat = false;         // Нет повторения звука (однократное воспроизведение)
  runTextSoundFirst = true;
  runTextSoundTime = millis();  
  #endif
}

// Получить / установить настройки отображения очередного текста бегущей строки
// Если нет строк, готовых к отображению (например все строки отключены) - вернуть false - 'нет готовых строк'
bool prepareNextText(const String& text) {  
  
  // Если есть активная строка текущего момента - отображать ее 
  int8_t nextIdx = momentTextIdx >= 0 ? momentTextIdx : nextTextLineIdx;
    
  // Получить очередную строку из массива строк, обработав все макросы кроме дато-зависимых
  // Если макросы, зависимые от даты есть - установить флаг textHasDateTime, макросы оставить в строке
  // Если есть макросы, зависимые от даты и/или макросы с погодой и это multiColor строка - макросы цвета не обрабатывать, так как после замены макросов дат на значение индексы начала / конца цвета "уплывут"
  // Результат положить в currentText
  // Далее если флаг наличия даты в строке установлен - каждый раз перед отрисовкой выполнять подстановку даты и
  // обработку наступления даты последнего показа и переинициализацию строки
  // Если зависимостей от даты нет - вычисленная строка просто отображается пока не будет затребована новая строка

  offset = pWIDTH;   // перемотка новой строки в правый край
  if (text.length() != 0) {
  
    syncText = text;

  } else {
  
    // Если nextIdx >= 0 - значит в предыдущей строке было указано какую строку показывать следующей - показываем ее
    currentTextLineIdx = nextIdx >= 0 ? nextIdx : getNextLine(currentTextLineIdx);
    if (currentTextLineIdx >= TEXTS_MAX_COUNT) currentTextLineIdx = -1;

    currentText = currentTextLineIdx < 0 ? "" : getTextByIndex(currentTextLineIdx);
    syncText = currentText;
    // Если выбрана строка для принудительного показа - игнорировать запрет по '-' в начале строки или по макросу {-}
    if (nextIdx >= 0) {
      if (currentText[0] == '-') currentText[0] = ' ';
      currentText.replace("{-}", "");
    }    
  }

  if (text.length() == 0 && currentTextLineIdx == 0 && currentText[0] == '#') currentText = "";

  // После обработки макросов в строке может оказаться, что строка не должна отображаться (например, по времени показа макроса {S}),
  // но в строке присутствует также макрос {#N}, который был разобран и результат сохранен в nextTextLineIdx.
  // Если основную строку показывать не нужно (возвращена пустая строка), то и "прицеп" нужно "обнулить".
  if (currentText.length() == 0) {
    nextTextLineIdx = -1;
  }

  return currentText.length() > 0;
}

// Получить индекс строки для отображения
// -1 - если показывать нечего
int8_t getNextLine(int8_t currentIdx) {
        
  #if (USE_TEXT_CACHE == 1)
    // Если разрешено кэширование текстов бегущей строки и длина строки менее предельного размера - 
    // сохранить в кэш саму строку. Если размер строки - более предельного размера - поместить в строку "флажок" '{^}' указывающий на то, что данную строку нужно брать из файла
    textIndecies = getTextIndeciesLine(textLines[0]);
  #else
    textIndecies = getTextIndeciesLine(loadTextByIndex(0));
  #endif
  
  // Если не задана следующая строка - брать следующую из массива в соответствии с правилом
  // sequenceIdx > 0 - Строка textIndecies содержит последовательность отображения строк, например "#12345ZYX"
  //                   в этом случае sequenceIdx = 1..textIndecies.length() и показывает на символ в строке, содержащий индекс следующей строки к отображению
  //                   Если извлеченный символ - '#' - брать случайную строку из массива
  int8_t nextLineIdx = currentIdx;
  int16_t cnt = 0;
  bool found = false;
  if (sequenceIdx < 1) {
    while (cnt < TEXTS_MAX_COUNT) {
      nextLineIdx++; cnt++;
      if (nextLineIdx >= TEXTS_MAX_COUNT) nextLineIdx = 0;
      char c_idx = getAZIndex(nextLineIdx);
      if (textsNotEmpty.indexOf(c_idx) < 0) continue;
      String text(getTextByAZIndex(c_idx));
      bool disabled = (text.length() == 0) || (nextLineIdx == 0 && text[0] == '#') || (text[0] == '-') || (text.indexOf("{-}") >= 0) || (text.indexOf("{P") >= 0);
      bool wrong_date = (text.indexOf("{S") >= 0) && !forThisDate(text);
      if (disabled || wrong_date) continue;    
      break;
    }
  } else {
    if (sequenceIdx >= (int16_t)textIndecies.length()) {
      // перемотать на начало последовательности
      sequenceIdx = isFirstLineControl() ? 1 : -1;
    }
    int8_t att = 0;
    cnt = textsNotEmpty.length();
    if (textIndecies.length() > 0 && cnt > 0) {
      char c = textIndecies.charAt(sequenceIdx);
      if (c == '#') {
        // textIndecies -> "##", sequenceIdx всегда 1; textIndecies.charAt(1) == '#';
        while (!found && att < cnt) {
          att++;
          uint8_t idx = random8(1, cnt);
          char c_idx = textsNotEmpty[idx];
          int8_t t_idx = getTextIndex(c_idx);
          if (t_idx < 0) continue;
          // Проверить - доступен ли текст в указанной строке к отображению?
          String text(getTextByIndex(t_idx));
          // Строка должна быть не пустая,
          // Не отключена - в первом символе или наличие макроса {-}?
          // Строки с макросом события {P} не отображаются по интервалу показа - только сразу до/после события
          // Если строка содержит макрос {S} - текущая дата должна попадать в диапазон доступных для показа дат
          bool disabled = (text.length() == 0) || (t_idx == 0 && text[0] == '#') || (text[0] == '-') || (text.indexOf("{-}") >= 0) || (text.indexOf("{P") >= 0);
          bool wrong_date = (text.indexOf("{S") >= 0) && !forThisDate(text);
          // Если строка не отключена и доступна к отображению - брать ее
          if (!(disabled || wrong_date)) {
            found = true;
            nextLineIdx = t_idx;
            break;
          }      
        }      
      } else {
        // Последовательное отображение строк как указано в последовательности в textIndecies - '#12345'
        // здесь 'c' - char - индекс, выдернутый из указанной последовательности в очередной позиции
        nextLineIdx = getTextIndex(c); 
        uint8_t c_idx = sequenceIdx;
        while (!found) {
          // Проверить - доступен ли текст в указанной строке к отображению?
          String text(getTextByIndex(nextLineIdx));
          // Строка должна быть не пустая,
          // Не отключена - в первом символе или наличие макроса {-}?
          // Строки с макросом события {P} не отображаются по интервалу показа - только сразу до/после события
          // Если строка содержит макрос {S} - текущая дата должна попадать в диапазон доступных для показа дат
          bool disabled = (text.length() == 0) || (nextLineIdx == 0 && text[0] == '#') || (text[0] == '-') || (text.indexOf("{-}") >= 0) || (text.indexOf("{P") >= 0);
          bool wrong_date = (text.indexOf("{S") >= 0) && !forThisDate(text);
          // Если строка не отключена и доступна к отображению - брать ее
          if (!(disabled || wrong_date)) {
            found = true;
            break;
          }
          // Строка недоступна - брать следующий номер в последовательности
          sequenceIdx++;
          if (sequenceIdx >= (int16_t)textIndecies.length()) {
            // перемотать на начало последовательности
            sequenceIdx = isFirstLineControl() ? 1 : -1;
          }
          if (c_idx == sequenceIdx) break;
          // Если после перемотки вернулись в позицию с которой начали - строк доступных к показу нет
          c = textIndecies.charAt(sequenceIdx);
          nextLineIdx = getTextIndex(c); 
        }
        if (found) {
          sequenceIdx++;
        }
      }
    }
    if (!found) {
      nextLineIdx = -1;
      textLastTime = millis();
    }
  }
  return nextLineIdx;
}

// Выполнить разбор строки на наличие макросов, применить указанные настройки
String processMacrosInText(const String& text) {  

  String textLine(text);
  /*   
     Общие правила:
     - Макрос - последовательность управляющих конструкций, каждая из которых заключена в фигурные скобки, например "{Exx}" 
     - textIndecies - (строка с индексом '0')
     - Если строка textIndecies начинается с '#'  - строка содержит последовательность строк к отображению, например "#1234ZYX"
     - Если строка textIndecies начинается с '##' - отображать строки из массива в случайном порядке
     - Если строка textIndecies НЕ начинается с '#' или '##' - это обычная строка для отображения
     - Если строка начинается с '-' или пустая или содержит макрос '{-}' - строка отключена и не отображается 
     
     Строка, извлеченная из массива может содержать в себе следующие макросы:
      "{-}"     - в любом месте строки означает, что строка временно отключена, аналогично "-" в начале строки
      "{#N}"    - в любом месте строки означает,что после отображения строки, следующей строкой отображать строку с номером N, где N - 1..9,A..Z -> {#9}
                  Настройка из п.0 (через какое время показывать следующую строку) игнорируется, строка показывается сразу
                  после завершения отображения "родительской" строки
      "{An+}    - проиграть звук номер n из папки SD:/03; если есть '+' - проигрывать в цикле пока показывается строка, если нет суффикса '+' - проиграть один раз -> {A3+}
      "{Exx}"   - эту строку отображать на фоне эффекта xx - где xx - номер эффекта. Эффект не меняется пока отображается строка -> {E21}
      "{Exx-n}" - эту строку отображать на фоне эффекта xx, вариант n - где xx - номер эффекта, n - номер варианта -> {E24-8}
      "{Ts}"    - отображать строку указанное количество секунд s -> {T30}
      "{Nx}"    - отображать строку указанное количество раз x -> {N3} 
                  если S или N не указаны - строка прокручивается 1 раз;
                  Если указаны оба - работает модификатор показа по времени
      "{Cc}"    - отображать строку указанным цветом С; Цвет - в виде #AA77FE; Специальные значения - #000001 - радуга;  - #000002 - каждая буква свой цвет; -> {C#005500}
      "{Bc}"    - отображать строку на однотонном фоне указанного цвета С; Цвет - в виде #337700; -> {B#000000}
      "{WS}"    - отображать вместо {WS} состояние текущей погоды - "Пасмурно", "Ясно", "Дождь", "Гроза" и т.д. -> {WS}
      "{WT}"    - отображать вместо {WT} текущую температуру воздуха, например "+26", "-31" -> {WT}
      "{D:F}"   - где F - один из форматов даты / времени                         "С Новым {D:yyyy} годом!"
                  d    - день месяца, в диапазоне от 1 до 31.  (допускается D)
                  dd   - день месяца, в диапазоне от 01 до 31. (допускается DD)
                  ddd  - сокращенное название дня недели       (допускается DDD)
                  dddd - полное название дня недели            (допускается DDDD)
                  M    - месяц от 1 до 12
                  MM   - месяц от 01 до 12
                  MMM  - месяц прописью (янв..дек)
                  MMMМ - месяц прописью (января..декабря)
                  y    - год в диапазоне от 0 до 99            (допускается Y)
                  yy   - год в диапазоне от 00 до 99           (допускается YY)
                  yyyy - год в виде четырехзначного числа      (допускается YYYY)
                  h    - час в 12-часовом формате от 1 до 12
                  hh   - час в 12-часовом формате от 01 до 12
                  H    - час в 24-часовом формате от 0 до 23
                  HH   - час в 24-часовом формате от 00 до 23
                  m    - минуты в диапазоне от 0 до 59
                  mm   - минуты в диапазоне от 00 до 59
                  s    - секунды в диапазоне от 0 до 59        (допускается S)
                  ss   - секунды в диапазоне от 00 до 59       (допускается SS)
                  T    - Первый символ указателя AM/PM
                  TT   - Указатель AM/PM
                  t    - Первый символ указателя am/pm
                  tt   - Указатель am/pm
        
        Если формат не указан - используется формат H:mm        
        пример: "Красноярское время {D:HH:mm}" - бегущая строка "Красноярское время 07:15"  
                "Сегодня {D:DD MMMM YYYY} года" - бегущая строка "Сегодня 26 июля 2020 года"

     "{D}"      - просто часы вида "21:00" в виде бегущей строки

     "{R01.01.2021 0:00:00#N}" 
     "{R01.01.**** 0:00:00#N}" 
     "{R01.01.***+ 0:00:00#N}" 
       - где после R указана дата и опционально время до которой нужно отсчитывать оставшееся время, выводя строку остатка в формате:
           для R: X дней X часов X минут; 
           для P: X дней X часов X минут X секунд; 
         Если время не указано - считается 0:00
         Если дней не осталось - выводится только X часов X минут; 
         Если часов тоже уже не осталось - выводится X минут
         Если минут тоже уже не осталось - выводится X секунд
         Год в дате может быть указан '****', что означает "текущий год" или '***+', что означает "Следующий год"
         Время в макросе может быть указано с секундами: '23:59:59'
       
       - где после даты/времени может быть указан
         - #N - если осталось указанная дата уже наступила - вместо этой строки выводится строка с номером N
                если строка замены не указана - просроченная строка не выводится берется следующая строка
         - Внимание! При использовании макроса для вывода строки "До Нового года осталось" с годом, указанным звездочками '****'
           следует иметь в виду, что по достижении указанной даты год сменится на следующий, и событие "По достижении даты показовать строку #N"
           не сработает - вместо этого будет отображаться "До Нового года осталось 365 дней".
           Чтобы это избежать - и строку с макросом {R} и строку #N нужно использовать совместно с макросом {S}, который онграничивает
           перирод показа этой строки:
             getTextByIndex(2)   = "До {C#00D0FF}Нового года {C#FFFFFF}осталось {C#10FF00}{R01.01.***+}{S01.12.****#31.12.**** 23:59:59}";
             getTextByIndex(3)   = "С {C#00D0FF}Новым {C#0BFF00}{D:yyyy} {C#FFFFFF}годом!{S01.01.****#31.01.**** 23:59:59}";


     "{P01.01.2020#N#B#A}"
     "{P**.**.**** 7:00#N#B#A#F}"
     "{P01.01.2020#N#B#A}"
     "{P7:00#N#B#A#F}"   
       - где после P указана дата и опционально время до которой нужно отсчитывать оставшееся время, выводя строку остатка в формате:
          X дней X часов X минут X секунд; 
         Если дней не осталось - выводится только X часов X минут; 
         Если часов тоже уже не осталось - выводится X минут
         Если минут тоже уже не осталось - выводится X секунд

       Строка с режимом {P не выводится при периодическом переборе строк для отображения - только до/после непосредственно времени события:
       время наступления события мониторится и за #B секунд до события бегущая строка начинает отображаться на матрице и после события #A секунд отображается строка-заместитель 
       
       
       Для режима P дата может опускаться (означает "каждый день") или ее компоненты могут быть заменены звездочкой '*'
       **.10.2020 - весь октябрь 2020 года 
       01.**.**** - каждое первое число месяца
       **.**.2020 - каждый день 2020 года
       
       "{P7:00#N#120#30#12347}"  - каждый пн,вт,ср,чт,вс в 7 утра
       
       - где после даты может быть указан
         - #N - если осталось указанная дата уже наступила - вместо этой строки выводится строка с номером N
                если строка замены не указана - просроченная строка не выводится берется следующая строка
         - #B - начинать отображение за указанное количество секунд ДО наступления события (before). Если не указано - 60 секунд по умолчанию
         - #A - отображать строку-заместитель указанное количество секунд ПОСЛЕ наступления события (after). Если не указано - 60 секунд по умолчанию
         - #F - дни недели для которых работает эта строка - полезно когда дата не определена 1-пн..7-вс
                Если указана точная дата и указан день недели, который не соответствует дате - строка выведена не будет

     "{S01.01.2020#01.01.2020}"
     "{S01.01.2020 7:00#01.01.2020 19:00}"
     "{S01.01.**** 7:00#01.01.**** 19:00}"
       - где после S указаны даты начала и конца периода доступного для отображения строки.
       Для режима S элементы даты быть заменены звездочкой '*'
       **.10.2020 - весь октябрь 2020 года 
       01.**.**** - каждое первое число месяца
       **.**.2020 - каждый день 2020 года  
  */

  // Выполнять цикл поиска подходящей к отображению строки
  // Если ни одной строки не найдено - возвратить false

  bool    found = false, textHasWeather = false;
  uint8_t attempt = 0;
  int16_t idx, idx2; 
  
  int8_t  checkTextId = max(momentTextIdx, currentTextLineIdx);  
  if (checkTextId < 0) checkTextId = macrosTextLineIdx;
  
  while (!found && (attempt < TEXTS_MAX_COUNT)) {
    
    // -------------------------------------------------------------    
    // Строка начинается с '-' или пустая или содержит "{-}" - эта строка отключена, брать следующую
    // Строку показывать даже если отключена когда установлен флаг ignoreTextOverlaySettingforEffect
    // -------------------------------------------------------------    

    if (textLine.length() > 0 && ignoreTextOverlaySettingforEffect) {
      if (textLine[0] == '-') textLine[0] = ' ';
      textLine.replace("{-}", "");
    }

    // Строка пустая или отключена - брать другую строку
    if (textLine.length() == 0 || textLine.charAt(0) == '-' || textLine.indexOf("{-}") >= 0) {
      attempt++;  
      currentTextLineIdx = getNextLine(currentTextLineIdx);
      textLine = (currentTextLineIdx < 0 || currentTextLineIdx >= TEXTS_MAX_COUNT) ? "" : getTextByIndex(currentTextLineIdx);
      continue;
    }

    // Если в строке содержится макрос, связанный с погодой, но погода еще не получена с сервера - пропускать строку, брать следующую
    textHasWeather = (textLine.indexOf("{WS}") >= 0 || textLine.indexOf("{WT}") >= 0);
    if (!init_weather && textHasWeather) {
      attempt++;  
      currentTextLineIdx = getNextLine(currentTextLineIdx);
      textLine = (currentTextLineIdx < 0 || currentTextLineIdx >= TEXTS_MAX_COUNT) ? "" : getTextByIndex(currentTextLineIdx);
      continue;
    }

    // -------------------------------------------------------------
    // Эти форматы содержат строку, зависящую от текущего времени.
    // Оставить эти форматы как есть в строке - они будут обрабатываться на каждом проходе, подставляя текущее время
    // Сейчас просто выставить флаг, что строка содержит макросы, зависимые от даты
    //    "{D:F}" - где F - один из форматов даты / времени если формата даты нет - аналогично {D}
    //    "{D}"  - просто часы вида "21:00" в виде бегущей строки
    //    "{R01.01.****#N}" 
    //    "{P01.**.2021 8:00#N#B#A#F}" 
    //    "{S01.01.****}" 
    // -------------------------------------------------------------

    textHasDateTime = textLine.indexOf("{D") >= 0 || textLine.indexOf("{R") >= 0 || textLine.indexOf("{P") >= 0 || textLine.indexOf("{S") >= 0;  

    // Если время еще не инициализировано и строка содержит макросы, зависимые от времени -
    // строку отображать нельзя - пропускаем, переходим к поиску следующей строки
    if (!init_time && textHasDateTime) {
      textHasDateTime = false;
      attempt++;  
      continue;
    }

    found = true;

    // -------------------------------------------------------------    
    // "{#N}" - в любом месте строки означает,что после отображения строки, следующей строкой отображать строку с номером N, где N - 1..9,A..Z или двухзначный индекс 1..19
    // -------------------------------------------------------------    
    
    // Вызов функции проверки текста на макросы может выполняться в несколько приемов, в каждый вызов могут обрабатываться не все, а только часть макросов
    // Обработанные макросы удаляются и при следующем вызове их уже не будет. Не надо сбрасывфть флаги, если обрабатывается все та же строка
    if (checkTextId < 0 || macrosTextLineIdx != checkTextId) {
      nextTextLineIdx = -1;
    }
    
    idx = textLine.indexOf("{#");
    while (idx >= 0) {

      // Закрывающая скобка
      // Если ее нет - ошибка, ничего со строкой не делаем, отдаем как есть
      idx2 = textLine.indexOf("}", idx);        
      if (idx2 < 0) break;

      // Извлечь номер эффекта, он должен быть 0..MAX_EFFECT-1, может быть двузначным
      String tmp;
      if (idx2 - idx > 1) {
        tmp = textLine.substring(idx+2, idx2);
      }
      
      // удаляем макрос
      textLine.remove(idx, idx2 - idx + 1);

      int16_t len = tmp.length();
      if (len == 0 || len > 2) break;

      char c = tmp.charAt(0);
      if (len == 1 || (c >= 'A' && c <= 'Z')) {        
        // Запоминаем номер следующей к показу строки, извлеченный из макроса
          nextTextLineIdx = getTextIndex(c);
      } else {
         nextTextLineIdx = tmp.toInt();
      }
      
      if (nextTextLineIdx >= TEXTS_MAX_COUNT) {
        nextTextLineIdx = -1;
      }

      // удаляем макрос
      textLine.remove(idx, idx2 - idx + 1);
      
      // Есть еще вхождения макроса?
      idx = textLine.indexOf("{#");  
    }

    // -------------------------------------------------------------
    //  "{An+} - при начале строки проигрывать звук n из папки "SD://03"? если есть суффикс '+' - воспроизводить в цикле пока показывается строка
    // -------------------------------------------------------------
    #if (USE_MP3 == 1)

    // Вызов функции проверки текста на макросы может выполняться в несколько приемов, в каждый вызов могут обрабатываться не все, а только часть макросов
    // Обработанные макросы удаляются и при следующем вызове их уже не будет. Не надо сбрасывфть флаги, если обрабатывается все та же строка
    if (checkTextId < 0 || macrosTextLineIdx != checkTextId) {
      runTextSound = -1;
      runTextSoundRepeat = false;
    }
    
    idx = textLine.indexOf("{A");
    while (idx >= 0) {
      // Закрывающая скобка
      // Если ее нет - ошибка, ничего со строкой не делаем, отдаем как есть
      idx2 = textLine.indexOf("}", idx);        
      if (idx2 < 0) break;

      // Извлечь номер звука, может быть двузначным
      String tmp;
      if (idx2 - idx > 1) {
        tmp = textLine.substring(idx+2, idx2);
      }
      
      // удаляем макрос
      textLine.remove(idx, idx2 - idx + 1);

      // Последним символом в выделенной строке может быть '+' - признак повторения звука (цикл)
      if (tmp.endsWith("+")) {
        runTextSoundRepeat = true;
        tmp = tmp.substring(0, tmp.length()-1);
      }

      // Преобразовать строку в число
      idx = tmp.length() > 0 ? tmp.toInt() : -1;
      runTextSound = idx;

      // Есть еще вхождения макроса?
      idx = textLine.indexOf("{A");  
    }
    #endif

    // -------------------------------------------------------------
    //  "{Exx} - эту строку отображать на фоне эффекта xx - где xx - номер эффекта. Эффект не меняется пока отображается строка      
    //  "{Exx-n} - эту строку отображать на фоне эффекта xx с вариантом n - где xx - номер эффекта? n - номер варианта эффекта.
    // -------------------------------------------------------------

    // Вызов функции проверки текста на макросы может выполняться в несколько приемов, в каждый вызов могут обрабатываться не все, а только часть макросов
    // Обработанные макросы удаляются и при следующем вызове их уже не будет. Не надо сбрасывфть флаги, если обрабатывается все та же строка
    if (checkTextId < 0 || macrosTextLineIdx != checkTextId) {
      specialTextEffect = -1;
      specialTextEffectParam = -1;
    }
    
    idx = textLine.indexOf("{E");
    while (idx >= 0) {

      // Закрывающая скобка
      // Если ее нет - ошибка, ничего со строкой не делаем, отдаем как есть
      idx2 = textLine.indexOf("}", idx);        
      if (idx2 < 0) break;

      // Извлечь номер эффекта, он должен быть 0..MAX_EFFECT-1, может быть двузначным
      String tmp, tmp1;
      if (idx2 - idx > 1) {
        tmp = textLine.substring(idx+2, idx2);
      }
      
      // удаляем макрос
      textLine.remove(idx, idx2 - idx + 1);

      // tmp может содержать кроме номера эффекта, номер варианта, отделенный знаком '-' (например из {E43} или {E34-12} будут строки '43' и '43-12'
      // если есть номер варианта - отделить его от номера эффекта
      int16_t p = tmp.indexOf('-');
      if (p > 0) {
        tmp1 = tmp.substring(p + 1);
        tmp  = tmp.substring(0, p);
      }
      
      // Преобразовать строку в число
      idx = tmp.length() > 0 ? tmp.toInt() : -1;
      specialTextEffect = idx >= 0 && idx < MAX_EFFECT ? idx : -1;

      idx = tmp1.length() > 0 ? tmp1.toInt() : -1;
      specialTextEffectParam = idx >= 0 ? idx : -1;
            
      // Есть еще вхождения макроса?
      idx = textLine.indexOf("{E");  
    }

    // -------------------------------------------------------------
    //  "{TS}" - отображать строку указанное количество секунд S
    // -------------------------------------------------------------

    // Вызов функции проверки текста на макросы может выполняться в несколько приемов, в каждый вызов могут обрабатываться не все, а только часть макросов
    // Обработанные макросы удаляются и при следующем вызове их уже не будет. Не надо сбрасывфть флаги, если обрабатывается все та же строка
    if (checkTextId < 0 || macrosTextLineIdx != checkTextId) {
      textShowTime = -1;
    }
    
    idx = textLine.indexOf("{T");
    while (idx >= 0) {

      // Закрывающая скобка
      // Если ее нет - ошибка, ничего со строкой не делаем, отдаем как есть
      idx2 = textLine.indexOf("}", idx);        
      if (idx2 < 0) break;

      // Извлечь количество секунд отображения этой бегущей строки
      String tmp;
      if (idx2 - idx > 1) {
        tmp = textLine.substring(idx+2, idx2);
      }
      
      // удаляем макрос
      textLine.remove(idx, idx2 - idx + 1);

      // Преобразовать строку в число
      idx = tmp.length() > 0 ? tmp.toInt() : -1;
      textShowTime = idx > 0 ? idx : -1;
      
      // Есть еще вхождения макроса?
      idx = textLine.indexOf("{T");
    }

    // -------------------------------------------------------------
    //  "{NX}" - отображать строку указанное количество раз X
    // -------------------------------------------------------------

    // Вызов функции проверки текста на макросы может выполняться в несколько приемов, в каждый вызов могут обрабатываться не все, а только часть макросов
    // Обработанные макросы удаляются и при следующем вызове их уже не будет. Не надо сбрасывфть флаги, если обрабатывается все та же строка
    if (checkTextId < 0 || macrosTextLineIdx != checkTextId) {
      textShowCount = 1;
    }
    
    idx = textLine.indexOf("{N");
    while (idx >= 0) {

      // Закрывающая скобка
      // Если ее нет - ошибка, ничего со строкой не делаем, отдаем как есть
      idx2 = textLine.indexOf("}", idx);        
      if (idx2 < 0) break;

      // Извлечь количество раз отображения этой бегущей строки
      String tmp;
      if (idx2 - idx > 1) {
        tmp = textLine.substring(idx+2, idx2);
      }
      
      // удаляем макрос
      textLine.remove(idx, idx2 - idx + 1);

      // Преобразовать строку в число
      idx = tmp.length() > 0 ? tmp.toInt() : -1;
      textShowCount = idx > 0 ? idx : 1;
      
      // Есть еще вхождения макроса?
      idx = textLine.indexOf("{N");  
    }
      
    // -------------------------------------------------------------
    // "{BC}"- отображать строку  на однотонном фоне указанного цвета С; Цвет - в виде #007700
    // -------------------------------------------------------------

    // Вызов функции проверки текста на макросы может выполняться в несколько приемов, в каждый вызов могут обрабатываться не все, а только часть макросов
    // Обработанные макросы удаляются и при следующем вызове их уже не будет. Не надо сбрасывфть флаги, если обрабатывается все та же строка
    if (checkTextId < 0 || macrosTextLineIdx != checkTextId) {
      useSpecialBackColor = false;
    }
    
    idx = textLine.indexOf("{B");
    while (idx >= 0) {

      // Закрывающая скобка
      // Если ее нет - ошибка, ничего со строкой не делаем, отдаем как есть
      idx2 = textLine.indexOf("}", idx);        
      if (idx2 < 0) break;

      // Извлечь цвет фона отображения этой бегущей строки
      String tmp;
      if (idx2 - idx > 1) {
        tmp = textLine.substring(idx+2, idx2);
      }
      
      // удаляем макрос
      textLine.remove(idx, idx2 - idx + 1);
           
      // Преобразовать строку в число
      useSpecialBackColor = true;
      specialBackColor = (uint32_t)HEXtoInt(tmp);
      
      // Есть еще вхождения макроса?
      idx = textLine.indexOf("{B");  
    }

    #if (USE_WEATHER == 1)     
    
    // {WS} - отображать текущую погоду - "Ясно", "Облачно" и т.д
    idx = textLine.indexOf("{WS}");
    if (idx >= 0) {
      textLine.replace("{WS}", weather);
    }

    // {WT} - отображать текущую температуру в виде "+26" или "-26"
    // Если включено отображение температуры цветом - добавить макрос цвета перед температурой 
    idx = textLine.indexOf("{WT}");
    if (idx >= 0) {
      // Подготовить строку температуры и заменить все вхождения {WT} на эту строку
      int8_t th = (isFarenheit ? (round(temperature * 9 / 5) + 32) : temperature);
      String s_temperature((th == 0 ? "" : (th > 0 ? "+" : ""))); s_temperature += th;
      
      String s_color, s_color2;

      if (useTemperatureColor) {
        s_color  = "{C#" + IntToHex(getTemperatureColor(th)) + "}";           // Каким цветом будет отображаться значение температуры
        s_color2 = "{C#" + IntToHex(globalTextColor) + "}";                   // Чтобы продолжение строки не было тем же цветом - вставить макрос дефолтного цвета строки
      }

      String s_tmp(s_color);  s_tmp += s_temperature; 
      if (showTempTextDegree) s_tmp += "°";                                   // Знак градуса добавлять, только если указано в настройках
      if (showTempTextLetter) {                                               // C/F добавлять, только если указано в настройках
        s_tmp += (isFarenheit ? PSTR("F") : PSTR("C"));
      }
      s_tmp += s_color2;
      
      textLine.replace("{WT}", s_tmp);
    }

    #endif
     
    // -------------------------------------------------------------
    // "{CC}"- отображать строку указанным цветом С; Цвет - в виде #AA77FE
    // -------------------------------------------------------------
    // Если макрос стоит в самом начале или в самом конце строки и единственный - всю строку отображать указанным цветом
    // Если макрос стоит в середине строки или макросов цвета несколько - они указывают позицию в строке с которой меняется цвет отображения
    // В этом случае два варианта - строка также содержит макрос, зависящий от времени?
    // - не содержит дат - разбор можно сделать один раз, сохранить позиции и цвета в массив и дальше использовать его при отображении
    // - содержит даты - разбор позиций цветов определять ПОСЛЕ формирования строки с вычисленной датой
    
    // Вызов функции проверки текста на макросы может выполняться в несколько приемов, в каждый вызов могут обрабатываться не все, а только часть макросов
    // Обработанные макросы удаляются и при следующем вызове их уже не будет. Не надо сбрасывфть флаги, если обрабатывается все та же строка
    bool hasMulticolor = checkIsTextMultiColor(text);
    if (checkTextId < 0 || macrosTextLineIdx != checkTextId) {
      textHasMultiColor = hasMulticolor;
      globalTextColor = getGlobalTextColor();
      specialTextColor = globalTextColor;
    }

    // Если строка не содержит даты / погоды или не содержит множественного определения цвета
    // обработать макрос цвета, цвет сохранить в specialTextColor, установить флаг useSpecialTextColor
    // В дальнейшем при отображении строки не нужно каждый раз вычислять цвет и позицию - просто использовать specialTextColor
    
    textHasWeather = (textLine.indexOf("{WS}") >= 0 || textLine.indexOf("{WT}") >= 0);
    if (!(textHasWeather || textHasDateTime)) {
      if (textHasMultiColor) {      
        // Если строка содержит множественное определение цвета и не содержит даты - подготовить массив цветов,
        // который будет отображаться для отрисовки строки
        textLine = processColorMacros(textLine);
      } else {
        // Многоцветья нет - возможно есть одиночный макрос цвета (в начале или в конце строки) - который задает цвет всей строки - получить цвет строки
        useSpecialTextColor = false;
        idx = textLine.indexOf("{C");      
        idx2 = idx < 0 ? idx : textLine.indexOf("}", idx + 1);
        if (idx >= 0 && idx2 > 0) {
          textLine = processColorMacros(textLine);
          useSpecialTextColor = true;
          specialTextColor = idx == 0 ? textColor[0] : textColor[1];
        }
      }
    }
    
    // На данном этапе должны остаться только макросы даты, и если они есть - макросы многоцветной строки.
    // Они будут обработаны перед каждым выводом строки текста на матрицу
  }

  // Запомнить - макросы какой строки были разобраны
  if (checkTextId < 0) checkTextId = 99;
  macrosTextLineIdx = checkTextId;

  return found ? textLine : "";
}

// Обработать макросы даты в строке
// textLine - строка, содержащая макросы
String processDateMacrosInText(const String& text) {

  String textLine(text); 
  
  /* -------------------------------------------------------------
   Эти форматы содержат строку, зависящую от текущего времени.
   Оставить эти форматы как есть в строке - они будут обрабатываться на каждом проходе, подставляя текущее время
   Сейчас просто выставить флаг, что строка содержит макросы, зависимые от даты
      "{D}"  - просто часы вида "21:00" в виде бегущей строки
      "{D:F}" - где F - один из форматов даты / времени если формата даты нет - аналогично {D}
       Формат даты поддерживает следующие спецификаторы       
          d    - день месяца, в диапазоне от 1 до 31.  (допускается D)
          dd   - день месяца, в диапазоне от 01 до 31. (допускается DD)
          ddd  - сокращенное название дня недели       (допускается DDD)
          dddd - полное название дня недели            (допускается DDDD)
          M    - месяц от 1 до 12
          MM   - месяц от 01 до 12
          MMM  - месяц прописью (янв..дек)
          MMMМ - месяц прописью (января..декабря)
          y    - год в диапазоне от 0 до 99            (допускается Y)
          yy   - год в диапазоне от 00 до 99           (допускается YY)
          yyyy - год в виде четырехзначного числа      (допускается YYYY)
          h    - час в 12-часовом формате от 1 до 12
          hh   - час в 12-часовом формате от 01 до 12
          H    - час в 23-часовом формате от 0 до 23
          HH   - час в 23-часовом формате от 00 до 23
          m    - минуты в диапазоне от 0 до 59
          mm   - минуты в диапазоне от 00 до 59
          s    - секунды в диапазоне от 0 до 59        (допускается S)
          ss   - секунды в диапазоне от 00 до 59       (допускается SS)
          T    - Первый символ указателя AM/PM
          TT   - Указатель AM/PM
          t    - Первый символ указателя am/pm
          tt   - Указатель am/pm
  
      "{R01.01.2021#N}" 
      "{R01.01.****}" 
      "{R01.01.***+}" 
         - где после R указана дата до которой нужно отсчитывать оставшееся время, выводя строку остатка в формате:
             X дней X часов X минут; 
           Если дней не осталось - выводится только X часов X минут; 
           Если минут тоже уже не осталось - выводится X минут
           Год в дате может быть указан '****', что означает "текущий год" или '***+', что означает "Следующий год"
           Время в макросе может быть указано с секундами: '23:59:59'
       
         - где после даты может быть указан
           - #N - если осталось указанная дата уже наступила - вместо этой строки выводится строка с номером N
                  если строка замены не указана или отключена (символ "-" вначале строки) - просроченная строка не выводится
                  берется следующая строка
                  
         - Внимание! При использовании макроса для вывода строки "До Нового года осталось" с годом, указанным звездочками '****'
           следует иметь в виду, что по достижении указанной даты год сменится на следующий, и событие "По достижении даты показовать строку #N"
           не сработает - вместо этого будет отображаться "До Нового года осталось 365 дней".
           Чтобы это избежать - и строку с макросом {R} и строку #N нужно использовать совместно с макросом {S}, который онграничивает
           перирод показа этой строки:
             getTextByIndex(2)   = "До {C#00D0FF}Нового года {C#FFFFFF}осталось {C#10FF00}{R01.01.***+}{S01.12.****#31.12.**** 23:59}";
             getTextByIndex(3)   = "С {C#00D0FF}Новым {C#0BFF00}{D:yyyy} {C#FFFFFF}годом!{S01.01.****#31.01.**** 23:59}";

     "{PДД.ММ.ГГГГ#N#B#A#F}"
       - где после P указаны опционально дата и время до которой нужно отсчитывать оставшееся время, выводя строку остатка в формате:
         X дней X часов X минут X секунд; 
         Если дней не осталось - выводится только X часов X минут; 
         Если часов тоже уже не осталось - выводится X минут
         Если минут тоже уже не осталось - выводится X секунд

       Строка с режимом {P не выводится при периодическом переборе строк для отображения - только до/после непосредственно времени события:
       время наступления события мониторится и за #B секунд до события бегущая строка начинает отображаться на матрице и после события #A секунд отображается строка-заместитель 
       
       Для режима P дата может опускаться (означает "каждый день") или ее компоненты могут быть заменены звездочкой '*'
       **.10.2020 - весь октябрь 2020 года 
       01.**.**** - каждое первое число месяца любого года
       **.**.2020 - каждый день 2020 года
       
       "{P7:00#N#120#30#12347}"  - каждый пн,вт,ср,чт,вс в 7 утра (за 120 сек до наступления события и 30 секунд после наступления

       - где компоненты даты:
         ДД - число месяца
         MM - месяц
         ГГГГ - год
         Компоненты даты могут быть заменены * - означает "любой"
         
       - где после даты может быть указан
         - #N - если осталось указанная дата уже наступила - вместо этой строки выводится строка с номером N
                если строка замены не указана - просроченная строка не выводится берется следующая строка
         - #B - начинать отображение за указанное количество секунд ДО наступления события (before). Если не указано - 60 секунд по умолчанию
         - #A - отображать строку-заместитель указанное количество секунд ПОСЛЕ наступления события (after). Если не указано - 60 секунд по умолчанию
         - #F - дни недели для которых работает эта строка, когда дата не определена 1-пн..7-вс
                Если указана точная дата и указан день недели, который не соответствует дате - строка выведена не будет
          
     "{S01.01.2020#01.01.2020#12347}"
     "{S01.01.2020 7:00#01.01.2020 19:00#123}"
     "{S01.01.**** 7:00#01.01.**** 19:00#567}"
       - где после S указаны даты начала и конца периода доступного для отображения строки.
       Для режима S элементы даты быть заменены звездочкой '*'
       **.10.2020 - весь октябрь 2020 года 
       01.**.**** - каждое первое число месяца
       **.**.2020 - каждый день 2020 года  
       #1234567 - дни недели пн..вс в которые разрешен показ строки
     ------------------------------------------------------------- 
  */

  uint8_t  aday = day();
  uint8_t  amnth = month();
  uint16_t ayear = year();
  uint8_t  hrs = hour(), hrs_t;
  uint8_t  mins = minute();
  uint8_t  secs = second();
  bool     am = isAM();
  bool     pm = isPM();
  int16_t  idx, idx2;

  int8_t   wd = weekday();    // day of the week, Sunday is day 0   
  if (wd == 0) wd = 7;        // Sunday is day 7, Monday is day 1;

  while (true) {
    // {D} - отображать текущее время в формате 'HH:mm'
    idx = textLine.indexOf("{D}");
    if (idx >= 0) {
      // Подготовить строку текущего времени HH:mm и заменить все вхождения {D} на эту строку
      String s_time(padNum(hrs, 2)); s_time += ':'; s_time += padNum(mins, 2);
      textLine.replace("{D}", s_time);
    }

    // {D:F} (где F - форматная строка
    idx = textLine.indexOf("{D:");
    if (idx >= 0) {
  
      // Закрывающая скобка
      // Если ее нет - ошибка, ничего со строкой не делаем, отдаем как есть
      idx2 = textLine.indexOf("}", idx);        
      if (idx2 < 0) break;
  
      // Извлечь форматную строку
      String sFmtProcess('#'); 
      String sFormat('$');
  
      if (idx2 - idx > 1) {
        sFormat = textLine.substring(idx+3, idx2);
      }
      
      sFmtProcess = sFormat;
      
      //  YYY+ - СДЕДУЮЩИЙ год в виде четырехзначного числа
      String str(ayear + 1);
      sFmtProcess.replace("YYY+", str);
      sFmtProcess.replace("yyy+", str);

      //  YYYY - год в виде четырехзначного числа
      str.clear();
      str += ayear;
      sFmtProcess.replace("YYYY", str);
      sFmtProcess.replace("yyyy", str);
  
      //  YY   - год в диапазоне от 00 до 99
      str = str.substring(2);
      sFmtProcess.replace("YY", str);
      sFmtProcess.replace("yy", str);
  
      //  Y    - год в диапазоне от 0 до 99
      if (str[0] == '0') str = str.substring(1);
      sFmtProcess.replace("Y", str);
      sFmtProcess.replace("y", str);
      
      //  HH   - час в 23-часовом формате от 00 до 23
      str.clear();
      str += padNum(hrs, 2);
      sFmtProcess.replace("HH", str);
  
      //  H    - час в 23-часовом формате от 0 до 23
      str.clear();
      str += hrs;
      sFmtProcess.replace("H", str);
  
      //  hh   - час в 12-часовом формате от 01 до 12
      hrs_t = hrs;
      if (hrs_t > 12) hrs_t = hrs_t - 12;
      if (hrs_t == 0) hrs_t = 12;

      str.clear();
      str += padNum(hrs_t, 2);
      sFmtProcess.replace("hh", str);
  
      //  h    - час в 12-часовом формате от 1 до 12
      str.clear();
      str += hrs_t;
      sFmtProcess.replace("h", str);
      
      //  mm   - минуты в диапазоне от 00 до 59
      str.clear();
      str += padNum(mins, 2);
      sFmtProcess.replace("mm", str);
  
      //  m    - минуты в диапазоне от 0 до 59
      str.clear();
      str += mins;
      sFmtProcess.replace("m", str);
  
      //  ss   - секунды в диапазоне от 00 до 59
      str.clear();
      str += padNum(secs, 2);
      sFmtProcess.replace("SS", str);
      sFmtProcess.replace("ss", str);
  
      //  s    - секунды в диапазоне от 0 до 59
      str.clear();
      str += secs;
      sFmtProcess.replace("S", str);
      sFmtProcess.replace("s", str);
  
      //  tt   - Указатель AM/PM
      str.clear();
      str += am ? "AM" : (pm ? "PM" : "");
      sFmtProcess.replace("TT", str);
      str.toLowerCase();
      sFmtProcess.replace("tt", str);
  
      //  t    - Первый символ указателя AM/PM
      str.clear();
      str += am ? "A" : (pm ? "P" : "");
      sFmtProcess.replace("T", str);
      str.toLowerCase();
      sFmtProcess.replace("t", str);

      //  dddd - полное название дня недели            (допускается DDDD)
      str.clear();
      str += substitureDateMacros(getWeekdayString(wd));
      sFmtProcess.replace("DDDD", str);
      sFmtProcess.replace("dddd", str);
      
      //  ddd  - сокращенное название дня недели       (допускается DDD)
      str.clear(); // DDD
      str += substitureDateMacros(getWeekdayShortString(wd));
      sFmtProcess.replace("DDD", str);
      sFmtProcess.replace("ddd", str);
  
      //  dd   - день месяца, в диапазоне от 01 до 31. (допускается DD)
      str.clear();
      str += padNum(aday,2);  // DD
      sFmtProcess.replace("DD", str);
      sFmtProcess.replace("dd", str);
  
      //  d    - день месяца, в диапазоне от 1 до 31.  (допускается D)
      str.clear();
      str += aday;  // D
      sFmtProcess.replace("D", str);
      sFmtProcess.replace("d", str);

      //  MMMМ - месяц прописью (января..декабря)
      str.clear();
      str += substitureDateMacros(getMonthString(amnth));
      sFmtProcess.replace("MMMM", str);
      
      //  MMM  - месяц прописью (янв..дек)
      str.clear();
      str += substitureDateMacros(str);
      str = getMonthShortString(amnth);
      sFmtProcess.replace("MMM", str);
  
      //  MM   - месяц от 01 до 12
      str.clear();
      str += padNum(amnth,2);
      sFmtProcess.replace("MM", str);
  
      //  M    - месяц от 1 до 12
      str.clear();
      str += amnth;
      sFmtProcess.replace("M", str);
      sFmtProcess = unsubstitureDateMacros(sFmtProcess);

      // Заменяем в строке макрос с исходной форматной строкой на обработанную строку с готовой текущей датой
      textLine.replace("{D:" + sFormat + "}", sFmtProcess);
      
      // Есть еще вхождения макроса?
      idx = textLine.indexOf("{D:");
    }

    // "{R01.01.****}" 
    // "{R01.01.***+}" 
    // "{R01.01.2023#N}" 
    // "{R10.10.2023 7:00#N}" 
    idx = textLine.indexOf("{R");
    if (idx >= 0) {
            
      // Если время  события уже наступило и в строке указана строка-заместитель для отображения ПОСЛЕ наступления события - показывать эту строку
      // Если замены строки после наступления события нет - textLine будет пустой - отображать нечего
      // Строка замены снова может содержать метки времени - поэтому отправить проверку / замену на второй круг

      // Закрывающая скобка
      // Если ее нет - ошибка, ничего со строкой не делаем, отдаем как есть
      idx2 = textLine.indexOf("}", idx);        
      if (idx2 < 0) break;

      // Извлечь дату события, время и строку замены ПОСЛЕ события (если есть)
      String str;
      if (idx2 - idx > 1) {
        str += textLine.substring(idx+2, idx2);
        str.trim();
      }

      // удаляем макрос; точка вставки строки остатка будет будет в позицию idx
      textLine.remove(idx, idx2 - idx + 1);

      // Здесь str имеет вид '01.01.2020', или '01.01.****', или '01.01.***+' если строки замены ПОСЛЕ события нет или '01.01.2020#J' или '01.01.2020#19' если строка замены указана (J=19 - индекс в массиве)
      // так же после даты может быть указано время '01.01.2020 7:00:00'
      if (str.length() > 0) {

        time_t t_now = *now();
        time_t t_event = *now();
        time_t t_diff = 0;

        // Точка вставки строки остатка
        uint16_t insertPoint = idx;
        int8_t  afterEventIdx = -1;

        // Здесь - str - дата (и время) события, s_nn - номер строки замены или пустая строка, если строки замены нет
        // Получить дату наступления события из строки 'ДД.ММ.ГГГГ'

        // Есть индекс строки замены? Если есть - отделить ее от даты события
        idx = str.indexOf("#");
        String s_nn;
        if (idx >= 0) {
          s_nn = idx>=0 ? str.substring(idx+1) : "";
          str = str.substring(0,idx);
        }

        struct tm tm;
        localtime_r(now(), &tm);
        ParseDateTime(str, &tm);
        t_event = mktime(&tm);

        // Отладка - установка текущего времени для макросв {R}
        bool debug = debug_hours >= 0 && debug_mins >= 0;
        if (debug) {
          struct tm tmStruct;
          memset(&tmStruct, 0, sizeof(tmStruct));

          tmStruct.tm_hour = debug_hours;
          tmStruct.tm_min = debug_mins;
          tmStruct.tm_sec = 30;
          tmStruct.tm_mday = debug_days;
          tmStruct.tm_mon = debug_month - 1;
          tmStruct.tm_year = debug_year - 1900;

          t_now = mktime(&tmStruct);
        }

        /*
        DEBUGLN(DELIM_LINE);
        DEBUGLN("Исходная R-дата: '" + str + "'");
        
        DEBUGLN(String(F("Дата события: ")) + padNum(tm2.tm_day, 2) + "." + padNum(tm2.tm_mon + 1, 2) + "." + padNum(tm_year + 1900, 4) + " " + padNum(tm2.tm_hour, 2) + ":" + padNum(tm2.tm_min, 2) + ":" + padNum(tm2.tm_sec, 2));
        DEBUGLN(DELIM_LINE);
        */
        
        // Если t_now >= t_event - событие уже прошло, нужно заменять обрабатываемую строку на строку подстановки, указанную (или нет) в s_nn 
        if (t_now >= t_event) {

          uint8_t len = s_nn.length();
          if (len > 0) {
            // Преобразовать строку в индекс
            char c = s_nn.charAt(0);
            if (len == 1 || (c >= 'A' && c <= 'Z')) {        
              // Номер следующей к показу строки, извлеченный из макроса в формате 1..9,A..Z
              afterEventIdx = getTextIndex(c);
            } else {
              // Номер следующей к показу строки, извлеченный из макроса в формате десятичного числа
              afterEventIdx = s_nn.toInt();
            }
      
            if (afterEventIdx >= TEXTS_MAX_COUNT) {
              afterEventIdx = -1;
            }
          } else {
            // s_nn не содержит индекса строки замены
            afterEventIdx = -1; 
          }

          // Строка замены не указана - завершить показ строки
          if (afterEventIdx < 0) {
            return "";    
          }

          // Получить текст строки замены. Он может содержать макросы, в т.ч. и макросы даты. Их нужно обработать.
          // Для того, чтобы указанная строка замены не отображалась при обычном переборе - она должна быть помечена как отключенная - '-' в начале строки или '{-}' в любом месте
          // Когда же пришло время отобразить строку - перед обработкой макросов ее нужно "включить"
          textLine = getTextByIndex(afterEventIdx);

          // содержит ли строка замены ограничение на показ в периоде, указанном макросом {S}?
          bool wrong_date = (textLine.indexOf("{S") >= 0) && !forThisDate(textLine);
          if (wrong_date) {
            return "";    
          }

          if (textLine.length() == 0) return "";              
          if (textLine[0] == '-') textLine = textLine.substring(1);
          if (textLine.indexOf("{-}") >= 0) textLine.replace("{-}", "");
          if (textLine.length() == 0) return "";    

          // Строка замены содержит в себе макросы даты? Если да - вычислить всё снова для новой строки                   
          if (textLine.indexOf("{D}") >= 0 || textLine.indexOf("{D:") >= 0 ||textLine.indexOf("{R") >= 0 || textLine.indexOf("{P") >= 0 || textLine.indexOf("{S") >= 0) continue;

          // Вернуть текст строки замены, отображаемой после того, как событие прошло
          return textLine;
        }

        // Событие еще не наступило
        
        // Вычислить сколько до его наступления осталось времени
        t_diff = t_event - t_now; // кол-во секунд до события

        // Пересчет секунд в дней до события / часов до события / минут до события
        uint16_t restDays = t_diff / SECS_PER_DAY;
        uint8_t restHours = (t_diff - (restDays * SECS_PER_DAY)) / SECS_PER_HOUR;
        uint8_t restMinutes = (t_diff - (restDays * SECS_PER_DAY) - (restHours * SECS_PER_HOUR)) / SECS_PER_MIN;
        uint8_t restSeconds = (t_diff - (restDays * SECS_PER_DAY) - (restHours * SECS_PER_HOUR) - (restMinutes * SECS_PER_MIN));

        // Если осталось меньше минуты - отображать секунды
        // Если осталось меньше часа - отображать только минуты
        // Если осталось несколько часов - отображать часы и минуты
        // Если осталось меньше-равно 7 дней - отображать дни и часы
        // Если осталось больше 7 дней - отображать дни

        // Когда, реально, скажем, осталось 22 дня и 2 часа - гугль на вопрос "Сколько осталось до ..." пишет не 22, а 23
        // Будем следовать методике расчета гугля - если осталось более 7 дней - пишем на 1 больше
        // Если осталось менее 7 целых дней - там уже начнут выводиться часы. При выводе часов не округляем количество дней в большую сторону
        if (restDays > 7) restDays++; 

        // Остаток выводить по отображаемому времени. Даже если реальное время 22:59:59 - то есть "1 час 0 минут [1 сек]" - 
        // на экране отображается 22:59 без секунд, а значит выводить "1 час 1 минута"
        if (!(restDays == 0 && restHours == 0 && restMinutes == 0) && restSeconds != 0) {
          restMinutes++;
          if (restMinutes == 60) { restMinutes = 0; restHours++;}
          if (restHours == 24) {restHours = 0; restDays++;}
        }
        
        String tmp;
        if (restDays == 0 && restHours == 0 && restMinutes == 0) { 
          tmp += restSeconds; tmp += WriteSeconds(restSeconds); 
        } else if (restDays == 0 && restHours == 0 && restMinutes > 0){ 
          tmp += restMinutes; tmp += WriteMinutes(restMinutes); 
        } else if (restDays == 0 && restHours > 0 && restMinutes > 0) { 
          tmp += restHours; tmp += WriteHours(restHours); tmp += ' '; tmp += restMinutes; tmp += WriteMinutes(restMinutes); 
        } else if (restDays == 0 && restHours > 0 && restMinutes == 0) { 
          tmp += restHours; tmp += WriteHours(restHours); 
        } else if (restDays > 0 && restDays <= 7 && restHours > 0) { 
          //  0..29 минут - прибавлять час, потом не надо
          // Чтобы в 22:10 посалось 'До Нового года 7 дней 2 часа', a в 22:40 - 'До Нового года 7 дней 1 час'
          if (restHours < 23 && restMinutes > 30) restHours++; 
          tmp += restDays; tmp += WriteDays(restDays); tmp += ' '; tmp += restHours; tmp += WriteHours(restHours); 
        } else { 
          tmp += restDays; tmp += WriteDays(restDays); 
        }
        textLine = textLine.substring(0, insertPoint) + tmp + textLine.substring(insertPoint);
      }
    }

    // "{P01.01.2021#N#B#A#F}" 
    // "{P7:00#N#B#A#F}" 
    // "{P7:00#N#B#A#F#T}" или  "{P7:00#N#B#A#F#t}"
    // "{P**.01.2021 7:00#N#B#A#F}" 
    idx = textLine.indexOf("{P");
    if (idx >= 0) {

      // Строка с событием непрерывной проверки - при старте программы и изменении текста строк и после завершения отображения очередной такой строки формируется массив ближайших событий
      // Массив содержит время наступления события, сколько до и сколько после отображать а так же - индексы отображаемых строк ДО и строки замены ПОСЛЕ события
      // Если данная строка вызвана для отображения - значит событие уже наступило (#B секунд перед событием - его нужно просто отобразить) 
      // Строка ПОСЛЕ события не может содержать макроса {P} и в этот блок просто не попадаем
      // Выкусываем макрос {P} без анализа и отображаем то что осталось с учетом замены макроса на остаток времени

      // Закрывающая скобка
      // Если ее нет - ошибка, ничего со строкой не делаем, отдаем как есть
      idx2 = textLine.indexOf("}", idx);        
      if (idx2 < 0) break;

      // удаляем макрос. Позиция idx - точка вставки текста остатка времени      
      textLine.remove(idx, idx2 - idx + 1);
      uint16_t insertPoint = idx;

      // Текущее активное событие - momentIdx, который указывает на элемент массива moments[]
      if (momentIdx >= 0 && !noCounterInText) {
        // Вычислить сколько до наступления события осталось времени. 
        // Время события - поле moment структуры Moment элемента массива
        // Данная строка, содержавшая макрос {P} - всегда ДО события, строка ПОСЛЕ события макроса {P} содержать не может и в этот блок не попадает
        time_t t_diff = moments[momentIdx].moment - *now(); // кол-во секунд до события
  
        // Пересчет секунд в дней до события / часов до события / минут до события
        uint16_t restDays = t_diff / SECS_PER_DAY;
        uint8_t restHours = (t_diff - (restDays * SECS_PER_DAY)) / SECS_PER_HOUR;
        uint8_t restMinutes = (t_diff - (restDays * SECS_PER_DAY) - (restHours * SECS_PER_HOUR)) / SECS_PER_MIN;
        uint8_t restSeconds = (t_diff - (restDays * SECS_PER_DAY) - (restHours * SECS_PER_HOUR) - (restMinutes * SECS_PER_MIN));
  
        // Если осталось меньше минуты - отображать секунды
        // Если осталось меньше часа - отображать только минуты
        // Если осталось несколько часов - отображать часы и минуты
        // Если осталось меньше-равно 7 дней - отображать дни и часы
        // Если осталось больше 7 дней - отображать дни
        
        // Когда, реально, скажем, осталось 22 дня и 2 часа - гугль на вопрос "Сколько осталось до ..." пишет не 22, а 23
        // Будем следовать методике расчета гугля - если осталось более 7 дней - пишем на 1 больше
        // Если осталось менее 7 целых дней - там уже начнут выводиться часы. При выводе часов не округляем количество дней в большую сторону
        if (restDays > 7) restDays++; 

        // Остаток выводить по отображаемому времени. Даже если реальное время 22:59:59 - то есть "1 час 0 минут [1 сек]" - 
        // на экране отображается 22:59 без секунд, а значит выводить "1 час 1 минута"
        if (!(restDays == 0 && restHours == 0 && restMinutes == 0) && restSeconds != 0) {
          restMinutes++;
          if (restMinutes == 60) { restMinutes = 0; restHours++;}
          if (restHours == 24) {restHours = 0; restDays++;}
        }
        
        String tmp;
        if (restDays == 0 && restHours == 0 && restMinutes == 0) { 
          tmp += restSeconds; tmp += WriteSeconds(restSeconds); 
        } else if (restDays == 0 && restHours == 0 && restMinutes > 0){ 
          tmp += restMinutes; tmp += WriteMinutes(restMinutes); 
        } else if (restDays == 0 && restHours > 0 && restMinutes > 0) { 
          tmp += restHours; tmp += WriteHours(restHours); tmp += ' '; tmp += restMinutes; tmp += WriteMinutes(restMinutes); 
        } else if (restDays == 0 && restHours > 0 && restMinutes == 0) { 
          tmp += restHours; tmp += WriteHours(restHours); 
        } else if (restDays > 0 && restDays <= 7 && restHours > 0) { 
          //  0..29 минут - прибавлять час, потом не надо
          // Чтобы в 22:10 посалось 'До Нового года 7 дней 2 часа', a в 22:40 - 'До Нового года 7 дней 1 час'
          if (restHours < 23 && restMinutes > 30) restHours++; 
          tmp += restDays; tmp += WriteDays(restDays); tmp += ' '; tmp += restHours; tmp += WriteHours(restHours); 
        } else { 
          tmp += restDays; tmp += WriteDays(restDays); 
        }
          
        String tl_str(textLine.substring(0, insertPoint)); tl_str += tmp; tl_str += textLine.substring(insertPoint);         
        textLine = tl_str;
      }
    }

    // "{S01.01.2020#01.01.2020#1234567}"
    // "{S01.01.2020 7:00#01.01.2020 19:00#12345}"
    // "{S01.01.**** 7:00#01.01.**** 19:00#67}"
    idx = textLine.indexOf("{S");
    if (idx >= 0) {
      // Строка с событием проверки текущей даты - выводится только при совпадении текущей даты с указанной (вычисленной по маске)
      // Проверка строки производится раньше при решении какую строку показывать в getNextLine(). Если сюда попали - значит строка 
      // пригодна к отображению в текущую дату - просто выкусить макрос

      // Закрывающая скобка
      // Если ее нет - ошибка, ничего со строкой не делаем, отдаем как есть
      idx2 = textLine.indexOf("}", idx);        
      if (idx2 < 0) break;

      // удаляем макрос;
      textLine.remove(idx, idx2 - idx + 1);
    }

    // Если в строке еще остались макросы, связанные со временем - обработать их
    if (textLine.indexOf("{D}") >= 0 || textLine.indexOf("{D:") >= 0 || textLine.indexOf("{R") >= 0 || textLine.indexOf("{P") >= 0 || textLine.indexOf("{S") >= 0) continue;

    break;
  }

  return textLine;
}

String substitureDateMacros(const String& txt) {  
  String str(txt);
  str.replace("DD", "~1~");
  str.replace("dd", "~2~");
  str.replace("D",  "~3~");
  str.replace("d",  "~4~");
  str.replace("MM", "~5~");
  str.replace("mm", "~6~");
  str.replace("M",  "~7~");
  str.replace("m",  "~8~");
  return str;
}

String unsubstitureDateMacros(const String& txt) {  
  String str(txt);
  str.replace("~1~", "DD");
  str.replace("~2~", "dd");
  str.replace("~3~", "D");
  str.replace("~4~", "d");
  str.replace("~5~", "MM");
  str.replace("~6~", "mm");
  str.replace("~7~", "M");
  str.replace("~8~", "m");
  return str;
}

// Обработать макросы цвета в строке, в случае если строка многоцветная
String processColorMacros(const String& txt) {

  String text(txt);
  
  // Обнулить массивы позиций цвета и самого цвета
  for (uint8_t i = 0; i < MAX_COLORS; i++) {
    textColorPos[i] = 0;
    textColor[i] = 0xFFFFFF;
  }

  // Если макрос цвета указан не с начала строки - начало строки отображать цветом globalTextColor
  uint16_t cnt = 0;
  int16_t idx, idx2;  

  idx = text.indexOf("{C");
  if (idx > 0) {
    textColorPos[cnt] = 0;
    textColor[cnt] = globalTextColor;   
    cnt++;
  }

  // Обработать все макросы цвета, входящие в строку
  while (idx >= 0) {
    // Закрывающая скобка
    // Если ее нет - ошибка, ничего со строкой не делаем, отдаем как есть
    idx2 = text.indexOf("}", idx);        
    if (idx2 < 0) break;

    // Извлечь цвет текста отображения этой бегущей строки
    String tmp;
    if (idx2 - idx > 1) {
      tmp = text.substring(idx+2, idx2);
    }
    
    // удаляем макрос
    text.remove(idx, idx2 - idx + 1);

    // Преобразовать строку цвета в число, сохранить позицию и цвет
    if (cnt < MAX_COLORS) {
      textColorPos[cnt] = idx;
      textColor[cnt] = (uint32_t)HEXtoInt(tmp);
      cnt++;
    }

    // Последний элемент массива - длина строки, чтобы все буквы до конца строки показывались правильным цветом
    textColorPos[cnt] = text.length();;
    textColor[cnt] = globalTextColor;
    
    // Есть еще вхождения макроса?
    idx = text.indexOf("{C");  
  }
  
  return text;
}

// Проверка содержит ли эта строка множественное задание цвета
bool checkIsTextMultiColor(const String& text) {

  // Строка не содержит макроса цвета
  int16_t idx = text.indexOf("{C"), idx_first = idx;
  if (idx < 0) {
    return false;
  }
  
  // Строка отображается одним (указанным) цветом, если цвет указан только один раз в самом начале или в самом конце строки
  // Если цвет в середине строки - значит начало строки отображается цветом globalTextColor, а с позиции макроса и до конца - указанным в макросе цветом
  uint16_t cnt = 0;
  while (idx >= 0 && cnt < 2) {
    cnt++;
    idx = text.indexOf("{C", idx + 1);  
  }

  if (cnt == 1 && (idx_first == 0 || idx_first == (int16_t)(text.length() - 10))) {  // text{C#0000FF} поз макр - 4, длина строки - 14, длина макроса - 10
    return false;
  }

  return true;  
}

// получить строку из массива строк текстов бегущей строки по индексу '0'..'9','A'..'Z'
int8_t getTextIndex(char c) {
  int8_t idx = -1;
  if (c >= '0' && c <= '9') 
    idx = (int8_t)(c - '0');
  else if (c >= 'A' && c <= 'Z') 
    idx = 10 + (int8_t)(c - 'A');        
  return (idx < 0 || idx >= TEXTS_MAX_COUNT) ? -1 : idx;
}

// получить строку из массива строк текстов бегущей строки по индексу '0'..'9','A'..'Z'
char getAZIndex(uint8_t idx) {
  char c = '-';
  if (idx <= 9)             
     c = char('0' + idx);
  else if (idx >= 10 && idx < TEXTS_MAX_COUNT)
     c = char('A' + idx - 10);
  return c;
}

// получить строку из массива строк текстов бегущей строки по индексу '0'..'9','A'..'Z'
String getTextByAZIndex(char c) {
  int8_t idx = getTextIndex(c);
  return (idx < 0 || idx >= TEXTS_MAX_COUNT) ? "" : getTextByIndex(idx);
}

String getTextByIndex(uint8_t idx) {
  if (idx >= TEXTS_MAX_COUNT) return "";

  // preparedTextIdx - индекс строки, которая находится в preparedText
  // Если запрошенная по индексу строка совпадает с загруженной - не читать с диска, а вернуть ранее загруженную
  if (preparedTextIdx == idx) return preparedText;

  // Если используется кэширование текстов бегущей строки - вернуть строку из кэша.
  // Если в кэше вместо строки - признак, что строку нужно брать из файла - '{^}' - загрузить строку из файла
  #if (USE_TEXT_CACHE == 1)
    if (textLines[idx] != "{^}") {
      preparedText = textLines[idx];
      preparedTextIdx = idx;      
      return preparedText;
    }
  #endif
  
  return loadTextByIndex(idx);
}

// получить строку из массива строк текстов бегущей строки по индексу 0..35
String loadTextByIndex(uint8_t idx) {
  if (idx >= TEXTS_MAX_COUNT) return "";
  
  // Загрузить текст из файловой стистемы микроконтроллера
  char c = getAZIndex(idx);
  
  String directoryName(FS_TEXT_STORAGE);    
  String fileName(directoryName); fileName += '/'; fileName += c;  
  String text;

  
  if (LittleFS.exists(fileName)) {
    
    File file = LittleFS.open(fileName, "r");
    if (file) {
      // считываем содержимое файла
      char* buf = (char*)malloc(1024);
      memset(buf, '\0', 1024); 
      size_t len = file.read((uint8_t*)buf, 1024);
      file.close();
      if (len > 0) {
        text = String(buf);
        preparedText = text;
        preparedTextIdx = idx;
      }
      free(buf); 
    } else {
      DEBUG(F("Ошибка чтения строки с индексом '")); DEBUG(c); DEBUGLN('\'');    
    }    
  }
  return text;
}

void saveTextLine(char index, const String& text) {

  // Если используется кэш бегущей строки...
  #if (USE_TEXT_CACHE == 1)
    int8_t idx = getTextIndex(index); 
    // ... если длина текста меньше указанной предельной длины - сохранить ее в кэше, если больше - в кэш положить признак "брать строку из файла"
    if (idx >= 0 && idx < TEXTS_MAX_COUNT) {
      textLines[idx] = text.length() <= TEXT_CACHE_LINE_SIZE ? String(text) : "{^}";
    }
  #endif
  
  String directoryName(FS_TEXT_STORAGE);

  if (!LittleFS.exists(directoryName)) {
    int8_t num = CountTokens(directoryName, '/');
    String path; path.reserve(directoryName.length());
    
    for (int8_t i = 1; i <= num; i++) {
      path += GetToken(directoryName, i, '/');
      if (path.length() != 0) {
        if (!LittleFS.exists(path)) {
          if (!LittleFS.mkdir(path)) {
            DEBUG(FPSTR(MSG_FOLDER_CREATE_ERROR)); DEBUG(F(" '")); DEBUG(path); DEBUGLN('\'');
            return;
          }
        }
      }
      path += '/';
    }    
  }

  bool ok = true;  
  String fileName(directoryName); fileName += '/'; fileName += index;

  File file;
  if (LittleFS.exists(fileName)) {
    ok = LittleFS.remove(fileName);
  }
  
  if (ok) {
    file = LittleFS.open(fileName, "w");
    if (file) {
      size_t len = text.length()+1, lenw = 0;
      if (len > 1024) len = 1024;
      char buf[1024];
      memset(buf, '\0', 1024);
      text.toCharArray(buf, len);
      lenw = file.write((uint8_t*)buf, len);
      ok = lenw == len;       
      file.close();
    } else {
      ok = false;
    }
  }
  
  if (!ok) {
    DEBUG(F("Ошибка сохранения строки с индексом '")); DEBUG(index); DEBUGLN('\'');
  } 
}
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
