vvip-68/LedPanelWiFi/firmware/LedPanelWiFi_v1.14/eeprom.ino

// *************************************************************************

#define EEPROM_MAX    1536                  // Максимальный размер EEPROM доступный для использования (4096)
#define EFFECT_EEPROM  800                  // Начальная ячейка eeprom с параметрами эффектов, 10 байт на эффект

// *************************************************************************

void initializeEEPROM() {

  // Инициализация EEPROM? подготовка к работе
  
  EEPROM.begin(EEPROM_MAX);
  delay(100);

  eeprom_id = EEPROMread(0);
  isEEPROMInitialized =  eeprom_id == EEPROM_OK;
  
  if (!isEEPROMInitialized) {
    clearEEPROM();
    vDEBUG_SERIAL = DEBUG_SERIAL;
  } else {
    vDEBUG_SERIAL = getDebugSerialEnable();  
  }

}

void loadSettings() {

  // Адреса в EEPROM:
  //    0 - если EEPROM_OK - EEPROM инициализировано, если другое значение - нет                             // EEPROMread(0)                 // EEPROMWrite(0, EEPROM_OK)
  //    1 - максимальная яркость ленты 1-255                                                                 // getMaxBrightness()            // putMaxBrightness(deviceBrightness)
  //    2 - автосмена режима в демо: вкл/выкл                                                                // getAutoplay();                // putAutoplay(manualMode)
  //    3 - время автосмены режимов в сек                                                                    // getAutoplayTime()             // putAutoplayTime(autoplayTime / 1000L)     // autoplayTime - мс; в ячейке - в сек
  //    4 - время бездействия до переключения в авторежим в минутах                                          // getIdleTime()                 // putIdleTime(idleTime / 60L / 1000L)       // idleTime - мс; в ячейке - в мин
  //    5 - использовать синхронизацию времени через NTP                                                     // getUseNtp()                   // putUseNtp(useNtp)
  //    6 - 12/24-часовой формат времени                                                                     // getTime12()                   // putTime12(time_h12) 
  //    7 - градусы Сельсия / Фаренгейта                                                                     // getIsFarenheit()              // putIsFarengeit(isFarenheit)
  //    8 - шрифт 3х5 - 0 - квадратный, 1 - круглый                                                          // getSmallFontType()            // putSmallFontType(use_round_3x5)
  //    9 - выключать индикатор часов при выключении лампы true - выключать / false - не выключать           // getTurnOffClockOnLampOff()    // putTurnOffClockOnLampOff(needTurnOffClock)
  //   10 - IP[0]                                                                                            // getStaticIP()                 // putStaticIP(IP_STA[0], IP_STA[1], IP_STA[2], IP_STA[3])
  //   11 - IP[1]                                                                                            // - " -                         // - " -
  //   12 - IP[2]                                                                                            // - " -                         // - " -
  //   13 - IP[3]                                                                                            // - " -                         // - " -
  //   14 - Использовать режим точки доступа                                                                 // getUseSoftAP()                // putUseSoftAP(useSoftAP)
  //   15 - ориентация часов горизонтально / вертикально                                                     // getClockOrientation()         // putClockOrientation(CLOCK_ORIENT)
  // **16 - не используется
  //   17 - Интервал отображения часов фазы T1/T3                                                            // getClockCycleT1()             // putClockCycleT1(clock_cycle_T1)
  //   18 - Интервал отображения часов фазы T2/T4                                                            // getpClockCycleT2()            // putClockCycleT2(clock_cycle_T2)
  //   19 - тип часов горизонтальной ориентации 0-авто 1-малые 3х5 2 - большие 5х7                           // getClockSize()                // putClockSize(CLOCK_SIZE)
  //   20 - Будильник, дни недели                                                                            // getAlarmWeekDay()             // putAlarmParams(alarmWeekDay, dawnDuration, alarmEffect, alarmDuration)
  //   21 - Будильник, продолжительность "рассвета"                                                          // getDawnDuration()             // putAlarmParams(alarmWeekDay, dawnDuration, alarmEffect, alarmDuration)
  //   22 - Будильник, эффект "рассвета"                                                                     // getAlarmEffect()              // putAlarmParams(alarmWeekDay, dawnDuration, alarmEffect, alarmDuration)
  //   23 - Будильник, использовать звук                                                                     // getUseAlarmSound()            // putAlarmSounds(useAlarmSound, maxAlarmVolume, alarmSound, dawnSound)
  //   24 - Будильник, играть звук N минут после срабатывания                                                // getAlarmDuration()            // putAlarmParams(alarmWeekDay, dawnDuration, alarmEffect, alarmDuration)
  //   25 - Будильник, Номер мелодии будильника (из папки 01 на SD карте)                                    // getAlarmSound()               // putAlarmSounds(useAlarmSound, maxAlarmVolume, alarmSound, dawnSound)
  //   26 - Будильник, Номер мелодии рассвета (из папки 02 на SD карте)                                      // getDawnSound()                // putAlarmSounds(useAlarmSound, maxAlarmVolume, alarmSound, dawnSound)
  //   27 - Будильник, Максимальная громкость будильника                                                     // getMaxAlarmVolume()           // putAlarmSounds(useAlarmSound, maxAlarmVolume, alarmSound, dawnSound)
  //   28 - Номер последнего активного спец-режима или -1, если были включены обычные эффекты                // getCurrentSpecMode()          // putCurrentSpecMode(xxx)                     
  //   29 - Номер последнего активированного вручную режима                                                  // getCurrentManualMode()        // putCurrentManualMode(xxx)
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
