vvip-68/LedPanelWiFi/(commit log)

2023-04-14 Начальная загрузка - скетч и библиотеки
2023-04-14 Начальная загрузка - вариант печатной платы
2023-04-14 Начальная загрузка - PixelArt 16x16 - примеры
2023-04-14 Начальная загрузка - схемы вариантов подключения
2023-04-14 Начальная загрузка - папки со ссылками на звуковые файлы
2023-04-14 Начальная загрузка - stl-файлы печати решетки 16x16 (сегменты, наборная)
    [matrix-1-side.stl, matrix-2-sides.stl, matrix-3-sides.stl, matrix-angle.stl, matrix-full.stl]
2023-04-14 Начальная загрузка - утилиты
    [pattern-creator.xlsx]
2023-04-14 Начальная загрузка - исходники Web-приложения
2023-04-14 Начальная загрузка - wiki - схемы
2023-04-14 Начальная загрузка - wiki - сборная матрица, сегменты одного размера
2023-04-14 Начальная загрузка - wiki - сборная матрица, сегменты разного типа и размера
2023-04-14 Начальная загрузка - wiki - всё собрал - ничего не работает
2023-04-14 Начальная загрузка - wiki - утилита JinxFramer
2023-04-14 Начальная загрузка - wiki - загрузка данных a вайловую систему МК
2023-04-14 Начальная загрузка - wiki - экспорт эффектов анимации из Jinx
2023-04-14 Начальная загрузка - wiki - захват видео с помощью Jinx
2023-04-14 Начальная загрузка - wiki - большие буквы в бегущей строке
2023-04-14 Начальная загрузка - wiki - использование портов МК
2023-04-14 Начальная загрузка - wiki - синхронизация, групповые режимы
2023-04-14 Начальная загрузка - wiki - внешняя синхронизация из Jinx!
2023-04-14 Начальная загрузка - wiki - FAQ
2023-04-14 Начальная загрузка - wiki - API, настройки бегущей строки - иакросы
2023-04-14 Начальная загрузка - wiki - настройка погоды
    [towns.xlsx]
2023-04-14 Начальная загрузка - wiki - настройка среды разработки
2023-04-15 Начальная загрузка - wiki - настройка параметров приложения в скетче
2023-04-15 Начальная загрузка - wiki - настройка параметров в Web-приложении
2023-04-16 Начальная загрузка - wiki - управление устройством в Web-приложении
2023-04-16 Начальная загрузка - wiki - обновление прошивки OTA
2023-04-16 Начальная загрузка - wiki - язык интерфейса
2023-04-16 Начальная загрузка - wiki - подготовка звуковых файлов
2023-04-16 Исправление в настройке типа матрицы - зигзаг / параллельная
    [LedPanelWiFi_v1.14.ino, sdcard.ino]
2023-04-17 Начальная загрузка - wiki - игры
2023-04-17 Начальная загрузка - wiki - рисование
2023-04-17 Исправление на схеме, в файле имени сохраняемой картинки разрешено подчеркивание
2023-04-17 Web-интерфейс, исправлены мелкие ошибки
2023-04-18 Web-интерфейс: - уменьшен масштаб отображения страницы после загрузки - не на всех телефонах влазил по шириине, добавлен заголовок "брать из кэша", чтобы не грузить MK постоянной пересылкой одних и т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
    В библиотеке ESPAsyncWebServer убрано добавление заголовка addHeader("Content-Disposition", "inline, filename=...")? n/r вероятно этот заголовок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
2023-04-19 Удалены "лишние" демонстранционные файлы роликов эффекта "SD-карта" из папки data/16x16 из за которых при загрузке файловой системы с параметрами по умолчанию на ESP32 аозникала ошибка "недостаточно 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
2023-04-20 Параметры эффекта - часы поверх эффекта не включались обратно Web-интерфейс - начальный масштаб отображения на телевоне изменен с 0.75 до 0ю825
2023-04-20 Исправлена пауза (замирание эффектов) перед показом очередной бегущей строки
    [a_def_soft.h, a_main.ino, runningText.ino]
2023-04-21 ESP32 - в скетче пин вывода на ленту переназначен с G2 на G13 чтобы соответствовало картинкам схем для ESP32
2023-04-21 Разрешена бегущая чтрока поверх эффекта "Часы". Часы на время бегущей строки не показываются
2023-04-22 Настройка чипа ленты (WS2812, WS2813 и т.д) + Код порядка цвета (GRB, GBR) перенесен в настройки hardware - a_def_hard.h)
    Web-интерфейс - исправлено - в часах показывался блок настроек, связанный с температурой при отключенной погоде USE_WEATHER
    [LedPanelWiFi_v1.14.ino, a_def_hard.h, a_def_lang.h, a_def_soft.h, utility.ino, weather.ino]
2023-04-22 Исправление в файлах шаблонов
2023-04-22 Еще доступность части настроек погоды в зависимости от того разрешена эта фича в параметрах скетча или нет
2023-04-23 Настройка параметров некоторых эффектов
2023-04-24 Добавлена поддержка букв испанского алфавита Á, É, Í, Ó, Ú, Ü, Ñ, á, é, í, ó, ú, ü, ñ
2023-04-24 wiki - поддержка букв иностранного алфавита
2023-04-29 Поддержка распределённых матриц
2023-04-29 Wiki - распределенная матрица
2023-04-29 Смена версии - WiFiPanel v.1.14.2023.0429
2023-04-29 wiki - исправлена картинка
2023-04-30 Исправлена ошибка компиляции при отключенной поддержке E131
    [LedPanelWiFi_v1.14.ino, eeprom.ino]
2023-05-04 Коррекция текстов в wiki
2023-05-05 Техническое. Обновление версий библиотек. Совместимость с версиями ядра ESP8266 v3.1.2 и ESP32 v2.0.9; Длбавлен параметр настройки отключения кнопки из скетча - USE_BUTTON 0 Обновлены файлы wiki для 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
2023-05-14 Убрана поддержка MQTT; Добавлен Web-конфигуратор подключения устройств к пинам микроконтроллера
2023-05-14 Проверка количества диодов в сегменте - проверка на выход за общее количество диодов в матрице
2023-05-14 Возврат к версии ядра 1.0.6 для ESP32
2023-05-14 Корректировка файлов wiki
2023-05-14 Откат версии библиотеки ArduinoJson с последней 6.21.5 на предыдущую стабильную 6.18.5
2023-05-15 Комментарий по выбору варианта распределения Flas-памяти микроконтроллера
2023-05-15 Рекомендации по увеличению размера стека, если прошивка крашится с сообщением stack overflow или Heap corrupted
2023-05-17 Исправлена проверка на вкладке "Оборудование" - включена ли в прошивке поддкржка DFPlayer. Раньше определялось не по включению поддержки, а по подключенности. В результате, если поддержка включена, п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
    [LedPanelWiFi_v1.14.ino, a_main.ino, utility.ino]
2023-05-19 Добавлены символы испанского алфавита ¿¡
2023-05-20 Техническое. Проверка на падения
2023-05-21 Пересмотрена концепуия выделения памяти под шумовые эффекты
2023-05-21 Техническое...
2023-05-21 Исправлен эффект "Кубик Рубика" - на матрицах больших размеров происходило переполнение массива координат "плашек", которых было изначально до 255 штук. При больштх размерах матриц плашек было больше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
    [effects.ino]
2023-05-21 Техническое, исправление опечаток
2023-05-22 Оптимизация выделения памяти для эффектов
2023-05-23 Для матриц с размером более 2040 диодов запрещена работа в режиме синхронизации Мастер
2023-05-24 Устранена причина подергивания эффектов и бегущей строки
2023-05-24 Размер текста бегущей строки увеличен до 1024
2023-05-25 Режим Лампа - после выключения кнопкой и последующего включения кнопкой не включался
2023-05-25 Техническое
2023-05-31 Исправление отображения времени - смещение с 21:00 до 22:00 на часах шириной 15
    [clock.ino]
2023-06-01 Исправлено падение строки с макросом {S} в конце
    [LedPanelWiFi_v1.14.ino, runningText.ino]
2023-06-01 Исправлено - включение устройства, если оно было выключено при показе бегущей строки с алресом устройства после 4-хкратного нажатия на кнопку
    [a_main.ino]
2023-06-01 Изменена логика обработки нажатий кнопки
2023-06-01 Устранен flicker при переключении с кнопки в режим ночных часов
2023-07-17 Добавлен язык интерфейса - Испанский
2023-07-17 Испанский - исправлены ошибки в текстовых строках языка
    [a_def_lang.h]
2023-11-05 Исправление - смещение движущихся часов / появление не с краю панели, а стазу несколько цифр, ближе к середине.
    [a_def_soft.h, clock.ino, custom.ino]
2023-11-08 Исправлено - при наличии индикатора TM1637 для некоторых размеров матриц, сразу после включения устройство индикатор отображал не текущее время, а "застывший" уровень текущей яркости, навроде 'br37'
    [LedPanelWiFi_v1.14.ino, a_main.ino]
2023-11-08 add profile to build project with platformio
    esp32 env only
    [esp32_4MiB.csv]
2023-11-13 Backup - сохранение текстов бегущей строки
2023-12-01 Техническое. Попытка оптимизировать работу с памятью.
2023-12-01 Поддержка FastLED 3.6; В libraries - обновление FastLED до 3.6
2023-12-01 Вывод в лог используемой версии FastLED при старте скетча
2023-12-03 Web-UI: исправлен css-стили TimePicker`а - выбор времени будильника и режимов по расписанию
    [LedPanelWiFi_v1.14.ino, e131.ino, utility.ino]
2023-12-05 Исправлена ошибка выхода за границы массива, что приводило к порче некоторых данных
    [LedPanelWiFi_v1.14.ino, a_main.ino, eeprom.ino]
2023-12-06 Некоторые исправления ошибок от vortigont + ESPAcyncWebServer с исправлениями от него же
    [LedPanelWiFi_v1.14.ino, eeprom.ino, pictures.ino]
2023-12-06 JinxFramer с поддержкой карт индексов
2023-12-09 Исправлен / доработан макрос {P} бегущей строки. Добавлен флаг обратного отсчета до события.
    [LedPanelWiFi_v1.14.ino, a_def_soft.h, clock.ino, custom.ino, runningText.ino]
2023-12-09 Исправлен подсчет времени до события в макросе {R}
    [a_def_soft.h, a_main.ino, runningText.ino]
2023-12-09 функция отправки джейсон объектов в сокет без промежуточного буфера
2023-12-09 удален дублирующий код отдачи статических файлов вебсервером
    сервер сам может отдавать статику с ФС, используем заголовки кеширования и ревалидации
2023-12-09 bump arduino core to 2.0.6
2023-12-09 bump platformio's esp platform to latest rel
    [esp32_4MiB_noota.csv]
2023-12-10 Подгонка оптимизации оn vortigont
2023-12-10 Исправлено: при работе в режиме синхронизации изменение текущей яркости мастера передается ведомым устройствам группы
    [a_main.ino, custom.ino, e131.ino, effects.ino, g_snake.ino, setters.ino]
2023-12-10 WebUI - добавлена индикация режима групповой синхронизации MASTER/SLAVE, если групповая синхронизация включена на устройстве
2023-12-11 Вариант макроса {P} бегущей строки
2023-12-11 Wiki - изменено описание макроса {P} бегущей строки
2023-12-11 Web-UI - исправлено - подложка выпадающего меню - Тексты, выбор эффекта фона
2023-12-12 WebUI: изменен алгоритм доступности кнопок в зависимости от вкл/выкл, есть ли соединение, идет ли прием вещания
2023-12-14 Добавлено управление реле дополнительных линий - по будильнику и для режимов по времени
2023-12-14 Fix: расчет ввремени следующего рассвета
    [a_main.ino, clock.ino]
2023-12-14 профиль сборки платформио под 8266
2023-12-14 Можно задавать отображаемое имя системы
2023-12-15 fix bracket in dflib json
2023-12-15 Исправление ошибок Web-UI после добавления новых возможностей
    [LedPanelWiFi_v1.14.ino, a_def_soft.h, a_main.ino, e131.ino, setters.ino]
2023-12-15 Разделение флага включения дополнительной линии - локальное или со стороны мастера вещания
2023-12-16 wiki - внесены изменения в соответствии с изменениями в проекте
2023-12-16 Орфография
2023-12-16 Исправлено - WebUI - на светлом фоне на некоторых кнопках не видно надписей Вещание в группу мастером - ограничена скорость отправки "экрана" в сеть во избежание зафлуживания сети пакетами
    [a_main.ino, e131.ino, weather.ino]
2023-12-16 Поправлена длина очереди для экономии памяти
2023-12-16 Добавлен скриншот настроек в меню "Инструменты" для Wemos и комментарии к настройкам в файле LedPanelWiFi_v1.14.ino
2023-12-16 Исправлено - компиляция при USE_E131 0
    [a_main.ino]
2023-12-17 Код почищен (в плане предупреждений компилятора) + починена сборка для esp32 типов S2,S3,C3
2023-12-18 Оптимизация вывода на TM1637 дисплей, чтобы не тормозило эффекты
2023-12-18 Один из текстов бегущей строки - updated
2024-01-17 Рабочий плагин для файловой системы S2/S3; Переделан формат Backup (несовместим с прежим)
2024-01-18 Переделан формат Backup (несовместим с прежим)
2024-01-18 Комментарии к коду
2024-01-19 ИсправленоЖ при первом редактировании ранее пустых строк, строка с первого раза не сохранялась
2024-01-20 Некоторые оптимизации. Техническое.
2024-01-20 Кэширование текстов бегущей строки в оперативной памяти
2024-01-20 Изменения, которые должны в Safary на Apple указать, что тексты бегущей строки не нужно грузить из кэша браузера
2024-01-21 Исправлено неверная раскраска строки с сколькими макросами установки цвета, при наличии в этой строке макросов даты и/или погоды
    [a_def_soft.h, a_main.ino, custom.ino, effects.ino, runningText.ino]
2024-01-21 Исправлено - указанный макрос фоновый эффект бегущей строки не подхватывался поосле редактирования
    [runningText.ino]
2024-01-21 Знак температуры °F/°C внесен внутрь макроса {WT} - теперь его не нужно писать отдельно, F/C показывается в зависимости от настроек автоматически, при выделении температуры цветом выделяется только о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
2024-01-26 Настройка цветового порядка - в отдельности для каждой линии подключения
2024-01-26 В макрос бегущей строки {S} добавлен параметр - дни недели
2024-01-27 WebUI - изменены названия параметров эффектов и подсказки к нимж Эффект "Шарики" - регулировка длины хвоста, переименован в "Червячки"
2024-02-11 Переработан алгоритм отображения часов / температуры / календаря
2024-02-11 Починены макросы бегущей строки {E} - не применялись параметры фонового эффекта бегущей строки и макроса {A} / {A+} - звук проигрывался со второго раза, не было повтора
2024-02-14 Эффекты "Тени-2", "Поток", "Фейерверк"
2024-02-15 Эффекты "Полосы", "Поток", "Фейерверк"
2024-02-15 Комментарий / инструкция от mikewap83 - как изменить разбиение файловой системы (partitions) для увеличение размера разделов под OTA и скетч за счет уменьшения места под раздел data (SPIFFS)
2024-02-15 "Полосы" - исправлен глюк при крайних правых положениях ползунка "Изменчивость". "Фейерверк" - увеличено макс. значение параметра "Затухание"
    [effects2.ino]
2024-10-24 Обновление некоторых библиотек
2024-10-24 Погода - ESP8266 - по HTTP, ESP32 - по HTTPS
2024-10-25 Починена погода от Yandex
2024-10-25 Обновление до работающей версии с исправленной погодой
    [LedPanelWiFi_v1.14.ino, a_def_hard.h, a_def_lang.h, a_def_soft.h, a_main.ino]
2024-10-25 Исправлено: настройки времени из веб-тинтерфейса не применялисб после перезагрузки контроллера.
    [LedPanelWiFi_v1.14.ino]
2024-10-25 Корректировка статей Wiki
2024-10-25 Обновлен плагин загрузки данных в ФС микроконтроллера для Arduino IDE 2.3.x
2024-10-26 Комментарий
2024-10-26 WebUI - Сеть - ввод пароля сети - расширен набор дозволенных спецсимволов, плюс пробел
2024-10-28 Поправил версию
2024-10-31 После ключения в WrvUI неправильно отображалось значение яркости
2024-11-01 Скорость прокрутки часов - минимальное значение снижено до 1 сдвиг/ сек
2024-11-01 Исправлено - на малой высоте матрицы (до 11) календарь в часах отображался год поверх даты - была мешанина
    [clock.ino]
2024-11-01 Вариант шрифта часов 5x7 от Вадим Журавель
2024-11-02 Режим ночной бегущей строки
2024-11-02 Версия
2024-11-02 Исправлены ошибки компиляции SEP32 при включенном режиме строгой проверки
    [custom.ino, weather.ino]
2024-11-03 Исправления, чтобы не ругался компилятор при включенном строгом режиме
    [LedPanelWiFi_v1.14.ino]
2024-11-04 Добавлена online-справка для включения режима ночной бегущей строки
2024-11-04 Рисование - занрузка списка картинок в UI
2024-11-04 Исправлено некоторое задваивание столбцов (букв) при выводе бегущей строки на однотонном/черном фоне
    [custom.ino]
2024-11-05 Латышский язык в бегущей строке (поддержка букв латышского языка)
2024-11-06 Добавлен латышский язык
2024-11-21 Исправлено получение IP-адреса по DHCP
    [LedPanelWiFi_v1.14.ino]
2024-11-25 Исправлено - если установлен таймер включения авторежима отличный от 0 - устройство включалось даже из состояния "выключено"
    [custom.ino]
2024-12-06 Поддержка DHCP в Web-интерфейсе Макрос {WT} - настройка вывода значка градуса и буквы C/F Сдвиг часов, настройка ширины разделительных точек в больших часах
2024-12-06 Исправлен комментарий к прошивке
    [LedPanelWiFi_v1.14.ino]
2024-12-07 При переходе на страничку настроек часов сбрасывались настройки смещения
2024-12-09 Совместимость проекта с FastLED 3.9.4 и ядром ESP32 v3.0.7
2024-12-10 Разделение библиотек для ESP32 v3.0.7 / FastLED 3.9.4 и ESP8266 v3.1.2 ESP32 v2.0.17 / FastLED 3.7.0
2024-12-11 Второй пинок подряд для вывода на матрицу для ESP8266 (устранение мерцания первого светодиода вместо вывода на матрицу).
2024-12-17 Техническое - комментарии, орфография, грамматика
2024-12-19 Исправлена ошибка компиляции при USE_WEATHER = 0
    [LedPanelWiFi_v1.14.ino, a_main.ino]
2024-12-23 Рисование - вместо рисования точками можно вести линию пальцем / мышкой Имена файлов - меньше 32 символов для совместимости со SPIFFS
2024-12-25 Починил макрос {#N} в бегущей строке
2024-12-26 Импорт/экспорт текстовых строк
2024-12-27 Исправлено рисование на iPhone
    [LedPanelWiFi_v1.14.ino]
2025-01-07 1. WebUI - добавлена возможность инверсии кнопок Право/Лево в Играх 2. Исправлено - эффект SD-арта переносился в отключенные, если соьрано с опцией USE_ANIMATIOM 0 3. WebUI - исправлена работа с SEP3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
    Переработан механизм позиционироввания часов / температуры / календаря / бегущей строки на поле матрицы
    [LedPanelWiFi_v1.14.ino, a_def_hard.h, a_def_lang.h, a_def_soft.h, a_main.ino, clock.ino, custom.ino, eeprom.ino]
2025-01-17 При вклеченном авторежиме чеорез N minen после включения ночных часов по расписанию устройство включалось в деморежим через N минут
2025-01-19 Исправлена ошибка компиляции при USE_WEATHER 0
    [LedPanelWiFi_v1.14.ino, custom.ino]
2025-02-02 Календарь в малых часах - вместо двойной разделительной точки - одинарная
2025-02-04 Исправлено - движущиеся часы в режиме температуры за часами.
    [LedPanelWiFi_v1.14.ino, a_def_soft.h, custom.ino]
2025-02-11 Исправлено - в часах температура отображалась даже когда выключена или не полученв. Добавлено - включение спец-режима "Часы" с кнопки.
    [LedPanelWiFi_v1.14.ino, a_main.ino, clock.ino, custom.ino]
2025-03-11 Добавлена поддержка польского языка (предварительная версия)
2025-03-12 Исправления в польском языке от носителя языка
    [a_def_lang.h]
2025-03-12 Смена версии
2025-03-13 Шрифт 5x8 для букв gjy - смещение на пиксель вниз
2025-03-25 Исправления втекстах для польского языка
    [a_def_lang.h]
2025-12-10 Исправление небольших ошибок, замеченных пользователями в коде. Нового функционала не появилось.
    [LedPanelWiFi_v1.14.ino, sdcard.ino, timeProcessor.cpp, timeProcessor.h]
